mp911de/airgrep/README.md

# airgrep

A portable ADS-B / FLARM receiver. Started as carrier board for a removable ESP32-S3 touch display and ADSBee 1090U receiver, with a soldered MAX-M10S GNSS receiver. It adds a single-cell Li-ion charger, a 5 V boost rail, a fuel gauge, a barometer and a buzzer.

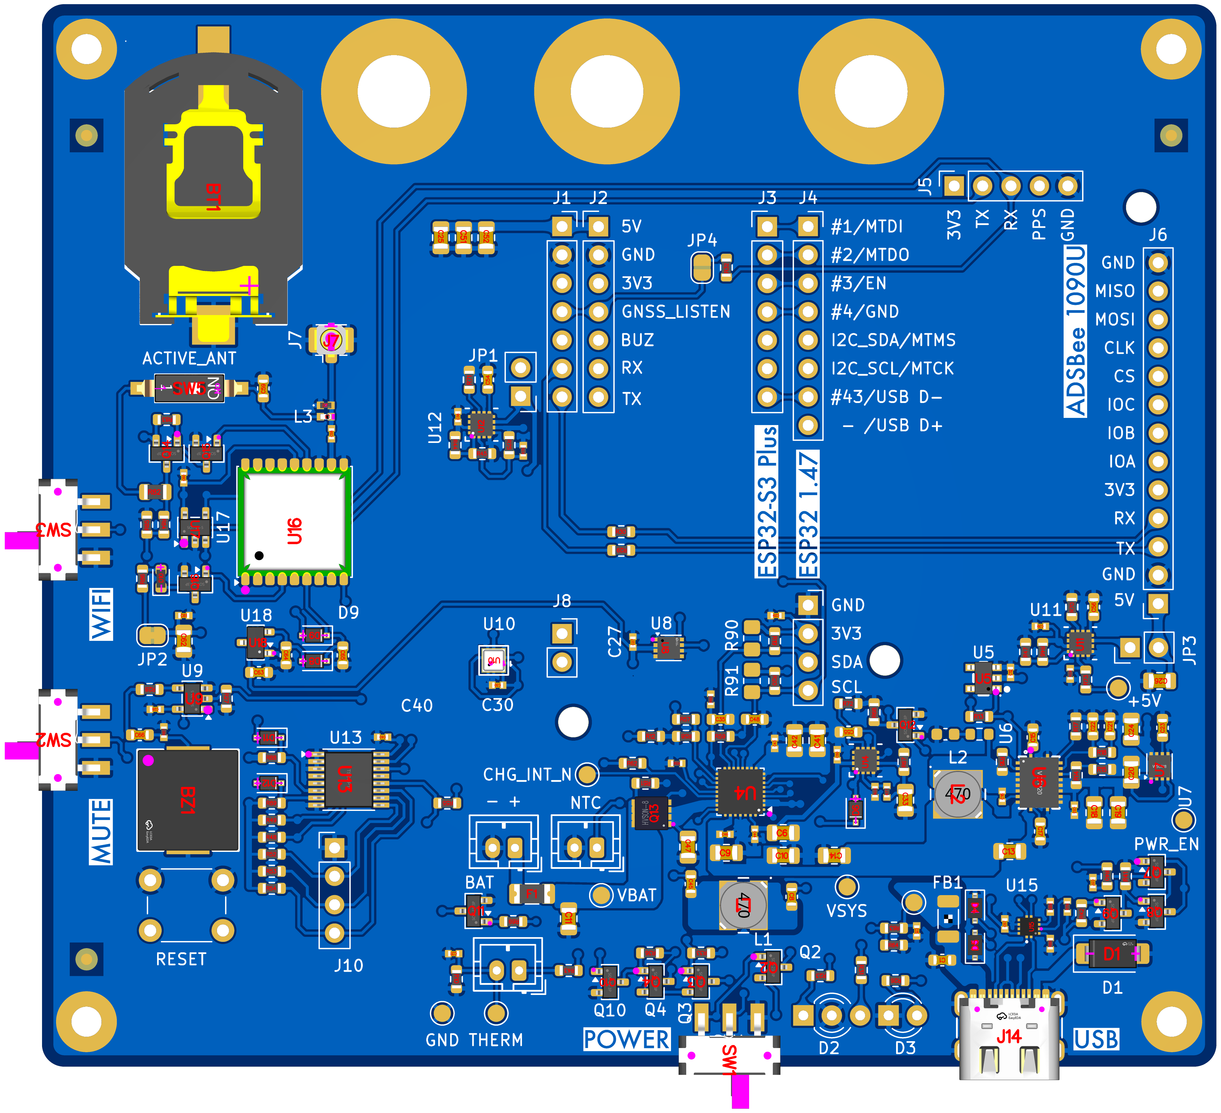
[picture p1: hardware/carrier-ti-charger/render/PCBA Render F.png]
PCBA Render


## Current state

- Schematic (7 sheets) and board (105 x 95 mm, 4 layers, all SMD parts on top) are implemented. The active TI PCB and schematics define the hardware; `tools/check.sh` reports the ERC, DRC and parity state.
- Order status and open work are in [docs/open-issues.md](docs/open-issues.md).

## Where things are

| Path | Content |
|---|---|
| [docs/requirements.md](docs/requirements.md) | What the device must do. Read first. |
| [docs/checklist-draft.md](docs/checklist-draft.md) | Draft hardware review checks, investigation guidance and trial evaluation |
| [docs/specs.md](docs/specs.md) | Technical data: radio, charging, battery, power budget, runtimes and validation limits |
| [docs/decisions.md](docs/decisions.md) | Reasons behind the design decisions |
| [docs/mechanical.md](docs/mechanical.md) | Board outline, mounting holes, module placement, battery, antennas, enclosure |
| [docs/interfaces.md](docs/interfaces.md) | Pin maps of the modules and the carrier connectors |
| [docs/i2c-bus-requirements.md](docs/i2c-bus-requirements.md) | I2C speed, bandwidth, capacitance and pull-up limits |
| [docs/firmware.md](docs/firmware.md) | What the display firmware must do: operating modes, charger host control, charger-mode display, sleep |
| [docs/bom-hand-sourced.md](docs/bom-hand-sourced.md) | Parts to buy and fit by hand, with order links and order status |
| [docs/open-issues.md](docs/open-issues.md) | Open work only |
| [issues/](issues/) | Local issue tracker, one markdown file per issue |
| `specs/power_params.json`, `tools/power_budget.py` | Power model inputs and the script that generates the power, runtime and charging tables in `docs/specs.md` |
| `hardware/carrier-ti-charger/` | Active KiCad 10 project `carrier.kicad_pro`, BQ25798 charger. `lib/` holds symbols, footprints and 3D models, `carrier-schematic.pdf` is the schematic print, `jlcpcb/` holds the production exports. |
| `hardware/carrier-max-charger/` | Frozen MAX77757 reference, no further development. Legacy tools and results remain available with `--project NAME`. |
| `hardware/insulator/` | KiCad project of the insulator board between carrier and battery, generated by `tools/make_insulator.py` |
| `hardware/sim/` | Verification by simulation, see [hardware/sim/README.md](hardware/sim/README.md): charge cut-off (`run_thermal.py`), converters and undervoltage latch (`run_power.py`), board heat (`run_heat.py`), emissions and receiver desense (`run_emi.py`), enclosure vents (`vent_model.py`). Active results use the `ti` suffix or `heat/ti/`; MAX results are historical. |
| `mechanical/` | Placement drawing (`placement.png`, `placement.svg`, generator `draw_placement.py`) and extracted module geometry (JSON) |
| `datasheets/` | Data sheets of the parts in use, see [datasheets/README.md](datasheets/README.md) |
| `sources/` | Manufacturer CAD: display KiCad project (`display.zip`), GNSS and gauge Eagle files, ADSBee reference image and schematic text |
| `tools/` | Scripts: design check (`check.sh`), board queries (`board.py`), net-coloured copper maps (`netmap.py`), power budget, CPL correction for JLCPCB (`fix_cpl.py`), insulator generator |

## Tools

- KiCad 10.0.6, including `kicad-cli` and its bundled Python for the scripts that use `pcbnew`. `tools/kpy` runs that Python.
- Python 3.14; the simulation packages are listed in `hardware/sim/requirements.txt`
- ngspice 47 (Homebrew) for `hardware/sim/`
- `python3 tools/report-holes-vias.py path/to/board.kicad_pcb` reports via copper/drill sizes, minimum nominal annular rings, plated and non-plated footprint drills, slots, counts and nets in mil. Edge.Cuts cutouts are excluded.
- `python3 tools/report-traces.py path/to/board.kicad_pcb` reports straight and arc track widths by layer, with counts and nets in mil. Both reports are read-only, sorted by size, and automatically use `tools/kpy` when needed.
