mp911de/airgrep/datasheets/README.md

# Data sheets

Data sheets for the parts on the carrier and the parts fitted to it by hand. Coverage is not complete; the gaps are listed below. [manifest.json](manifest.json) records source URLs and, where taken, page counts and SHA-256 hashes. Every PDF has a searchable text extraction in [pdf2text/](pdf2text/) under the PDF's name.

| PDF | Part | Source | Host |
|---|---|---|---|
| [max77757.pdf](max77757.pdf) | U4 charger of carrier-max-charger, Rev 2 | [Original](https://www.analog.com/media/en/technical-documentation/data-sheets/MAX77757.pdf) | Manufacturer, browser download |
| [bq25798.pdf](bq25798.pdf) | U4 charger of carrier-ti-charger, SLUSDV2C | [Original](https://www.ti.com/lit/ds/symlink/bq25798.pdf) | Manufacturer |
| [fusb303b.pdf](fusb303b.pdf) | U15 USB Type-C CC controller of carrier-ti-charger, Rev 2 | [Original](https://www.onsemi.com/download/data-sheet/pdf/fusb303b-d.pdf) | Manufacturer |
| [tps61088.pdf](tps61088.pdf) | U6 boost | [Original](https://www.ti.com/lit/ds/symlink/tps61088.pdf) | Manufacturer |
| [tps61023.pdf](tps61023.pdf) | Integrated-disconnect boost candidate, SLVSF14B | [Original](https://www.ti.com/lit/ds/symlink/tps61023.pdf) | Manufacturer |
| [tps61033.pdf](tps61033.pdf) | Rejected integrated-disconnect boost candidate, SLVSGY4B | [Original](https://www.ti.com/lit/ds/symlink/tps61033.pdf) | Manufacturer |
| [tps61033-q1.pdf](tps61033-q1.pdf) | Rejected forced-PWM boost candidate, SLVSH17A | [Original](https://www.ti.com/lit/ds/symlink/tps61033-q1.pdf) | Manufacturer |
| [tps61378-q1.pdf](tps61378-q1.pdf) | Integrated-disconnect boost candidate, SLVSET0E | [Original](https://www.ti.com/lit/ds/symlink/tps61378-q1.pdf) | Manufacturer |
| [tps25947.pdf](tps25947.pdf) | U11/U12/U14 on active TI carrier, TPS259474L | [Original](https://www.ti.com/lit/ds/symlink/tps25947.pdf) | Manufacturer |
| [yageo-rt.pdf](yageo-rt.pdf) | R73 to R78 OVLO dividers, RT0805BRD / RT0402BRD, V.16 | Yageo | LCSC mirror |
| [tps22975.pdf](tps22975.pdf) | U7 load switch | [Original](https://www.ti.com/lit/ds/symlink/tps22975.pdf) | Manufacturer |
| [tlv840.pdf](tlv840.pdf) | U5 supervisor | [Original](https://www.ti.com/lit/ds/symlink/tlv840.pdf) | Manufacturer |
| [max17048.pdf](max17048.pdf) | U8 fuel gauge | [Original](https://www.analog.com/media/en/technical-documentation/data-sheets/MAX17048-MAX17049.pdf) | Adafruit mirror |
| [sn74lvc1g17.pdf](sn74lvc1g17.pdf) | U9 buffer | [Original](https://www.ti.com/lit/ds/symlink/sn74lvc1g17.pdf) | Manufacturer |
| [bst-bmp580-ds004.pdf](bst-bmp580-ds004.pdf) | U10 on active TI carrier, BMP580 C22391138 | Bosch BST-BMP580-DS004-02 | LCSC mirror |
| [bst-bmp581-ds004.pdf](bst-bmp581-ds004.pdf) | U10 on frozen MAX carrier, previous TI part | [Original](https://www.bosch-sensortec.com/media/boschsensortec/downloads/datasheets/bst-bmp581-ds004.pdf) | Manufacturer |
| [ao3401a.pdf](ao3401a.pdf) | Q2, Q3, Q4, Q7 | [Original](https://www.aosmd.com/pdfs/datasheet/AO3401A.pdf) | Manufacturer |
| [2n7002-nexperia.pdf](2n7002-nexperia.pdf) | Q6, Q8, Q9, reference for the JSCJ part | [Original](https://assets.nexperia.com/documents/data-sheet/2N7002.pdf) | Manufacturer |
| [cenker-ckst-series.pdf](cenker-ckst-series.pdf) | L2 | [Manufacturer source](https://www.cenkersz.com/file/upload/products/CKSTPDF.pdf) | LCSC mirror |
| [murata-grm21bz71a226.pdf](murata-grm21bz71a226.pdf) | 22 µF X7R 0805 capacitors | [Product page](https://www.murata.com/en-us/products/productdetail?partno=GRM21BZ71A226ME15%23) | LCSC mirror |
| [cjiang-fxl.pdf](cjiang-fxl.pdf) | L1, FXL0630-1R0-M (page 14) | [LCSC C167216](https://www.lcsc.com/datasheet/C167216.pdf) | LCSC mirror |
| [hongjiacheng-smaj12a.pdf](hongjiacheng-smaj12a.pdf) | D3 TVS, SMAJ12A | [LCSC C19077531](https://www.lcsc.com/datasheet/C19077531.pdf) | LCSC mirror |
| [kingbright-l-115wegw.pdf](kingbright-l-115wegw.pdf) | D4 LED, DSAB9091 V.15A | Kingbright | chipdip.ru mirror |
| [kingbright-l-7104gd.pdf](kingbright-l-7104gd.pdf) | D5 LED, DSAA7649 V.29B | [LCSC C598443](https://www.lcsc.com/datasheet/C598443.pdf) | LCSC mirror |
| [murata-pkmcs0909e4000.pdf](murata-pkmcs0909e4000.pdf) | BZ1 buzzer | [LCSC C910763](https://www.lcsc.com/datasheet/C910763.pdf) | LCSC mirror |
| [jscj-2n7002.pdf](jscj-2n7002.pdf) | Q6, Q8, Q9, JSCJ 2N7002 | [LCSC C8545](https://www.lcsc.com/datasheet/C8545.pdf) | LCSC mirror |
| [murata-blm31kn.pdf](murata-blm31kn.pdf) | FB1, BLM31KN471SZ1L | [LCSC C710518](https://www.lcsc.com/datasheet/C710518.pdf) | LCSC mirror |
| [murata-grm21bz71h475.pdf](murata-grm21bz71h475.pdf) | C1, GRM21BZ71H475KE15L | [Product page](https://www.murata.com/en-us/products/productdetail?partno=GRM21BZ71H475KE15%23) | Manufacturer |
| [taiyo-yuden-emk316bb7226.pdf](taiyo-yuden-emk316bb7226.pdf) | C33, EMK316BB7226ML-T | [LCSC C385906](https://www.lcsc.com/datasheet/C385906.pdf) | LCSC mirror |
| [hanbo-mc107dms.pdf](hanbo-mc107dms.pdf) | J14 USB-C | | |
| [hongjiacheng-h5vld3b.pdf](hongjiacheng-h5vld3b.pdf) | D6 to D9 ESD (CC, D+, D-) | [LCSC C20615805](https://www.lcsc.com/datasheet/C20615805.pdf) | LCSC mirror |
| [littelfuse-466.pdf](littelfuse-466.pdf) | F1 fuse | [Series page](https://www.littelfuse.com/products/fuses-overcurrent-protection/fuses/surface-mount-fuses/thin-film-fuses/466) | Distributor mirror |
| [hro-k3-1280s.pdf](hro-k3-1280s.pdf) | SW1 to SW3, K3-1280S-F1 | HRO drawing, 2013-09-26 | LCSC mirror |
| [tca9534.pdf](tca9534.pdf) | U13, TCA9534PWR | [TI](https://www.ti.com/lit/ds/symlink/tca9534.pdf) | Manufacturer |
| [ck-js-switches.pdf](ck-js-switches.pdf) | superseded switch | C&K JS102011SAQN, retained as historical reference | Distributor mirror |
| [jst-ph-series.pdf](jst-ph-series.pdf) | J11, J12, J13 | [Original](https://www.jst-mfg.com/product/pdf/eng/ePH.pdf) | Manufacturer |
| [samtec-ssq-drawing.pdf](samtec-ssq-drawing.pdf), [footprint](samtec-ssq-footprint.pdf), [catalog](samtec-ssq-catalog.pdf) | Module sockets, alternative part | Samtec SSQ | Manufacturer |
| [samtec-snt-drawing.pdf](samtec-snt-drawing.pdf) | JP1, JP3 shunts, alternative part | Samtec SNT-100 | Manufacturer |
| [variohm-entc-eb.pdf](variohm-entc-eb.pdf) | Pack thermistor | [Series page](https://www.variohm.com/products/temperature-sensors/ntc-thermistor-temperature-sensors/entc-eb-series-) | Distributor mirror |
| [AKKU_SOLD333290_DB-EN.pdf](AKKU_SOLD333290_DB-EN.pdf), [MSDS](AKKU_SOLD333290_SDB-EN.pdf), [UN38.3](AKKU_SOLD_UN38.3-EN.pdf) | Battery 10 Ah | Fullest Energy FE1160100 | reichelt |
| [AKKU_SOLD333288_DB-EN.pdf](AKKU_SOLD333288_DB-EN.pdf) | Battery 5 Ah option | | reichelt |
| [limitor-p8.pdf](limitor-p8.pdf) | Pack thermostat LIM-P-82-60, German | Limitor P series | reichelt |
| [datasheet_adsbee_1090.pdf](datasheet_adsbee_1090.pdf) | ADSBee 1090U module | | |
| [max-m10s.pdf](max-m10s.pdf) | GNSS module, data sheet UBX-20035208 R08 | u-blox | User-supplied |
| [max-m10s-integration.pdf](max-m10s-integration.pdf) | GNSS module, integration manual UBX-20053088 R05 | u-blox | User-supplied |
| [u-blox-m10-interface-spg7.pdf](u-blox-m10-interface-spg7.pdf) | GNSS firmware SPG 7.0x interface description | u-blox | User-supplied |
| [abracon-aane-ap-0164.pdf](abracon-aane-ap-0164.pdf) | GNSS active antenna | [Digi-Key](https://www.digikey.de/de/products/detail/abracon-llc/AANE-AP-0164-1/26813090) | Supplied by Mark |
| [100069905.pdf](100069905.pdf) | Display module | Seeed XIAO 1.47" ESP32-S3 | |
| [FTD-116-FLARM-FAMP-Public-Protocol-v1.02.pdf](FTD-116-FLARM-FAMP-Public-Protocol-v1.02.pdf) | FLARM protocol | Firmware reference | |

## I2C reference additions

| PDF | Role | Source |
|---|---|---|
| [um10204.pdf](um10204.pdf) | Governing I2C standard, Rev 7.0 | User-supplied NXP document |
| [esp32-s3.pdf](esp32-s3.pdf) | Display host, v2.2 | [Espressif](https://www.espressif.com/sites/default/files/documentation/esp32-s3_datasheet_en.pdf) |
| [lsm6ds3.pdf](lsm6ds3.pdf) | Display IMU, DocID026899 Rev 10 | [ST document, Arduino mirror](https://content.arduino.cc/assets/st_imu_lsm6ds3_datasheet.pdf) |

[AXS5106L](axs5106l.pdf), V1.0 dated 2023-03-22, and [CST5106L](cst5106l.pdf), V1.0 dated 2022-11-02, were supplied by Mark. AXS5106L is the controller identified by Seeed; CST5106L is a comparison source, not an established substitute. Sink-current limits and remaining gaps are recorded in [I2C requirements](../docs/i2c-bus-requirements.md#bench-acceptance).

## Notes

- The Variohm series sheet has no R/T table and its ordering list stops at 50 kΩ. The 100K4262 part shares the 4262 K curve.
- The Murata sheet's DC-bias curve is the source of the output-capacitance derating in `hardware/sim/run_power.py`.
- The Hanbo, battery, ADSBee, u-blox, Seeed and FLARM documents have no source URL in the manifest.

## Parts without a data sheet

| Part | Ref |
|---|---|
| Reichelt BL 1X20G8 sockets, SL 1X40G headers and jumpers ([BOM](../docs/bom-hand-sourced.md)); the Samtec SSQ and SNT sheets describe the alternative parts with the same pitch and height | J1, J4-J6, J8-J10, JP1, JP3 |

New data sheets go into this directory, with an entry in the manifest and a text extraction in `pdf2text/`.

## System reset additions

| File | Use | Source |
|---|---|---|
| [csd17575q3.pdf](csd17575q3.pdf) | Q13 ship FET, pinout and recommended land pattern | Texas Instruments |
| [bq2579x-evm.pdf](bq2579x-evm.pdf) | Figure 4-5, Q5 ship-FET reference circuit | Texas Instruments |
| [1n4148ws-jscj.pdf](1n4148ws-jscj.pdf) | D10, D12, D13 1N4148WS, forward drop and reverse leakage | JSCJ, LCSC mirror |
