mp911de/airgrep/sources/pdf2text/adsbee-revd-schematic.txt

PAGE 1
1
2 3 4 5 6 7 8 9 10 11 1
2 3 4 5 6 7 8 9 10 11 A
B
C
D
E
F
G
H
A
B
C
D
E
F
G
H
Date:
2025-06-02 KiCad
E.D.A. 9.0.4 Rev:
010250002 Size:C Id:
1/1 Title:
ADSBee 1090U File:
adsbee_1090u.kicad_sch Sheet:
/ Pants
for Birds John
McNelly - john@pantsforbirds.com PCB:
010250001-D PCBA:
010250002-D 
1
TJ2
Keystone
Pad R2
10R
C35
0.1uF
INHI
2INLO
3PWDN
5VPOS
1 COMM
6VPOS
4 VOUT
8 VSET
7 U4
AD8313xRM
C6
0.1uF PWR_FLAG
PWR_FLAG
+3V3
GND
R12 1k
TP2
TestPoint
C22
0.1uF
L9
7.5nH
C4
0.1uF
L12
6.8nH
C36
1uF
GND
C21
0.1uF
C3
0.1uF
GND
+3V3
GND
R9 100k
V+
5 V-2+
3-
41
U1
MCP6566
R10
1k
+3V3
TP3
TestPoint
R11
1k
R17
10k
C40
3.6pF
L13
7.5nH
GND
D6
ORANGE
R29
750R
D5
GREEN
R28
115R
TP1
TestPoint
C44
3.6pF
GND
D4
RED
GND
R27
287R
L10
27nH
R14
10k
GND
C19
1nF
C11
3pF
GND
C5
0.1uFPWR_FLAG
R13
10k
C16
200pF
GND
2
1
5
X2
TFS1090F
GND
C42
6.2pF
C43
3pF
GND
R3
10k
TP4
TestPoint
+3V3
C41
2.7pF
C39
100pF
GND
D1
3.3VWM
0.6pF +3V3
GND
C17
3pF
R25
10k
R1
10R
R26
10k
1
3
2Q3
20V
700mA GND
1
2
3
4
5
J4
1x5
2.54mm Pin Header F3
6V
200mA R8
10k
1
2
3
4
5
6
7
8
9
10
11
12
13
J5
1x13
2.54mm Pin Header GND
1
3
2Q1
20V
700mA GND
+3V3
+3V3
F4 6V
200mA +5V
JP1
SolderJumper_Open
D3
40V
1A GND
F1
6V
200mA GND
GND
GND
C12
100pF
L1
100nH
1
2
J1
U.FL
6GHz 50R GND
TP5
TestPoint
SHIELD
S1GND
A1VBUS
A4 CC1
A5 CC2
B5 D-
A7 D-
B7 D+
A6 D+
B6 SBU1
A8 SBU2
B8 J2
USB_C_Receptacle_USB2.0_16P
2
Vcc
1 G97
U3
BLB01
GND
GND
C52
0.1uF PWR_FLAG C14
100pF
Shield
1S1
RF
Shield Two Piece 16.5x16.5mm GND
R30
10k GNDPWR
TP6
TestPoint
L4
27nH
GND
GND
2
Vcc
1 G97
U2
BLB01
1
3
2Q2
20V
700mA TP10
TestPoint
GND
GND
R5
0R
C8
100pF
GND
GND
+3V3
L3
82nH
C13
12pF
SW2
SW_Push
GND
C51
0.1uF
R24
10k
PWR_FLAG
+3V3
KITTED
PART PART1
GND
T3
Tab
T2
Tab
T4
Tab
T1
Tab
T5
Tab
T6
Tab
C2
0.1uF R6
6.8k
+3V3
H3
MountingHole
H4
MountingHole
H2
MountingHole
H1
MountingHole
GRAPHIC
GRAPHIC1
PCB1
010250001-D
GND
C9
12pF
PWR_FLAG
C54
10uF
GND
C1
0.1uF +3V3
VI
3GND
1VO
2 U9
AZ1117IH-3.3
GND
+3V3
PWR_FLAG
C53
10uF
+5V
GND
C7
12pF
L2
27nH
R4
6.8k
GND
R7
0R
C15
12pF
C10
100pF
GND
L582nH
RUN
26USB_DP
47USB_DM
46QSPI_SS
56QSPI_SD0
53QSPI_SD1
55QSPI_SD2
54QSPI_SD3
51QSPI_SCLK
52XIN
20XOUT
21SWCLK
24SWD
25TESTEN
19VREG_VOUT
45 DVDD
23 GND
57IOVDD
1 USB_VDD
48 ADC_AVDD
43 VREG_IN
44 GPIO0
2 GPIO1
3 GPIO2
4 GPIO3
5 GPIO4
6 GPIO5
7 GPIO6
8 GPIO7
9 GPIO8
11 GPIO9
12 GPIO10
13 GPIO11
14 GPIO12
15 GPIO13
16 GPIO14
17 GPIO15
18 GPIO16
27 GPIO17
28 GPIO18
29 GPIO19
30 GPIO20
31 GPIO21
32 GPIO22
34 GPIO23
35 GPIO24
36 GPIO25
37 GPIO26_ADC0
38 GPIO27_ADC1
39 GPIO28_ADC2
40 GPIO29_ADC3
41 U6
RP2040
+3V3
+1V1F2 6V
200mA L8
100nH
C30
0.1uF
C38
1uF
C29
0.1uF
C37
1uF
GND
C31
0.1uF
C33
0.1uF
C34
0.1uF
GND
2
1
5
X1
TFS1090F
C32
0.1uF
2
13
TJ1
MM8930-2620
TP9
TestPoint TP8
TestPoint 1
2
4 3
Y1 12.000MHz
C23
0.1uF
C25
0.1uF
C47
15pF
C26
22uF
C24
0.1uF
R19
27.4R +3V3
R18
27.4R +5V
C28
0.1uF
GND
GND
GND
+3V3
+3V3
Mounting
1
2
3
4
5
6
7
8
9
10
11
12
13
14
15
MP
30
29
28
27
26
25
24
23
22
21
20
19
18
17
16
J6
DF40
Header 2x15 P0.4mm C18
3pF
L6
10nH
GND
+3V3
GND
L11
6.8nH
GND
1
2
J3
U.FL
6GHz 50R GNDC20
22uF
DIO_16/JTAG_TDO
26DIO_17/JTAG_TDI
27JTAG_TMSC
24JTAG_TCKC
25~{RESET}
35DIO_1
6DIO_2
7DIO_3
8DIO_4
9DIO_5
10DIO_6
11DIO_7
12DIO_8
14DIO_9
15DIO_10
16DIO_11
17DIO_12
18DIO_13
19X48M_N
46X48M_P
47VDDS
44 VDDS2
13 VDDS3
22 VDDS_DCDC
34 VDDR
45 GND49VDDR_RF
48 DCDC_SW
33 DCOUPL
23 RF_P
1 RF_N
2 RX_TX
3 DIO_14
20 DIO_15
21 DIO_18
28 DIO_19
29 DIO_20
30 DIO_21
31 DIO_22
32 DIO_23
36 DIO_24
37 DIO_25
38 DIO_26
39 DIO_27
40 DIO_28
41 DIO_29
42 DIO_30
43 X32K_Q1
4 X32K_Q2
5 U5
CC1312R1F3RGZ
GND
GND
R23
1k R20
100k
GND
1
2
4 3
Y2 48.000MHz
20ppm GND
GND
Y3
32.768kHz
GND
C49
15pF
C50
15pF
GND
C48
12pF C45
100pF
ESP32-S3-MINI-1
EN
45GPIO15/U0RTS/ADC2_CH4/XTAL_32K_P
19GPIO16/U0CTS/ADC2_CH5/XTAL_32K_N
20MTCK/GPIO39/CLK_OUT3/SUBSPICS1
35MTDO/GPIO40/CLK_OUT2
36MTDI/GPIO41/CLK_OUT1
37MTMS/GPIO42
38GPIO26
26SPIIO4/GPIO33/FSPIHD/SUBSPIHD
28SPIIO5/GPIO34/FSPICS0/SUBSPICS0
29SPIIO6/GPIO35/FSPID/SUBSPID
31SPIIO7/GPIO36/FSPICLK/SUBSPICLK
32SPIDQS/GPIO37/FSPIQ/SUBSPIQ
333V3
3 GND1U0TXD/GPIO43/CLK_OUT1
39 U0RXD/GPIO44/CLK_OUT2
40 GPIO20/U1CTS/ADC2_CH9/CLK_OUT1/USB_D+
24 GPIO19/U1RTS/ADC2_CH8/CLK_OUT2/USB_D-
23 GPIO0/BOOT
4 GPIO1/TOUCH1/ADC1_CH0
5 GPIO2/TOUCH2/ADC1_CH1
6 GPIO3/TOUCH3/ADC1_CH2
7 GPIO4/TOUCH4/ADC1_CH3
8 GPIO5/TOUCH5/ADC1_CH4
9 GPIO6/TOUCH6/ADC1_CH5
10 GPIO7/TOUCH7/ADC1_CH6
11 GPIO8/TOUCH8/ADC1_CH7/SUBSPICS1
12 GPIO9/TOUCH9/ADC1_CH8/FSPIHD/SUBSPIHD
13 GPIO10/TOUCH10/ADC1_CH9/FSPICS0/FSPIIO4/SUBSPICS0
14 GPIO11/TOUCH11/ADC2_CH0/FSPID/FSPIIO5/SUBSPID
15 GPIO12/TOUCH12/ADC2_CH1/FSPICLK/FSPIIO6/SUBSPICLK
16 GPIO13/TOUCH13/ADC2_CH2/FSPIQ/FSPIIO7/SUBSPIQ
17 GPIO14/TOUCH14/ADC2_CH3/FSPIWP/FSPIDQS/SUBSPIWP
18 GPIO17/U1TXD/ADC2_CH6
21 GPIO18/U1RXD/ADC2_CH7/CLK_OUT3
22 GPIO21
25 GPIO38/FSPIWP/SUBSPIWP
34 GPIO45
41 GPIO46
44 GPIO47/SPICLK_P/SUBSPICLK_P_DIFF
27 GPIO48/SPICLK_N/SUBSPICLK_N_DIFF
30 U8
ESP32-S3-MINI-1
GND
+3V3
PWR_FLAG
GND
D2
40V
1A C27
0.1uF
VBUS
GND
GND
R16
5.1k R15
5.1k GND
GND
1
Vcc
4
IO2
3
IO1
2
CR1
DRTR5V0U2SR-7
C46
0.1uF ~{CS}
1CLK
6DI/IO_{0}
5DO/IO_{1}
2~{WP}/IO_{2}
3~{HOLD}/~{RESET}/IO_{3}
7VCC
8 GND4EP
9U7
W25Q128JVPIQ
GND
L7
6.8uH
GNDPWR
GND R22
1k GND
TP7
TestPoint
SW1
SW_Push
PWR_FLAG
R21
10k
SE_50_CP
BAL_D90_C30_CPWG
SE_50_CP
SE_50_CP
SE_50_CP SE_50_CP
SE_50_CPSE_50_CP
SE_50_CPSE_50_CP SE_50_CP
SE_50_CP
SE_50_CP SE_50_CP
BAL_D90_C30_MS
BAL_D90_C30_MS
SE_50_CP
SE_50_CP
BAL_D90_C30_MS
BAL_D90_C30_MS
BAL_D90_C30_CPWG
QSPI_SS
ESP32_USB_D+
SWD
SWCLK
RECOVERED_CLK
AUX_GPIOA
COPRO_SPI_CLK
~{ESP32_CS}
ESP32_ENABLE
COPRO_SPI_MOSI
ESP32_UART0_RX
DEMOD3
DEMOD2
DEMOD0
COPRO_SPI_MOSI
~{SUBG_CS}
COPRO_SPI_CLK
AUX_GPIOC
AUX_GPIOB
~{SUBG_BIAS_TEE_ENABLE}
COPRO_SPI_MISO
JTAG_TMSC
SUBG_LED
JTAG_TCKC
SYNC
SUBG_ENABLE
DEMOD1
PULSES
COPRO_SPI_MOSI
RSSI
~{SUBG_IRQ}
LEVEL_PWM
LEVEL_BIAS
ESP32_USB_D-
ESP32_GPIO0_BOOT
AUX_SPI_CLK
~{SUBG_IRQ}
~{ESP32_CS}
ESP32_UART0_RX
~{1090_BIAS_TEE_ENABLE}
ESP32_GPIO0_BOOT
GNSS_UART_RX
~{AUX_SPI_CS}
COMMS_UART_RX
AUX_SPI_MOSI
COPRO_SPI_MISO
~{SUBG_IRQ}
COPRO_SPI_CLK
QSPI_SD0
JTAG_TMSC
QSPI_SD1
~{ESP32_CS}
AUX_SPI_MISO
SYNC
NETWORK_LED
RF_DET_IN+
JTAG_TCKC
RF_DET_IN-
QSPI_SS
ESP32_USB_D-
ESP32_UART0_TX
GNSS_PPS
ESP32_USB_D+
~{USB_BOOT}
COPRO_SPI_CLK
ESP32_UART0_TX
ESP32_ENABLE
1090_LED
COPRO_SPI_MISO
~{GNSS_ENABLE}
COMMS_UART_TX
SYNC
SWCLK
SWD
~{SUBG_CS}
GNSS_UART_TX
1090_RF_SAW1
RF_DET_IN
USB_D-
USB_D+
1090_RF_LNA2'
DEMOD3
DEMOD1
QSPI_SD0
DEMOD2
RECOVERED_CLK
SUBG_ENABLE
PULSES
DEMOD0
ESP32_ENABLE
ESP32_GPIO0_BOOT
~{USB_BOOT}
1090_RF_SAW2
QSPI_SD1
1090_RF_LNA1
1090_RF_LNA1' ~{RESET}
SUBG_ENABLE
1090_RF_SAW1'
1090_RF_LNA2 ~{1090_BIAS_TEE_ENABLE}
1090_RF_IN
VDD_RF
AUX_GPIOB
AUX_GPIOC
COPRO_SPI_MISO
~{AUX_SPI_CS}
AUX_GPIOA
RSSI
COMMS_UART_TX
COMMS_UART_RX
QSPI_SCLK
1090_RF_SAW2'
QSPI_SD2
AUX_SPI_MOSI
AUX_SPI_CLK
AUX_SPI_MISO
QSPI_SD3
GNSS_UART_RX
GNSS_UART_TX
~{SUBG_BIAS_TEE_ENABLE}
~{GNSS_ENABLE}
SUBG_RF_IN
GNSS_PPS
LEVEL_BIAS
~{SUBG_CS}
SYNC
PULSES
QSPI_SCLK
FAST
QSPI_SD2
QSPI_SD3
1090_LED
SUBG_LED VDD_RF
LEVEL
RF_DET_OUT
LEVEL_PWM
NETWORK_LED
~{RESET}
COPRO_SPI_MOSI
~{RESET}
Startup:
Pull
GPIO0 DOWN to enable download boot
mode for firmware update. GPIO0
Pulled UP by default. Run:
GPIO0
used for SPI handshake connection.
Careful
while using GPIO45-46! GPIO45
used for VDD_SPI voltage control, internally
pulled down to select 3.3V. GPIO46
used for chip boot mode, internally pulled
down to select Joint Download Boot. Use
100k pulldown to allow 50-80k pullup from
RP2040 to just barely exceed CC1312R power-on-reset
voltage of 1.1-1.55V. This allows
use of an external debugger with an open
collector output for ~{RESET}. TL_BIAS
used to pull
LEVEL above noise
floor to assert
LO on PULSES
when no data
is received. TL_BIAS
is adjustable
match the
noise floor. RP2040
UART0 can
be commandeered
to
update ESP32
firmware.
DIO
0-7 can be configured
to trigger
bootloader backdoor.
SYNC
line reused as
bootloader trigger.
5V
IN reverse polarity protection
bypass allows
use of 5V rail for
battery charging. PULSES:
1090MHz power level thresholded
into HI/LO digital waveform.
DEMOD:
Goes HI when preamble detector
finds a packet preamble, LO at
end of packet. RECOVERED_CLK:
Recovered clock waveform
from packet manchester encoding.
Should be a nice even 1MHz
square wave that starts after the
preamble. C_sw
L_sw
Reserved
Pins Strapping:
GPIO0, 3, 45, 46 SPI
Flash: GPIO33-37 USB/JTAG:
19, 20 Iout,max
= 600mA Vin,min
= 3.7V (max dropout voltage) Vin,max
= 6.5V (max input voltage) RF
Signal Comparator (Data Slicer) ESP32-S3
Hardware Design Guidelines https://docs.espressif.com/projects/esp-hardware-design-guidelines/en/latest/esp32s3/schematic-checklist.html
ESP32-S3
Technical Reference Manual https://www.espressif.com/sites/default/files/documentation/esp32-s3_technical_reference_manual_en.pdf
ESP32-S3-MINI
Devkit Schematic https://dl.espressif.com/dl/schematics/SCH_ESP32-S3-DEVKITM-1_V1_20210310A.pdf
GPIO3
sets JTAG signal source, ignore
it for now. ESP32-S3-Mini-1/1U
802.11 and Bluetooth Module 1090MHz
RF Input Signal Chain I_in_max
= 355mA 802.11b,
1 Mbps, @20.5dBm ESP32
USB connection for accessing
internal JTAG controller.
USB
C Connector Note:
1k series resistor is calculated for crystal
ESR = 50Ohms, Crystal is 180Ohms. Bias
Tee: 3.3V 200mA Out BOOT
BUTTON
SAW
1 SAW 2 Pullup
resistor to
increase AD8313
drive strength.
Keep
capacitance on VOUT
low! I_out,max
= 400uA. Pin
34 Pin13 ID
Pins: Pull
down since device is an "Upstream
Facing Port" (UFP). LNA
2 Flash
Memory Bias
Tee: 3.3V 200mA Out Differential
Front-End Configuration
RP2040
Hardware Design Guide: https://datasheets.raspberrypi.com/rp2040/hardware-design-with-rp2040.pdf
RP2040
Datasheet: https://datasheets.raspberrypi.com/rp2040/rp2040-datasheet.pdf
PCB
and Panelization LNA
1 EMI
Shield Cover C_stray=4.5pF
1090MHz
BPF 6MHz
BW -55dB
Attenuation OOB Debug
Connector NOTE:
TX/RX nets refer to pins
on host, not ESP32! TX/RX
swap happens here. SAW
Filter 3.3V
Regulator Ground
Testpoint EMI
Shield Frame Log
Power Detector USB
tracks require Zdiff
= 90R. GNSS_UART:
RP2040
UART0 I_in,max
= 200mA (conservative
guess, heavily dependent on GPIO) RP2040
Microcontroller EMI
and Grounding COMMS_UART:
RP2040
UART1 1uF
near pin 45. RESET
BUTTON
Indicator
LEDs Coprocessor
Debug Connector
Coprocessor
SPI Bus RP2040
SPI1 is Master ESP32
SPI2 is Slave ESP32_GPIO0_BOOT
functions
as handshake
line Pin
44 Pin22 Sub-GHz
Radio 1uF
near pin 44. GNSS
Header GPIOHeader Power
Switch 3.3V
200mA Out Pin
45 L_sw
and C_sw close
to pin 33. Low
inductance ground
for C_sw. Pin
48 GPIO33-37
reserved for SPI
flash, do not use! ESP32
SPI2 in Slave Mode ESP32_GPIO0_BOOT
used as handshake. UART
used for firmware update and logging only. R26
10k
Q3
20V
700mA 13
2F3
6V
200mA R30
10k GNDPWR
GNDU9
AZ1117IH-3.3
VI
3GND
1VO
2 PWR_FLAGC53
10uF
GND
R23
1k GND
C49
15pF
GND
GND
GND
GND
C27
0.1uF
C45
100pF
C48
12pF C50
15pF
Y3
32.768kHz
GND
GND
R20
100k
U5
CC1312R1F3RGZ
DIO_16/JTAG_TDO
26DIO_17/JTAG_TDI
27JTAG_TMSC
24JTAG_TCKC
25~{RESET}
35DIO_1
6DIO_2
7DIO_3
8DIO_4
9DIO_5
10DIO_6
11DIO_7
12DIO_8
14DIO_9
15DIO_10
16DIO_11
17DIO_12
18DIO_13
19X48M_N
46X48M_P
47VDDS
44 VDDS2
13 VDDS3
22 VDDS_DCDC
34 VDDR
45 GND49VDDR_RF
48 DCDC_SW
33 DCOUPL
23 RF_P
1 RF_N
2 RX_TX
3 DIO_14
20 DIO_15
21 DIO_18
28 DIO_19
29 DIO_20
30 DIO_21
31 DIO_22
32 DIO_23
36 DIO_24
37 DIO_25
38 DIO_26
39 DIO_27
40 DIO_28
41 DIO_29
42 DIO_30
43 X32K_Q1
4 X32K_Q2
5 C24
0.1uF
C26
22uF
C25
0.1uF
C23
0.1uF
TJ1
MM8930-2620
2
13
GND
Q2
20V
700mA 13
2GND
C17
3pF
GND
C16
200pF
R13
10k
C19
1nF
GND
R14
10k
R17
10k
PWR_FLAG
C22
0.1uF
C36
1uF
GND
C21
0.1uF
C40
3.6pF
L13
7.5nH
C44 3.6pF
GND
R25
10k
GND
GNDU6
RP2040
RUN
26USB_DP
47USB_DM
46QSPI_SS
56QSPI_SD0
53QSPI_SD1
55QSPI_SD2
54QSPI_SD3
51QSPI_SCLK
52XIN
20XOUT
21SWCLK
24SWD
25TESTEN
19VREG_VOUT
45 DVDD
23 GND
57IOVDD
1 USB_VDD
48 ADC_AVDD
43 VREG_IN
44 GPIO0
2 GPIO1
3 GPIO2
4 GPIO3
5 GPIO4
6 GPIO5
7 GPIO6
8 GPIO7
9 GPIO8
11 GPIO9
12 GPIO10
13 GPIO11
14 GPIO12
15 GPIO13
16 GPIO14
17 GPIO15
18 GPIO16
27 GPIO17
28 GPIO18
29 GPIO19
30 GPIO20
31 GPIO21
32 GPIO22
34 GPIO23
35 GPIO24
36 GPIO25
37 GPIO26_ADC0
38 GPIO27_ADC1
39 GPIO28_ADC2
40 GPIO29_ADC3
41 C38
1uF
C37
1uF
Y1
12.000MHz
1
2
4 3
R19
27.4R R18
27.4R U8
ESP32-S3-MINI-1
EN
45GPIO15/U0RTS/ADC2_CH4/XTAL_32K_P
19GPIO16/U0CTS/ADC2_CH5/XTAL_32K_N
20MTCK/GPIO39/CLK_OUT3/SUBSPICS1
35MTDO/GPIO40/CLK_OUT2
36MTDI/GPIO41/CLK_OUT1
37MTMS/GPIO42
38GPIO26
26SPIIO4/GPIO33/FSPIHD/SUBSPIHD
28SPIIO5/GPIO34/FSPICS0/SUBSPICS0
29SPIIO6/GPIO35/FSPID/SUBSPID
31SPIIO7/GPIO36/FSPICLK/SUBSPICLK
32SPIDQS/GPIO37/FSPIQ/SUBSPIQ
333V3
3 GND1U0TXD/GPIO43/CLK_OUT1
39 U0RXD/GPIO44/CLK_OUT2
40 GPIO20/U1CTS/ADC2_CH9/CLK_OUT1/USB_D+
24 GPIO19/U1RTS/ADC2_CH8/CLK_OUT2/USB_D-
23 GPIO0/BOOT
4 GPIO1/TOUCH1/ADC1_CH0
5 GPIO2/TOUCH2/ADC1_CH1
6 GPIO3/TOUCH3/ADC1_CH2
7 GPIO4/TOUCH4/ADC1_CH3
8 GPIO5/TOUCH5/ADC1_CH4
9 GPIO6/TOUCH6/ADC1_CH5
10 GPIO7/TOUCH7/ADC1_CH6
11 GPIO8/TOUCH8/ADC1_CH7/SUBSPICS1
12 GPIO9/TOUCH9/ADC1_CH8/FSPIHD/SUBSPIHD
13 GPIO10/TOUCH10/ADC1_CH9/FSPICS0/FSPIIO4/SUBSPICS0
14 GPIO11/TOUCH11/ADC2_CH0/FSPID/FSPIIO5/SUBSPID
15 GPIO12/TOUCH12/ADC2_CH1/FSPICLK/FSPIIO6/SUBSPICLK
16 GPIO13/TOUCH13/ADC2_CH2/FSPIQ/FSPIIO7/SUBSPIQ
17 GPIO14/TOUCH14/ADC2_CH3/FSPIWP/FSPIDQS/SUBSPIWP
18 GPIO17/U1TXD/ADC2_CH6
21 GPIO18/U1RXD/ADC2_CH7/CLK_OUT3
22 GPIO21
25 GPIO38/FSPIWP/SUBSPIWP
34 GPIO45
41 GPIO46
44 GPIO47/SPICLK_P/SUBSPICLK_P_DIFF
27 GPIO48/SPICLK_N/SUBSPICLK_N_DIFF
30 +3V3
R16
5.1k R15
5.1k C46
0.1uF GND
TP7
TestPoint
SW1
SW_Push
PWR_FLAG
GND
U7
W25Q128JVPIQ
~{CS}
1CLK
6DI/IO_{0}
5DO/IO_{1}
2~{WP}/IO_{2}
3~{HOLD}/~{RESET}/IO_{3}
7VCC
8 GND4EP
9GND
C10
100pF
C9
12pF
GND
C8
100pF
GND
J2
USB_C_Receptacle_USB2.0_16P
SHIELD
S1GND
A1VBUS
A4 CC1
A5 CC2
B5 D-
A7 D-
B7 D+
A6 D+
B6 SBU1
A8 SBU2
B8 J1
U.FL
6GHz 50R 1
2
L1
100nH
C12
100pF
GND
F1
6V
200mA Q1
20V
700mA 13
2R8
10k
D1
3.3VWM
0.6pF R3
10k
GND
PWR_FLAG
C5
0.1uFGND
R11 1k
R10
1k
U1
MCP6566
V+
5 V-2+
3-
41
R9
100k
GNDGND
C3
0.1uF
C4
0.1uF
GND
PWR_FLAG
C6
0.1uF U4
AD8313xRM
INHI
2INLO
3PWDN
5VPOS
1 COMM
6VPOS
4 VOUT
8 VSET
7 R2
10R
R1
10R
