mp911de/airgrep/hardware/sim/heat/ti/charging_limits.md

# Fast charging against the BQ25798 regulation set point

Generated by `hardware/sim/run_charge_limits.py --write`. [Combined PDF](charging_limits.pdf).

SVGs: [charging_limits_5000](charging_limits_5000.svg), [charging_limits_5000_warm](charging_limits_5000_warm.svg), [charging_limits_10000](charging_limits_10000.svg), [charging_limits_10000_warm](charging_limits_10000_warm.svg), [charging_limits_delay](charging_limits_delay.svg).

## Control and assumptions

Host mode: the ESP32-S3 writes ICHG 1.8 A and the TREG register (60/80/100/120 °C) and pets the watchdog. Default mode: 1 A and TREG 120 °C, what the chip does after power-on or when the watchdog expires. The charger holds the junction at TREG with its analog loop (zero current 2 K above TREG in this model). The nominal pack JEITA stop/restart at 42.6/41.2 °C takes priority. USB keeps supplying the system when charging is reduced.

Other assumptions as in [charging.md](charging.md): fixed 3.7 V cell, USB 5 V / 3 A, 0.8 A system load, selected heatsink, 16 cm² per inlet/outlet group before grille blockage, estimated thermal masses, unrouted copper paths assumed where the board has none yet. No SOC evolution, CV taper, charger timer or battery ageing.

## Nominal 25 °C ambient results

| Pack | Mode | TREG | Peak U4 | Pack stop | Charge added |
|---|---|---|---|---|---|
| 5000 mAh | host | 80 °C | 80.0 °C | 27.5 min | 0.82 Ah |
| 5000 mAh | host | 100 °C | 80.3 °C | 27.5 min | 0.82 Ah |
| 5000 mAh | host | 120 °C | 80.3 °C | 27.5 min | 0.82 Ah |
| 5000 mAh | default | 80 °C | 65.2 °C | 41.4 min | 0.69 Ah |
| 5000 mAh | default | 100 °C | 65.2 °C | 41.4 min | 0.69 Ah |
| 5000 mAh | default | 120 °C | 65.2 °C | 41.4 min | 0.69 Ah |
| 10000 mAh | host | 80 °C | 80.0 °C | 40.8 min | 1.22 Ah |
| 10000 mAh | host | 100 °C | 80.1 °C | 40.8 min | 1.22 Ah |
| 10000 mAh | host | 120 °C | 80.1 °C | 40.8 min | 1.22 Ah |
| 10000 mAh | default | 80 °C | 65.1 °C | 60.4 min | 1.01 Ah |
| 10000 mAh | default | 100 °C | 65.1 °C | 60.4 min | 1.01 Ah |
| 10000 mAh | default | 120 °C | 65.1 °C | 60.4 min | 1.01 Ah |

## Validation

Reduced steady model agrees with its board calibration within 7.82e-14 K. Maximum energy residual 5.49e-12 J per step.

Board SHA256: `db4e8259081b72ccb8899da8cebd6d08041f13eb7b5dc17ae44e5a43e4429bae`. Full inputs, 35 °C results and sensitivity results: [charging_limits.json](charging_limits.json).
