mp911de/airgrep/hardware/sim/heat/max/charging.md

# Charging with battery thermal inertia

Generated by `hardware/sim/run_charge_heat.py --write`. [Four-page PDF](charging.pdf). SVGs: [5 Ah](charging_5000.svg), [10 Ah](charging_10000.svg), [delay sensitivity](charging_delay.svg), [external spreader](charging_spreader.svg).

## Model

Five energy-conserving nodes: U4 junction, local PCB, top heatsink (unused with a bottom plate, which the local PCB node then includes), enclosure surroundings, pack. Thermal resistances and interpolated losses come from seven current points on the current board's high-corner steady-state model. The enclosure node includes air and the thermally participating case, main board and modules; it is not air alone. The pack has its own heat capacity and I²R heating. It heats through finite thermal resistance to the enclosure surroundings.

| Input | Value | Basis |
|---|---|---|
| USB / cell / system load | 5 V, 3 A / fixed 3.7 V / 0.8 A on 5 V rail | Charging while running |
| Ambient / duration | 25 and 35 °C / up to 90 min from uniform ambient | No preheated start |
| Pack dimensions | 73 x 55 x 10.1 mm / 100 x 60 x 11.1 mm | FE105573 / FE1160100 datasheets |
| Pack heat capacity | 80 / 160 J/K | Assumed, no reliable pack mass or specific heat |
| U4 / local PCB / sink / surroundings heat capacity | 0.02 / 3 / 1.5 / 100 J/K | Assumed |
| Pack DC resistance | 90 mΩ for both | Existing high-corner estimate; both specify <=50 mΩ AC |
| Pack surface heat transfer | 7 W/m²K times all six faces | Existing estimate; mounting can obstruct it |
| U4 to local PCB | 7.5 K/W | θJC 7.5 K/W applied from junction to pins (surface not stated for the FC2QFN) |
| Local PCB to surroundings | 36.77 K/W | Reduced from live board thermal network |
| U4 to top sink / sink to surroundings | 55.0 / 58.3 K/W | Existing top/spacer/epoxy estimates |
| Vents | 5 cm² each, 50% free area, 35 mm height | Existing enclosure model |
| JEITA hot / restart | 42.1 / 40.8 °C | Nominal pack NTC thresholds |
| Charger regulation | zero current 20 K above TREG; policies 1.8 A + pack JEITA: 1.8 A, TREG 130 °C; 1.2 A + pack JEITA: 1.2 A, TREG 130 °C; 90-100 °C target + JEITA: 1.8 A, TREG 130 °C, host ramp 90 to 100 °C | MAX77757 data sheet |
| Current response / thermal timestep | Assumed 5 s / 1 s implicit Euler | Numerical estimate, not vendor timing |
| Earliest pack thermostat trip | 55 °C | Curves stop here; reset behaviour not modelled |

The 31.4 °C JEITA warm state lowers termination to 4.05 V, not charge current. At this fixed 3.7 V cell operating point the model remains below that voltage. No state-of-charge curve, constant-voltage taper, ageing or charge-completion prediction. The pack NTC is assumed to track pack temperature exactly; real attachment adds delay. The pack is one average temperature, not a core/surface model. Losses are frozen at the steady calibration points, so cold-start losses can be overestimated. The 35 °C runs use the same loss table. These are scenarios, not guaranteed bounds.

The delay page halves/doubles all heat capacities, and separately adds a 100 K/W PCB-to-pack path for gap/radiation/insulator coupling. These are sensitivity assumptions, not confidence intervals. The spreader page adds a 20 or 10 K/W local PCB-to-outside path. This includes interface, lateral spreading and external heat rejection. No selected product is claimed to achieve either value.

## Results

| Pack | Ambient | Policy | Peak U4 | Peak pack | First charge stop | Charge added | End |
|---|---|---|---|---|---|---|---|
| 5000 mAh | 25 °C | 1.8 A + pack JEITA | 121.9 °C | 50.1 °C | 20.5 min | 0.61 Ah | 90.0 min |
| 5000 mAh | 25 °C | 1.2 A + pack JEITA | 94.8 °C | 49.9 °C | 26.1 min | 0.52 Ah | 90.0 min |
| 5000 mAh | 25 °C | 90-100 °C target + JEITA | 93.6 °C | 49.9 °C | 24.5 min | 0.55 Ah | 90.0 min |
| 5000 mAh | 35 °C | 1.8 A + pack JEITA | 122.6 °C | 55.0 °C | 9.8 min | 0.29 Ah | 40.8 min |
| 5000 mAh | 35 °C | 1.2 A + pack JEITA | 97.5 °C | 55.0 °C | 11.9 min | 0.24 Ah | 44.0 min |
| 5000 mAh | 35 °C | 90-100 °C target + JEITA | 94.2 °C | 55.0 °C | 11.2 min | 0.25 Ah | 43.5 min |
| 10000 mAh | 25 °C | 1.8 A + pack JEITA | 122.1 °C | 49.0 °C | 28.4 min | 0.85 Ah | 90.0 min |
| 10000 mAh | 25 °C | 1.2 A + pack JEITA | 94.5 °C | 48.5 °C | 36.1 min | 0.72 Ah | 90.0 min |
| 10000 mAh | 25 °C | 90-100 °C target + JEITA | 93.5 °C | 48.6 °C | 34.4 min | 0.76 Ah | 90.0 min |
| 10000 mAh | 35 °C | 1.8 A + pack JEITA | 125.0 °C | 55.0 °C | 13.0 min | 0.39 Ah | 59.2 min |
| 10000 mAh | 35 °C | 1.2 A + pack JEITA | 98.7 °C | 55.0 °C | 15.4 min | 0.31 Ah | 63.2 min |
| 10000 mAh | 35 °C | 90-100 °C target + JEITA | 94.2 °C | 55.0 °C | 14.8 min | 0.31 Ah | 62.8 min |

Charging stops before the old sustained-charge steady temperatures occur. At this load, module heat keeps warming the pack after JEITA suspends charging. The larger pack delays this; it does not remove the steady enclosure heat.

## Verification

Reduced steady U4/enclosure temperatures match the seven board-model calibration points within 5.68e-14 K. Maximum per-step energy residual across the main scenarios: 3.66e-12 J. Analytic exponential, energy conservation, JEITA hysteresis and timestep tests are in `test_charge_heat.py`. These establish numerical consistency, not physical accuracy.

Board SHA256: `0680137302e10a352f89cd9ed49d9b0e862f8e9835a293ec1be8e2a76e6120b1`. Input hashes and calibration points are in [charging.json](charging.json).
