mp911de/airgrep/hardware/sim/heat/max/charging_limits.md

# Fast charging with a TMP300 temperature switch

Generated by `hardware/sim/run_charge_limits.py --write`. [Combined PDF](charging_limits.pdf). The original charging graphs are preserved.

SVGs: [charging_limits_5000](charging_limits_5000.svg), [charging_limits_5000_warm](charging_limits_5000_warm.svg), [charging_limits_10000](charging_limits_10000.svg), [charging_limits_10000_warm](charging_limits_10000_warm.svg), [charging_limits_delay](charging_limits_delay.svg), [charging_limits_sensor](charging_limits_sensor.svg), [charging_limits_cycles](charging_limits_cycles.svg).

## Control and assumptions

Full 1.8 A is permitted while cool. A TMP300-like switch disables charging through THM at its trip point, then permits it again at trip minus 5 or 10 °C. The existing nominal pack JEITA stop/restart at 42.1/40.8 °C takes priority. Native U4 foldback at 130 °C remains active. USB keeps supplying the system when charging is disabled. This is a proposed control model, not a circuit or PCB change. Stop/resume operation of MAX77757 through THM still needs a bench check.

The local PCB node is used as the TMP300 sensor location with an assumed 2 s first-order lag. It is not the U4 junction. Exact placement, thermal coupling and sensor delay are unmeasured. The sensor has negligible added heating/capacity in this reduced network. Trip and hysteresis comparisons are evaluated every 0.25 s; turn-off is immediate and current rises with the existing assumed 5 s response when enabled. No separate minimum on/off time is imposed.

Other assumptions are unchanged from [charging.md](charging.md): fixed 3.7 V cell, USB 5 V / 3 A, 0.8 A system load, existing front sink and 5 cm² inlet/outlet, estimated thermal masses. No SOC evolution, CV taper, charger timer, NTC attachment lag, or battery ageing model. Curves end at 55 °C pack, the earliest thermostat trip. All current averaging is for display only; losses and I²R use instantaneous current. A fresh baseline is calibrated from the current board, so old artifacts may reflect a different board revision.

## TMP300B details

[TI datasheet, Rev F](https://www.ti.com/lit/ds/symlink/tmp300.pdf): resistor-programmable trip, 5/10 °C hysteresis, open-drain output. B-grade total trip accuracy is ±6 °C maximum, ±2 °C typical; RSET tolerance adds to this. For all four thresholds, assume a 3.3 V sensor supply. Below 2.35 V the upper measurement limit is 100 × (VS - 0.95) °C, only 85 °C at 1.8 V. VTEMP is high impedance (210 kΩ); reading it requires care not to shift the comparator threshold. JLCPCB stock was not verified.

| Sensor trip | Ideal RSET | 0.1% resistor contribution |
|---|---|---|
| 80 °C | 433.33 kΩ | ±0.13 °C |
| 90 °C | 466.67 kΩ | ±0.14 °C |
| 100 °C | 500.00 kΩ | ±0.15 °C |
| 110 °C | 533.33 kΩ | ±0.16 °C |

## Nominal 25 °C ambient results

Trip values below refer to the sensor, not the charger junction. Cycle periods are between successive charger-temperature interruptions before the battery stops charging. Their median varies with heating, mass and sensor placement. Battery interruptions are not a battery wear metric.

| Pack | Sensor trip | Hysteresis | Peak U4 | Pack stop | Charge added | Charger stops | Median cycle |
|---|---|---|---|---|---|---|---|
| 5000 mAh | no extra cutoff | - | 121.9 °C | 20.5 min | 0.61 Ah | 0 | - |
| 5000 mAh | 80 °C | 5 °C | 91.1 °C | 27.0 min | 0.38 Ah | 24 | 60 s |
| 5000 mAh | 90 °C | 5 °C | 100.6 °C | 24.1 min | 0.48 Ah | 19 | 59 s |
| 5000 mAh | 100 °C | 5 °C | 110.0 °C | 22.1 min | 0.55 Ah | 11 | 78 s |
| 5000 mAh | 110 °C | 5 °C | 119.5 °C | 20.7 min | 0.60 Ah | 2 | 174 s |
| 5000 mAh | 80 °C | 10 °C | 91.1 °C | 27.9 min | 0.34 Ah | 14 | 108 s |
| 5000 mAh | 90 °C | 10 °C | 100.5 °C | 24.6 min | 0.46 Ah | 12 | 98 s |
| 5000 mAh | 100 °C | 10 °C | 110.0 °C | 22.4 min | 0.54 Ah | 8 | 116 s |
| 5000 mAh | 110 °C | 10 °C | 119.5 °C | 20.9 min | 0.59 Ah | 2 | 217 s |
| 10000 mAh | no extra cutoff | - | 122.1 °C | 28.4 min | 0.85 Ah | 0 | - |
| 10000 mAh | 80 °C | 5 °C | 91.1 °C | 37.9 min | 0.52 Ah | 35 | 60 s |
| 10000 mAh | 90 °C | 5 °C | 100.6 °C | 34.0 min | 0.65 Ah | 29 | 60 s |
| 10000 mAh | 100 °C | 5 °C | 110.0 °C | 30.9 min | 0.76 Ah | 17 | 79 s |
| 10000 mAh | 110 °C | 5 °C | 119.5 °C | 28.8 min | 0.83 Ah | 3 | 193 s |
| 10000 mAh | 80 °C | 10 °C | 91.0 °C | 39.2 min | 0.46 Ah | 20 | 109 s |
| 10000 mAh | 90 °C | 10 °C | 100.5 °C | 34.7 min | 0.62 Ah | 18 | 98 s |
| 10000 mAh | 100 °C | 10 °C | 109.9 °C | 31.4 min | 0.73 Ah | 12 | 118 s |
| 10000 mAh | 110 °C | 10 °C | 119.5 °C | 29.0 min | 0.82 Ah | 3 | 239 s |

## Validation

Reduced steady model agrees with its board calibration within 5.68e-14 K. Maximum main-run energy residual is 4.93e-12 J per step. Unit tests cover hysteresis memory, immediate stop, restart, pack precedence, thermal lag, energy conservation and timestep convergence. These are numerical checks, not physical validation.

Board SHA256: `0680137302e10a352f89cd9ed49d9b0e862f8e9835a293ec1be8e2a76e6120b1`. Full inputs, 35 °C results and sensitivity results: [charging_limits.json](charging_limits.json).
