mp911de/airgrep/docs/ic-review/tps259474l.md

# TPS259474LRPWR, U11 / U12 / U14

Connector references below predate the TI board renumbering on 2026-10-18. Use the [reference map](../interfaces.md#connector-reference-history) for the current designators; the frozen MAX board is unchanged.

**WARN. Pin mapping is correct; overvoltage margin, startup/fault transients and local power layout need qualification. No demonstrated pin-assignment error or normal-operation absolute-maximum violation.**

## Evidence and scope

Author: `/root/tps259474l_author`, 2026-10-17. Active TI carrier, working tree at `5d9658f5c3d7ceddcf0f09e5571fe8ef6e53c150`. Read-only schematic/PCB review, native netlist cross-check, pcbnew coordinate/copper queries and independent calculations. These are not prototype measurements.

Primary source [TI SLVSFC9C, May 2026](../../datasheets/tps25947.pdf), also checked against the [current TI PDF](https://www.ti.com/lit/ds/symlink/tps25947.pdf). Printed pages equal PDF pages 1 through 67; mechanical drawings follow the addendum. Sources below use printed pages unless explicitly stated. Reviewed variant selection, pinout, limits, electrical and timing characteristics, fault/ORing behavior, application design and layout recommendations. Unused variants' OVC/AUXOFF behavior is not attributed to this part.

| Input | SHA-256 |
|---|---|
| [PCB](../../hardware/carrier-ti-charger/carrier.kicad_pcb) | `c96b0efee57677eb200708df06589450e7c36d9ce5b5dd90b120ac04c783d326` |
| [Modules schematic](../../hardware/carrier-ti-charger/modules.kicad_sch) | `19196dabd63dd2b4f3fbd2d50d4c287d5050e5ba5aa5b7ced51e2211d63a67c5` |
| [Charger schematic](../../hardware/carrier-ti-charger/charger.kicad_sch) | `9e669150e6cfb9c6ff2340389185cde2838cf55003efe20811e7122b6fb1a0ac` |
| TI PDF | `8f96de389903091650d4f462dcfad3210071c3ae7093623a7978f34baf8a65b4` |

Post-crash refresh by `/root/tps259474l_refresh` reread the live schematic properties and all 30 PCB pin nets after the R77 footprint/MPN and R73-R76 description changes. Hashes above identify that refresh, superseding the prior third-stage baseline. Shared current extraction supplies unchanged connectivity; live source properties take precedence where metadata changed again. [Requirements](../requirements.md), [power description](../power.md), [interfaces](../interfaces.md) and [model inputs](../../specs/power_params.json) establish 5 V USB only, 5.06 V boost, no nuisance OVLO through 5.25 V, 1 A expected total peak and 1.5 A short-term headroom. Input cycling after OVLO is explicitly allowed.

## Ranked findings

| ID | Status | Check and board evidence | Specification, consequence and action |
|---|---|---|---|
| TPS259474L-01 | WARN | U12 allows approximately 5.976 V before static OVLO (nominal 5.680 V); changed U14 allows 5.969 V (nominal 5.748 V). Both feed +ESP_5V_D; these bounds include initial tolerance and TCR, not soldering or endurance drift. | [TI §6.5 p9, §7.3.3 pp26-28](../../datasheets/tps25947.pdf#page=9). The display uses a XIAO ESP32-S3 Plus, whose [manufacturer schematic v1.1, 2026-01-15, p4](https://files.seeedstudio.com/wiki/SeeedStudio-XIAO-ESP32S3/res/XIAO_ESP32S3_Plus_V1.1_SCH_260115.pdf#page=4) places D2 LMBR4010BST5G between VBUS and U3 SGM6029CYG/TR VIN. [SGM6029 Rev.A.1, p3 Recommended Operating Conditions and Absolute Maximum Ratings](https://www.sg-micro.com/rect/assets/3323f5dc-718f-4b81-b820-398ddb702989/SGM6029.pdf#page=3) specify 5.5 V operation and 6 V survival. D2 reduces VIN under load, but its guaranteed minimum forward drop has not been established; it is not a qualified clamp. Thus the protection does not establish a 5.5 V regulator ceiling during a sustained rail fault. The 24 mV difference between 5.976 V and 6 V is a conservative zero-drop comparison, not the actual U3 margin or proof of damage. Reconcile an acceptable display fault-voltage envelope with no-trip through 5.25 V; select tighter threshold protection if a guaranteed ceiling is needed. Merely buying precision resistors does not remove IC threshold tolerance. Measure fault overshoot before claiming downstream protection. The initial/TCR-only 24/31 mV survival comparison also omits permitted resistor soldering/endurance shifts, so it is not a lifetime <6 V guarantee. |
| TPS259474L-02 | WARN | U11/U12 bypass C39/C38 is nominal 100 nF, 4.05/4.58 mm from IC centers. U14 C50 is 2.29 mm away. Output bulk is beyond service shunts; U12 C51/C52 is 21.25/22.57 mm away, U14 much farther. | [TI §8.3.1 pp60-61, §8.4.1 pp62-63](../../datasheets/tps25947.pdf#page=60) recommends close input bypass, close ≥1 µF output bypass and control of interruption-induced spikes. Nominal input value meets 0.1 µF guidance, but effective value and loop inductance are unproven. Provide close ≥1 µF effective OUT-to-GND ceramic bypass in the next layout pass to meet TI guidance; verify its startup impact and measure IN/OUT at the IC during shorts and feed handover, with realistic harnesses. No automatic claim that TVS or Schottky is mandatory. |
| TPS259474L-03 | WARN | All three have zero vias within the 2 × 2 mm body; thin F.Cu necks include 0.305 mm at U11/U12 power pads and 0.203 mm near U14 OUT. R72 is 5.30 mm from U14 and its ILM net uses a via/B.Cu segment. | [TI §6.4 p8, §8.4.1 pp62-63](../../datasheets/tps25947.pdf#page=63). Power pads dissipate heat; TI recommends copper on multiple layers, nearby quiet analog parts and capacity for twice full-load current. No demonstrated overheating at intended loads, but the 41.7 °C/W metric assumes eight under-device vias and cannot be assigned here. Check neck lengths/current density and hot-board temperature at actual branch loads; consider wider/shorter power paths and shorter ILM return if measurements or copper analysis show inadequate margin. Do not add a fictitious ground EP. |
| TPS259474L-04 | WARN | R70/R71/R72 = 1.65 kΩ; C56/C54/C55 = 2.2 nF; ITIMER open on all three. Module input capacitance and powered-load startup are not completely qualified. | [TI §7.3.5 pp29-34, §8.2.2.3 pp44-45](../../datasheets/tps25947.pdf#page=29). Shortest blanking is valid, but minimum threshold is approximately 1.78 A and L faults latch. During startup even this circuit-breaker suffix actively limits current without waiting for ITIMER; sustained current limiting can cause thermal latch-off. Measure startup, Wi-Fi/backlight peaks, both feed handovers, empty/missing battery and hot/cold operation. ITIMER can address identified steady-state transient trips, not bypass the startup current limit. Alter slew only after checking source droop and fault energy. These are qualification gaps, not demonstrated nuisance trips. Typical 2 µs circuit-breaker response is not a guaranteed maximum. |
| TPS259474L-05 | WARN | R73-R76 descriptions now agree with ±1%, ±100 ppm/°C. R77 is now 0402WGF4701TCE / C25900 with matching 0402 footprint. Remaining manufacturer fields are wrong: R73/R75/R77 say Viking Tech; R74/R76 say YAGEO, but their MPNs are UNI-ROYAL. R78 ARG02BTC1241 / C2984409 says YAGEO but is Viking. All six still link datasheets carrying unrelated productCode C2924137 or C281775. | Ratio sensitivity follows [TI §7.3.3 Eq2](../../datasheets/tps25947.pdf#page=27). [UNI-ROYAL SMD-SP-001 V10, 2025-07-28, §§2,6-10 PDF pp2,4-6](https://www.uni-royal.cn/en/images/userfile/file/1753752986c56505e6d9ab55c7.pdf#page=2) verifies the standard MPN family, ±1% and ±100 ppm/°C; [Viking ARG REV.A6, 2022-01-22, printed pp1-3, PDF pp2-4](https://www.viking.com.tw/Templates/att/ARG_Series.pdf?lng=de#page=2) verifies R78 0402, ±0.1%, ±25 ppm/°C. Correct manufacturer and datasheet fields in schematic and PCB without changing values. Preserve distinct R78 precision/TCR and exact LCSC/MPN identity through BOM export. This is metadata inconsistency, not a demonstrated electrical defect. |
| TPS259474L-06 | OK | Previous failing cross-population hysteresis assertion was changed concurrently. Current four `OvervoltageTests` pass; U14 full-drift trip/release bands do not overlap. | [TI §6.5 p9 and §7.3.3](../../datasheets/tps25947.pdf#page=9). U14 highest release 5.447 V is below lowest trip 5.562 V; U11/U12 still have overlapping population bands, which is not negative hysteresis on one part. Preserve no-trip checks and conditional recovery behavior. Add a same-unit check only if changing threshold modeling; no gate needs weakening. This verifies static arithmetic, not overshoot or physical recovery. |

## All pins, actual implementation

Net names below are native board nets. `+5V` is the switched boost rail called RAIL_5V in prose. The reused footprint's LM73100 name is not evidence of incompatibility: pad numbers and geometry were compared with TI Figure 5-1 and package RPW0010A. There are ten pins and no separate exposed ground pad.

| Pin | Function | U11 | U12 | U14 | Status / source |
|---|---|---|---|---|---|
| 1 | EN/UVLO | ADS_ID_EN, R46 1 MΩ to +5V, R47 1 MΩ to GND | ESP_ID_EN, R44/R45 same | ESP_PMID_EN, R67 1 MΩ to CHG_PMID, R68 1 MΩ to GND; Q12 pulls low, D10 clamps during QON reset | OK connection; WARN external leakage/reset low qualification below. [§5 pp5-6, §7.3.2 p26, §7.3.9 p38](../../datasheets/tps25947.pdf#page=5) |
| 2 | OVLO | U11_OVLO, R73 5.6 kΩ / R74 1.5 kΩ divider | U12_OVLO, R75/R76 same | U14_OVLO, R77 4.7 kΩ 1% / R78 1.24 kΩ 0.1% from CHG_PMID | OK normal input no-trip; WARN downstream margin TPS259474L-01. [§6.5 p9, §7.3.3](../../datasheets/tps25947.pdf#page=9) |
| 3 | PG | NC | NC | NC | OK. Unused open-drain output, not AUXOFF on this suffix. [§5, §7.3.11 pp39-40](../../datasheets/tps25947.pdf#page=39) |
| 4 | PGTH | GND | GND | GND | OK. Keeps unused PG deasserted, does not gate OUT. [§7.3.11](../../datasheets/tps25947.pdf#page=39) |
| 5 | IN | +5V, local C39 | +5V, local C38 | CHG_PMID, local C50 and charger bypass C44/C6/C33 | OK normal 5 V range; WARN transient/layout qualification. [§6.1 p7, §6.3 p8, §8.4](../../datasheets/tps25947.pdf#page=8) |
| 6 | OUT | +ADS_5V_D, JP2 then +ADS_5V and J10.1 | +ESP_5V_D, JP1 then +ESP_5V and J7.1 | +ESP_5V_D, common with U12 OUT | OK ORing orientation, WARN local bypass. [§7.3.7 pp35-37, §8.2.4 pp46-48](../../datasheets/tps25947.pdf#page=35) |
| 7 | DVDT | C56 2.2 nF / 50 V to GND | C54 same | C55 same | OK value/rating, WARN measured slew/inrush outstanding. [§6.3 p8, §7.3.5.1 pp29-30](../../datasheets/tps25947.pdf#page=29) |
| 8 | GND | GND | GND | GND | OK electrical mapping; WARN quiet-return/thermal detail. [§5, §8.4.1](../../datasheets/tps25947.pdf#page=63) |
| 9 | ILM | R70 1.65 kΩ to GND | R71 same | R72 same | OK permitted resistance and threshold; WARN layout/load verification. [§6.3, §6.5, §7.3.5.2](../../datasheets/tps25947.pdf#page=30) |
| 10 | ITIMER | NC | NC | NC | OK. Explicitly recommended for shortest circuit-breaker blanking; not mistaken for a forgotten capacitor. [§7.3.5.2 note p31](../../datasheets/tps25947.pdf#page=31) |

## Passives and voltage calculations

| Check | Actual result | Status / evidence |
|---|---|---|
| Current setting | `3334 / 1650 = 2.021 A`. Specified 1.800-2.200 A at nominal R, approximately `1.800/1.01 = 1.782 A` to `2.200/0.99 = 2.222 A` with resistor tolerance. | OK versus 1.5 A total short-term headroom, provided startup does not exceed it. R = 1.65 kΩ lies inside 549-6650 Ω operating range. If the ILM resistors also have ±100 ppm/°C TCR, the full -40 to +125 °C screening range becomes approximately 1.765-2.245 A; the UNI-ROYAL standard family specifies that TCR for the listed 0603WAF1651T5E; the range excludes soldering/endurance shifts. [§6.3/6.5, Eq5](../../datasheets/tps25947.pdf#page=30). See exact resistor ratings below; no precision current-monitor claim follows from this calculation. |
| ILM dissipation | At 2 A and maximum monitor gain 200 µA/A, `VILM ≈ 0.66 V`, `P ≈ 0.264 mW`; at 1.5 A, 0.149 mW. | OK small resistor dissipation. [§6.5 p10, §7.3.6](../../datasheets/tps25947.pdf#page=10). Not a precision current-meter claim. |
| Slew components | `SR ≈ 2000/2200 = 0.909 V/ms`; 5.06 V rise approximately 5.57 ms, excluding delay. 54 µF carrier display bulk gives about 49 mA nominal charging current; module caps/load add to this. | OK nominal design equation. 50 V DVDT capacitors exceed highest intended rail + 5 V. The 54 µF carrier bulk stores about 0.69 mJ at 5.06 V; ideal capacitor charging dissipates the same energy in the pass device, about 0.124 W averaged over the nominal 5.57 ms rise. Powered-module load adds dissipation and can engage current limiting. No series 100 Ω is needed for 2.2 nF; that recommendation starts above 10 nF. WARN exact effective capacitance/timing at temperature is unverified. [§6.3, §6.7, §7.3.5.1](../../datasheets/tps25947.pdf#page=29). |
| OVLO nominal | U11/U12: `1.20 × (1 + 5600/1500) = 5.680 V` trip; `1.09 × same = 5.159 V` release. U14: `1.20 × (1 + 4700/1240) = 5.748 V` trip; `1.09 × same = 5.221 V` release. | OK calculation. [§6.5, Eq2](../../datasheets/tps25947.pdf#page=26). |
| U11/U12 OVLO tolerance | For U11/U12 at 25 °C, ±1% R and ±0.1 µA leakage: trip about 5.512-5.882 V, release 5.013-5.367 V. With independent ±100 ppm/°C over -40 to +125 °C from 25 °C, multiplicative tolerance/drift factors 0.9801 and 1.0201: trip about 5.426-5.976 V, release 4.935-5.453 V. | OK >5.25 V minimum trip. WARN -01 protection margin; recovery by cycling input is allowed. Calculation includes `±Ileak × Rtop`. The population bands overlap; one unit still has at least approximately 0.306 V static hysteresis when using its common resistor ratio and opposing leakage corners. This does not guarantee automatic recovery at 5 V for U11/U12; U14 uses the separate bounds below. [§6.5 p9, requirements power item6](../requirements.md). |
| U14 OVLO tolerance | With R77 ±1% / R78 ±0.1% and ±0.1 µA leakage, 25 °C trip 5.617-5.910 V, release 5.109-5.393 V. Including independent ±100/25 ppm/°C drift over -40 to +125 °C from 25 °C: trip 5.562-5.969 V, release 5.059-5.447 V. Same-unit minimum static hysteresis ≈0.314 V. | OK declared static bounds exceed 5.5 V and remain below 6 V. WARN -01: 31 mV below downstream absolute maximum is not an operating ceiling or transient guarantee. U14 release lower bound exceeds 5 V, so static recovery at exactly 5 V is expected after the sensed rail actually reaches 5 V; input cycling remains valid. At 5.25 V, automatic recovery is not guaranteed. Exact MPN families now support those initial tolerance/TCR bounds; metadata reconciliation remains -05. Soldering and endurance drift are not included in this static range. [TI §6.5 p9, Eq2](../../datasheets/tps25947.pdf#page=9). |
| Divider loading | At 5.25 V, OVLO ≈1.109 V; total dissipation `5.25²/7100 = 3.88 mW`, upper/lower resistor ≈3.06/0.82 mW. Divider current 739 µA, vastly above 20 × 0.1 µA. U14 at 5.25 V: pin 1.096 V, current 884 µA, total 4.64 mW (R77 3.67 mW / R78 0.97 mW); at the model's 5.5 V USB acceptance level: pin 1.148 V and 5.09 mW total, still below declared resistor ratings. | OK intended-rail voltage/current; exact family ratings are checked below; fault/transient qualification remains separate. [§8.2.2.2 p44](../../datasheets/tps25947.pdf#page=44). |
| EN dividers | Nominal EN=VIN/2; at 5.25 V, 2.625 V. ±0.1 µA IC leakage shifts the 500 kΩ Thevenin source by ±50 mV. At 5 V, divider current 2.5 µA exceeds TI's 20× intrinsic-leakage recommendation. | OK intrinsic-IC margin; at nominal resistor values the EN rising input threshold is 2.366-2.446 V plus up to ±0.100 V leakage contribution; internal input UVP also requires 2.44-2.64 V rising. Therefore UVP commonly dominates, but that is not a guaranteed ordering across resistor tolerances. Q12/D10 leakage must also be included for U14. [§6.5 p9, §8.2.2.2](../../datasheets/tps25947.pdf#page=9). |
| Reverse isolation | U12/U14 share OUT, while their IN rails can be absent. At intended 5 V, including the model's 5.5 V USB ceiling, powered OUT with IN=0 remains within `min(23, VIN+20)` recommended OUT range. | OK topology and static voltage. Finite reverse leakage is not zero; dynamic handover is unmeasured. [§6.3, §7.3.7, §8.2.4](../../datasheets/tps25947.pdf#page=35). |
| Conduction heat | At 1.5 A through one branch, `I² × 45 mΩ = 101 mW`; at maximum estimated trip 2.222 A, 222 mW. IC maximum quiescent current adds about 3.2 mW at 5.25 V. | OK low nominal loss. Using no-via JEDEC 74.5 °C/W gives roughly 8 °C rise at 1.5 A as a screening estimate, not the actual PCB thermal resistance. [§6.4/6.5](../../datasheets/tps25947.pdf#page=8). |

Exact resistor family check: R73/R75 0603WAF5601T5E and R70-R72 0603WAF1651T5E are UNI-ROYAL 0603, ±1%, 100 mW at ≤70 °C, 75 V maximum; R74/R76 0402WGF1501TCE and R77 0402WGF4701TCE are 0402, ±1%, 62.5 mW, 50 V maximum. All these values are above 10 Ω, hence ±100 ppm/°C. R78 ARG02BTC1241 decodes as Viking 0402, ±0.1%, ±25 ppm/°C, 62.5 mW, 50 V maximum. The families operate -55 to +155 °C with power derating above 70 °C. At 125 °C, a 62.5 mW part retains approximately 22.1 mW, still above R77's 3.67 mW at 5.25 V or approximately 4.03 mW at 5.5 V. R78 dissipates only approximately 1.06 mW at 5.5 V. Applied voltage is below both family voltage ratings and `sqrt(Pderated × R)`. **OK for intended continuous 5 V operation.** [UNI-ROYAL §§2,6-10, PDF pp2,4-6](https://www.uni-royal.cn/en/images/userfile/file/1753752986c56505e6d9ab55c7.pdf#page=4), [Viking ARG printed pp1-3 / PDF pp2-4](https://www.viking.com.tw/Templates/att/ARG_Series.pdf?lng=de#page=2).

**WARN margin qualification:** these are initial tolerance plus TCR calculations. The UNI-ROYAL family permits additional solder-heat and endurance resistance changes; Viking ARG also specifies solder-heat/endurance shifts. Those qualification-test limits are not predictions of actual board drift, but they prevent calling the 31 mV U14 comparison a certified lifetime survival margin. Preserve the electrical values when correcting metadata; qualify actual post-assembly ratio and lifecycle/fault envelope if protection below 6 V is required. [UNI-ROYAL §10 PDF pp6-7](https://www.uni-royal.cn/en/images/userfile/file/1753752986c56505e6d9ab55c7.pdf#page=6), [Viking ARG Environmental Characteristics PDF p4](https://www.viking.com.tw/Templates/att/ARG_Series.pdf?lng=de#page=4).

C38/C39/C50 are 100 nF, 16 V, CL05B104KO5NNNC, 0402 in the live design, not the 0603 parts stated in one older paragraph of power.md. C24/C25/C26 are 10 µF, 25 V; C51/C52 are 22 µF, 10 V. Their marked voltage ratings suit the intended 5 V rails. Vendor bias curves and lot tolerances were not established, so effective bypass/bulk capacitance is WARN rather than fabricated OK. Fault inputs above their voltage ratings require separate qualification; charger high-voltage capability does not make the entire 5 V board a 24 V product.

## Startup, shutdown and layout qualifications

- **OK:** No MCU is required for normal enable, reverse blocking, OVLO or current protection. Q12 disables the PMID display feed when SW_EN is high. With USB absent its source vanishes; U12 can power the shared display output without intentionally back-powering PMID. U11 independently supplies ADSBee.
- **OK:** Overvoltage recovery is automatic only after OVLO falls below its falling threshold; the L suffix does not latch OVLO itself. Overcurrent/overtemperature reset requires VIN to reach 0 V or EN below VSD, not merely below the UVLO threshold. [TI §7.3.3, §7.3.8/9](../../datasheets/tps25947.pdf#page=38).
- **WARN:** D10's documented ≤0.715 V forward-drop reference is below the 1.076 V minimum falling UVLO threshold and can disable U14 during QON reset. It does not establish EN <0.45 V guaranteed shutdown/reset threshold. Treat QON reset and clearing a latched U14 fault as different operations; verify Q12-low and actual VIN discharge in recovery tests. [TI §6.5 p9, §7.3.9 p38](../../datasheets/tps25947.pdf#page=9).
- **WARN:** R72's longer multilayer ILM route and shared GND deserve quiet-node inspection. TI recommends ILM parasitic capacitance below 50 pF and separation from switching signals; extracted capacitance/coupling is unavailable. This is a verification gap, not a proven oscillation. [TI §8.4.1 p63](../../datasheets/tps25947.pdf#page=63).
- **WARN:** No local output Schottky was found in these feed networks. Its necessity depends on interruption current and loop inductance. OUT must remain above -0.3 V, except the stated <1 µs -0.8 V pulse allowance; measure rather than infer compliance from ERC/DRC. [TI §6.1, §8.3.1](../../datasheets/tps25947.pdf#page=7).

## Verification boundary

The coordinator ran shared schematic, full PCB, cross, EMC, thermal and SPICE analyzers. The successor independently checked `drc.json`: no reported violation names U11/U12/U14 or their listed local passives; unrelated board DRC errors remain and this is not a clean-board verdict. This report uses native files and direct calculations for its claims; heuristic results are not substitutes for datasheet pin mapping. No design change, new simulation, bench power-up, short test, thermography, component DC-bias characterization or complete downstream-module absolute-maximum inventory was performed by this author. Existing model forward-drop high corner is an assumption: TI specifies 16.9 mV typical and 4.7 mV minimum, with no maximum, so its successful transient runs cannot guarantee worst-case rail droop. The live static `ovlo_bounds()` includes resistor tolerance, multiplicative TCR and pin leakage; its four `OvervoltageTests` were rerun successfully by the refresh reviewer. They do not model dynamic OVLO switching or detailed startup/latch timing.

## Review chain

- Author: `/root/tps259474l_author`.
- Independent successor reviewer: `/root/tps259474l_reviewer`, completed 2026-10-17. Independently checked manufacturer pinout/variant/package, electrical limits, fault/startup/ORing behavior, application/layout guidance, native netlist, raw symbol properties, all 30 physical pin nets, pcbnew pad geometry/positions, local vias and DRC records. Recalculated OVLO/leakage/drift corners, same-unit hysteresis, current thresholds, capacitor charging and conduction loss.
- Accepted: all ten pin functions for each reference; no exposed ground pad; OVLO numerical bounds and permitted input cycling; missing close output bypass and thermal-layout recommendations as WARN; metadata mismatch and the then-unresolved population-band test failure, later resolved below.
- Corrected: exact downstream regulator is SGM6029CYG/TR behind XIAO D2, so removed the implication that eFuse output equals regulator VIN. Retained -01 as a fault-voltage margin WARN, not a present 5 V violation or proven damage hazard. Added the source power-path identity and distinguished a protection ceiling from absolute maximum survival.
- Corrected: startup is active current limiting even for TPS259474L; ITIMER only tolerates steady-state overcurrent pulses. Refined multiplicative resistor drift, conditional ILM TCR range and EN/UVP ordering. Confirmed original test failure was an unjustified cross-population expectation, not proof of negative hysteresis on one device; the later test change is reviewed below.
- Verdict: five remaining ranked WARN findings and one resolved OK finding, no substantiated eFuse electrical ERROR. Local transient/load/thermal measurements, exact passive vendor limits and downstream module inventory remain gaps. No design or simulation changes made. The original coordinator-baseline design hashes and TI PDF hash matched at successor completion; the later R77/R78 changes are covered by the subsequent electronics review and post-crash refresh.
- Third distinct electronics reviewer: `/root/tps259474l_engineering`, completed 2026-10-17. All three stages complete; dispositions and concurrent-change refresh below.

## Electronics peer review

Reviewer `/root/tps259474l_engineering` independently read the controlling TI limit, startup, circuit-breaker, OVLO, transient and layout sections; checked the current native divider properties, all three IC pin nets and interacting BQ25798 report; recalculated both divider families. That review's historical source baseline is superseded by the post-crash hashes above. No design edits.

| Suggestion | Disposition | Engineering rationale and practical acceptance |
|---|---|---|
| Tighten downstream fault ceiling (-01) | Conditional | Keep WARN: D2 forward drop depends on current/temperature and is not a guaranteed clamp. Do not blindly lower U14 threshold, since its updated minimum 5.562 V intentionally accepts 5.5 V USB. Define permissible SGM6029 VIN waveform and measure both eFuse OUT and actual regulator VIN at light/full load before selecting protection. Static <6 V is insufficient for a dynamic guarantee. U7 and upstream PMID capacitors need their own fault-envelope checks; U14 cannot protect them. |
| Add local output bypass/Schottky or input TVS (-02) | Corrected | A close ≥1 µF ceramic OUT-to-GND is TI's explicit layout recommendation; the current omission is an actual recommendation deviation, not just absent measurements. Address it in the next layout pass, validating effective capacitance and the extra startup load. Additional 1 µF adds only about 0.91 mA nominal inrush at the existing slew. Schottky/TVS remains conditional on measured interruption spikes, source inductance and energy ratings. Recheck both ORing feed loops and startup after any capacitor change. |
| Widen power paths, add vias, shorten ILM (-03) | Conditional | Preserve correct IN/OUT copper identity; the package has no ground EP. First check actual neck length/current and thermal rise at the branch load. Keep any new thermal vias on their correct power nets, with manufacturing solder-wicking review. Shorten/quiet R72 if rerouting, but do not infer instability from its length alone. Validate current-limit behavior near switching activity. |
| Increase ITIMER or slow DVDT (-04) | Corrected | No arbitrary value change. [TI §7.3.5.3, Figure 7-10 note 3 p33](../../datasheets/tps25947.pdf#page=33) explicitly applies active current limiting at startup to circuit-breaker variants too; ITIMER is bypassed then. Longer ITIMER helps only a demonstrated steady-state pulse and increases fault energy. Slower DVDT reduces capacitive inrush but can increase powered-load linear dissipation; verify full load ramp, source droop and latch behavior before changing either. Preserve short-circuit response. |
| Reconcile resistor sourcing metadata (-05) | Accepted, refreshed | R73-R76 descriptions were corrected concurrently; R77 is now the correct 0402 MPN/footprint. Correct the remaining wrong manufacturer fields and stale datasheet associations against the primary sources in -05; preserve R78 precision/TCR. Do not accidentally substitute a 1% 1.24 kΩ lower resistor: full drift can consume the intended USB threshold window. Vendor confirmation must include temperature range and TCR reference temperature, rather than treating fields as certified measurements. |
| Replace population hysteresis assertion (-06) | Corrected, resolved | Concurrent change already replaced the stale failing assertion. Independently ran `PYTHONDONTWRITEBYTECODE=1 python3 -m unittest test_power.OvervoltageTests` from `hardware/sim`: all four pass. Their U14 band-separation assertion is now numerically true; it is not a general datasheet requirement. Do not transfer that assertion to U11/U12. No simulation files changed by this reviewer. |
| EN/reset leakage and latch clearing | Accepted | Preserve D10's low-leakage purpose; a Schottky substitution may harm QON high margin. QON reset disable and eFuse fault-latch reset are separate. Verify actual EN below 0.45 V or VIN fully discharged when claiming latch clearing; characterize module rail reset separately. See BQ25798-04 for host configuration needed for ship-FET reset. |
| Treat capacitance/thermal estimates as acceptance | Rejected | Nominal 49 mA carrier-capacitor inrush and JEDEC temperature estimates are screening calculations only. Effective capacitance, module dynamic load, soldering/copper and fault dissipation remain unmeasured. Passing static threshold tests or DRC cannot establish these. |

Current `drc-current.json` was checked as the refreshed layout baseline; no violation entry names U11/U12/U14 or R70-R78. This does not establish a clean board. No electrical ERROR was substantiated for these three eFuses. Five ranked WARNs remain, concerning real recommendations, qualified margins and missing vendor/bench proof; one historical test finding is resolved. Physical thermal, fault-overshoot, reset and startup acceptance remain open.

## Post-crash current-source refresh

Additional distinct electronics reviewer: `/root/tps259474l_refresh`, 2026-10-17. The original author, successor and electronics peer review remain historical completed stages. This refresh independently checked all 30 live physical pin nets with `tools/board.py`, raw local resistor/capacitor properties, TI pin/limit/fault/layout sections, current divider-model code and the manufacturer resistor-family documents. No design, simulation or test edits.

| Earlier claim or suggestion | Refresh disposition |
|---|---|
| R77 obsolete MPN/package claim; R73-R76 description conflict | Corrected. R77 is 0402WGF4701TCE/C25900 in a matching 0402 footprint; R73-R76 descriptions now agree with tolerance/TCR fields. No electrical threshold change from the footprint correction. |
| Passive tolerance/TCR entirely unverified | Corrected. Exact UNI-ROYAL and Viking numbering/rating tables support the initial bounds. Wrong manufacturer fields and unrelated datasheet product associations remain -05 WARN. |
| Static OVLO bands protect below 6 V indefinitely | Rejected as a guarantee. Current arithmetic matches 5.426-5.976 V rail and 5.562-5.969 V USB trip bands, but those omit soldering/endurance drift and dynamic overshoot. Keep -01 WARN and qualify the downstream fault envelope. |
| Add local effective ≥1 µF OUT bypass | Accepted recommendation deviation, -02 WARN. Added capacitance is small versus present bulk but requires startup/handover recheck. Schottky/TVS remains measurement-dependent. |
| Change ILM, ITIMER, DVDT or add power-pad vias | Conditional, unchanged. No new evidence justifies arbitrary values or compulsory vias; preserve current-limit/fault response and verify actual loading, copper loss and thermals. |
| Existing static threshold tests | Four `OvervoltageTests` pass on live code. This is arithmetic regression proof only. Current DRC has six active / 57 excluded violations, zero unconnected items and zero parity entries; no listed violation names U11/U12/U14 or R70-R78. |

Final refresh result: **five ranked WARN, zero ERROR**. Local bypass/layout deviations, downstream fault margin, startup/transient behavior and source metadata remain open. Pin mapping and initial static divider arithmetic remain correct. No physical or lifetime acceptance is claimed.

## Independent peer review of late changes

Reviewer `/root/late_changes_peer_review`, 2026-10-17, independently checked TI electrical limits, the final native DRC, live divider properties and the revised BQ25798/FUSB303B actions. PCB, modules and charger hashes match the refreshed basis above. No design or simulation edits.

| Revised suggestion | Disposition and engineering basis |
|---|---|
| R77/R78 values and package metadata | Accepted. Recalculation from TI's 1.183-1.223 V trip and 1.076-1.116 V recovery thresholds, ±0.1 µA leakage, stated initial tolerance and multiplicative 100/25 ppm/°C drift gives U14 5.5619-5.9688 V trip and 5.0588-5.4466 V recovery. At 5.5 V, R77/R78 dissipate 4.03/1.06 mW. Preserve the precision lower resistor and correct metadata only. [TI §6.5 p9, Eq2 p27](../../datasheets/tps25947.pdf#page=9); manufacturer-family sources above. |
| -01 downstream protection | Conditional, WARN retained. Static thresholds do not establish a 5.5 V operating clamp or lifetime <6 V survival; resistor qualification shifts and dynamic overshoot remain. No arbitrary lower setpoint is justified while preserving the intentional 5.5 V acceptance requirement. Measure actual regulator VIN as well as eFuse OUT before redesign. |
| -02 through -04 layout/startup changes | Accepted as recommendations or measurement gates already stated. No new evidence warrants arbitrary ILM, ITIMER or DVDT values, compulsory power-pad vias, or a guessed TVS. Keep close effective ≥1 µF output bypass on the next layout pass and verify its added startup load. Ground and power copper remain distinct. [TI layout pp62-63](../../datasheets/tps25947.pdf#page=62). |
| BQ/FUSB current-policy interaction | Accepted. U14 controls the direct PMID display branch; it neither limits the entire USB connector current nor protects U15 VBUS_DET. Keep connector-total qualification and independently controllable startup loads in the BQ/FUSB actions. |

Current result remains **zero ERROR, five WARN**. The current gate contains six active board-wide errors, none naming these eFuses or their divider components; passing static arithmetic does not resolve the remaining transient, assembly or physical proof gaps.
