mp911de/airgrep/hardware/carrier-ti-charger/render/PCB Render F.png

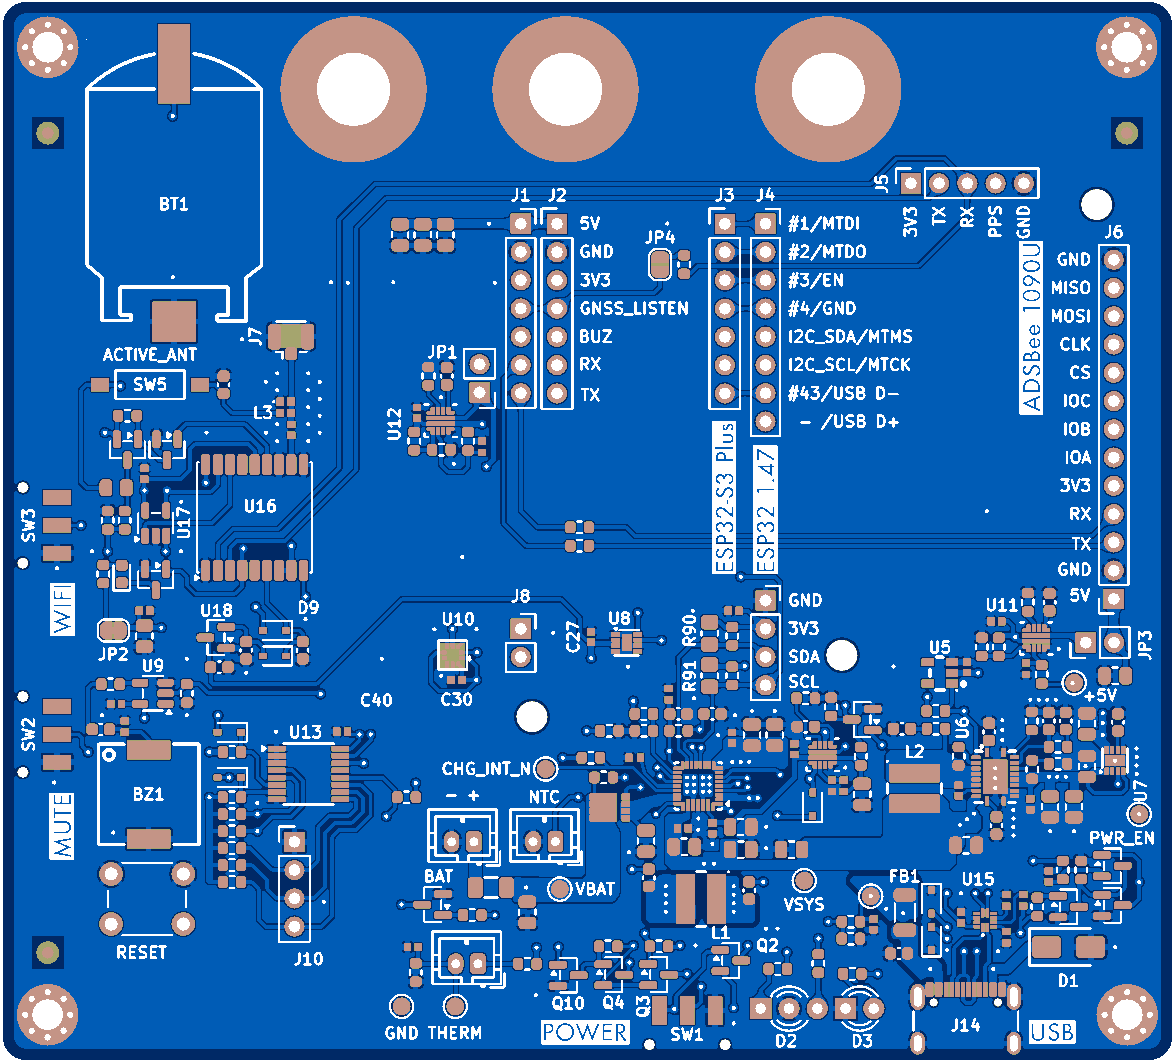
hardware/carrier-ti-charger/render/PCB Render F.png
