mp911de/airgrep/hardware/carrier-ti-charger/render/SMT placement.png

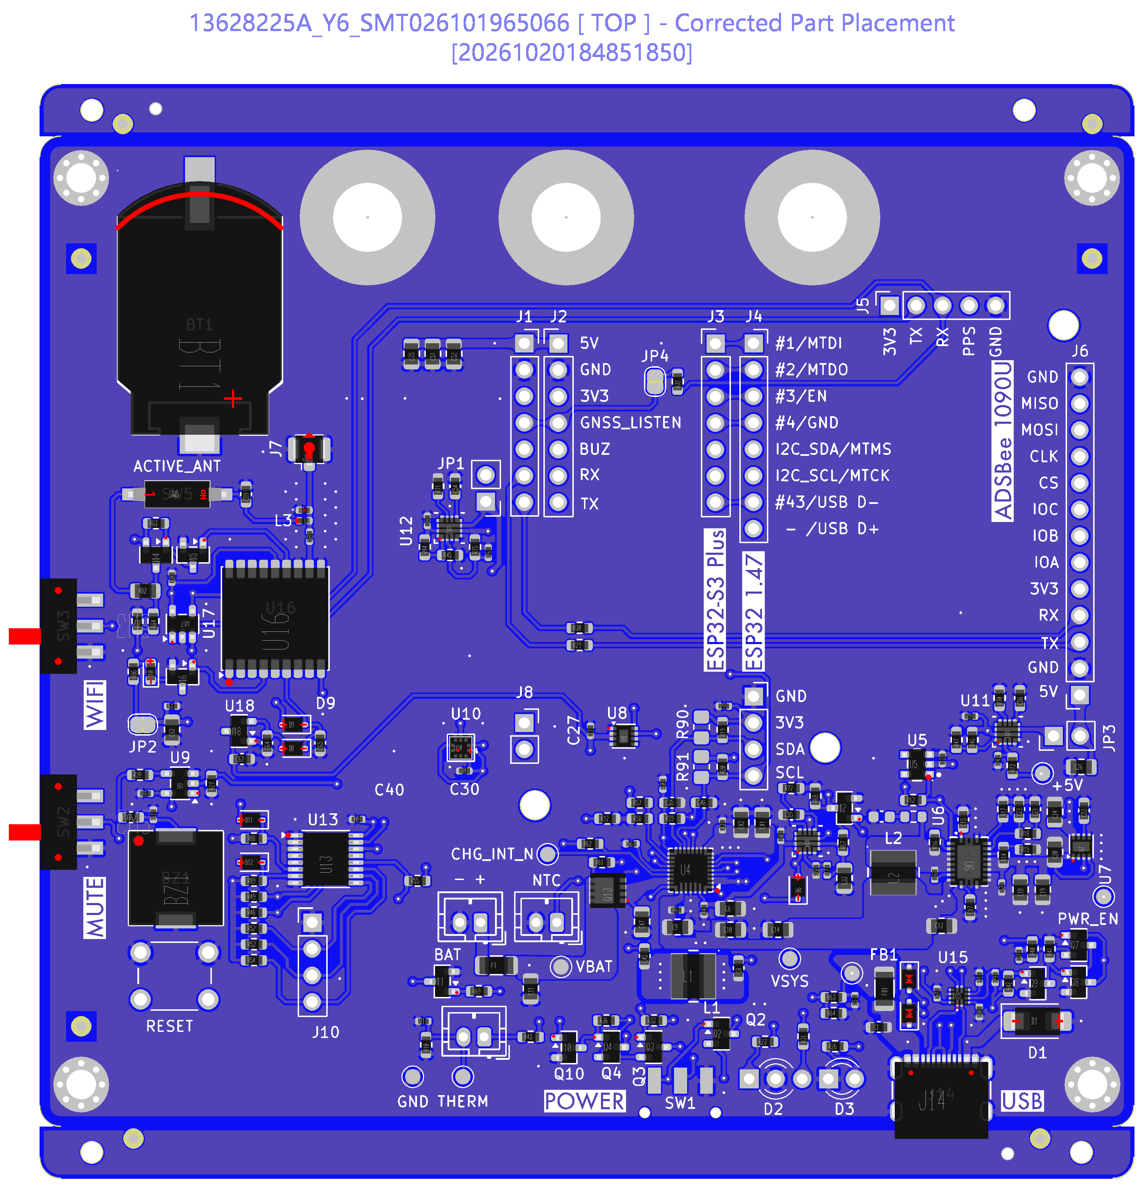
hardware/carrier-ti-charger/render/SMT placement.png
