mp911de/airgrep/hardware/kicad/carrier-bottom.png

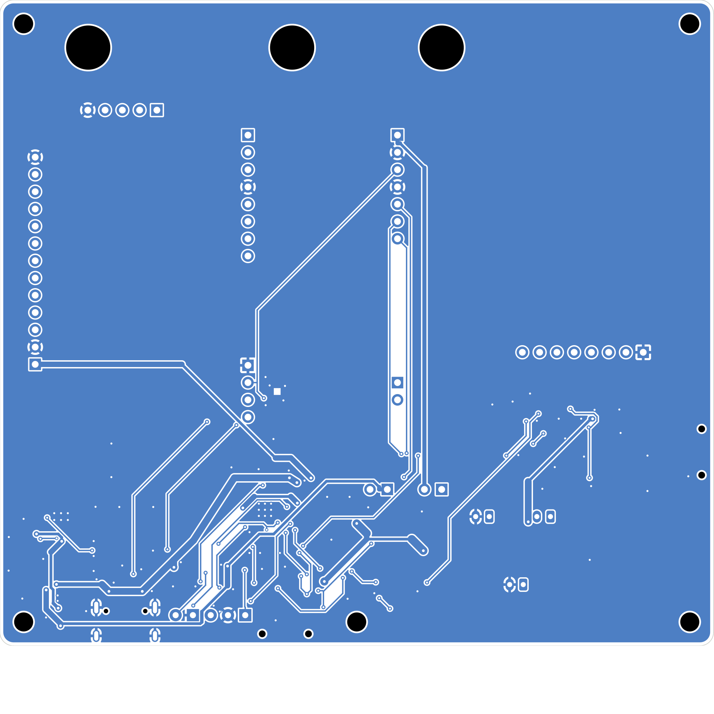
hardware/kicad/carrier-bottom.png
