mp911de/airgrep/hardware/kicad/carrier-silkscreen.png

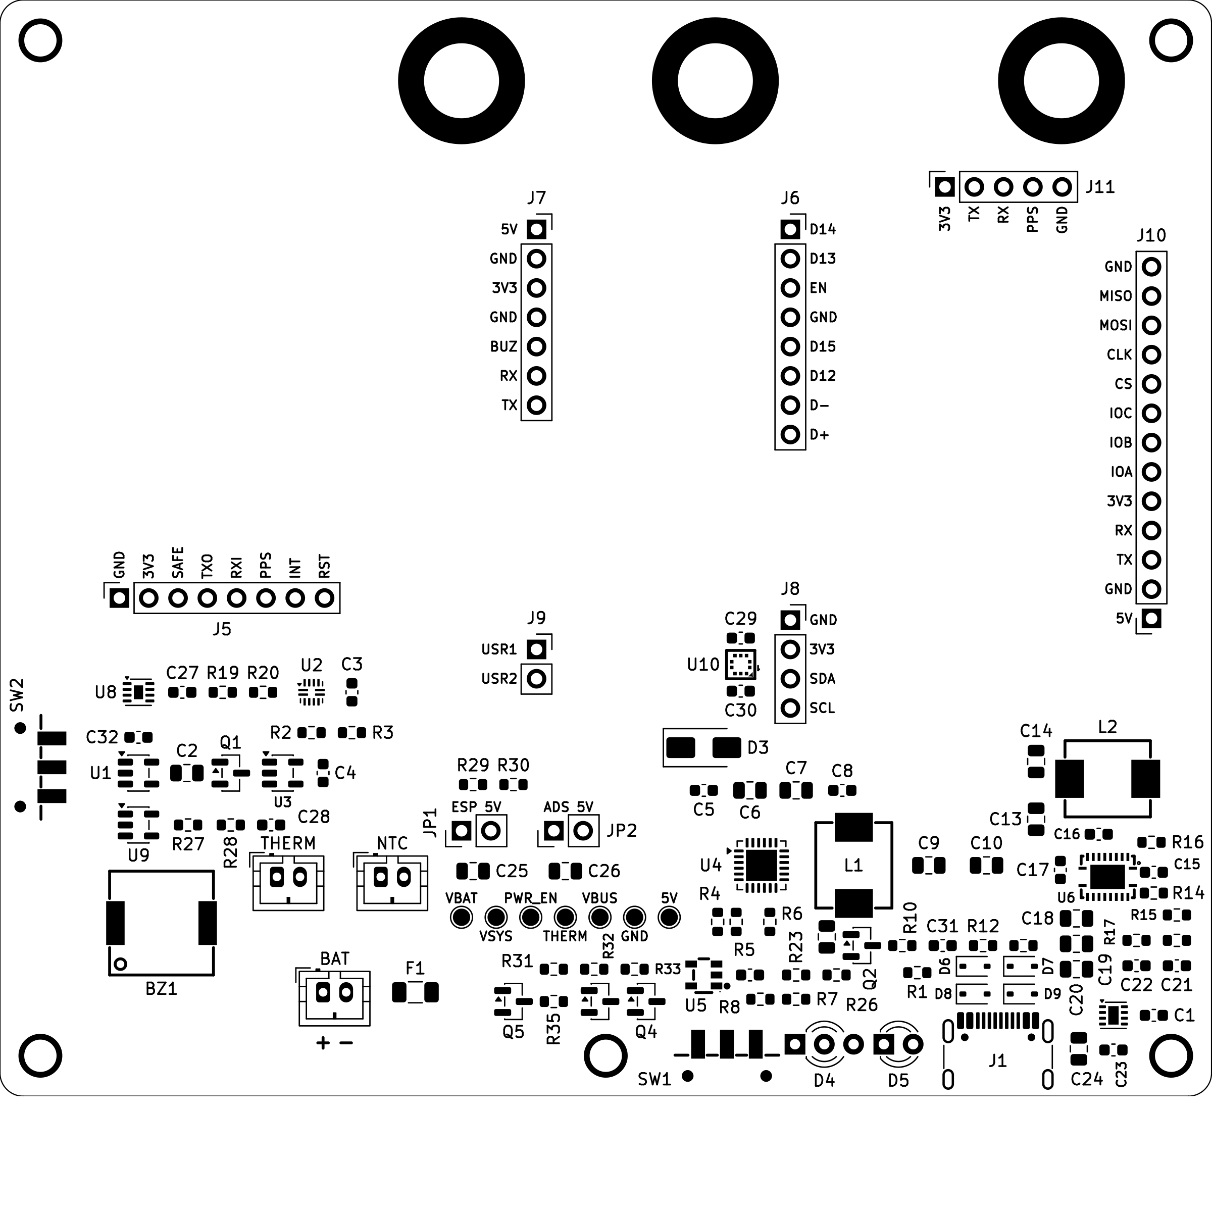
hardware/kicad/carrier-silkscreen.png
