mp911de/airgrep/hardware/kicad/carrier-top.png

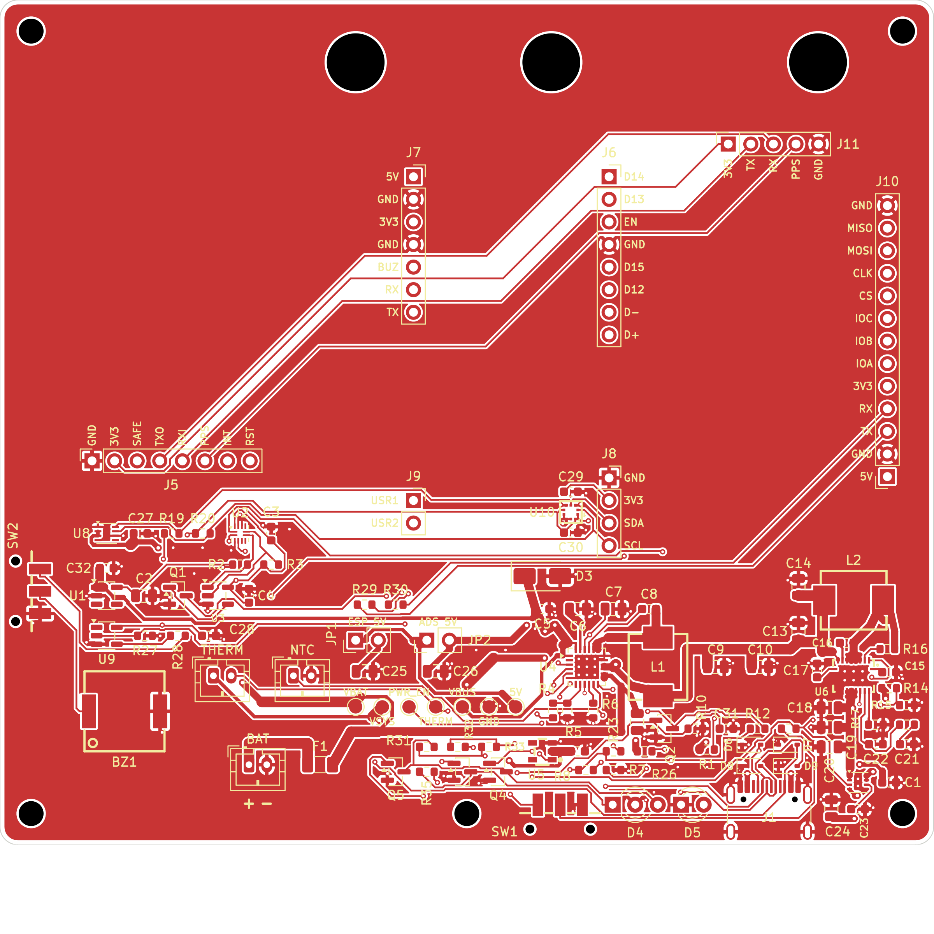
hardware/kicad/carrier-top.png
