mp911de/airgrep/hardware/kicad/carrier_2d_view.png

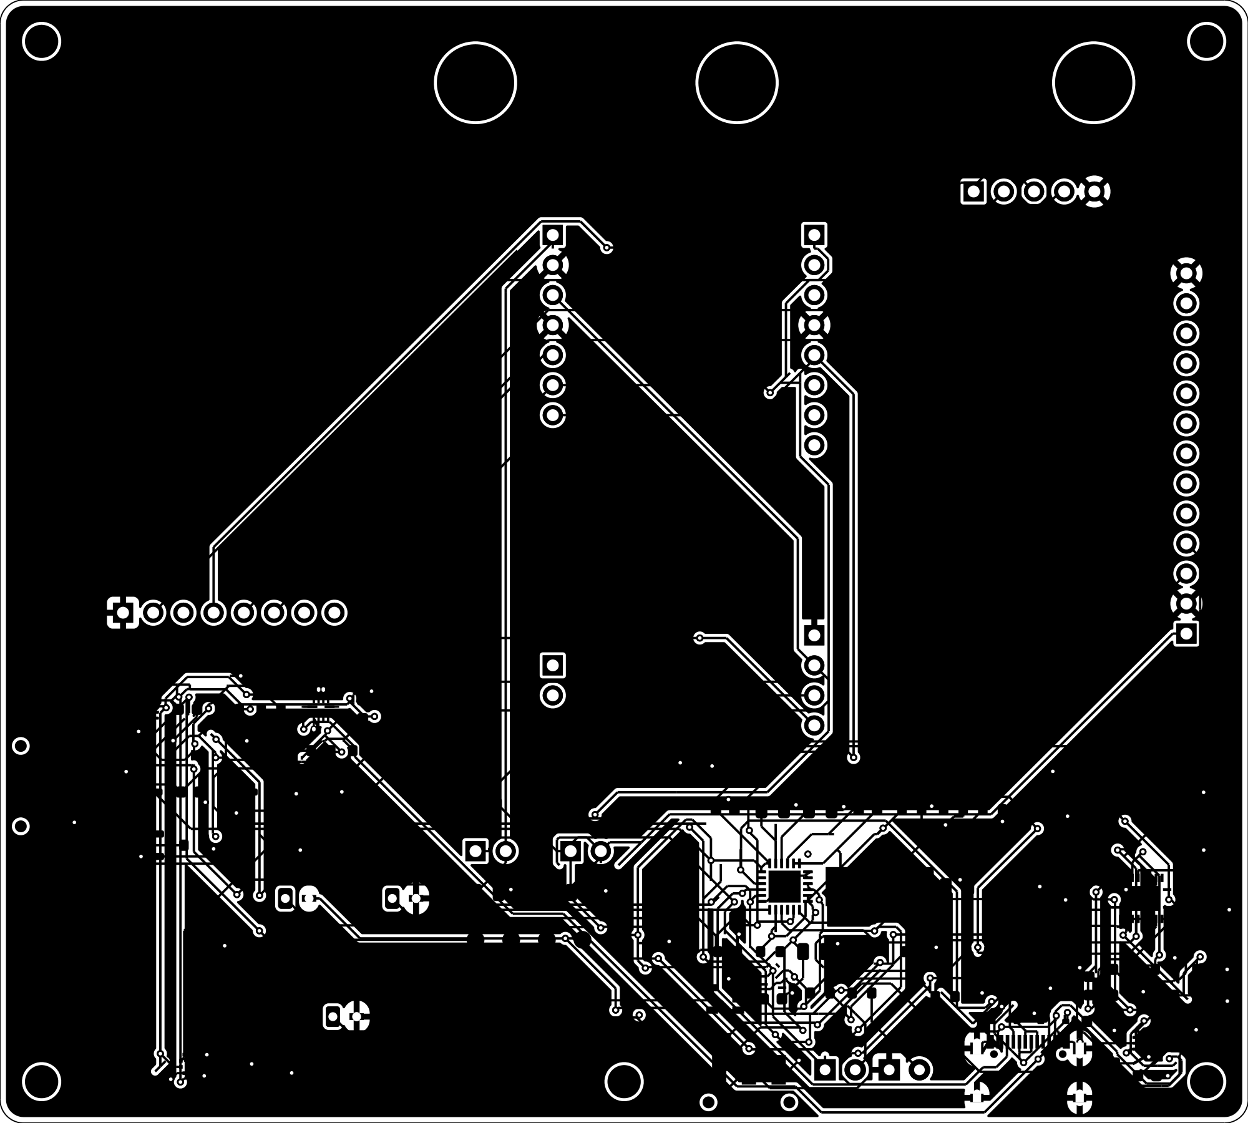
hardware/kicad/carrier_2d_view.png
