mp911de/airgrep/mechanical/placement-A.png

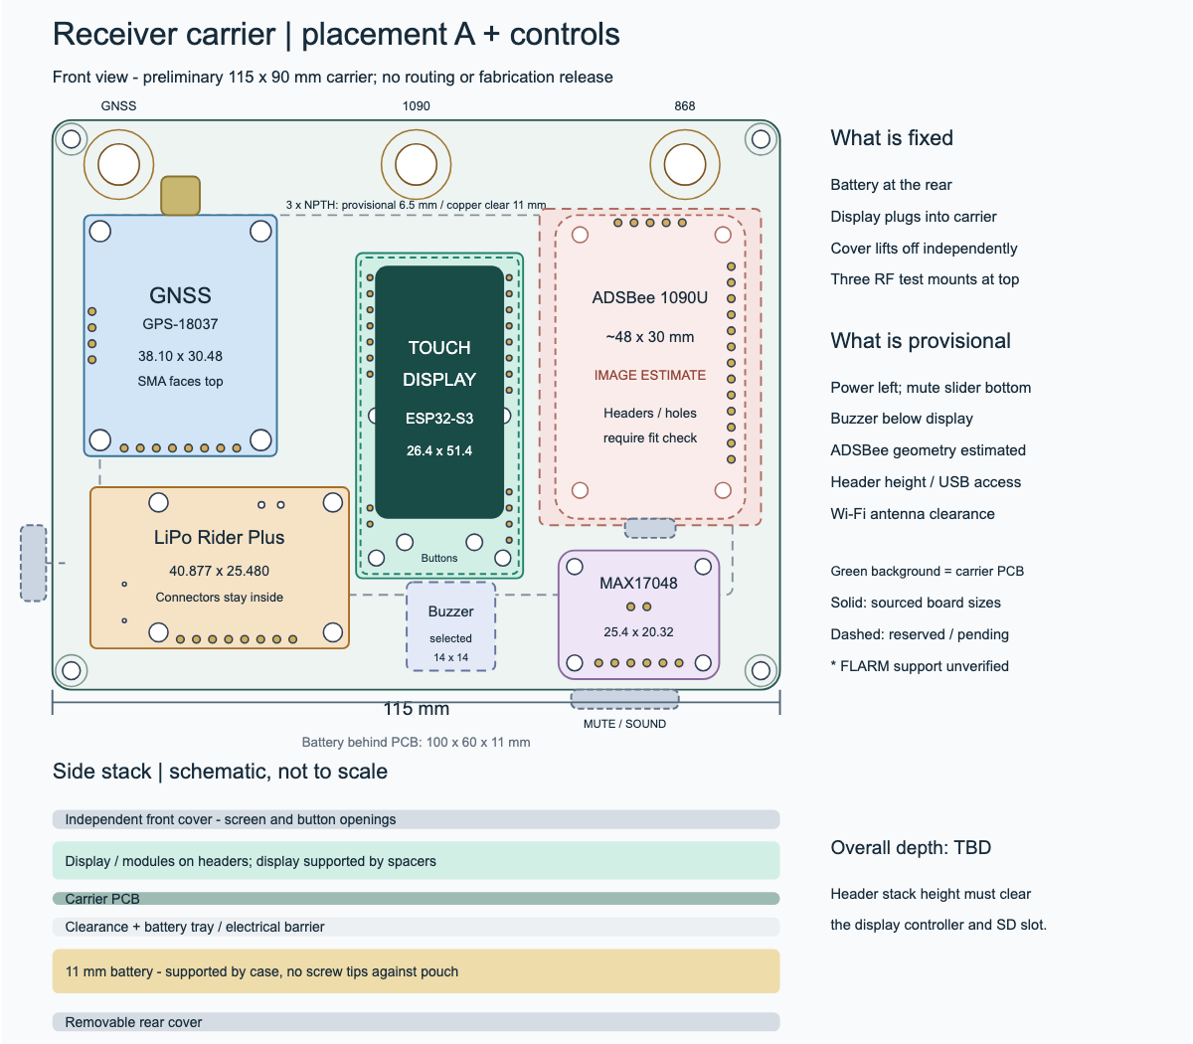
mechanical/placement-A.png
