mp911de/airgrep/mechanical/placement-B.png

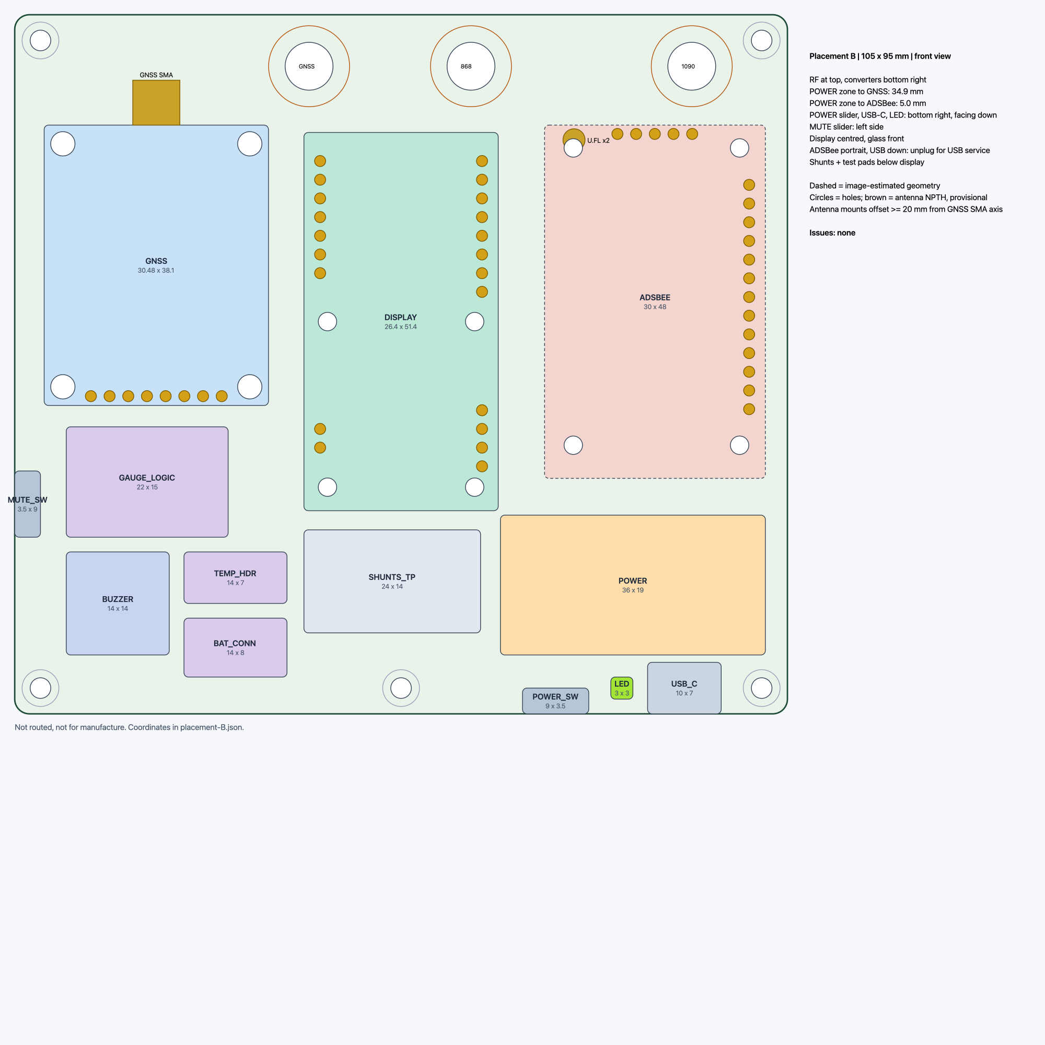
mechanical/placement-B.png
