mp911de/airgrep/sources/adsbee-two-sided-reference.png

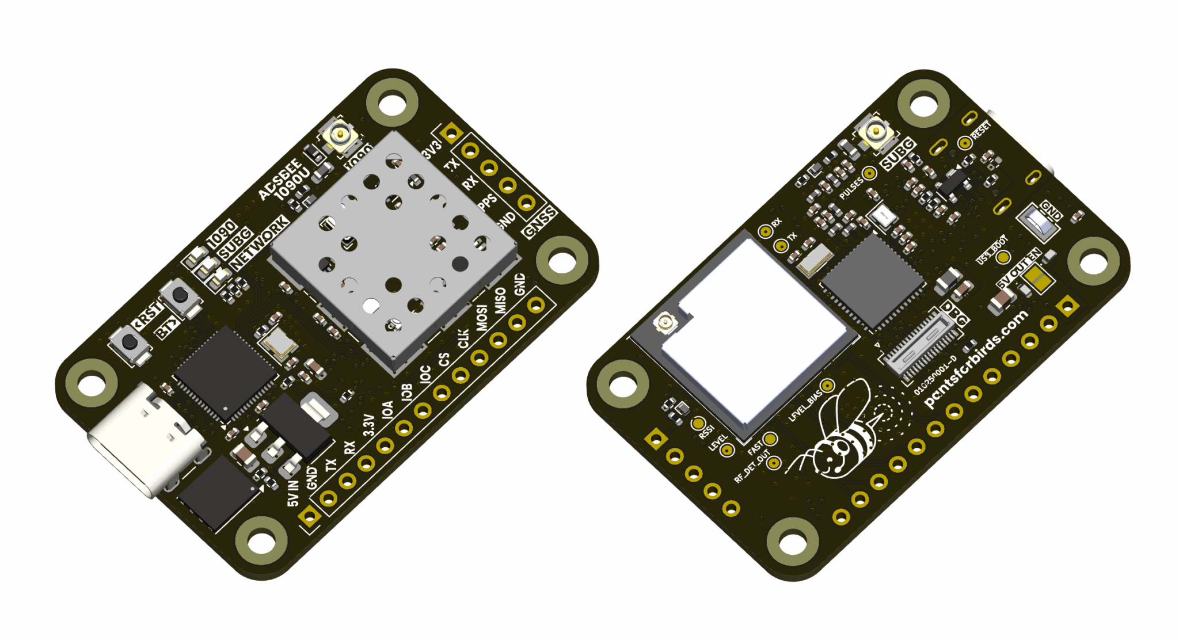
sources/adsbee-two-sided-reference.png
