mp911de/airgrep/hardware/carrier-ti-charger/jlcpcb/production_files/BOM-carrier.csv

Comment | Designator | Footprint | LCSC | Quantity
1.24k 0.1% | R78 | R_0402_1005Metric_NoSilk | C2984409 | 1
1.5k | R19,R20 | R_0603_1608Metric | C22843 | 2
1.5k 1% | R74,R76,R79 | R_0402_1005Metric_NoSilk | C25867 | 3
1.8k | R70,R71,R72 | R_0603_1608Metric | C4177 | 3
10 Ω 1% 0805 | R82 | R_0805_2012Metric_NoSilk | C17415 | 1
100k 1% | R12,R13,R27,R36,R41,R48,R49,R52,R53,R54,R55,R58,R62,R64,R69,R83,R85,R88,R89 | R_0603_1608Metric | C25803 | 19
100n 16V | C12,C16,C27,C28,C29,C30,C31,C37,C38,C39,C40,C43,C44,C46,C5,C50,C53,C57,C60,C61 | C_0402_1005Metric_NoSilk | C1525 | 20
100p | C22 | C_0603_1608Metric | C14858 | 1
10k | R87 | R_0402_1005Metric_NoSilk | C25744 | 1
10k | R40 | R_0603_1608Metric | C25804 | 1
10n | C21,C23,C35,C59 | C_0603_1608Metric | C57112 | 4
10u 25V X7R | C11,C24,C25,C26,C41,C42,C6,C62 | C_0805_2012Metric | C3039694 | 8
120k 1% | R57 | R_0603_1608Metric | C25808 | 1
150R | R61,R86 | R_0603_1608Metric | C22808 | 2
160k | R17 | R_0603_1608Metric | C22813 | 1
1M | R10,R42,R44,R45,R46,R47,R67,R68 | R_0603_1608Metric | C22935 | 8
1N4148WS | D11,D12,D6,D8,D9 | D_SOD-323 | C2128 | 5
1k | R28,R29,R30,R32,R43 | R_0603_1608Metric | C21190 | 5
1u | C63,C64,C65,C66 | C_0603_1608Metric | C15849 | 4
2.2n 50V | C54,C55,C56 | C_0603_1608Metric | C1604 | 3
2.2uH FC-ALX4030D-2R2MT | L1,L2 | IND-SMD_L4.2-W4.2_FC-ALX4030D | C5370906 | 2
220k | R16 | R_0603_1608Metric | C22961 | 1
22u 10V X7R | C10,C13,C14,C18,C19,C20,C33,C47,C51,C52,C9 | C_0805_2012Metric | C907991 | 11
240k 1% | R14 | R_0603_1608Metric | C4197 | 1
27nH | L3 | L_0402_1005Metric | C12669 | 1
2N7002 | Q10,Q11,Q12,Q15,Q16,Q8,Q9 | SOT-23 | C8545 | 7
4.7k 1% | R56,R77 | R_0402_1005Metric_NoSilk | C25900 | 2
4.7u 16V X5R | C1,C15,C48 | C_0603_1608Metric | C19666 | 3
470R | R23,R26,R31 | R_0603_1608Metric | C23179 | 3
47k 1% | R33,R63 | R_0603_1608Metric | C25819 | 2
47n 50V | C17,C45,C8 | C_0603_1608Metric | C1622 | 3
47p C0G | C58 | C_0402_1005Metric_NoSilk | C1567 | 1
5.6k 1% | R73,R75 | R_0603_1608Metric | C23189 | 2
560R | R84 | R_0603_1608Metric | C23204 | 1
5A 0466005.NRHF | F1 | Fuse_1206_3216Metric | C57525 | 1
6.8k | R18 | R_0603_1608Metric | C23212 | 1
75k 1% | R15 | R_0603_1608Metric | C23242 | 1
768k 1% | R60,R80,R81 | R_0402_1005Metric_NoSilk | C49196905 | 3
82k 1% | R59 | R_0603_1608Metric | C23254 | 1
ACTIVE_ANT | SW5 | SW-SMD_SHOUHAN_2.54-1P_TPGT | C7421519 | 1
AO3401A | Q14,Q2,Q3,Q4,Q7 | SOT-23 | C15127 | 5
BLM31KN471SZ1L | FB1 | L_1206_3216Metric | C710518 | 1
BMP580 | U10 | LGA-10_L2.0-W2.0-P0.50-TL_BMP581 | C22391138 | 1
BQ25798RQMR | U4 | Texas_RQM0029A_VQFN-29_4x4mm_P0.4mm | C2876593 | 1
CR2032 | BT1 | BAT-SMD_BS-CR2032-8 | C7498149 | 1
CSD17575Q3 | Q13 | VSON-8_3.3x3.3mm_CSD17575Q3 | C529277 | 1
FUSB303BTMX | U15 | X2QFN-12_L1.6-W1.6-P0.40-TL | C895444 | 1
GNSS_ANT | J7 | U.FL_Hirose_U.FL-R-SMT-1_Vertical | C88374 | 1
H5VLD3B ESD 5V | D4,D5 | D_SOD-323 | C20615805 | 2
K3-1280S-F1 | SW1,SW2,SW3 | SW-SMD_K3-1280S-F1 | C92658 | 3
KT-0603W white | D10 | LED_0603_1608Metric | C2290 | 1
MAX-M10S-00B | U16 | ublox_MAX-M10S | C4153167 | 1
MAX17048G+T10 | U8 | TDFN-8_L2.0-W2.0-P0.50-EP0.8x1.38_T822 | C2682616 | 1
MC-107DMS | J14 | USB_C_Receptacle_Hanbo_MC-107DMS | C3039295 | 1
PESD0402-140 | D7 | D_0402_1005Metric | C10662 | 1
PKMCS0909E4000-R1 | BZ1 | BUZ-SMD_L9.0-W9.0_PKMCS0909E4000-R1 | C910763 | 1
SMAJ12A | D1 | D_SMA | C19077531 | 1
SN74LVC1G17DBVR | U9 | SOT-23-5 | C7836 | 1
TCA9534PWR | U13 | TSSOP-16_4.4x5mm_P0.65mm | C783615 | 1
TLV840CADL29DBVR 2.9V | U5 | SOT-23-5_L2.9-W1.6-P0.95-LS2.8-BR | C3686404 | 1
TLV9001IDBVR | U17 | SOT-23-5 | C398363 | 1
TPS22975DSGR | U7 | Texas_DSG0008A_WSON-8-1EP_2x2mm_P0.5mm_EP0.9x1.6mm | C524777 | 1
TPS259474LRPWR | U11,U12,U14 | VQFN-10_L2.0-W2.0-P0.45-HR_LM73100 | C2864845 | 3
TPS61088RHLR | U6 | VQFN-20_L4.6-W3.6-P0.50-BL | C87357 | 1
XC6206P332MR | U18 | SOT-23 | C5446 | 1
