mp911de/airgrep/hardware/sim/thermal/results_ti.md

# Thermal charge cut-off, simulation results

Generated by `hardware/sim/run_thermal.py` with ngspice-47 for the carrier-ti-charger board (charger BQ25798). The charger is represented by its data sheet TS thresholds, see `hardware/sim/README.md`.

## FET models against their data sheet points

| FET | VGS(th) data sheet | Model gate voltage at 250 µA | Subthreshold swing |
|---|---|---|---|
| Q2 AO3401A | 0.50 V | 0.500 V | 90 mV/decade |
| Q2 AO3401A | 0.90 V | 0.900 V | 90 mV/decade |
| Q2 AO3401A | 1.30 V | 1.300 V | 90 mV/decade |
| Q6 2N7002 | 1.00 V | 1.000 V | 90 mV/decade |
| Q6 2N7002 | 2.00 V | 2.000 V | 90 mV/decade |
| Q6 2N7002 | 2.50 V | 2.500 V | 90 mV/decade |

- PASS: models carry 250 µA within 10 mV of the data sheet threshold, swing 90 mV/decade (assumed, not a data sheet value)

## JEITA window from the thermistor divider

Nominal parts, typical thresholds, no leakage:

| Transition | TS/REGN | Acts at | Releases at | docs/power.md |
|---|---|---|---|---|
| cold (charging stops below) | 73.3 % | 2.7 °C | 4.3 °C | 2.7 °C |
| cool (20 % current below (JEITA_ISETC default)) | 68.4 % | 8.5 °C | 10.0 °C | 8.5 °C |
| warm (VREG - 400 mV above (JEITA_VSET default)) | 44.8 % | 31.8 °C | 30.5 °C | 31.8 °C |
| hot (charging stops above) | 34.2 % | 42.6 °C | 41.2 °C | 42.6 °C |

- PASS: nominal transitions match docs/power.md within 0.1 °C

Worst case in °C. Parts and thresholds: thermistor ±0.2 K and B ±0.5 %, bias resistors ±1 %, charger thresholds at their data sheet minimum and maximum. Leakage: TS pin 0.1 µA typical and 1 µA maximum (assumed, not specified).

| Transition | Nominal | Parts and thresholds | plus typical leakage | plus maximum leakage |
|---|---|---|---|---|
| cold | 2.7 | 0.8 to 4.4 | 0.7 to 4.6 | −1.0 to 5.9 |
| cool | 8.5 | 7.4 to 9.6 | 7.2 to 9.8 | 6.0 to 10.9 |
| warm | 31.8 | 30.8 to 32.7 | 30.7 to 32.8 | 30.0 to 33.5 |
| hot | 42.6 | 41.5 to 43.7 | 41.4 to 43.8 | 40.8 to 44.3 |

- PASS: hot cut-off at most 43.8 °C with typical leakage, within the pack's 45.0 °C charge rating
- Cold cut-off: 0.7 to 4.6 °C with typical leakage against the pack's 0.0 °C rating. Accepted, the window width follows from the thermistor's B value (docs/power.md).
- With assumed ±1 µA TS leakage: charging up to 44.3 °C and down to −1.0 °C.

Temperature-drift screening: independent ±100 ppm/°C for R59 and R60 over −40 to +125 °C board temperature, referenced to 25 °C, plus part/threshold corners and assumed ±0.1 µA TS leakage. R59 specifies this TCR; R60's TCR is assumed pending manufacturer qualification. Board temperature is independent of pack temperature. These bounds are conditional, not guaranteed pack limits.

| Transition | Including resistor drift, °C |
|---|---|
| cold | 0.3 to 4.9 |
| cool | 6.9 to 10.1 |
| warm | 30.4 to 33.1 |
| hot | 41.2 to 44.0 |

Leakage alone, nominal parts and typical thresholds, °C. Positive current flows out of the TS node to ground (TS pin), negative current into it. The TS pin is assumed at 0.1 µA typical, 1 µA maximum:

| TS node leakage | cold | cool | warm | hot |
|---|---|---|---|---|
| −1.0 µA | 4.2 | 9.8 | 32.5 | 43.2 |
| −0.1 µA | 2.8 | 8.6 | 31.8 | 42.6 |
| +0.1 µA | 2.5 | 8.4 | 31.7 | 42.5 |
| +1.0 µA | 1.0 | 7.2 | 31.0 | 41.9 |
| +2.0 µA | −0.9 | 5.7 | 30.2 | 41.3 |

Monte Carlo, 400 units, seed 1, °C. Every tolerance is uniform over its full range: thermistor ±0.2 K and B ±0.5 %, bias ±1 %, thresholds between minimum and maximum. TS leakage is within the typical ±0.1 µA.

| Transition | Lowest | 1 % | Median | 99 % | Highest |
|---|---|---|---|---|---|
| cold | 1.2 | 1.3 | 2.7 | 4.0 | 4.1 |
| cool | 7.6 | 7.7 | 8.5 | 9.3 | 9.4 |
| warm | 30.9 | 31.0 | 31.7 | 32.5 | 32.5 |
| hot | 41.7 | 41.8 | 42.6 | 43.4 | 43.5 |

- Units that still charge above 45.0 °C: 0 %. Units that still charge below 0.0 °C: 0 %.

## Thermistor unplugged or shorted

- PASS: unplugged: TS/REGN = 88.8 % with 1 µA leakage pulling down, above the highest cold threshold (74.2 %), charging suspended
- PASS: shorted: TS/REGN = 0.03 %, below the lowest hot threshold (33.7 %), charging suspended

## Thermostat closed: Q2 leakage into R12 and the CE pin

With the thermostat closed Q2 is off and only R12 (100 kΩ) holds CE (CHG_DIS) low. The AO3401A data sheet allows 1 µA at 25 °C and 5 µA at 55 °C at VDS = −30 V; at the 3 to 4.4 V here it is normally far lower. CE must stay below VIL 0.4 V, charging is disabled above VIH 1.3 V.

| Q2 IDSS | CE (CHG_DIS) | State |
|---|---|---|
| 0.1 µA | 0.009 V | below VIL |
| 0.5 µA | 0.046 V | below VIL |
| 1.0 µA | 0.093 V | below VIL |
| 5.0 µA | 0.464 V | undefined |

- PASS: CE at most 0.093 V with Q2 leakage at the 25 °C data sheet maximum, below VIL 0.4 V; the 55 °C maximum (5 µA, 0.5 V) would disable charging

## Thermostat opens and closes

12 corners: VSYS 3.0 / 3.5 / 4.4 V, Q2 at minimum and maximum VGS(th), thermistor at 0 and 40 °C, slider on.

- PASS: open: CE at least 3.00 V, above VIH 1.3 V, charging disabled
- PASS: open: PWR_EN at most 0.002 V, below 0.4 V, boost and load switch off
- PASS: closed: PWR_EN at least 2.66 V (R43 and R13 against the 800 kΩ EN pull-down), above 1.2 V

| After the contact opens | Delay |
|---|---|
| CE above 1.3 V (charging disabled) | 4.3 to 23.9 ms |
| PWR_EN below 1.2 V (loads may switch off) | 38.0 to 56.3 ms |
| PWR_EN below 0.4 V (loads off) | 90.4 to 108.8 ms |
| PWR_EN between 1.2 and 0.4 V (either IC may be on or off) | 52.5 ms |

| After the contact closes | Delay |
|---|---|
| CE below 0.4 V (charging resumes) | 0.1 to 0.3 ms |
| PWR_EN above 1.2 V (loads on) | 0.0 to 0.1 ms |

Result: all checks pass.
