mp911de/airgrep/hardware/sim/emi/results_ti_tps61378q1.md

# EMI estimate, simulation results, TPS61378-Q1 candidate

Historical candidate study. Its XGL5050 assumption is superseded by the CKST0603 candidate in `boosts.py`. This report does not describe the fitted TPS61088 design. Regenerate before comparing candidates.

Generated by `hardware/sim/run_emi.py` with ngspice-47. Board geometry from `carrier.kicad_pcb`. See `hardware/sim/README.md` for what is and is not modelled. These are order-of-magnitude pre-compliance estimates, not measurements.

Candidate assumption: Candidate silicon at the present U6 thermal location. The internal 100 mOhm isolation FET replaces U7. The proposed 300 kHz setting uses a 3.3 uH XGL5050 inductor and requires a switch/output-capacitor loop no larger than 2.5 mm2. The real candidate layout does not exist. PFM timing is unpublished and is not represented by the fixed-frequency model.

## Converter hot loops and edges (ngspice, emi/switch_edge.cir)

Hot loop through the pad centres (boost U6 (TPS61378-Q1, L2): U6.15 C18.1 C18.2 U6.13, boost U6 270 kHz (TPS61378-Q1, L2): U6.15 C18.1 C18.2 U6.13, boost U6 345 kHz (TPS61378-Q1, L2): U6.15 C18.1 C18.2 U6.13, buck U4 (BQ25798, L1): C44.1 U4.29 U4.27 C44.2, buck U4 (BQ25798, L1) 1.5 MHz: C44.1 U4.29 U4.27 C44.2). The loop inductance is the copper runs as microstrip over the plane 0.20 mm below, plus 0.5 nH capacitor ESL per 0805, 1.0 nH for the package and 0.3 nH per via to the plane. Operating points are the highest loop current and duty of each converter:

| Converter | Point | fSW | Duty | Loop current | Loop area | Copper runs | Loop L | Switch-node copper |
|---|---|---|---|---|---|---|---|---|
| boost U6 (TPS61378-Q1, L2) | 3.1 V in, 1.5 A out | 300 kHz | 0.46 | 2.77 A | 2.5 mm² | +BOOST_5V 3.5 mm, GND 4.0 mm | 3.04 nH | 29 mm² |
| boost U6 270 kHz (TPS61378-Q1, L2) | 3.1 V in, 1.5 A out | 270 kHz | 0.46 | 2.77 A | 2.5 mm² | +BOOST_5V 3.5 mm, GND 4.0 mm | 3.04 nH | 29 mm² |
| boost U6 345 kHz (TPS61378-Q1, L2) | 3.1 V in, 1.5 A out | 345 kHz | 0.46 | 2.77 A | 2.5 mm² | +BOOST_5V 3.5 mm, GND 4.0 mm | 3.04 nH | 29 mm² |
| buck U4 (BQ25798, L1) | 5 V in, 4.2 V / 3.0 A out, 0.75 MHz | 750 kHz | 0.84 | 3.00 A | 1.7 mm² | CHG_PMID 1.6 mm, GND 3.4 mm | 3.01 nH | 20 mm² |
| buck U4 (BQ25798, L1) 1.5 MHz | 5 V in, 4.2 V / 3.0 A out, 1.5 MHz | 1500 kHz | 0.84 | 3.00 A | 1.7 mm² | CHG_PMID 1.6 mm, GND 3.4 mm | 3.01 nH | 20 mm² |

The boost uses the 1.5 A safety point to bound loop current. Sustained load is 0.8 A and expected peak is 1.0 A; edge resonance does not scale reliably with load current.

One period at 10 ps per case. Ring frequency from the zero crossings of the loop current after the main switch turns on, ring current its peak relative to the settled value. Edge is the gate ramp (10 A of current slew per ramp), Coss the output capacitance of each switch (boost 400 pF, buck 300 pF assumed); both are swept:

| Converter | Case | Ring | Ring current | Switch node max / min | Bank pin max / min |
|---|---|---|---|---|---|
| boost U6 | nominal | 139 MHz | 2.92 A | 8.76 V / 0.08 V | 9.88 V / -0.69 V |
| boost U6 | edge 2 ns | 139 MHz | 2.76 A | 8.75 V / 0.07 V | 9.92 V / -0.76 V |
| boost U6 | edge 10 ns | 139 MHz | 2.93 A | 8.78 V / 0.11 V | 9.76 V / 0.58 V |
| boost U6 | Coss 200 pF | 196 MHz | 2.89 A | 12.01 V / 0.08 V | 11.98 V / -0.79 V |
| boost U6 | Coss 800 pF | 98 MHz | 2.93 A | 7.00 V / 0.06 V | 8.99 V / -0.60 V |
| boost U6 270 kHz | nominal | 139 MHz | 2.92 A | 8.76 V / 0.08 V | 9.88 V / -0.69 V |
| boost U6 270 kHz | edge 2 ns | 139 MHz | 2.76 A | 8.75 V / 0.07 V | 9.92 V / -0.76 V |
| boost U6 270 kHz | edge 10 ns | 139 MHz | 2.93 A | 8.78 V / 0.11 V | 9.76 V / 0.58 V |
| boost U6 270 kHz | Coss 200 pF | 196 MHz | 2.89 A | 12.01 V / 0.08 V | 11.98 V / -0.79 V |
| boost U6 270 kHz | Coss 800 pF | 98 MHz | 2.93 A | 7.00 V / 0.06 V | 8.99 V / -0.60 V |
| boost U6 345 kHz | nominal | 139 MHz | 2.92 A | 8.76 V / 0.08 V | 9.88 V / -0.69 V |
| boost U6 345 kHz | edge 2 ns | 139 MHz | 2.76 A | 8.75 V / 0.07 V | 9.92 V / -0.76 V |
| boost U6 345 kHz | edge 10 ns | 139 MHz | 2.93 A | 8.78 V / 0.11 V | 9.76 V / 0.58 V |
| boost U6 345 kHz | Coss 200 pF | 196 MHz | 2.89 A | 12.01 V / 0.08 V | 11.98 V / -0.79 V |
| boost U6 345 kHz | Coss 800 pF | 98 MHz | 2.93 A | 7.00 V / 0.06 V | 8.99 V / -0.60 V |
| buck U4 | nominal | 159 MHz | 3.14 A | 9.36 V / -0.90 V | 10.86 V / -0.81 V |
| buck U4 | edge 2 ns | 159 MHz | 2.98 A | 9.40 V / -0.90 V | 10.92 V / -0.84 V |
| buck U4 | edge 10 ns | 152 MHz | 3.18 A | 6.20 V / -0.90 V | 10.65 V / -0.12 V |
| buck U4 | Coss 150 pF | 223 MHz | 3.14 A | 9.67 V / -0.91 V | 13.98 V / -1.74 V |
| buck U4 | Coss 600 pF | 112 MHz | 3.20 A | 8.96 V / -0.90 V | 9.05 V / -0.77 V |
| buck U4 | nominal | 159 MHz | 3.14 A | 9.36 V / -0.90 V | 10.95 V / -0.81 V |
| buck U4 | edge 2 ns | 159 MHz | 2.98 A | 9.40 V / -0.90 V | 11.01 V / -0.84 V |
| buck U4 | edge 10 ns | 152 MHz | 3.18 A | 6.20 V / -0.90 V | 10.74 V / -0.12 V |
| buck U4 | Coss 150 pF | 223 MHz | 3.14 A | 9.67 V / -0.91 V | 14.00 V / -1.74 V |
| buck U4 | Coss 600 pF | 112 MHz | 3.20 A | 8.96 V / -0.90 V | 9.06 V / -0.77 V |

Cross-check of the bench lines against the closed-form trapezoid at the low harmonics (the bench includes dead time and the diode drops, so a few percent differ):

| Converter | Harmonic | Loop current, closed form | bench | Switch node, closed form | bench |
|---|---|---|---|---|---|
| boost U6 | 1 (0.30 MHz) | 1.748 A | 1.743 A | 3.252 V | 3.262 V |
| boost U6 | 2 (0.60 MHz) | 0.228 A | 0.271 A | 0.423 V | 0.510 V |
| boost U6 | 5 (1.50 MHz) | 0.280 A | 0.266 A | 0.521 V | 0.492 V |
| boost U6 | 10 (3.00 MHz) | 0.170 A | 0.169 A | 0.316 V | 0.318 V |
| boost U6 270 kHz | 1 (0.27 MHz) | 1.748 A | 1.739 A | 3.252 V | 3.255 V |
| boost U6 270 kHz | 2 (0.54 MHz) | 0.228 A | 0.249 A | 0.423 V | 0.475 V |
| boost U6 270 kHz | 5 (1.35 MHz) | 0.280 A | 0.268 A | 0.521 V | 0.496 V |
| boost U6 270 kHz | 10 (2.70 MHz) | 0.170 A | 0.168 A | 0.316 V | 0.317 V |
| boost U6 345 kHz | 1 (0.34 MHz) | 1.748 A | 1.739 A | 3.252 V | 3.255 V |
| boost U6 345 kHz | 2 (0.69 MHz) | 0.227 A | 0.257 A | 0.423 V | 0.486 V |
| boost U6 345 kHz | 5 (1.73 MHz) | 0.280 A | 0.270 A | 0.521 V | 0.496 V |
| boost U6 345 kHz | 10 (3.45 MHz) | 0.170 A | 0.171 A | 0.316 V | 0.323 V |
| buck U4 | 1 (0.75 MHz) | 0.920 A | 0.953 A | 1.533 V | 1.593 V |
| buck U4 | 2 (1.50 MHz) | 0.806 A | 0.817 A | 1.344 V | 1.358 V |
| buck U4 | 5 (3.75 MHz) | 0.224 A | 0.193 A | 0.374 V | 0.293 V |
| buck U4 | 10 (7.50 MHz) | 0.181 A | 0.166 A | 0.302 V | 0.263 V |
| buck U4 | 1 (1.50 MHz) | 0.920 A | 0.982 A | 1.533 V | 1.681 V |
| buck U4 | 2 (3.00 MHz) | 0.806 A | 0.834 A | 1.343 V | 1.413 V |
| buck U4 | 5 (7.50 MHz) | 0.224 A | 0.163 A | 0.373 V | 0.222 V |
| buck U4 | 10 (15 MHz) | 0.180 A | 0.149 A | 0.300 V | 0.223 V |

- PASS: boost U6 loop-current harmonic 1: bench 1.743 A against closed form 1.748 A
- PASS: boost U6 loop-current harmonic 2: bench 0.271 A against closed form 0.228 A
- PASS: boost U6 270 kHz loop-current harmonic 1: bench 1.739 A against closed form 1.748 A
- PASS: boost U6 270 kHz loop-current harmonic 2: bench 0.249 A against closed form 0.228 A
- PASS: boost U6 345 kHz loop-current harmonic 1: bench 1.739 A against closed form 1.748 A
- PASS: boost U6 345 kHz loop-current harmonic 2: bench 0.257 A against closed form 0.227 A
- PASS: buck U4 loop-current harmonic 1: bench 0.953 A against closed form 0.920 A
- PASS: buck U4 loop-current harmonic 2: bench 0.817 A against closed form 0.806 A
- PASS: buck U4 loop-current harmonic 1: bench 0.982 A against closed form 0.920 A
- PASS: buck U4 loop-current harmonic 2: bench 0.834 A against closed form 0.806 A

## Digital signals on the carrier

Edge time at the far end: driver edge (assumed: ESP32-S3 and RP2040 2 ns, MAX-M10S 3 ns, TCA9534 10 ns, 40 Ω output) combined with the RC of the series resistor and the track plus pin capacitance from the board. The knee 1/(π tr) is where the spectrum starts to fall at 40 dB per decade. USB_DP and USB_DN carry only the BC1.2 detection at plug-in, no traffic. PWR_EN, SW_EN, the LED and status nets are static.

| Net | Track | Load C | Edge | Knee | Edges | Note |
|---|---|---|---|---|---|---|
| I2C_SCL | 89 mm | 72.7 pF | 11.9 ns | 27 MHz | 100000 /s | 100 kHz clock; falling edge by the driver, rise 5.1 kΩ x bus |
| I2C_SDA | 99 mm | 73.6 pF | 11.9 ns | 27 MHz | 50000 /s | data, half the clock edges |
| ESP_UART_TX | 5 mm | 5.4 pF | 2.1 ns | 155 MHz | 57600 /s | display TX to R30, 115200 baud |
| ADS_COMMS_RX | 51 mm | 14.4 pF | 33.1 ns | 10 MHz | 57600 /s | behind R30 1 kΩ to the ADSBee |
| ADS_COMMS_TX | 51 mm | 9.5 pF | 2.2 ns | 147 MHz | 57600 /s | ADSBee TX to R29, 115200 baud |
| ESP_UART_RX | 11 mm | 11.0 pF | 25.2 ns | 13 MHz | 57600 /s | behind R29 1 kΩ to the display |
| GNSS_TXO | 91 mm | 18.9 pF | 3.4 ns | 93 MHz | 19200 /s | GNSS TX, 38400 baud |
| GNSS_RXI | 95 mm | 19.2 pF | 2.6 ns | 122 MHz | 19200 /s | ADSBee TX to the GNSS |
| GNSS_PPS | 88 mm | 18.6 pF | 3.4 ns | 93 MHz | 2 /s | 1 Hz pulse |
| BUZZ_PWM | 59 mm | 15.2 pF | 2.4 ns | 132 MHz | 8000 /s | 4 kHz buzzer PWM to U9 |
| BUZZ_DRV | 3 mm | 5.3 pF | 2.1 ns | 155 MHz | 8000 /s | U9 output to R28 |

## Radiated emission at 3 m against CISPR 32 class B

Each loop as a small magnetic dipole (Ott, E = 2.63e-14 f² A I / r including the ground-plane reflection of the test site). Converter loop currents are the bench lines at n·fSW; the inductor leakage field uses the triangle ripple current with 10 % leakage of 5 turns of 10 mm². Lines closer than the receiver bandwidth (120 kHz below 1 GHz, 1 MHz above) add as power. Limits: 40 dBµV/m to 230 MHz, 47 dBµV/m to 1 GHz, average 50 dBµV/m above. Margin is limit minus level, target 6 dB:

| Source | Case | 30 to 230 MHz | 230 MHz to 1 GHz | 1 to 3 GHz |
|---|---|---|---|---|
| boost U6 hot loop | nominal | 25 dB at 140 MHz | 46 dB at 235 MHz | 53 dB at 1042 MHz |
| boost U6 hot loop | edge 2 ns | 25 dB at 138 MHz | 45 dB at 235 MHz | 52 dB at 1056 MHz |
| boost U6 hot loop | edge 10 ns | 29 dB at 134 MHz | 47 dB at 236 MHz | 57 dB at 1031 MHz |
| boost U6 hot loop | Coss 200 pF | 20 dB at 195 MHz | 37 dB at 232 MHz | 53 dB at 1001 MHz |
| boost U6 hot loop | Coss 800 pF | 31 dB at 99 MHz | 46 dB at 231 MHz | 57 dB at 1192 MHz |
| L2 leakage | 1.44 A ripple | 86 dB at 32 MHz | 94 dB at 282 MHz | 91 dB at 1062 MHz |
| boost U6 270 kHz hot loop | nominal | 26 dB at 139 MHz | 47 dB at 231 MHz | 54 dB at 1044 MHz |
| boost U6 270 kHz hot loop | edge 2 ns | 26 dB at 141 MHz | 46 dB at 235 MHz | 53 dB at 1054 MHz |
| boost U6 270 kHz hot loop | edge 10 ns | 30 dB at 133 MHz | 48 dB at 238 MHz | 57 dB at 1030 MHz |
| boost U6 270 kHz hot loop | Coss 200 pF | 21 dB at 195 MHz | 38 dB at 232 MHz | 53 dB at 1002 MHz |
| boost U6 270 kHz hot loop | Coss 800 pF | 32 dB at 99 MHz | 47 dB at 231 MHz | 58 dB at 1193 MHz |
| L2 leakage | 1.60 A ripple | 87 dB at 33 MHz | 95 dB at 254 MHz | 92 dB at 1043 MHz |
| boost U6 345 kHz hot loop | nominal | 24 dB at 137 MHz | 44 dB at 233 MHz | 53 dB at 1040 MHz |
| boost U6 345 kHz hot loop | edge 2 ns | 24 dB at 138 MHz | 44 dB at 237 MHz | 52 dB at 1048 MHz |
| boost U6 345 kHz hot loop | edge 10 ns | 27 dB at 133 MHz | 46 dB at 242 MHz | 56 dB at 1033 MHz |
| boost U6 345 kHz hot loop | Coss 200 pF | 19 dB at 195 MHz | 35 dB at 230 MHz | 52 dB at 1002 MHz |
| boost U6 345 kHz hot loop | Coss 800 pF | 29 dB at 101 MHz | 45 dB at 233 MHz | 57 dB at 1193 MHz |
| L2 leakage | 1.25 A ripple | 85 dB at 33 MHz | 92 dB at 237 MHz | 91 dB at 1005 MHz |
| buck U4 hot loop | nominal | 18 dB at 156 MHz | 41 dB at 232 MHz | 54 dB at 1161 MHz |
| buck U4 hot loop | edge 2 ns | 18 dB at 160 MHz | 41 dB at 548 MHz | 51 dB at 1184 MHz |
| buck U4 hot loop | edge 10 ns | 22 dB at 159 MHz | 40 dB at 234 MHz | 57 dB at 1090 MHz |
| buck U4 hot loop | Coss 150 pF | 13 dB at 224 MHz | 22 dB at 232 MHz | 47 dB at 1012 MHz |
| buck U4 hot loop | Coss 600 pF | 23 dB at 111 MHz | 42 dB at 232 MHz | 55 dB at 1222 MHz |
| L1 leakage | 0.41 A ripple | 76 dB at 31 MHz | 83 dB at 242 MHz | 85 dB at 1010 MHz |
| buck U4 hot loop | nominal | 12 dB at 162 MHz | 35 dB at 231 MHz | 49 dB at 1150 MHz |
| buck U4 hot loop | edge 2 ns | 12 dB at 159 MHz | 35 dB at 542 MHz | 47 dB at 1204 MHz |
| buck U4 hot loop | edge 10 ns | 16 dB at 159 MHz | 34 dB at 234 MHz | 52 dB at 1092 MHz |
| buck U4 hot loop | Coss 150 pF | 7 dB at 222 MHz | 15 dB at 231 MHz | 42 dB at 1002 MHz |
| buck U4 hot loop | Coss 600 pF | 17 dB at 110 MHz | 36 dB at 238 MHz | 50 dB at 1215 MHz |
| L1 leakage | 0.20 A ripple | 69 dB at 33 MHz | 77 dB at 258 MHz | 80 dB at 1008 MHz |
| I2C_SCL | 11.9 ns edge | 71 dB at 215 MHz | 75 dB at 297 MHz | 81 dB at 1000 MHz |
| I2C_SDA | 11.9 ns edge | 70 dB at 213 MHz | 75 dB at 297 MHz | 84 dB at 1000 MHz |
| ESP_UART_TX | 2.1 ns edge | 103 dB at 228 MHz | 100 dB at 762 MHz | 97 dB at 1000 MHz |
| ADS_COMMS_RX | 33.1 ns edge | 99 dB at 226 MHz | 98 dB at 560 MHz | 96 dB at 1000 MHz |
| ADS_COMMS_TX | 2.2 ns edge | 78 dB at 228 MHz | 79 dB at 691 MHz | 69 dB at 1000 MHz |
| ESP_UART_RX | 25.2 ns edge | 112 dB at 219 MHz | 106 dB at 974 MHz | 96 dB at 1000 MHz |
| GNSS_TXO | 3.4 ns edge | 74 dB at 188 MHz | 78 dB at 438 MHz | 62 dB at 1000 MHz |
| GNSS_RXI | 2.6 ns edge | 69 dB at 228 MHz | 75 dB at 575 MHz | 60 dB at 1000 MHz |
| GNSS_PPS | 3.4 ns edge | 74 dB at 188 MHz | 78 dB at 438 MHz | 63 dB at 1000 MHz |
| BUZZ_PWM | 2.4 ns edge | 74 dB at 228 MHz | 78 dB at 622 MHz | 63 dB at 1000 MHz |
| BUZZ_DRV | 2.1 ns edge | 108 dB at 228 MHz | 105 dB at 762 MHz | 103 dB at 1000 MHz |

- PASS: smallest radiated margin as modelled 12 dB: buck U4 (BQ25798, L1) 1.5 MHz, 28 dBµV/m at 162 MHz against 40 dBµV/m
- Sensitivity: 7 dB margin for buck U4 (BQ25798, L1) 1.5 MHz with Coss 150 pF (33 dBµV/m at 222 MHz).
- Digital tracks run over the solid In1 ground; their loop is track length times the 0.20 mm dielectric, with the displacement current of the track capacitance below λ/10 and V/Z0 above. Impulsive sources (PPS, UART) are read with the peak detector, which overstates the quasi-peak by 20 to 40 dB.
- Not in this estimate: common-mode currents on the antenna coax and the USB cable, the modules' own emissions (ESP32-S3 clocks and Wi-Fi, RP2040, CC1312) and the enclosure.

## Converter and digital lines in the receiver bands

Field of each hot loop at the antenna (free space with the near-field term; distance from the inductor centre to the mount plus 30 mm to the antenna on the enclosure wall), received by a dipole of gain 1.64 with its far-field aperture. Lines within the receiver bandwidth add as power; where the line spacing exceeds the bandwidth the nearest line counts. Triangle frequency dithering is integrated as uniform dwell across each harmonic's specified spread. Threshold: thermal noise floor kTB plus the noise figure, less 6 dB (ADS-B 4 MHz, NF 5 dB; FLARM 250 kHz, NF 5 dB; GNSS 2 MHz, NF 2 dB):

| Receiver | Source | Distance | Lines | In-band power | Threshold | Margin |
|---|---|---|---|---|---|---|
| ADS-B 1090 MHz | boost U6, nominal | 94 mm | 748 | -116 dBm | -109 dBm | 7 dB |
| ADS-B 1090 MHz | boost U6, edge 2 ns | 94 mm | 748 | -114 dBm | -109 dBm | 5 dB |
| ADS-B 1090 MHz | boost U6 270 kHz, nominal | 94 mm | 830 | -116 dBm | -109 dBm | 7 dB |
| ADS-B 1090 MHz | boost U6 270 kHz, edge 2 ns | 94 mm | 830 | -115 dBm | -109 dBm | 6 dB |
| ADS-B 1090 MHz | boost U6 345 kHz, nominal | 94 mm | 650 | -115 dBm | -109 dBm | 6 dB |
| ADS-B 1090 MHz | boost U6 345 kHz, edge 2 ns | 94 mm | 650 | -113 dBm | -109 dBm | 4 dB |
| ADS-B 1090 MHz | buck U4, nominal | 103 mm | 6 | -118 dBm | -109 dBm | 9 dB |
| ADS-B 1090 MHz | buck U4, edge 2 ns | 103 mm | 6 | -115 dBm | -109 dBm | 6 dB |
| ADS-B 1090 MHz | buck U4, nominal | 103 mm | 3 | -113 dBm | -109 dBm | 4 dB |
| ADS-B 1090 MHz | buck U4, edge 2 ns | 103 mm | 3 | -116 dBm | -109 dBm | 7 dB |
| ADS-B 1090 MHz | worst digital net: ADS_COMMS_TX | 65 mm | - | -131 dBm | -109 dBm | 22 dB |
| FLARM 868 MHz | boost U6, nominal | 98 mm | 586 | -126 dBm | -121 dBm | 5 dB |
| FLARM 868 MHz | boost U6, edge 2 ns | 98 mm | 586 | -123 dBm | -121 dBm | 2 dB |
| FLARM 868 MHz | boost U6 270 kHz, nominal | 98 mm | 651 | -126 dBm | -121 dBm | 5 dB |
| FLARM 868 MHz | boost U6 270 kHz, edge 2 ns | 98 mm | 651 | -124 dBm | -121 dBm | 3 dB |
| FLARM 868 MHz | boost U6 345 kHz, nominal | 98 mm | 509 | -125 dBm | -121 dBm | 4 dB |
| FLARM 868 MHz | boost U6 345 kHz, edge 2 ns | 98 mm | 509 | -122 dBm | -121 dBm | 1 dB |
| FLARM 868 MHz | buck U4, nominal | 102 mm | 1 | -124 dBm | -121 dBm | 3 dB |
| FLARM 868 MHz | buck U4, edge 2 ns | 102 mm | 1 | -123 dBm | -121 dBm | 2 dB |
| FLARM 868 MHz | buck U4, nominal | 102 mm | 1 | -116 dBm | -121 dBm | -5 dB |
| FLARM 868 MHz | buck U4, edge 2 ns | 102 mm | 1 | -110 dBm | -121 dBm | -11 dB |
| FLARM 868 MHz | worst digital net: GNSS_RXI | 48 mm | - | -139 dBm | -121 dBm | 18 dB |
| GNSS L1 1575 MHz | boost U6, nominal | 107 mm | 1068 | -127 dBm | -115 dBm | 12 dB |
| GNSS L1 1575 MHz | boost U6, edge 2 ns | 107 mm | 1068 | -124 dBm | -115 dBm | 9 dB |
| GNSS L1 1575 MHz | boost U6 270 kHz, nominal | 107 mm | 1186 | -127 dBm | -115 dBm | 12 dB |
| GNSS L1 1575 MHz | boost U6 270 kHz, edge 2 ns | 107 mm | 1186 | -124 dBm | -115 dBm | 9 dB |
| GNSS L1 1575 MHz | boost U6 345 kHz, nominal | 107 mm | 929 | -126 dBm | -115 dBm | 11 dB |
| GNSS L1 1575 MHz | boost U6 345 kHz, edge 2 ns | 107 mm | 929 | -123 dBm | -115 dBm | 8 dB |
| GNSS L1 1575 MHz | buck U4, nominal | 106 mm | 2 | -132 dBm | -115 dBm | 17 dB |
| GNSS L1 1575 MHz | buck U4, edge 2 ns | 106 mm | 2 | -125 dBm | -115 dBm | 10 dB |
| GNSS L1 1575 MHz | buck U4, nominal | 106 mm | 1 | -130 dBm | -115 dBm | 15 dB |
| GNSS L1 1575 MHz | buck U4, edge 2 ns | 106 mm | 1 | -121 dBm | -115 dBm | 6 dB |
| GNSS L1 1575 MHz | worst digital net: ADS_COMMS_TX | 82 mm | - | -139 dBm | -115 dBm | 25 dB |

- **FAIL**: FLARM 868 MHz: buck U4 -116 dBm above -121 dBm
- PASS: selected boost nominal and 2 ns edge cases below every receiver threshold
- The ADS-B receiver's data sheet sensitivity is −85 dBm; the threshold here protects the noise floor, which is stricter. GNSS tolerates narrowband interference better than this threshold suggests, because despreading averages it. Digital nets use the mean power of a random edge train in the bandwidth.
- Bench item: the ADSBee reports its noise floor (trigger level); compare it with the boost and the charger running against both off, and with the snubber fitted.

## Conducted emission on the USB input (ngspice, emi/usb_lisn.cir)

Buck input current 3.0 A at duty 0.84 and 750 kHz from BYP; USB_VBUS copper 30 mm, 84.1 mΩ, 12 nH with 9 vias from the board; USB cable 0.3 Ω, 1.0 µH; LISN 50 µH / 50 Ω. Steady state, last 100 µs, Hann window, lines at the harmonics. The quasi-peak limit applies to the mains port; an adapter's own filter is not in the model, so this is the worst case:

| Case | BYP ripple (fSW) | LISN at fSW | Worst line | Limit (QP) | Margin |
|---|---|---|---|---|---|
| FB1 1.0 µH, 5 ns edges | 8.7 mV | 40.9 dBµV at 0.75 MHz | 40.9 dBµV at 0.75 MHz | 56 dBµV | 15 dB |
| FB1 1.0 µH, 2 ns edges | 8.7 mV | 40.9 dBµV at 0.75 MHz | 40.9 dBµV at 0.75 MHz | 56 dBµV | 15 dB |
| FB1 0.3 µH (DC bias) | 8.8 mV | 51.3 dBµV at 0.75 MHz | 51.3 dBµV at 0.75 MHz | 56 dBµV | 5 dB |
| FB1 0.1 µH (DC bias) | 8.9 mV | 60.6 dBµV at 0.75 MHz | 60.6 dBµV at 0.75 MHz | 56 dBµV | -5 dB |
| FB1 fitted as 0 Ω | 8.8 mV | 70.8 dBµV at 0.75 MHz | 70.8 dBµV at 0.75 MHz | 56 dBµV | -15 dB |
| before FB1: 0 Ω, C1 1 µF | 8.6 mV | 78.6 dBµV at 0.75 MHz | 78.6 dBµV at 0.75 MHz | 56 dBµV | -23 dB |
| C33 missing (BYP 6 µF) | 25.3 mV | 50.1 dBµV at 0.75 MHz | 50.1 dBµV at 0.75 MHz | 56 dBµV | 6 dB |
| 0 Ω, adapter 470 µF / 30 mΩ across the LISN | 8.8 mV | 27.2 dBµV at 0.75 MHz | 27.2 dBµV at 0.75 MHz | 56 dBµV | 29 dB |

- **FAIL**: conducted margin with FB1, worst inductance -5 dB (FB1 0.1 µH (DC bias), 61 dBµV at 0.75 MHz against the LISN)
- FB1's inductance at 0.75 MHz and up to 3 A is an estimate; the rows with 0.3 µH and 0.1 µH show how the margin follows it. Murata's DC-bias curve for BLM31KN471SZ1L decides; it is not on file.
- The LISN is the CISPR 32 method for a DC power port and the worst case for the mains port. A real adapter's output capacitor absorbs most of the cable current (last row); its mains-side filter is designed for its own switching frequency, not for 0.75 MHz. Average limits are 10 dB lower; steady lines read the same on both detectors. Common-mode current through the adapter's parasitic capacitance is not modelled.

## Return paths under signal tracks

Top tracks reference In1, bottom tracks In2, both 0.20 mm away. Listed: track length over non-GND zone copper of the reference layer and crossings of its power tracks (the gap is the power track width). In1 carries only GND.

| Layer | Net | Over power copper | Track crossings | Gap |
|---|---|---|---|---|
| B.Cu | USB_D- | 16.7 mm | 1 | 0.3 mm |
| B.Cu | USB_D+ | 14.5 mm | 1 | 0.3 mm |
| B.Cu | CHG_DIS | 7.5 mm | 0 | 0.0 mm |
| B.Cu | CHG_STAT_N | 4.0 mm | 2 | 0.8 mm |
| B.Cu | CHG_BTST2 | 4.3 mm | 0 | 0.0 mm |
| B.Cu | CHG_BTST1 | 4.2 mm | 0 | 0.0 mm |
| B.Cu | CHG_QON_N | 0.9 mm | 3 | 2.0 mm |
| B.Cu | I2C_SDA | 0.0 mm | 4 | 2.3 mm |
| B.Cu | I2C_SCL | 0.0 mm | 4 | 2.3 mm |
| B.Cu | SW_EN | 0.0 mm | 3 | 1.3 mm |
| B.Cu | PWR_EN | 0.0 mm | 1 | 1.3 mm |
| B.Cu | +ESP_5V | 0.0 mm | 1 | 0.8 mm |
| B.Cu | +VBAT | 0.0 mm | 1 | 0.8 mm |
| B.Cu | USB_G2 | 0.0 mm | 2 | 0.7 mm |
| B.Cu | WIFI_ENABLE | 0.0 mm | 1 | 0.5 mm |
| B.Cu | BUZZ_ENABLE | 0.0 mm | 1 | 0.5 mm |
| B.Cu | LED_G_SW | 0.0 mm | 1 | 0.4 mm |
| B.Cu | LED_R_SW | 0.0 mm | 1 | 0.4 mm |
| B.Cu | USB_CC2 | 0.0 mm | 1 | 0.3 mm |
| B.Cu | USB_CC1 | 0.0 mm | 1 | 0.3 mm |

- PASS: digital tracks over return-path gaps: 4.7 mm in total, below 5 mm

## Rail ripple at the module sockets and the battery harness loop

Track parasitics from the board (all segments of the net, a bound for branching nets; 0.3 nH and 0.5 mΩ per via):

| Net | To | Length | R | L | C | Vias |
|---|---|---|---|---|---|---|
| RAIL_5V | U11/U12 inputs | 152 mm | 191.7 mΩ | 32 nH | 34 pF | 8 |
| ESP_5V | J7.1 | 22 mm | 18.5 mΩ | 5 nH | 3 pF | 0 |
| ADS_5V | J10.1 | 7 mm | 8.1 mΩ | 2 nH | 1 pF | 0 |
| VSYS | L2, J3 | 93 mm | 198.5 mΩ | 29 nH | 14 pF | 11 |
| VBAT | J3 | 39 mm | 50.9 mΩ | 12 nH | 5 pF | 2 |

Boost at 3.1 V in, 1.5 A out: RAIL_5V lines from power/boost_ripple.cir, driven through the LM73100 (28 mΩ) and the RAIL_5V and ESP_5V copper into 20 µF module input capacitance:

| Harmonic | RAIL_5V | Current into the module | At the socket |
|---|---|---|---|
| 1 (0.30 MHz) | 24.2 mV | 100 mA | 2.6 mV |
| 2 (0.60 MHz) | 2.5 mV | 9 mA | 0.1 mV |
| 3 (0.90 MHz) | 2.0 mV | 6 mA | 0.1 mV |

VSYS ripple lines (benches, raw node, valid to about 100 MHz at their time step) drive the pack leads: 100 mm untwisted pair 5 mm apart (500 mm² loop), 150 mΩ and 200 nH in the path. Worst line between 30 and 100 MHz against the radiated limit:

| Source | VSYS ripple (fSW) | Worst line | VSYS line | Lead current | Field at 3 m | Margin |
|---|---|---|---|---|---|---|
| boost, battery | 7.5 mV | 30 MHz | 0.1 µV | 0.0 µA | -99 dBµV/m | 139 dB |
| buck, charging | 0.5 mV | 56 MHz | 4.5 µV | 0.1 µA | -61 dBµV/m | 101 dB |

- PASS: battery harness loop margin 101 dB at 56 MHz
- The carrier's own VSYS copper adds 93 mm over the plane, a far smaller loop. Twisting the pack leads removes most of the harness area.

Result: 2 check(s) failed.
