mp911de/airgrep/hardware/sim/power/results_ti.md

# Power converters, simulation results

Generated by `hardware/sim/run_power.py` with ngspice-47. See `hardware/sim/README.md` for what is and is not modelled.

## Module-feed overvoltage lockout

U11/U12 sense RAIL_5V through R73/R74 and R75/R76: 5.6 kΩ / 1.5 kΩ, both 1 %, ±100 ppm/°C (0603WAF5601T5E, 0402WGF1501TCE). U14 senses CHG_PMID through R77/R78: 4.7 kΩ 1 %, ±100 ppm/°C (0603WAF4701T5E) over 1.24 kΩ 0.1 %, ±25 ppm/°C (ARG02BTC1241). Static corners include independent resistor drift over −40 to +125 °C from 25 °C, IC threshold limits and ±0.1 µA OVLO leakage. Source: TPS25947 SLVSFC9C section 6.5.
| Feed | Threshold | Nominal | Full-temperature corners |
|---|---|---|---|
| U11/U12, RAIL_5V | Trip | 5.680 V | 5.426–5.976 V |
| U11/U12, RAIL_5V | Release | 5.159 V | 4.935–5.453 V |
| U14, USB side | Trip | 5.748 V | 5.562–5.969 V |
| U14, USB side | Release | 5.221 V | 5.059–5.447 V |

- PASS: RAIL_5V minimum trip exceeds the boost's 5.25 V load-step maximum
- PASS: USB-side minimum trip exceeds the 5.5 V normal USB input maximum
- PASS: static maximum trip is below the display SGM6029's 6 V absolute maximum
USB PD load transients reach 6.0 V for up to 5 ms; U14 trips on them by design, since 6 V is the display's absolute maximum. The RAIL_5V release and trip bands overlap with 1 % dividers.
Returning to 5 V does not guarantee recovery. Cycle the affected input after an overvoltage fault: POWER off/on for U11/U12, USB disconnect/reconnect for U14. The display SGM6029 operating maximum is 5.5 V. Static trip below 6 V does not establish a safe fault waveform: OVLO response is 1.2 µs typical, with no guaranteed maximum here. Fault overshoot, U7 survival and recovery require bench verification. The transient benches do not simulate OVLO switching.

## TPS61088 boost loop

Small-signal model from the data sheet: constant off-time, peak current control, Rsense 0.08 Ω, GEA 190 µA/V. Fitted compensation R18 6.8 kΩ, C21 10 nF, C22 100 pF, with L2 2.2 µH. VOUT 5.06 V, switching frequency 0.71 to 0.73 MHz over 3.1 to 4.4 V (R16 220 kΩ). The error amplifier output resistance is not specified. 10 MΩ is assumed; it sets only the DC gain.

MODE is tied to GND (forced PWM), so the converter stays in continuous conduction at every load. The CCM model therefore applies down to the 0.05 A light-load case. Not in the model: the current-loop sampling poles at fSW/2 (a few degrees at these crossovers), slope compensation and the error amplifier bandwidth.

Nominal parts (L2 2.2 µH, C21 10 nF, output capacitance 38 µF):

| VIN | IOUT | Crossover | Limit (fSW/10, RHPZ/5) | RHP zero | Phase margin | Gain margin |
|---|---|---|---|---|---|---|
| 3.1 V | 0.05 A | 9.2 kHz | 70.9 kHz | 2227.2 kHz | 74° | 54 dB |
| 3.1 V | 0.20 A | 9.2 kHz | 70.9 kHz | 556.8 kHz | 75° | 37 dB |
| 3.1 V | 0.80 A | 9.2 kHz | 27.8 kHz | 139.2 kHz | 78° | 24 dB |
| 3.1 V | 1.00 A | 9.1 kHz | 22.3 kHz | 111.4 kHz | 79° | 22 dB |
| 3.1 V | 1.50 A | 9.0 kHz | 14.8 kHz | 74.2 kHz | 82° | 19 dB |
| 3.7 V | 0.05 A | 10.9 kHz | 72.1 kHz | 3172.8 kHz | 76° | 61 dB |
| 3.7 V | 0.20 A | 10.9 kHz | 72.1 kHz | 793.2 kHz | 76° | 39 dB |
| 3.7 V | 0.80 A | 10.9 kHz | 39.7 kHz | 198.3 kHz | 79° | 26 dB |
| 3.7 V | 1.00 A | 10.8 kHz | 31.7 kHz | 158.6 kHz | 80° | 24 dB |
| 3.7 V | 1.50 A | 10.7 kHz | 21.2 kHz | 105.8 kHz | 83° | 20 dB |
| 4.4 V | 0.05 A | 12.9 kHz | 73.1 kHz | 4486.9 kHz | 77° | > 40 dB |
| 4.4 V | 0.20 A | 12.9 kHz | 73.1 kHz | 1121.7 kHz | 78° | 42 dB |
| 4.4 V | 0.80 A | 12.9 kHz | 56.1 kHz | 280.4 kHz | 80° | 27 dB |
| 4.4 V | 1.00 A | 12.8 kHz | 44.9 kHz | 224.3 kHz | 81° | 25 dB |
| 4.4 V | 1.50 A | 12.7 kHz | 29.9 kHz | 149.6 kHz | 83° | 22 dB |

Worst case over 36 part corners per operating point: output capacitance minimum (25 µF), nominal (38 µF), maximum (45 µF), maximum plus modules (85 µF); L −20 %, L nominal, L +20 %; C21 −10 %, C21 nominal, C21 +10 %. The corner in brackets is where the worst value occurs:

| VIN | IOUT | Crossover | Lowest phase margin | Lowest gain margin | Highest crossover / limit |
|---|---|---|---|---|---|
| 3.1 V | 0.05 A | 4.4 kHz to 13.5 kHz | 60° (maximum plus modules (85 µF), L +20 %, C21 −10 %) | 46 dB (minimum (25 µF), L +20 %, C21 −10 %) | 0.19 (minimum (25 µF), L +20 %, C21 −10 %) |
| 3.1 V | 0.20 A | 4.4 kHz to 13.5 kHz | 61° (maximum plus modules (85 µF), L +20 %, C21 −10 %) | 31 dB (minimum (25 µF), L +20 %, C21 −10 %) | 0.19 (minimum (25 µF), L +20 %, C21 −10 %) |
| 3.1 V | 0.80 A | 4.4 kHz to 13.4 kHz | 65° (maximum plus modules (85 µF), L +20 %, C21 −10 %) | 19 dB (minimum (25 µF), L +20 %, C21 −10 %) | 0.58 (minimum (25 µF), L +20 %, C21 −10 %) |
| 3.1 V | 1.00 A | 4.4 kHz to 13.4 kHz | 66° (maximum plus modules (85 µF), L +20 %, C21 −10 %) | 17 dB (minimum (25 µF), L +20 %, C21 −10 %) | 0.72 (minimum (25 µF), L +20 %, C21 −10 %) |
| 3.1 V | 1.50 A | 4.3 kHz to 13.3 kHz | 69° (maximum plus modules (85 µF), L +20 %, C21 −10 %) | 14 dB (minimum (25 µF), L +20 %, C21 −10 %) | 1.07 (minimum (25 µF), L +20 %, C21 −10 %) |
| 3.7 V | 0.05 A | 5.2 kHz to 16.0 kHz | 63° (maximum plus modules (85 µF), L +20 %, C21 −10 %) | 49 dB (minimum (25 µF), L +20 %, C21 −10 %) | 0.22 (minimum (25 µF), L +20 %, C21 −10 %) |
| 3.7 V | 0.20 A | 5.1 kHz to 16.0 kHz | 64° (maximum plus modules (85 µF), L +20 %, C21 −10 %) | 33 dB (minimum (25 µF), L +20 %, C21 −10 %) | 0.22 (minimum (25 µF), L +20 %, C21 −10 %) |
| 3.7 V | 0.80 A | 5.1 kHz to 16.0 kHz | 67° (maximum plus modules (85 µF), L +20 %, C21 −10 %) | 21 dB (minimum (25 µF), L +20 %, C21 −10 %) | 0.48 (minimum (25 µF), L +20 %, C21 −10 %) |
| 3.7 V | 1.00 A | 5.1 kHz to 15.9 kHz | 68° (maximum plus modules (85 µF), L +20 %, C21 −10 %) | 19 dB (minimum (25 µF), L +20 %, C21 −10 %) | 0.60 (minimum (25 µF), L +20 %, C21 −10 %) |
| 3.7 V | 1.50 A | 5.0 kHz to 15.8 kHz | 71° (maximum plus modules (85 µF), L +20 %, C21 −10 %) | 15 dB (minimum (25 µF), L +20 %, C21 −10 %) | 0.90 (minimum (25 µF), L +20 %, C21 −10 %) |
| 4.4 V | 0.05 A | 6.0 kHz to 18.9 kHz | 66° (maximum plus modules (85 µF), L +20 %, C21 −10 %) | 54 dB (minimum (25 µF), L +20 %, C21 −10 %) | 0.26 (minimum (25 µF), L +20 %, C21 −10 %) |
| 4.4 V | 0.20 A | 6.0 kHz to 18.9 kHz | 67° (maximum plus modules (85 µF), L +20 %, C21 −10 %) | 35 dB (minimum (25 µF), L +20 %, C21 −10 %) | 0.26 (minimum (25 µF), L +20 %, C21 −10 %) |
| 4.4 V | 0.80 A | 6.0 kHz to 18.9 kHz | 70° (maximum plus modules (85 µF), L +20 %, C21 −10 %) | 22 dB (minimum (25 µF), L +20 %, C21 −10 %) | 0.40 (minimum (25 µF), L +20 %, C21 −10 %) |
| 4.4 V | 1.00 A | 6.0 kHz to 18.9 kHz | 71° (maximum plus modules (85 µF), L +20 %, C21 −10 %) | 20 dB (minimum (25 µF), L +20 %, C21 −10 %) | 0.50 (minimum (25 µF), L +20 %, C21 −10 %) |
| 4.4 V | 1.50 A | 5.9 kHz to 18.8 kHz | 73° (maximum plus modules (85 µF), L +20 %, C21 −10 %) | 17 dB (minimum (25 µF), L +20 %, C21 −10 %) | 0.75 (minimum (25 µF), L +20 %, C21 −10 %) |

- PASS: phase margin at least 45° in every corner (lowest 60° at 3.1 V, 0.05 A, maximum plus modules (85 µF), L +20 %, C21 −10 %)
- PASS: gain margin at least 10 dB in every corner (lowest 14 dB at 3.1 V, 1.50 A, minimum (25 µF), L +20 %, C21 −10 %)
- PASS: crossover below fSW/10 and RHPZ/5 in every corner up to 1.0 A (highest 0.72 of the limit at 3.1 V, 1.00 A, minimum (25 µF), L +20 %, C21 −10 %)
- Above 1.0 A (short-term headroom, not a design point): crossover up to 1.07 of the RHPZ/5 guideline at 3.1 V, 1.50 A, minimum (25 µF), L +20 %, C21 −10 %. The margins above already include these corners.

Values the data sheet procedure (Equations 18 to 20) would give for the highest allowed crossover, against the fitted 6.8 kΩ / 10 nF / 100 pF:

| Output capacitance | Operating point | Target crossover | R5 (R18) | C5 (C21) | C8 (C22) |
|---|---|---|---|---|---|
| minimum (25 µF) | 3.1 V / 1.5 A | 14.8 kHz | 7.6 kΩ | 5.6 nF | 3 pF |
| minimum (25 µF) | 3.1 V / 1.0 A | 22.3 kHz | 11.4 kΩ | 5.6 nF | 2 pF |
| minimum (25 µF) | 3.7 V / 0.8 A | 39.7 kHz | 17.0 kΩ | 4.7 nF | 1 pF |
| nominal (38 µF) | 3.1 V / 1.5 A | 14.8 kHz | 11.3 kΩ | 5.6 nF | 3 pF |
| nominal (38 µF) | 3.1 V / 1.0 A | 22.3 kHz | 16.9 kΩ | 5.6 nF | 2 pF |
| nominal (38 µF) | 3.7 V / 0.8 A | 39.7 kHz | 25.2 kΩ | 4.7 nF | 1 pF |

- Load step estimate at 3.7 V, nominal capacitance: a 0.8 A step moves the output by about ΔI / (2π · fc · COUT) = 311 mV (6.2 %) before the loop recovers. This is an estimate; the transient bench below simulates the steps.
- PASS: peak inductor current 3.20 A at 3.1 V / 1.5 A (L −20 %) stays below the worst-case current limit 4.54 A (R17 160 kΩ, typical 5.84 A) and the 7 A saturation current

## Boost switching ripple (ngspice, power/boost_ripple.cir)

Steady state, last 10 µs of each run. Ripple is read through a 20 MHz bandwidth limit as on an oscilloscope. The last column is the unfiltered swing at the capacitor node in the model. It is ringing near 1 GHz of the assumed 0.3 nH copper loop with the switch capacitance, damped only by the assumed 0.5 Ω. Its real amplitude depends on the layout and the IC, so it is a bench measurement, not a design value. It falls into the 1090 MHz band of the ADS-B receiver:

| VIN | IOUT | VOUT mean | BOOST_5V ripple | RAIL_5V ripple | VSYS ripple | L2 ripple / peak | Model edge ringing |
|---|---|---|---|---|---|---|---|
| 3.1 V | 0.2 A | 5.15 V | 7 mV | 6 mV | 2.9 mV | 0.80 A / 0.72 A | 1.3 V |
| 3.1 V | 0.8 A | 5.08 V | 14 mV | 12 mV | 2.4 mV | 0.79 A / 1.74 A | 2.1 V |
| 3.1 V | 1.5 A | 5.00 V | 28 mV | 23 mV | 2.8 mV | 0.79 A / 2.93 A | 2.6 V |
| 3.7 V | 0.2 A | 5.17 V | 5 mV | 4 mV | 2.2 mV | 0.67 A / 0.61 A | 1.3 V |
| 3.7 V | 0.8 A | 5.11 V | 13 mV | 11 mV | 2.7 mV | 0.69 A / 1.49 A | 3.4 V |
| 3.7 V | 1.5 A | 5.05 V | 20 mV | 16 mV | 2.3 mV | 0.67 A / 2.48 A | 2.4 V |
| 4.4 V | 0.2 A | 5.19 V | 4 mV | 4 mV | 1.5 mV | 0.43 A / 0.44 A | 1.7 V |
| 4.4 V | 0.8 A | 5.13 V | 7 mV | 7 mV | 1.7 mV | 0.44 A / 1.17 A | 2.8 V |
| 4.4 V | 1.5 A | 5.08 V | 11 mV | 10 mV | 1.7 mV | 0.44 A / 2.01 A | 2.8 V |

- PASS: output ripple at most 28 mV peak to peak (20 MHz), below 100 mV
- PASS: highest simulated inductor peak 2.93 A below the worst-case current limit 4.54 A

## Charger buck switching ripple on VSYS (ngspice, power/buck_ripple.cir)

5 V input, 0.75 MHz, L1 2.2 µH (FC-ALX4030D-2R2MT), VSYS capacitors 4 x 22 µF derated to 49 µF. The BQ25798 loop is internal and not modelled, so only the ripple is meaningful:

| VSYS | Load | VSYS ripple (20 MHz) | L1 ripple / peak |
|---|---|---|---|
| 3.5 V | 1.5 A | 2.5 mV | 0.65 A / 1.83 A |
| 3.5 V | 3.0 A | 3.7 mV | 0.64 A / 3.33 A |
| 4.2 V | 1.5 A | 4.3 mV | 0.41 A / 1.72 A |
| 4.2 V | 3.0 A | 2.2 mV | 0.40 A / 3.21 A |

- PASS: VSYS ripple at most 4.3 mV peak to peak, below 20 mV

## Start-up, load steps and shutdown (typical diode corner)

Averaged closed-loop model of the TPS61088: peak current command from COMP with the data sheet clamps, error amplifier 190 µA/V against the soft-start ramp, and the fitted R18 6.8 kΩ / C21 10 nF / C22 100 pF. The TPS22975 is a slew-controlled switch (C23 10 nF on CT: 17 ms rise per data sheet Table 1, 16 mΩ, 230 Ω discharge when off). U11/U12 feed separate ADSBee and display branches. The modules are a programmed current above 3 V behind 40 µF of total input capacitance and 20 mΩ of connector per branch. Output capacitance is 32 µF (C18 to C20 derated) plus 6 µF (C24), or 21 + 4 µF in the minimum corner. PWR_EN enables U6 and U7 together. Soft start: C17 47 nF at 5 µA, 11.3 ms to the 1.204 V reference. Switching ripple, the sampling poles and the inductor energy at shutdown are not in this model.

TPS259474L: the maximum corner uses an assumed 28.4 mV forward drop, not a guaranteed datasheet maximum.
TPS259474L typical corner: regulated forward drop 16.9 mV, on-resistance 28.20 mΩ; quasistatic reverse blocking with less than 0.6 mV of numerical diode drop. ADSBee (including GNSS) takes 84.0 % of the load and input capacitance, the display the rest, using the heat model's Wi-Fi-on split. C39/C38 add 100 nF each at the diode inputs. Minimum and maximum terminal figures are envelopes across both branches. The module capacitances and load split remain assumptions; diode switching delays, UVLO, startup slew, circuit-breaker operation and parasitics are not modelled.

Start-up from PWR_EN, the modules drawing their load as soon as the terminal passes 3 V:

| VIN | Load | BOOST_5V in regulation | Module terminal at 4.75 V | BOOST_5V overshoot | Terminal dip afterwards | Peak inductor current | VSYS minimum |
|---|---|---|---|---|---|---|---|
| 3.1 V | 0.1 A | 11.3 ms | 20.4 ms | +1 mV | 3 mV | 0.59 A | 3.09 V |
| 3.1 V | 0.8 A | 11.3 ms | 20.6 ms | -0 mV | 3 mV | 1.88 A | 3.06 V |
| 3.7 V | 0.1 A | 11.3 ms | 20.4 ms | -0 mV | 3 mV | 0.48 A | 3.69 V |
| 3.7 V | 0.8 A | 11.3 ms | 20.6 ms | -1 mV | 3 mV | 1.56 A | 3.66 V |
| 4.4 V | 0.1 A | 11.3 ms | 20.4 ms | -1 mV | 2 mV | 0.32 A | 4.40 V |
| 4.4 V | 0.8 A | 11.3 ms | 20.6 ms | -1 mV | 2 mV | 1.22 A | 4.37 V |

- PASS: start-up overshoot at most 1 mV, terminal below 5.25 V
- PASS: start-up peak inductor current 1.88 A below the worst-case current limit 4.54 A
- PASS: module terminal rises without a dip larger than 50 mV once above 4.75 V (largest 3 mV)
- The module terminal follows the TPS22975 slew (about 17 ms), not the 11.3 ms boost soft start. The terminal is ready 20.6 ms after PWR_EN at the latest.

Load steps at the module terminal (10 µs edges), from steady state, 10 ms apart:

| VIN | Capacitance | Step | Terminal minimum | Margin to 4.75 V | Settled (±1 %) | Terminal maximum | Settled (±1 %) | Peak inductor current |
|---|---|---|---|---|---|---|---|---|
| 3.1 V | nominal | 0.1 to 0.8 to 0.1 A | 4.809 V | 59 mV | 0.2 ms | 5.239 V | 0.2 ms | 2.07 A |
| 3.1 V | minimum | 0.1 to 0.8 to 0.1 A | 4.803 V | 53 mV | 0.2 ms | 5.246 V | 0.2 ms | 2.04 A |
| 3.7 V | nominal | 0.1 to 0.8 to 0.1 A | 4.836 V | 86 mV | 0.2 ms | 5.210 V | 0.2 ms | 1.70 A |
| 4.4 V | nominal | 0.1 to 0.8 to 0.1 A | 4.861 V | 111 mV | 0.2 ms | 5.186 V | 0.1 ms | 1.32 A |
| 3.1 V | nominal | 0.8 to 1.0 to 0.8 A | 4.940 V | 190 mV | 0.1 ms | 5.078 V | 0.1 ms | 2.29 A |
| 3.1 V | minimum | 0.8 to 1.0 to 0.8 A | 4.938 V | 188 mV | 0.1 ms | 5.079 V | 0.1 ms | 2.28 A |
| 3.7 V | nominal | 0.8 to 1.0 to 0.8 A | 4.948 V | 198 mV | 0.1 ms | 5.070 V | 0.0 ms | 1.89 A |

- PASS: terminal stays above 4.75 V through the steps between 0.1 and 0.8 A and between 0.8 and 1 A (lowest 4.803 V, margin 53 mV)
- PASS: terminal stays below 5.5 V on load release (highest 5.25 V; inside the 5.25 V USB window by 4 mV)
- PASS: peak inductor current 2.29 A during the steps below the worst-case current limit 4.54 A
- PASS: settled within ±1 % in at most 0.2 ms

1.5 A pulses from 0.8 A (short-term headroom), with the typical and the worst-case current limit:

| VIN | Capacitance | Pulse | Current limit | Terminal minimum | Terminal at pulse end | Peak inductor current | VSYS minimum | Maximum after release | Settled (±1 %) |
|---|---|---|---|---|---|---|---|---|---|
| 3.1 V | nominal | 1 ms | 5.84 A | 4.774 V | 4.98 V | 3.35 A | 3.01 V | 5.22 V | 0.2 ms |
| 3.1 V | nominal | 10 ms | 5.84 A | 4.774 V | 4.98 V | 3.35 A | 3.01 V | 5.22 V | 0.2 ms |
| 3.1 V | minimum | 10 ms | 5.84 A | 4.768 V | 4.98 V | 3.32 A | 3.01 V | 5.23 V | 0.2 ms |
| 3.1 V | minimum | 10 ms | 4.54 A | 4.768 V | 4.98 V | 3.32 A | 3.01 V | 5.23 V | 0.2 ms |
| 3.7 V | nominal | 10 ms | 5.84 A | 4.800 V | 4.98 V | 2.76 A | 3.63 V | 5.19 V | 0.2 ms |
| 4.4 V | nominal | 10 ms | 5.84 A | 4.824 V | 4.98 V | 2.21 A | 4.34 V | 5.17 V | 0.1 ms |

- PASS: terminal stays above 4.50 V during the 1.5 A pulses (lowest 4.768 V)
- PASS: terminal stays below 5.5 V after the pulses (highest 5.23 V)
- PASS: the current limit does not engage during the pulses

Shutdown: PWR_EN low at 30 ms, U7 opens and discharges the rail through 230 Ω, U6 stops:

| VIN | Load before | Terminal below 2.53 V | Terminal below 0.5 V | Terminal minimum | BOOST_5V 15 ms later |
|---|---|---|---|---|---|
| 3.7 V | 0.8 A | 0.1 ms | 0.4 ms | -0.00 V | 5.04 V |
| 3.7 V | 0.1 A | 1.0 ms | 3.0 ms | 0.00 V | 5.05 V |

- PASS: module terminal below 0.5 V within 3.0 ms of PWR_EN falling
- PASS: no negative excursion at the module terminal
- BOOST_5V stays charged behind the open switch; only the 315 kΩ divider discharges it, over seconds. U11/U12 block the module capacitors from U7 discharge; the programmed module loads discharge them. Not modelled: the inductor energy dumped into COUT when switching stops. It is about L I² / 2 = 2.5 µJ at 0.8 A load (1.5 A in the inductor), which raises 32 µF by under 15 mV.

## Start-up, load steps and shutdown (maximum diode corner)

Averaged closed-loop model of the TPS61088: peak current command from COMP with the data sheet clamps, error amplifier 190 µA/V against the soft-start ramp, and the fitted R18 6.8 kΩ / C21 10 nF / C22 100 pF. The TPS22975 is a slew-controlled switch (C23 10 nF on CT: 17 ms rise per data sheet Table 1, 16 mΩ, 230 Ω discharge when off). U11/U12 feed separate ADSBee and display branches. The modules are a programmed current above 3 V behind 40 µF of total input capacitance and 20 mΩ of connector per branch. Output capacitance is 32 µF (C18 to C20 derated) plus 6 µF (C24), or 21 + 4 µF in the minimum corner. PWR_EN enables U6 and U7 together. Soft start: C17 47 nF at 5 µA, 11.3 ms to the 1.204 V reference. Switching ripple, the sampling poles and the inductor energy at shutdown are not in this model.

TPS259474L: the maximum corner uses an assumed 28.4 mV forward drop, not a guaranteed datasheet maximum.
TPS259474L maximum corner: regulated forward drop 28.4 mV, on-resistance 45.00 mΩ; quasistatic reverse blocking with less than 0.6 mV of numerical diode drop. ADSBee (including GNSS) takes 84.0 % of the load and input capacitance, the display the rest, using the heat model's Wi-Fi-on split. C39/C38 add 100 nF each at the diode inputs. Minimum and maximum terminal figures are envelopes across both branches. The module capacitances and load split remain assumptions; diode switching delays, UVLO, startup slew, circuit-breaker operation and parasitics are not modelled.

Start-up from PWR_EN, the modules drawing their load as soon as the terminal passes 3 V:

| VIN | Load | BOOST_5V in regulation | Module terminal at 4.75 V | BOOST_5V overshoot | Terminal dip afterwards | Peak inductor current | VSYS minimum |
|---|---|---|---|---|---|---|---|
| 3.1 V | 0.1 A | 11.3 ms | 20.4 ms | +1 mV | 3 mV | 0.59 A | 3.09 V |
| 3.1 V | 0.8 A | 11.3 ms | 20.6 ms | -0 mV | 3 mV | 1.88 A | 3.06 V |
| 3.7 V | 0.1 A | 11.3 ms | 20.4 ms | -0 mV | 3 mV | 0.48 A | 3.69 V |
| 3.7 V | 0.8 A | 11.3 ms | 20.6 ms | -1 mV | 3 mV | 1.56 A | 3.66 V |
| 4.4 V | 0.1 A | 11.3 ms | 20.4 ms | -1 mV | 2 mV | 0.32 A | 4.40 V |
| 4.4 V | 0.8 A | 11.3 ms | 20.6 ms | -1 mV | 2 mV | 1.22 A | 4.37 V |

- PASS: start-up overshoot at most 1 mV, terminal below 5.25 V
- PASS: start-up peak inductor current 1.88 A below the worst-case current limit 4.54 A
- PASS: module terminal rises without a dip larger than 50 mV once above 4.75 V (largest 3 mV)
- The module terminal follows the TPS22975 slew (about 17 ms), not the 11.3 ms boost soft start. The terminal is ready 20.6 ms after PWR_EN at the latest.

Load steps at the module terminal (10 µs edges), from steady state, 10 ms apart:

| VIN | Capacitance | Step | Terminal minimum | Margin to 4.75 V | Settled (±1 %) | Terminal maximum | Settled (±1 %) | Peak inductor current |
|---|---|---|---|---|---|---|---|---|
| 3.1 V | nominal | 0.1 to 0.8 to 0.1 A | 4.798 V | 48 mV | 0.2 ms | 5.228 V | 0.2 ms | 2.06 A |
| 3.1 V | minimum | 0.1 to 0.8 to 0.1 A | 4.792 V | 42 mV | 0.2 ms | 5.234 V | 0.2 ms | 2.04 A |
| 3.7 V | nominal | 0.1 to 0.8 to 0.1 A | 4.825 V | 75 mV | 0.2 ms | 5.199 V | 0.2 ms | 1.70 A |
| 4.4 V | nominal | 0.1 to 0.8 to 0.1 A | 4.850 V | 100 mV | 0.2 ms | 5.174 V | 0.1 ms | 1.32 A |
| 3.1 V | nominal | 0.8 to 1.0 to 0.8 A | 4.926 V | 176 mV | 0.1 ms | 5.066 V | 0.1 ms | 2.29 A |
| 3.1 V | minimum | 0.8 to 1.0 to 0.8 A | 4.924 V | 174 mV | 0.1 ms | 5.068 V | 0.1 ms | 2.28 A |
| 3.7 V | nominal | 0.8 to 1.0 to 0.8 A | 4.934 V | 184 mV | 0.1 ms | 5.058 V | 0.0 ms | 1.89 A |

- PASS: terminal stays above 4.75 V through the steps between 0.1 and 0.8 A and between 0.8 and 1 A (lowest 4.792 V, margin 42 mV)
- PASS: terminal stays below 5.5 V on load release (highest 5.23 V; inside the 5.25 V USB window by 16 mV)
- PASS: peak inductor current 2.29 A during the steps below the worst-case current limit 4.54 A
- PASS: settled within ±1 % in at most 0.2 ms

1.5 A pulses from 0.8 A (short-term headroom), with the typical and the worst-case current limit:

| VIN | Capacitance | Pulse | Current limit | Terminal minimum | Terminal at pulse end | Peak inductor current | VSYS minimum | Maximum after release | Settled (±1 %) |
|---|---|---|---|---|---|---|---|---|---|
| 3.1 V | nominal | 1 ms | 5.84 A | 4.753 V | 4.96 V | 3.35 A | 3.01 V | 5.21 V | 0.2 ms |
| 3.1 V | nominal | 10 ms | 5.84 A | 4.753 V | 4.96 V | 3.35 A | 3.01 V | 5.21 V | 0.2 ms |
| 3.1 V | minimum | 10 ms | 5.84 A | 4.747 V | 4.96 V | 3.32 A | 3.01 V | 5.21 V | 0.2 ms |
| 3.1 V | minimum | 10 ms | 4.54 A | 4.747 V | 4.96 V | 3.32 A | 3.01 V | 5.21 V | 0.2 ms |
| 3.7 V | nominal | 10 ms | 5.84 A | 4.780 V | 4.96 V | 2.76 A | 3.63 V | 5.18 V | 0.2 ms |
| 4.4 V | nominal | 10 ms | 5.84 A | 4.804 V | 4.96 V | 2.21 A | 4.34 V | 5.16 V | 0.1 ms |

- PASS: terminal stays above 4.50 V during the 1.5 A pulses (lowest 4.747 V)
- PASS: terminal stays below 5.5 V after the pulses (highest 5.21 V)
- PASS: the current limit does not engage during the pulses

Shutdown: PWR_EN low at 30 ms, U7 opens and discharges the rail through 230 Ω, U6 stops:

| VIN | Load before | Terminal below 2.53 V | Terminal below 0.5 V | Terminal minimum | BOOST_5V 15 ms later |
|---|---|---|---|---|---|
| 3.7 V | 0.8 A | 0.1 ms | 0.4 ms | -0.00 V | 5.05 V |
| 3.7 V | 0.1 A | 1.0 ms | 3.0 ms | 0.00 V | 5.05 V |

- PASS: module terminal below 0.5 V within 3.0 ms of PWR_EN falling
- PASS: no negative excursion at the module terminal
- BOOST_5V stays charged behind the open switch; only the 315 kΩ divider discharges it, over seconds. U11/U12 block the module capacitors from U7 discharge; the programmed module loads discharge them. Not modelled: the inductor energy dumped into COUT when switching stops. It is about L I² / 2 = 2.5 µJ at 0.8 A load (1.5 A in the inductor), which raises 32 µF by under 15 mV.

## Undervoltage cut-off, rebound and restart (ngspice, power/undervoltage.cir)
U11/U12 use the maximum diode-drop corner and the same separate module branches as the transient bench. Module readiness requires both terminals above 4.75 V.

The battery is an open-circuit voltage behind the pack resistance and the harness. Then follow the BQ25798 BATT-to-SYS switch (11 mΩ) and the board copper (18 mΩ from the routed tracks, J3 to L2). The TLV840 on VSYS (VIT− 2.9 V, hysteresis 72 mV, 145 mV, 203 mV, 30 µs propagation, 40 µs reset delay with CT open) pulls PWR_EN low against R13 100 kΩ. R13 is fed from VSYS through R43 1 kΩ, the closed thermostat and the closed slider. The boost, load switch and modules are those of the transient bench. The open-circuit voltage ramps from 3.30 to 2.95 V in 400 ms, holds, then ramps back to 3.30 V (restore). The ramp stands for a discharge; it is fast only against the electrical time constants. The thermal bench holds the supervisor released; this one does not.

Voltage the load drops across the path at the trip point against the hysteresis. When the drop exceeds the hysteresis, cutting the load lifts VSYS above the release threshold and the supervisor restarts the system:

| Load | Path resistance | Path current at 2.9 V | Drop I·R | Hysteresis 2.5 % (minimum) | Hysteresis 5 % (typical) | Hysteresis 7 % (maximum) |
|---|---|---|---|---|---|---|
| Wi-Fi off 0.23 A | pack 50 + harness 60 mΩ | 0.45 A | 63 mV | clean | clean | clean |
| Wi-Fi off 0.23 A | pack 100 + harness 60 mΩ | 0.45 A | 85 mV | chatter | clean | clean |
| Wi-Fi off 0.23 A | pack 150 + harness 100 mΩ | 0.45 A | 125 mV | chatter | clean | clean |
| nominal 0.80 A | pack 50 + harness 60 mΩ | 1.55 A | 219 mV | chatter | chatter | chatter |
| nominal 0.80 A | pack 100 + harness 60 mΩ | 1.55 A | 296 mV | chatter | chatter | chatter |
| nominal 0.80 A | pack 150 + harness 100 mΩ | 1.55 A | 436 mV | chatter | chatter | chatter |
| peak 1.00 A | pack 50 + harness 60 mΩ | 1.94 A | 274 mV | chatter | chatter | chatter |
| peak 1.00 A | pack 100 + harness 60 mΩ | 1.94 A | 371 mV | chatter | chatter | chatter |
| peak 1.00 A | pack 150 + harness 100 mΩ | 1.94 A | 545 mV | chatter | chatter | chatter |

Simulated discharge and restore ramps, PWR_EN counted through 1.2 V:

| Load | Path resistance | Hysteresis | Trips while discharging | Open-circuit voltage band of the trips | Cycle | On-time in the band | Trips while restoring | VSYS minimum |
|---|---|---|---|---|---|---|---|---|
| nominal | pack 100 + harness 60 mΩ | 5 % (typical) | 17 | 3.196 to 3.043 V | 10.9 ms | 99 % | 15 | 2.87 V |
| nominal | pack 150 + harness 100 mΩ | 2.5 % (minimum) | 44 | 3.300 to 2.971 V | 8.9 ms | 99 % | 48 | 2.86 V |
| nominal | pack 50 + harness 60 mΩ | 7 % (maximum) | 3 | 3.118 to 3.095 V | 13.2 ms | 99 % | 1 | 2.89 V |
| Wi-Fi off | pack 100 + harness 60 mΩ | 5 % (typical) | 1 | 2.985 to 2.985 V | none | none | 0 | 2.90 V |
| Wi-Fi off | pack 150 + harness 100 mΩ | 2.5 % (minimum) | 7 | 3.025 to 2.969 V | 10.6 ms | 99 % | 5 | 2.89 V |
| peak | pack 100 + harness 60 mΩ | 5 % (typical) | 26 | 3.270 to 3.041 V | 10.5 ms | 99 % | 24 | 2.87 V |

- Without the latch: cycling at nominal load, pack 100 + harness 60 mΩ, hysteresis 5 % (typical): 16 restarts; nominal load, pack 150 + harness 100 mΩ, hysteresis 2.5 % (minimum): 43 restarts; nominal load, pack 50 + harness 60 mΩ, hysteresis 7 % (maximum): 2 restarts; Wi-Fi off load, pack 150 + harness 100 mΩ, hysteresis 2.5 % (minimum): 6 restarts; peak load, pack 100 + harness 60 mΩ, hysteresis 5 % (typical): 25 restarts.
- PASS: the supervisor cuts the load before VSYS reaches the boost UVLO (2.4 V)
- Duration estimate for the nominal case: the trips span 152 mV of open-circuit voltage. The pack is assumed to lose about 1.0 V per Ah near 3 V, and the average path current while cycling is roughly 0.77 A. That gives about 12 minutes of restarts every 10.9 ms at the end of every discharge.

1.5 A burst from the nominal load with the open-circuit voltage held just above the band (band top 3.20 V for the typical path), typical hysteresis:

| Open-circuit voltage | Burst | VSYS minimum | Trips | PWR_EN low for | Module terminal back at 4.75 V after burst start |
|---|---|---|---|---|---|
| 3.23 V | 10 ms | 2.56 V | 1 | 0.1 ms | 22.3 ms |
| 3.30 V | 10 ms | 2.66 V | 1 | 0.1 ms | 22.3 ms |
| 3.23 V | 1 ms | 2.56 V | 1 | 0.1 ms | 22.3 ms |

- PASS: a load burst near cut-off causes at most one shutdown and restart (most: 1)

The same discharge and restore with a larger hysteresis (a comparator with external hysteresis, or a latch, in place of the fixed 5 %), nominal load, worst-case path:

| Hysteresis | Trips while discharging | Trips while restoring |
|---|---|---|
| 300 mV | 8 | 7 |
| 400 mV | 3 | 1 |
| 500 mV | 1 | 0 |

With the latch fitted (Q7 AO3401A from the R40/C37 delayed hold supply, Q8 2N7002 on PWR_EN, R41 100 kΩ bleed), same discharge and restore, then the burst case and Q8 at its maximum threshold:

| Load | Path resistance | Hysteresis | Trips | Restarts | Open-circuit voltage at the trip | PWR_EN at the end (voltage restored) |
|---|---|---|---|---|---|---|
| nominal | pack 100 + harness 60 mΩ | 5 % (typical) | 1 | 0 | 3.196 V | 0.00 V |
| nominal | pack 150 + harness 100 mΩ | 2.5 % (minimum) | 1 | 0 | 3.300 V | 0.00 V |
| peak | pack 100 + harness 60 mΩ | 5 % (typical) | 1 | 0 | 3.270 V | 0.00 V |
| nominal, 1.5 A burst at 3.23 V | pack 100 + harness 60 mΩ | 5 % (typical) | 1 | 0 | 3.226 V | 0.00 V |
| nominal, Q8 VGS(th) 2.5 V (max) | pack 150 + harness 100 mΩ | 2.5 % (minimum) | 1 | 0 | 3.300 V | 0.00 V |

- PASS: with the latch: at most one shutdown per discharge and no restart until the slider is cycled (trips 1, restarts 0)
- The cycling is set by the drop I·R across pack, harness and switch against the fixed 5 % hysteresis. The reset delay (CT, 6.2 ms per 10 nF) only stretches the off time of each cycle. Every trip drops the rail through the 230 Ω discharge, so each cycle is a module reboot. The pack's own protection cuts at 2.5 V ± 0.1 V, below all of this.

## Switch-node coupling on the board

For each sensitive net: the edge-to-edge distance from the switch-node copper (pads and tracks) and the length of victim track within 0.6 mm. Then the coplanar coupling capacitance for that length (0.2 mm minimum) and the spike it injects into a 5 pF node at a full switch-node edge:

| Aggressor | Victim | Gap | Parallel run | Coupling | Injected spike |
|---|---|---|---|---|---|
| BOOST_SW | BOOST_FB | 2.76 mm | 0.0 mm | 0.004 pF | 4 mV |
| BOOST_SW | BOOST_COMP | 2.80 mm | 0.0 mm | 0.004 pF | 4 mV |
| BOOST_SW | BOOST_SS | 1.03 mm | 0.0 mm | 0.005 pF | 5 mV |
| BOOST_SW | BOOST_ILIM | 2.90 mm | 0.0 mm | 0.004 pF | 4 mV |
| BOOST_SW | I2C_SDA | 3.15 mm | 0.0 mm | 0.004 pF | 4 mV |
| BOOST_SW | I2C_SCL | 3.78 mm | 0.0 mm | 0.003 pF | 4 mV |
| CHG_SW1 | BAT_TS | 1.96 mm | 0.0 mm | 0.004 pF | 4 mV |
| CHG_SW1 | CHG_PROG | 1.72 mm | 0.0 mm | 0.004 pF | 4 mV |
| CHG_SW1 | CHG_ILIM | 1.63 mm | 0.0 mm | 0.004 pF | 4 mV |
| CHG_SW1 | CHG_REGN | 0.28 mm | 0.1 mm | 0.007 pF | 7 mV |
| CHG_SW1 | THERM_OK | 1.66 mm | 0.0 mm | 0.004 pF | 4 mV |
| CHG_SW1 | CHG_DIS | -0.47 mm | 6.9 mm | 0.318 pF | 299 mV |
| CHG_SW1 | I2C_SDA | 1.14 mm | 0.0 mm | 0.005 pF | 5 mV |
| CHG_SW1 | I2C_SCL | 0.84 mm | 0.0 mm | 0.005 pF | 5 mV |
| CHG_SW2 | BAT_TS | 0.71 mm | 0.0 mm | 0.005 pF | 5 mV |
| CHG_SW2 | CHG_PROG | 0.29 mm | 0.1 mm | 0.007 pF | 7 mV |
| CHG_SW2 | CHG_ILIM | 0.24 mm | 0.1 mm | 0.007 pF | 7 mV |
| CHG_SW2 | CHG_REGN | 1.69 mm | 0.0 mm | 0.004 pF | 4 mV |
| CHG_SW2 | THERM_OK | 2.60 mm | 0.0 mm | 0.004 pF | 4 mV |
| CHG_SW2 | CHG_DIS | 0.53 mm | 0.0 mm | 0.006 pF | 6 mV |
| CHG_SW2 | I2C_SDA | 0.53 mm | 0.0 mm | 0.006 pF | 6 mV |
| CHG_SW2 | I2C_SCL | 0.53 mm | 0.0 mm | 0.006 pF | 6 mV |

- PASS: spike into BOOST_FB at most 3.8 mV, below 1 % of the 1.204 V reference

Centre distances from the two switching inductors (both magnetically shielded, molded):

| Part | from L1 (charger, 2.2 µH) | from L2 (boost, 2.2 µH) |
|---|---|---|
| J2 thermistor connector | 14 mm | 33 mm |
| J4 thermostat connector | 21 mm | 42 mm |
| U4 charger | 10 mm | 19 mm |
| R14 boost feedback divider | 32 mm | 11 mm |
| U6 boost | 29 mm | 7 mm |
| U8 gauge | 24 mm | 29 mm |
| J10 ADSBee socket | 46 mm | 25 mm |
| J9 display socket | 29 mm | 38 mm |
| J1 USB-C | 27 mm | 22 mm |

Magnetic pickup bound at the real centre distances (dipole field of the ripple current, 5 turns of 10 mm², 10 % leakage of the shielded core; L1 0.5 A at 0.8 MHz, L2 0.77 A at 709 kHz and 3.1 V in):

| Victim | Source | Distance | EMF peak |
|---|---|---|---|
| thermistor lead pair at J2, untwisted, 500 mm² loop | L1 | 14 mm | 0.134 mV |
| thermistor lead pair at J2, untwisted, 500 mm² loop | L2 | 33 mm | 0.016 mV |
| boost feedback divider, 10 mm² loop | L1 | 32 mm | 0.000 mV |
| boost feedback divider, 10 mm² loop | L2 | 11 mm | 0.009 mV |
| L2 winding (from L1) | L1 | 22 mm | 0.004 mV |
| L1 winding (from L2) | L2 | 22 mm | 0.005 mV |

- PASS: magnetic pickup into the THM network at most 0.13 mV, below 10 % of the 27 mV threshold spacing
- PASS: magnetic pickup into the boost feedback divider at most 0.01 mV, below 1 % of the 1.204 V reference
- L1 and L2: each winding picks up an EMF from the other, which adds to its own ripple. The two switching frequencies differ, so it shows as a beat on VSYS. The bound is for the axial direction, the worst case.

Result: all checks pass.
