mp911de/airgrep/hardware/sim/thermal/results_max.md

# Thermal charge cut-off, simulation results

Generated by `hardware/sim/run_thermal.py` with ngspice-47 for the carrier-max-charger board (charger MAX77757). The charger is represented by its data sheet THM thresholds, see `hardware/sim/README.md`.

## FET models against their data sheet points

| FET | VGS(th) data sheet | Model gate voltage at 250 µA | Subthreshold swing |
|---|---|---|---|
| Q2 AO3401A | 0.50 V | 0.500 V | 90 mV/decade |
| Q2 AO3401A | 0.90 V | 0.900 V | 90 mV/decade |
| Q2 AO3401A | 1.30 V | 1.300 V | 90 mV/decade |
| Q6 2N7002 | 1.00 V | 1.000 V | 90 mV/decade |
| Q6 2N7002 | 2.00 V | 2.000 V | 90 mV/decade |
| Q6 2N7002 | 2.50 V | 2.500 V | 90 mV/decade |

- PASS: models carry 250 µA within 10 mV of the data sheet threshold, swing 90 mV/decade (assumed, not a data sheet value)

## JEITA window from the thermistor divider

Nominal parts, typical thresholds, no leakage:

| Transition | THM/PVL | Acts at | Releases at | docs/power.md |
|---|---|---|---|---|
| cold (charging stops below) | 74.0 % | −2.9 °C | −2.1 °C | −2.9 °C |
| cool (half current below) | 65.0 % | 4.6 °C | 5.4 °C | 4.6 °C |
| warm (4.05 V termination above) | 32.5 % | 31.4 °C | 30.4 °C | 31.4 °C |
| hot (charging stops above) | 23.0 % | 42.1 °C | 40.8 °C | 42.1 °C |

- PASS: nominal transitions match docs/power.md within 0.1 °C

Worst case in °C. Parts and thresholds: thermistor ±0.2 K and B ±0.5 %, bias resistor ±1 %, charger thresholds at their data sheet minimum and maximum. Leakage: THM pin 0.1 µA typical and 1 µA maximum, Q6 off-state 10 nA typical and 1 µA maximum.

| Transition | Nominal | Parts and thresholds | plus typical leakage | plus maximum leakage |
|---|---|---|---|---|
| cold | −2.9 | −4.8 to −1.1 | −5.5 to −0.6 | −24.1 to 3.6 |
| cool | 4.6 | 2.9 to 6.2 | 2.4 to 6.7 | −9.6 to 10.1 |
| warm | 31.4 | 29.5 to 33.3 | 29.2 to 33.6 | 23.1 to 35.9 |
| hot | 42.1 | 39.7 to 44.7 | 39.4 to 45.0 | 33.9 to 47.2 |

- PASS: hot cut-off at most 45.0 °C with typical leakage, within the pack's 45.0 °C charge rating
- Cold cut-off: −5.5 to −0.6 °C with typical leakage against the pack's 0.0 °C rating. Accepted, the window width follows from the thermistor's B value (docs/power.md).
- With leakage at the data sheet maximum: charging up to 47.2 °C and down to −24.1 °C.

Leakage alone, nominal parts and typical thresholds, °C. Positive current flows out of the THM node to ground (THM pin or Q6 drain), negative current into it. The THM pin is specified at 0.1 µA typical, 1 µA maximum:

| THM node leakage | cold | cool | warm | hot |
|---|---|---|---|---|
| −1.0 µA | 2.0 | 8.6 | 34.0 | 44.6 |
| −0.1 µA | −2.4 | 5.0 | 31.6 | 42.4 |
| +0.1 µA | −3.5 | 4.1 | 31.1 | 41.9 |
| +1.0 µA | −9.6 | −0.4 | 28.5 | 39.4 |
| +2.0 µA | −20.2 | −7.1 | 25.1 | 36.4 |

Monte Carlo, 400 units, seed 1, °C. Every tolerance is uniform over its full range: thermistor ±0.2 K and B ±0.5 %, bias ±1 %, thresholds between minimum and maximum. THM leakage is within the typical ±0.1 µA, Q6 leakage is the typical 10 nA.

| Transition | Lowest | 1 % | Median | 99 % | Highest |
|---|---|---|---|---|---|
| cold | −5.1 | −4.8 | −3.0 | −1.4 | −1.0 |
| cool | 2.9 | 3.1 | 4.5 | 6.0 | 6.2 |
| warm | 29.5 | 29.7 | 31.4 | 33.0 | 33.3 |
| hot | 40.0 | 40.0 | 42.2 | 44.3 | 44.4 |

- Units that still charge above 45.0 °C: 0 %. Units that still charge below 0.0 °C: 100 %.

## Thermistor unplugged or shorted

- PASS: unplugged: THM/PVL = 82.9 % with 2 µA leakage pulling down, above the highest cold threshold (75.5 %), charging suspended
- PASS: shorted: THM/PVL = 0.02 %, below the lowest disable threshold (4.5 %), charger disabled

## Thermostat closed: Q2 leakage into R12

With the thermostat closed Q2 is off and only R12 holds the Q6 gate (CHG_DIS) low. Q2 off-state leakage raises that gate. The AO3401A data sheet allows 1 µA at 25 °C and 5 µA at 55 °C at VDS = −30 V. At the 3 to 4.4 V present here it is normally far lower. The 1000 kΩ rows show why R12 is not larger. Typical charger thresholds, nominal thermistor:

| Q2 IDSS | R12 | Q6 VGS(th) | CHG_DIS | THM/PVL shift at 25 °C | Charging window |
|---|---|---|---|---|---|
| 0.1 µA | 100 kΩ | 1.0 V | 0.01 V | 0.00 % | −2.9 to 42.1 °C |
| 0.5 µA | 100 kΩ | 1.0 V | 0.05 V | 0.00 % | −2.9 to 42.1 °C |
| 1.0 µA | 100 kΩ | 1.0 V | 0.10 V | 0.00 % | −2.9 to 42.1 °C |
| 5.0 µA | 100 kΩ | 1.0 V | 0.50 V | 0.00 % | −2.9 to 42.1 °C |
| 0.1 µA | 100 kΩ | 2.0 V | 0.01 V | 0.00 % | −2.9 to 42.1 °C |
| 0.5 µA | 100 kΩ | 2.0 V | 0.05 V | 0.00 % | −2.9 to 42.1 °C |
| 1.0 µA | 100 kΩ | 2.0 V | 0.10 V | 0.00 % | −2.9 to 42.1 °C |
| 5.0 µA | 100 kΩ | 2.0 V | 0.50 V | 0.00 % | −2.9 to 42.1 °C |
| 0.5 µA | 1000 kΩ | 1.0 V | 0.50 V | 0.00 % | −2.9 to 42.1 °C |
| 1.0 µA | 1000 kΩ | 1.0 V | 1.00 V | −39.30 % | blocked at every temperature |
| 5.0 µA | 1000 kΩ | 1.0 V | 4.09 V | −39.37 % | blocked at every temperature |

- PASS: Q2 leakage at the data sheet maximum (1 µA, 25 °C) with Q6 at minimum VGS(th) moves THM/PVL by 0.00 % (limit 0.5 % of PVL, about 0.5 °C)
- PASS: Q2 leakage at the data sheet maximum (5 µA, 55 °C) with Q6 at minimum VGS(th) moves THM/PVL by 0.00 % (limit 0.5 % of PVL, about 0.5 °C)

## Thermostat opens and closes

24 corners: VSYS 3.0 / 3.5 / 4.4 V, Q2 and Q6 at minimum and maximum VGS(th), thermistor at 0 and 40 °C, slider on.

- PASS: open: THM/PVL at most 0.008 %, below the lowest disable threshold (4.5 %), charger disabled
- PASS: open: PWR_EN at most 0.002 V, below 0.4 V, boost and load switch off
- PASS: closed: PWR_EN at least 2.66 V (R43 and R13 against the 800 kΩ EN pull-down), above 1.2 V

| After the contact opens | Delay |
|---|---|
| THM below 4.5 % (charger disabled) | 4.0 to 24.5 ms |
| PWR_EN below 1.2 V (loads may switch off) | 38.0 to 56.3 ms |
| PWR_EN below 0.4 V (loads off) | 90.5 to 108.8 ms |
| PWR_EN between 1.2 and 0.4 V (either IC may be on or off) | 52.5 ms |

| After the contact closes | Delay |
|---|---|
| THM back within 0.5 % of PVL (charging resumes) | 0.1 to 0.3 ms |
| PWR_EN above 1.2 V (loads on) | 0.0 to 0.1 ms |

Result: all checks pass.
