mp911de/airgrep/hardware/sim/power/results.md

# Power converters, simulation results

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

## TPS61088 boost loop

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

Nominal parts (L2 2.2 µH, C21 10 nF, output capacitance 38 µF):

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

## Boost switching ripple (ngspice, power/boost_ripple.cir)

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

## Charger buck switching ripple on VSYS (ngspice, power/buck_ripple.cir)

5 V input, 1.3 MHz, L1 1 µH, VSYS capacitors 4 x 22 µF derated to 49 µF. The MAX77757 loop is internal and not modelled, so only the ripple is meaningful:

| VSYS | Load | VSYS ripple (20 MHz) | L1 ripple / peak |
|---|---|---|---|
| 3.5 V | 1.5 A | 3.2 mV | 0.82 A / 1.92 A |
| 3.5 V | 3.0 A | 3.4 mV | 0.83 A / 3.42 A |
| 4.2 V | 1.5 A | 1.3 mV | 0.53 A / 1.76 A |
| 4.2 V | 3.0 A | 8.4 mV | 0.56 A / 3.30 A |

- PASS: VSYS ripple at most 8.4 mV peak to peak, below 20 mV

## Start-up, load steps and shutdown (typical diode corner)

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

Load steps at the module terminal (10 µs edges), from steady state, 10 ms apart:

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

## Start-up, load steps and shutdown (maximum diode corner)

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

Load steps at the module terminal (10 µs edges), from steady state, 10 ms apart:

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

| Load | Path resistance | Path current at 2.9 V | Drop I·R | Hysteresis 2.5 % (minimum) | Hysteresis 5 % (typical) | Hysteresis 7 % (maximum) |
|---|---|---|---|---|---|---|
| Wi-Fi off 0.23 A | pack 50 + harness 60 mΩ | 0.45 A | 63 mV | clean | clean | clean |
| Wi-Fi off 0.23 A | pack 100 + harness 60 mΩ | 0.45 A | 86 mV | chatter | clean | clean |
| Wi-Fi off 0.23 A | pack 150 + harness 100 mΩ | 0.45 A | 126 mV | chatter | clean | clean |
| nominal 0.80 A | pack 50 + harness 60 mΩ | 1.55 A | 220 mV | chatter | chatter | chatter |
| nominal 0.80 A | pack 100 + harness 60 mΩ | 1.55 A | 298 mV | chatter | chatter | chatter |
| nominal 0.80 A | pack 150 + harness 100 mΩ | 1.55 A | 437 mV | chatter | chatter | chatter |
| peak 1.00 A | pack 50 + harness 60 mΩ | 1.94 A | 275 mV | chatter | chatter | chatter |
| peak 1.00 A | pack 100 + harness 60 mΩ | 1.94 A | 372 mV | chatter | chatter | chatter |
| peak 1.00 A | pack 150 + harness 100 mΩ | 1.94 A | 547 mV | chatter | chatter | chatter |

Simulated discharge and restore ramps, PWR_EN counted through 1.2 V:

| Load | Path resistance | Hysteresis | Trips while discharging | Open-circuit voltage band of the trips | Cycle | On-time in the band | Trips while restoring | VSYS minimum |
|---|---|---|---|---|---|---|---|---|
| nominal | pack 100 + harness 60 mΩ | 5 % (typical) | 17 | 3.197 to 3.045 V | 10.9 ms | 99 % | 15 | 2.87 V |
| nominal | pack 150 + harness 100 mΩ | 2.5 % (minimum) | 44 | 3.300 to 2.972 V | 8.8 ms | 99 % | 48 | 2.86 V |
| nominal | pack 50 + harness 60 mΩ | 7 % (maximum) | 3 | 3.120 to 3.096 V | 13.3 ms | 99 % | 1 | 2.89 V |
| Wi-Fi off | pack 100 + harness 60 mΩ | 5 % (typical) | 1 | 2.985 to 2.985 V | none | none | 0 | 2.90 V |
| Wi-Fi off | pack 150 + harness 100 mΩ | 2.5 % (minimum) | 7 | 3.025 to 2.969 V | 10.6 ms | 99 % | 5 | 2.89 V |
| peak | pack 100 + harness 60 mΩ | 5 % (typical) | 26 | 3.271 to 3.042 V | 10.5 ms | 99 % | 24 | 2.87 V |

- Without the latch: cycling at nominal load, pack 100 + harness 60 mΩ, hysteresis 5 % (typical): 16 restarts; nominal load, pack 150 + harness 100 mΩ, hysteresis 2.5 % (minimum): 43 restarts; nominal load, pack 50 + harness 60 mΩ, hysteresis 7 % (maximum): 2 restarts; Wi-Fi off load, pack 150 + harness 100 mΩ, hysteresis 2.5 % (minimum): 6 restarts; peak load, pack 100 + harness 60 mΩ, hysteresis 5 % (typical): 25 restarts.
- PASS: the supervisor cuts the load before VSYS reaches the boost UVLO (2.4 V)
- Duration estimate for the nominal case: the trips span 153 mV of open-circuit voltage. The pack is assumed to lose about 1.0 V per Ah near 3 V, and the average path current while cycling is roughly 0.77 A. That gives about 12 minutes of restarts every 10.9 ms at the end of every discharge.

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

- PASS: a load burst near cut-off causes at most one shutdown and restart (most: 1)

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

| Load | Path resistance | Hysteresis | Trips | Restarts | Open-circuit voltage at the trip | PWR_EN at the end (voltage restored) |
|---|---|---|---|---|---|---|
| nominal | pack 100 + harness 60 mΩ | 5 % (typical) | 1 | 0 | 3.197 V | 0.00 V |
| nominal | pack 150 + harness 100 mΩ | 2.5 % (minimum) | 1 | 0 | 3.300 V | 0.00 V |
| peak | pack 100 + harness 60 mΩ | 5 % (typical) | 1 | 0 | 3.271 V | 0.00 V |
| nominal, 1.5 A burst at 3.23 V | pack 100 + harness 60 mΩ | 5 % (typical) | 1 | 0 | 3.228 V | 0.00 V |
| nominal, Q8 VGS(th) 2.5 V (max) | pack 150 + harness 100 mΩ | 2.5 % (minimum) | 1 | 0 | 3.300 V | 0.00 V |

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

## Switch-node coupling on the board

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

Centre distances from the two switching inductors (both magnetically shielded, molded):

| Part | from L1 (charger, 1 µH) | from L2 (boost, 2.2 µH) |
|---|---|---|
| J2 thermistor connector | 19 mm | 32 mm |
| J4 thermostat connector | 26 mm | 42 mm |
| R8 THM bias | 5 mm | 21 mm |
| U4 charger | 10 mm | 21 mm |
| R14 boost feedback divider | 27 mm | 12 mm |
| U6 boost | 24 mm | 8 mm |
| U8 gauge | 25 mm | 28 mm |
| J10 ADSBee socket | 41 mm | 25 mm |
| J9 display socket | 31 mm | 37 mm |
| J1 USB-C | 23 mm | 23 mm |

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

| Victim | Source | Distance | EMF peak |
|---|---|---|---|
| THM bias network, 25 mm² loop | L1 | 5 mm | 0.214 mV |
| THM bias network, 25 mm² loop | L2 | 21 mm | 0.003 mV |
| thermistor lead pair at J2, untwisted, 500 mm² loop | L1 | 19 mm | 0.099 mV |
| thermistor lead pair at J2, untwisted, 500 mm² loop | L2 | 32 mm | 0.016 mV |
| boost feedback divider, 10 mm² loop | L1 | 27 mm | 0.001 mV |
| boost feedback divider, 10 mm² loop | L2 | 12 mm | 0.007 mV |
| L2 winding (from L1) | L1 | 16 mm | 0.015 mV |
| L1 winding (from L2) | L2 | 16 mm | 0.013 mV |

- PASS: magnetic pickup into the THM network at most 0.21 mV, below 10 % of the 27 mV threshold spacing
- PASS: magnetic pickup into the boost feedback divider at most 0.01 mV, below 1 % of the 1.204 V reference
- L1 and L2: each winding picks up an EMF from the other, which adds to its own ripple. The two switching frequencies differ, so it shows as a beat on VSYS. The bound is for the axial direction, the worst case.

Result: all checks pass.
