mp911de/airgrep/hardware/sim/heat/ti/results.md

# Power loss and temperature estimate

Generated by `hardware/sim/run_heat.py` from `hardware/carrier-ti-charger/carrier.kicad_pcb` (charger BQ25798). See `hardware/sim/README.md` for what is and is not modelled.

## Board as read

105 x 95 mm, four layers (JLC04161H-2116C): 35 µm outer and 15.2 µm inner copper, 0.20 / 1.065 / 0.20 mm dielectric. Copper share from the zone fills, tracks, pads and vias on a 1.0 mm grid: F 86 %, In1 94 %, In2 92 %, B 90 %. 240 vias, 94 of them GND. Zone fills are taken as stored in the file. Refill them before running after a layout change.

## Solver check

One copper layer with FR4, 10 W/m²K on each face, 1 W point source, against the infinite-plate solution P·K0(m·r) / (2π·k·t):

| Distance | Grid | Analytic | Error |
|---|---|---|---|
| 3 mm | 25.12 K | 24.99 K | +0.6 % |
| 5 mm | 19.71 K | 19.66 K | +0.3 % |
| 10 mm | 12.77 K | 12.75 K | +0.2 % |
| 20 mm | 6.72 K | 6.71 K | +0.2 % |

- PASS: grid solution within 5 % of the analytic plate from 5 mm on (worst 0.3 %)

## Loss model inputs

| Element | Value | Source |
|---|---|---|
| BQ25798 input / high side / low side / series switch / BATFET | 8 / 24 / 35 / 28 / 11 mΩ typ | SLUSDV2C, Electrical Characteristics and section 6.7 |
| BQ25798 switching | 0.75 MHz; K 0.00 ns and P0 139 mW fitted to the data sheet efficiency curve | data sheet section 6.7, VBUS 5 V, VBAT 4 V |
| BQ25798 input supply current | 3.0 mA | data sheet, typ |
| BQ25798 VSYSMIN | 3.5 V; below it the BATFET regulates linearly | data sheet |
| TPS61088 high side / low side | 13 / 11 mΩ typ | SLVSCM8D |
| L1 FC-ALX4030D-2R2MT / L2 FC-ALX4030D-2R2MT (C5370906) | 10.7 / 10.7 mΩ DCR, core loss 20 mW each | docs/power.md, vendor tables; core loss estimate |
| TPS22975 | 16 mΩ typ | SLVSCI1 |
| TPS259474L ideal diodes U11, U12 | drop regulated to 16.9 / 28.4 mV, 28.2 / 45.0 mΩ above that | SLVSFC9C, high forward drop assumed, no specified maximum |
| On-resistance temperature coefficient | +0.4 %/K | estimate |
| USB-C contacts (4 VBUS, 4 GND) | 20 / 40 mΩ each | Hanbo MC-107DMS: 40 mΩ max |
| JST-PH battery contacts | 5 / 10 mΩ each | JST PH: 10 mΩ max initial |
| Shunts and module sockets | 10 / 20 mΩ per contact | estimate |
| F1 Littelfuse 0466005.NRHF 5 A (C57525) | 11 / 15 mΩ | nominal cold resistance, datasheets/littelfuse-466.pdf; high corner estimate |
| Battery pack, DC | 60 / 90 mΩ | at most 50 mΩ AC 1 kHz in the pack data sheet; DC estimate |
| Copper | 1.72 µΩ·cm at 20 °C, +0.393 %/K, tracks and pour at their local temperature |  |

Where two values are given, the first is the nominal corner and the second the high corner.

TPS61088 switching term: P = K · VOUT · IIN · fSW + P0 with K = 28.55 ns and P0 = 40 mW. It is fitted to what TI TPS61088 Figure 6-2 curve from specs/power_params.json at 3.6 V leaves after switch conduction, L2 DCR and core loss.

| IOUT | Curve η | Model η |
|---|---|---|
| 0.2 A | 90.0 % | 91.4 % |
| 0.5 A | 93.0 % | 94.3 % |
| 1.0 A | 94.0 % | 94.9 % |
| 2.0 A | 93.0 % | 94.2 % |

## Copper path resistances at 20 °C

Each power net is solved as a resistor network of its tracks and vias. Pads are nodes, and the pins of a group share the current equally. GND is a four-layer sheet on the grid.

| Path | Resistance |
|---|---|
| USB_VBUS_J1: J14 VBUS pins to FB1 | 3.0 mΩ |
| USB_VBUS: FB1 to U4 VBUS | 13.3 mΩ |
| CHG_SW1: U4 SW1 to L1 | 8.9 mΩ |
| CHG_SW2: L1 to U4 SW2 | 8.7 mΩ |
| VSYS: U4 SYS to L2 | 10.8 mΩ |
| VBAT + CHG_BAT: F1 through Q13 to U4 BAT (copper only) | 4.9 mΩ |
| BAT_IN: J11 to F1 | 1.3 mΩ |
| BOOST_SW: L2 to U6 SW | 0.5 mΩ |
| BOOST_5V: U6 VOUT to U7 VIN | 3.7 mΩ |
| RAIL_5V: U7 VOUT to U11 IN | 13.3 mΩ |
| U12 OUT to JP1 | 6.3 mΩ |
| U11 OUT to JP3 | 4.6 mΩ |
| ADS_5V: JP3 to J6 | 2.4 mΩ |
| ESP_5V: JP1 to J1 | 9.3 mΩ |
| GND: J11 pin 2 to U6 ground pads | 0.7 mΩ |
| GND: J14 GND pins to U4 GND | 2.6 mΩ |

## Thermal environment

- Open bench: board in still air, 10 W/m²K on both faces (convection plus radiation), no enclosure.
- Closed case (not yet designed; assumed): 115 x 105 x 40 mm outside, 2 mm printed wall (k 0.2 W/m·K), 7 W/m²K inside and 9 W/m²K outside. Wall path to ambient 6.3 K/W over 418 cm². Inside it the board loses 6 W/m²K per face to the case air (modules above, battery below). The air carries everything dissipated in the case: board losses, the modules' 5 V power and the pack's own I²R. The pack: 9.2 K/W to the case air.
- Vents: 2 lower inlets and 2 upper outlets, 8.0 cm² each (16.0 cm² per group), 50 % open grille, 35 mm vertical separation, discharge coefficient 0.6. Natural draft acts in parallel with the wall path; no fan.
- Junction to board: BQ25798 RθJB 9.7 K/W from junction to pins (RθJC(top) 20.9, ψJT 0.5 K/W), TPS61088 4.1 K/W, TPS22975 RθJC(bot) 16.4 K/W; inductor winding to terminals 12 K/W.
- U4 heatsink: 10 x 10 mm aluminium sink (Fischer ICK S 10 x 10 x 6.5) on a 1.5 mm copper spacer, thermal epoxy. Junction to package top 21 K/W, epoxy and spacer 20 K/W, sink to air 35 K/W on the bench and 58 K/W in the case air. That gives 76 and 99 K/W from the junction, in parallel with the pins. Parts with pads inside the 10 x 10 mm footprint of the sink: C42, C43, C44, C46, C47, C6, R58, R59. The spacer must lift the sink base above the tallest of them.

## Operating points and losses

Board losses for the closed case at 25 °C ambient, with copper and on-resistance at their computed temperatures. Battery cases: the boost input is held at 3.1 V, the low-battery design point of docs/power.md. The cell open-circuit voltage that gives it follows from the path. USB cases: 5.0 V at the connector (cable drop not included), charge current as labelled unless the 3 A input limit reduces it.

### Battery 3.1 V, typical 1.22 W load

Nominal corner: VSYS at L2 3.10 V, cell open-circuit voltage 3.15 V, battery current 0.43 A, boost input current 0.43 A, boost duty 38.9 %, boost efficiency 91.8 %.

| Element | Nominal | High |
|---|---|---|
| TPS61088 | 87 mW | 87 mW |
| LEDs and series resistors | 32 mW | 32 mW |
| L2 | 23 mW | 23 mW |
| OVLO dividers | 7 mW | 7 mW |
| Module feed ideal diodes | 4 mW | 7 mW |
| copper VSYS | 2 mW | 2 mW |
| BQ25798 BATFET | 2 mW | 2 mW |
| F1 fuse | 2 mW | 3 mW |
| JST-PH battery contacts | 2 mW | 4 mW |
| shunts and module sockets | 1 mW | 3 mW |
| TPS22975 | 1 mW | 1 mW |
| copper RAIL_5V | 1 mW | 1 mW |
| copper CHG_BAT | 1 mW | 1 mW |
| ship FET | 0 mW | 1 mW |
| copper VBAT | 0 mW | 0 mW |
| copper BAT_IN | 0 mW | 0 mW |
| copper BOOST_5V | 0 mW | 0 mW |
| copper ADS_5V_D | 0 mW | 0 mW |
| copper BOOST_SW | 0 mW | 0 mW |
| copper ADS_5V | 0 mW | 0 mW |
| copper GND pour | 0 mW | 0 mW |
| copper ESP_5V | 0 mW | 0 mW |
| copper ESP_5V_D | 0 mW | 0 mW |
| **Board total** | **167 mW** | **175 mW** |
| Modules (5 V power, heat inside the case) | 1.21 W | 1.21 W |
| Battery pack I²R | 11 mW | 17 mW |
| Inside the case | 1.39 W | 1.40 W |

Cell to 5 V output: 90.3 % nominal, 89.8 % high corner.

### Battery 3.1 V, 0.8 A load

Nominal corner: VSYS at L2 3.10 V, cell open-circuit voltage 3.26 V, battery current 1.39 A, boost input current 1.39 A, boost duty 39.4 %, boost efficiency 94.1 %.

| Element | Nominal | High |
|---|---|---|
| TPS61088 | 209 mW | 209 mW |
| L2 | 43 mW | 43 mW |
| LEDs and series resistors | 32 mW | 32 mW |
| copper VSYS | 23 mW | 23 mW |
| BQ25798 BATFET | 23 mW | 23 mW |
| F1 fuse | 21 mW | 29 mW |
| JST-PH battery contacts | 19 mW | 38 mW |
| shunts and module sockets | 16 mW | 33 mW |
| Module feed ideal diodes | 15 mW | 24 mW |
| TPS22975 | 11 mW | 11 mW |
| copper RAIL_5V | 10 mW | 10 mW |
| OVLO dividers | 7 mW | 7 mW |
| copper CHG_BAT | 6 mW | 6 mW |
| ship FET | 5 mW | 12 mW |
| copper VBAT | 5 mW | 5 mW |
| copper BAT_IN | 3 mW | 3 mW |
| copper BOOST_5V | 3 mW | 3 mW |
| copper ADS_5V_D | 2 mW | 2 mW |
| copper ADS_5V | 1 mW | 1 mW |
| copper BOOST_SW | 1 mW | 1 mW |
| copper GND pour | 1 mW | 1 mW |
| copper ESP_5V | 0 mW | 0 mW |
| copper ESP_5V_D | 0 mW | 0 mW |
| **Board total** | **457 mW** | **518 mW** |
| Modules (5 V power, heat inside the case) | 3.99 W | 3.96 W |
| Battery pack I²R | 115 mW | 173 mW |
| Inside the case | 4.56 W | 4.65 W |

Cell to 5 V output: 89.6 % nominal, 87.8 % high corner.

### Battery 3.1 V, 1.0 A load

Nominal corner: VSYS at L2 3.10 V, cell open-circuit voltage 3.30 V, battery current 1.73 A, boost input current 1.73 A, boost duty 39.5 %, boost efficiency 94.1 %.

| Element | Nominal | High |
|---|---|---|
| TPS61088 | 260 mW | 261 mW |
| L2 | 57 mW | 57 mW |
| copper VSYS | 37 mW | 37 mW |
| BQ25798 BATFET | 37 mW | 37 mW |
| F1 fuse | 33 mW | 45 mW |
| LEDs and series resistors | 32 mW | 32 mW |
| JST-PH battery contacts | 30 mW | 60 mW |
| shunts and module sockets | 26 mW | 51 mW |
| Module feed ideal diodes | 23 mW | 36 mW |
| TPS22975 | 18 mW | 18 mW |
| copper RAIL_5V | 15 mW | 16 mW |
| copper CHG_BAT | 9 mW | 9 mW |
| ship FET | 8 mW | 19 mW |
| copper VBAT | 8 mW | 8 mW |
| OVLO dividers | 7 mW | 7 mW |
| copper BAT_IN | 4 mW | 4 mW |
| copper BOOST_5V | 4 mW | 4 mW |
| copper ADS_5V_D | 4 mW | 4 mW |
| copper ADS_5V | 2 mW | 2 mW |
| copper BOOST_SW | 2 mW | 2 mW |
| copper GND pour | 1 mW | 1 mW |
| copper ESP_5V | 0 mW | 0 mW |
| copper ESP_5V_D | 0 mW | 0 mW |
| **Board total** | **618 mW** | **712 mW** |
| Modules (5 V power, heat inside the case) | 4.96 W | 4.93 W |
| Battery pack I²R | 180 mW | 271 mW |
| Inside the case | 5.76 W | 5.91 W |

Cell to 5 V output: 88.5 % nominal, 86.3 % high corner.

### USB 3 A source, cell 3.7 V, 1.8 A host mode, TREG 100 °C, 0.8 A load

Nominal corner: charge current allowed by thermal regulation 1.80 A, VBUS at the connector 5.00 V, CHGIN at U4 4.89 V, VSYS 3.89 V, BATT at U4 3.86 V, input current 2.49 A, charge current 1.80 A, buck output current 2.90 A, buck duty 82.5 %, boost input current 1.10 A, BATFET mode: closed, charger efficiency 92.6 %, boost efficiency 95.1 %.

| Element | Nominal | High |
|---|---|---|
| BQ25798 buck | 772 mW | 767 mW |
| TPS61088 | 173 mW | 170 mW |
| L1 | 128 mW | 127 mW |
| copper USB_VBUS | 100 mW | 105 mW |
| FB1 ferrite bead | 93 mW | 129 mW |
| copper CHG_SW1 | 91 mW | 90 mW |
| copper CHG_SW2 | 89 mW | 88 mW |
| USB-C contacts | 62 mW | 129 mW |
| LEDs and series resistors | 60 mW | 60 mW |
| BQ25798 BATFET | 44 mW | 44 mW |
| F1 fuse | 36 mW | 49 mW |
| L2 | 36 mW | 35 mW |
| JST-PH battery contacts | 32 mW | 65 mW |
| copper USB_VBUS_J1 | 23 mW | 24 mW |
| shunts and module sockets | 16 mW | 33 mW |
| copper VSYS | 16 mW | 15 mW |
| Module feed ideal diodes | 15 mW | 24 mW |
| TPS22975 | 12 mW | 12 mW |
| OVLO dividers | 11 mW | 11 mW |
| copper CHG_BAT | 11 mW | 11 mW |
| copper RAIL_5V | 10 mW | 10 mW |
| copper VBAT | 9 mW | 9 mW |
| ship FET | 8 mW | 21 mW |
| copper BAT_IN | 5 mW | 5 mW |
| copper GND pour | 5 mW | 5 mW |
| copper BOOST_5V | 3 mW | 3 mW |
| copper ADS_5V_D | 2 mW | 2 mW |
| copper ADS_5V | 1 mW | 1 mW |
| copper BOOST_SW | 1 mW | 1 mW |
| copper ESP_5V | 0 mW | 0 mW |
| copper ESP_5V_D | 0 mW | 0 mW |
| **Board total** | **1.86 W** | **2.05 W** |
| Modules (5 V power, heat inside the case) | 3.99 W | 3.96 W |
| Battery pack I²R | 194 mW | 292 mW |
| Inside the case | 6.04 W | 6.30 W |

### USB 3 A source, cell 3.2 V, 1.8 A host mode, TREG 100 °C, 0.8 A load

Nominal corner: charge current allowed by thermal regulation 1.80 A, VBUS at the connector 5.00 V, CHGIN at U4 4.90 V, VSYS 3.50 V, BATT at U4 3.36 V, input current 2.37 A, charge current 1.80 A, buck output current 3.03 A, buck duty 74.7 %, boost input current 1.23 A, BATFET mode: linear (VSYS held at VSYSMIN), charger efficiency 91.5 %, boost efficiency 94.6 %.

| Element | Nominal | High |
|---|---|---|
| BQ25798 buck | 847 mW | 841 mW |
| BQ25798 BATFET | 247 mW | 92 mW |
| TPS61088 | 190 mW | 190 mW |
| L1 | 140 mW | 140 mW |
| copper CHG_SW1 | 101 mW | 101 mW |
| copper CHG_SW2 | 98 mW | 98 mW |
| copper USB_VBUS | 92 mW | 93 mW |
| FB1 ferrite bead | 84 mW | 114 mW |
| LEDs and series resistors | 57 mW | 57 mW |
| USB-C contacts | 56 mW | 114 mW |
| L2 | 40 mW | 40 mW |
| F1 fuse | 36 mW | 49 mW |
| JST-PH battery contacts | 32 mW | 65 mW |
| copper USB_VBUS_J1 | 21 mW | 21 mW |
| copper VSYS | 20 mW | 20 mW |
| shunts and module sockets | 16 mW | 33 mW |
| Module feed ideal diodes | 15 mW | 24 mW |
| TPS22975 | 12 mW | 12 mW |
| OVLO dividers | 11 mW | 11 mW |
| copper CHG_BAT | 11 mW | 11 mW |
| copper RAIL_5V | 10 mW | 10 mW |
| copper VBAT | 9 mW | 9 mW |
| ship FET | 8 mW | 21 mW |
| copper GND pour | 5 mW | 5 mW |
| copper BAT_IN | 5 mW | 5 mW |
| copper BOOST_5V | 3 mW | 3 mW |
| copper ADS_5V_D | 2 mW | 3 mW |
| copper ADS_5V | 1 mW | 1 mW |
| copper BOOST_SW | 1 mW | 1 mW |
| copper ESP_5V | 0 mW | 0 mW |
| copper ESP_5V_D | 0 mW | 0 mW |
| **Board total** | **2.17 W** | **2.18 W** |
| Modules (5 V power, heat inside the case) | 3.98 W | 3.96 W |
| Battery pack I²R | 194 mW | 292 mW |
| Inside the case | 6.35 W | 6.43 W |

### USB 3 A source, cell 3.2 V, 1.8 A host mode, TREG 100 °C, device off

Nominal corner: charge current allowed by thermal regulation 1.80 A, VBUS at the connector 5.00 V, CHGIN at U4 4.94 V, VSYS 3.50 V, BATT at U4 3.36 V, input current 1.37 A, charge current 1.80 A, buck output current 1.81 A, buck duty 72.5 %, boost input current 0.00 A, BATFET mode: linear (VSYS held at VSYSMIN), charger efficiency 93.7 %.

| Element | Nominal | High |
|---|---|---|
| BQ25798 buck | 370 mW | 367 mW |
| BQ25798 BATFET | 247 mW | 92 mW |
| L1 | 58 mW | 58 mW |
| F1 fuse | 36 mW | 49 mW |
| JST-PH battery contacts | 32 mW | 65 mW |
| copper CHG_SW1 | 32 mW | 32 mW |
| copper CHG_SW2 | 31 mW | 31 mW |
| FB1 ferrite bead | 28 mW | 38 mW |
| copper USB_VBUS | 27 mW | 27 mW |
| LEDs and series resistors | 24 mW | 24 mW |
| USB-C contacts | 19 mW | 38 mW |
| copper CHG_BAT | 10 mW | 10 mW |
| ship FET | 8 mW | 21 mW |
| copper VBAT | 8 mW | 8 mW |
| copper USB_VBUS_J1 | 6 mW | 6 mW |
| copper BAT_IN | 5 mW | 5 mW |
| OVLO dividers | 4 mW | 4 mW |
| copper GND pour | 2 mW | 2 mW |
| copper VSYS | 0 mW | 0 mW |
| **Board total** | **947 mW** | **875 mW** |
| Modules (5 V power, heat inside the case) | 0 mW | 0 mW |
| Battery pack I²R | 194 mW | 292 mW |
| Inside the case | 1.14 W | 1.17 W |

### USB 3 A source, cell 3.7 V, 1 A default mode, TREG 120 °C, 0.8 A load

Nominal corner: charge current allowed by thermal regulation 1.00 A, VBUS at the connector 5.00 V, CHGIN at U4 4.92 V, VSYS 3.80 V, BATT at U4 3.79 V, input current 1.76 A, charge current 1.00 A, buck output current 2.13 A, buck duty 79.4 %, boost input current 1.12 A, BATFET mode: closed, charger efficiency 93.7 %, boost efficiency 95.0 %.

| Element | Nominal | High |
|---|---|---|
| BQ25798 buck | 470 mW | 466 mW |
| TPS61088 | 176 mW | 174 mW |
| L1 | 76 mW | 75 mW |
| LEDs and series resistors | 59 mW | 59 mW |
| copper USB_VBUS | 48 mW | 49 mW |
| copper CHG_SW1 | 47 mW | 46 mW |
| FB1 ferrite bead | 46 mW | 63 mW |
| copper CHG_SW2 | 46 mW | 45 mW |
| L2 | 36 mW | 35 mW |
| USB-C contacts | 31 mW | 63 mW |
| shunts and module sockets | 16 mW | 33 mW |
| copper VSYS | 16 mW | 16 mW |
| Module feed ideal diodes | 15 mW | 24 mW |
| BQ25798 BATFET | 13 mW | 13 mW |
| TPS22975 | 12 mW | 12 mW |
| OVLO dividers | 11 mW | 11 mW |
| F1 fuse | 11 mW | 15 mW |
| copper USB_VBUS_J1 | 11 mW | 11 mW |
| JST-PH battery contacts | 10 mW | 20 mW |
| copper RAIL_5V | 10 mW | 10 mW |
| copper CHG_BAT | 3 mW | 3 mW |
| copper BOOST_5V | 3 mW | 3 mW |
| ship FET | 3 mW | 6 mW |
| copper VBAT | 3 mW | 3 mW |
| copper ADS_5V_D | 2 mW | 2 mW |
| copper GND pour | 2 mW | 2 mW |
| copper BAT_IN | 1 mW | 1 mW |
| copper ADS_5V | 1 mW | 1 mW |
| copper BOOST_SW | 1 mW | 1 mW |
| copper ESP_5V | 0 mW | 0 mW |
| copper ESP_5V_D | 0 mW | 0 mW |
| **Board total** | **1.18 W** | **1.26 W** |
| Modules (5 V power, heat inside the case) | 3.99 W | 3.96 W |
| Battery pack I²R | 60 mW | 90 mW |
| Inside the case | 5.22 W | 5.32 W |

### USB 3 A source, cell 3.2 V, 1 A default mode, TREG 120 °C, 0.8 A load

Nominal corner: charge current allowed by thermal regulation 1.00 A, VBUS at the connector 5.00 V, CHGIN at U4 4.92 V, VSYS 3.50 V, BATT at U4 3.29 V, input current 1.71 A, charge current 1.00 A, buck output current 2.23 A, buck duty 73.3 %, boost input current 1.23 A, BATFET mode: linear (VSYS held at VSYSMIN), charger efficiency 93.0 %, boost efficiency 94.7 %.

| Element | Nominal | High |
|---|---|---|
| BQ25798 buck | 510 mW | 509 mW |
| BQ25798 BATFET | 210 mW | 162 mW |
| TPS61088 | 189 mW | 189 mW |
| L1 | 82 mW | 82 mW |
| LEDs and series resistors | 57 mW | 57 mW |
| copper CHG_SW1 | 52 mW | 52 mW |
| copper CHG_SW2 | 51 mW | 51 mW |
| copper USB_VBUS | 46 mW | 46 mW |
| FB1 ferrite bead | 44 mW | 59 mW |
| L2 | 39 mW | 39 mW |
| USB-C contacts | 29 mW | 59 mW |
| copper VSYS | 19 mW | 19 mW |
| shunts and module sockets | 16 mW | 33 mW |
| Module feed ideal diodes | 15 mW | 24 mW |
| TPS22975 | 12 mW | 12 mW |
| OVLO dividers | 11 mW | 11 mW |
| F1 fuse | 11 mW | 15 mW |
| copper USB_VBUS_J1 | 10 mW | 10 mW |
| copper RAIL_5V | 10 mW | 10 mW |
| JST-PH battery contacts | 10 mW | 20 mW |
| copper CHG_BAT | 3 mW | 3 mW |
| copper BOOST_5V | 3 mW | 3 mW |
| copper GND pour | 3 mW | 3 mW |
| ship FET | 3 mW | 6 mW |
| copper VBAT | 3 mW | 3 mW |
| copper ADS_5V_D | 2 mW | 2 mW |
| copper BAT_IN | 2 mW | 2 mW |
| copper ADS_5V | 1 mW | 1 mW |
| copper BOOST_SW | 1 mW | 1 mW |
| copper ESP_5V | 0 mW | 0 mW |
| copper ESP_5V_D | 0 mW | 0 mW |
| **Board total** | **1.44 W** | **1.49 W** |
| Modules (5 V power, heat inside the case) | 3.99 W | 3.96 W |
| Battery pack I²R | 60 mW | 90 mW |
| Inside the case | 5.49 W | 5.54 W |

## Temperatures

Hot spots from the grid solution. "θJA" is the naive figure from the data sheet's JEDEC θJA with the same loss at the same ambient, for comparison only.

| Case | Environment | Ambient | Corner | Case air | U4 Tj | U6 Tj | U7 Tj | L1 | L2 | Board max | Hottest X7R | Pack |
|---|---|---|---|---|---|---|---|---|---|---|---|---|
| Battery 3.1 V, typical 1.22 W load | open | 25 °C | nominal | 25.0 | 26 (θJA 25) | 28 (θJA 28) | 27 | - | 28 | 28 | 27 (C18) | 25.1 |
| Battery 3.1 V, typical 1.22 W load | closed | 25 °C | nominal | 31.7 | 33 (θJA 25) | 36 (θJA 28) | 34 | - | 35 | 36 | 35 (C18) | 31.8 |
|  |  |  | high | 31.7 | 33 (θJA 25) | 36 (θJA 28) | 34 | - | 35 | 36 | 35 (C18) | 31.9 |
| Battery 3.1 V, typical 1.22 W load | closed | 50 °C | nominal | 56.7 | 58 (θJA 50) | 61 (θJA 53) | 59 | - | 60 | 61 | 60 (C18) | 56.8 |
|  |  |  | high | 56.8 | 58 (θJA 50) | 61 (θJA 53) | 59 | - | 60 | 61 | 60 (C18) | 56.9 |
| Battery 3.1 V, 0.8 A load | open | 25 °C | nominal | 25.0 | 28 (θJA 26) | 33 (θJA 33) | 30 | - | 31 | 33 | 31 (C18) | 26.1 |
| Battery 3.1 V, 0.8 A load | closed | 25 °C | nominal | 43.8 | 48 (θJA 26) | 54 (θJA 33) | 51 | - | 52 | 54 | 51 (C18) | 44.9 |
|  |  |  | high | 44.2 | 49 (θJA 26) | 55 (θJA 33) | 52 | - | 52 | 55 | 52 (C18) | 45.8 |
| Battery 3.1 V, 0.8 A load | closed | 50 °C | nominal | 69.1 | 73 (θJA 51) | 80 (θJA 58) | 76 | - | 77 | 79 | 77 (C18) | 70.2 |
|  |  |  | high | 69.4 | 74 (θJA 51) | 81 (θJA 58) | 77 | - | 78 | 80 | 78 (C18) | 71.0 |
| Battery 3.1 V, 1.0 A load | open | 25 °C | nominal | 25.0 | 29 (θJA 26) | 36 (θJA 35) | 32 | - | 33 | 35 | 32 (C18) | 26.7 |
| Battery 3.1 V, 1.0 A load | closed | 25 °C | nominal | 48.0 | 54 (θJA 27) | 61 (θJA 35) | 58 | - | 58 | 61 | 58 (C18) | 49.6 |
|  |  |  | high | 48.5 | 55 (θJA 27) | 63 (θJA 35) | 59 | - | 59 | 62 | 59 (C18) | 51.0 |
| Battery 3.1 V, 1.0 A load | closed | 50 °C | nominal | 73.3 | 79 (θJA 52) | 87 (θJA 60) | 83 | - | 84 | 86 | 83 (C18) | 75.0 |
|  |  |  | high | 73.8 | 81 (θJA 52) | 88 (θJA 60) | 85 | - | 85 | 88 | 85 (C18) | 76.3 |
| USB 3 A source, cell 3.7 V, 1.8 A host mode, TREG 100 °C, 0.8 A load | open | 25 °C | nominal | 25.0 | 49 (θJA 58) | 40 (θJA 32) | 37 | 43 | 39 | 45 | 42 (C6) | 26.8 |
| USB 3 A source, cell 3.7 V, 1.8 A host mode, TREG 100 °C, 0.8 A load | closed | 25 °C | nominal | 48.9 | 81 (θJA 61) | 71 (θJA 32) | 68 | 74 | 70 | 77 | 73 (C6) | 50.7 |
|  |  |  | high | 49.8 | 83 (θJA 61) | 74 (θJA 32) | 71 | 77 | 73 | 80 | 76 (C6) | 52.4 |
| USB 3 A source, cell 3.2 V, 1.8 A host mode, TREG 100 °C, 0.8 A load | open | 25 °C | nominal | 25.0 | 55 (θJA 70) | 42 (θJA 32) | 38 | 45 | 41 | 50 | 45 (C9) | 26.8 |
| USB 3 A source, cell 3.2 V, 1.8 A host mode, TREG 100 °C, 0.8 A load | closed | 25 °C | nominal | 49.9 | 90 (θJA 73) | 75 (θJA 32) | 71 | 79 | 74 | 84 | 79 (C9) | 51.7 |
|  |  |  | high | 50.2 | 87 (θJA 66) | 76 (θJA 32) | 72 | 79 | 75 | 83 | 79 (C6) | 52.9 |
| USB 3 A source, cell 3.2 V, 1.8 A host mode, TREG 100 °C, device off | open | 25 °C | nominal | 25.0 | 41 (θJA 52) | - | - | 34 | - | 38 | 35 (C9) | 26.8 |
| USB 3 A source, cell 3.2 V, 1.8 A host mode, TREG 100 °C, device off | closed | 25 °C | nominal | 30.6 | 50 (θJA 52) | - | - | 43 | - | 47 | 44 (C9) | 32.4 |
|  |  |  | high | 30.7 | 47 (θJA 45) | - | - | 43 | - | 45 | 42 (C9) | 33.4 |
| USB 3 A source, cell 3.7 V, 1 A default mode, TREG 120 °C, 0.8 A load | open | 25 °C | nominal | 25.0 | 40 (θJA 45) | 37 (θJA 32) | 34 | 36 | 35 | 37 | 36 (C6) | 25.6 |
| USB 3 A source, cell 3.7 V, 1 A default mode, TREG 120 °C, 0.8 A load | closed | 25 °C | nominal | 46.1 | 66 (θJA 46) | 62 (θJA 32) | 59 | 62 | 61 | 63 | 61 (C6) | 46.7 |
|  |  |  | high | 46.5 | 67 (θJA 46) | 64 (θJA 32) | 61 | 63 | 62 | 64 | 63 (C1) | 47.3 |
| USB 3 A source, cell 3.2 V, 1 A default mode, TREG 120 °C, 0.8 A load | open | 25 °C | nominal | 25.0 | 45 (θJA 55) | 38 (θJA 32) | 35 | 38 | 37 | 42 | 38 (C6) | 25.6 |
| USB 3 A source, cell 3.2 V, 1 A default mode, TREG 120 °C, 0.8 A load | closed | 25 °C | nominal | 47.1 | 73 (θJA 57) | 66 (θJA 32) | 62 | 66 | 64 | 69 | 66 (C6) | 47.6 |
|  |  |  | high | 47.2 | 73 (θJA 55) | 67 (θJA 32) | 63 | 66 | 65 | 69 | 66 (C6) | 48.0 |

All temperatures in °C. Board max is the hottest grid cell (1 mm), not a pad.

## Checks

- PASS: USB 3 A source, cell 3.7 V, 1.8 A host mode, TREG 100 °C, 0.8 A load, open bench, 25 °C: full 1.8 A charge current (U4 junction 49 °C, regulation at 100 °C)
- PASS: USB 3 A source, cell 3.2 V, 1.8 A host mode, TREG 100 °C, 0.8 A load, open bench, 25 °C: full 1.8 A charge current (U4 junction 55 °C, regulation at 100 °C)
- PASS: USB 3 A source, cell 3.2 V, 1.8 A host mode, TREG 100 °C, device off, open bench, 25 °C: full 1.8 A charge current (U4 junction 41 °C, regulation at 100 °C)
- PASS: USB 3 A source, cell 3.7 V, 1 A default mode, TREG 120 °C, 0.8 A load, open bench, 25 °C: full 1.0 A charge current (U4 junction 40 °C, regulation at 120 °C)
- PASS: USB 3 A source, cell 3.2 V, 1 A default mode, TREG 120 °C, 0.8 A load, open bench, 25 °C: full 1.0 A charge current (U4 junction 45 °C, regulation at 120 °C)
- PASS: TPS61088 junction at most 88 °C (Battery 3.1 V, 1.0 A load, 50 °C ambient, high corner, closed case), limit 125 °C
- PASS: TPS22975 junction at most 85 °C (Battery 3.1 V, 1.0 A load, 50 °C ambient, high corner, closed case), limit 125 °C
- PASS: L1 winding at most 81 °C (Battery 3.1 V, 1.0 A load, 50 °C ambient, high corner, closed case), limit 125 °C
- PASS: L2 winding at most 85 °C (Battery 3.1 V, 1.0 A load, 50 °C ambient, high corner, closed case), limit 125 °C
- PASS: hottest board cell 87.8 °C (Battery 3.1 V, 1.0 A load, 50 °C ambient, high corner, closed case); limit 125 °C (FR4 Tg 130 °C and up)
- PASS: X7R bulk capacitors at 25 °C ambient, closed case: hottest C9 at 79 °C (USB 3 A source, cell 3.2 V, 1.8 A host mode, TREG 100 °C, 0.8 A load, nominal corner), rating 125 °C
- PASS: X7R bulk capacitors at 50 °C ambient, closed case: hottest C18 at 85 °C (Battery 3.1 V, 1.0 A load, high corner), rating 125 °C
- PASS: Battery 3.1 V, typical 1.22 W load, closed case, 25 °C ambient, high corner: pack at 31.9 °C; it must stay below the thermostat's lowest opening point 55 °C (60 °C ± 5 K)
- PASS: Battery 3.1 V, 0.8 A load, closed case, 25 °C ambient, high corner: pack at 45.8 °C; it must stay below the thermostat's lowest opening point 55 °C (60 °C ± 5 K)
- PASS: Battery 3.1 V, 1.0 A load, closed case, 25 °C ambient, high corner: pack at 51.0 °C; it must stay below the thermostat's lowest opening point 55 °C (60 °C ± 5 K)
- PASS: battery current at most 1.80 A through J11, JST PH rating 2 A (AWG 24)
- PASS: USB input current at most 2.54 A, MC-107DMS rating 5 A

## Charger thermal regulation

The BQ25798 holds its junction at TREG by reducing the charge current (register setting, default 120 °C, options 60 / 80 / 100 / 120 °C). Below zero charge current the model lets the input current fall so that the battery supplements the system. The table gives the charge current the board sustains in steady state at the TREG of each case. Negative: the battery discharges into the load although USB is present.

| Case | Environment | Corner | TREG | Charge current | Input current | U4 Tj | U4 loss |
|---|---|---|---|---|---|---|---|
| USB 3 A source, cell 3.7 V, 1.8 A host mode, TREG 100 °C, 0.8 A load | open bench, no enclosure | nominal | 100 °C | 1.80 A | 2.48 A | 49 °C | 0.75 W |
| USB 3 A source, cell 3.7 V, 1.8 A host mode, TREG 100 °C, 0.8 A load | closed 3D-printed case | nominal | 100 °C | 1.80 A | 2.49 A | 81 °C | 0.82 W |
| USB 3 A source, cell 3.7 V, 1.8 A host mode, TREG 100 °C, 0.8 A load | closed 3D-printed case | high | 100 °C | 1.80 A | 2.54 A | 83 °C | 0.81 W |
| USB 3 A source, cell 3.2 V, 1.8 A host mode, TREG 100 °C, 0.8 A load | open bench, no enclosure | nominal | 100 °C | 1.80 A | 2.35 A | 55 °C | 1.02 W |
| USB 3 A source, cell 3.2 V, 1.8 A host mode, TREG 100 °C, 0.8 A load | closed 3D-printed case | nominal | 100 °C | 1.80 A | 2.37 A | 90 °C | 1.09 W |
| USB 3 A source, cell 3.2 V, 1.8 A host mode, TREG 100 °C, 0.8 A load | closed 3D-printed case | high | 100 °C | 1.80 A | 2.39 A | 87 °C | 0.93 W |
| USB 3 A source, cell 3.2 V, 1.8 A host mode, TREG 100 °C, device off | open bench, no enclosure | nominal | 100 °C | 1.80 A | 1.37 A | 41 °C | 0.61 W |
| USB 3 A source, cell 3.2 V, 1.8 A host mode, TREG 100 °C, device off | closed 3D-printed case | nominal | 100 °C | 1.80 A | 1.37 A | 50 °C | 0.62 W |
| USB 3 A source, cell 3.2 V, 1.8 A host mode, TREG 100 °C, device off | closed 3D-printed case | high | 100 °C | 1.80 A | 1.37 A | 47 °C | 0.46 W |
| USB 3 A source, cell 3.7 V, 1 A default mode, TREG 120 °C, 0.8 A load | open bench, no enclosure | nominal | 120 °C | 1.00 A | 1.75 A | 40 °C | 0.45 W |
| USB 3 A source, cell 3.7 V, 1 A default mode, TREG 120 °C, 0.8 A load | closed 3D-printed case | nominal | 120 °C | 1.00 A | 1.76 A | 66 °C | 0.48 W |
| USB 3 A source, cell 3.7 V, 1 A default mode, TREG 120 °C, 0.8 A load | closed 3D-printed case | high | 120 °C | 1.00 A | 1.77 A | 67 °C | 0.48 W |
| USB 3 A source, cell 3.2 V, 1 A default mode, TREG 120 °C, 0.8 A load | open bench, no enclosure | nominal | 120 °C | 1.00 A | 1.70 A | 45 °C | 0.69 W |
| USB 3 A source, cell 3.2 V, 1 A default mode, TREG 120 °C, 0.8 A load | closed 3D-printed case | nominal | 120 °C | 1.00 A | 1.71 A | 73 °C | 0.72 W |
| USB 3 A source, cell 3.2 V, 1 A default mode, TREG 120 °C, 0.8 A load | closed 3D-printed case | high | 120 °C | 1.00 A | 1.72 A | 73 °C | 0.67 W |

## U4 heatsink against the bare board

The same operating points solved without the heatsink. It moves heat from the die into the surrounding air. In the closed case that air is the case air, whose temperature it does not change.

| Case | Environment | Corner | U4 junction, bare to heatsink | Charge current, bare to heatsink | Heat through the heatsink | U4 junction to air, bare to heatsink |
|---|---|---|---|---|---|---|
| USB 3 A source, cell 3.7 V, 1.8 A host mode, TREG 100 °C, 0.8 A load | open bench, no enclosure | nominal | 60 to 49 °C | 1.80 to 1.80 A | 0.31 W of 0.75 W | 47 to 32 K/W |
| USB 3 A source, cell 3.7 V, 1.8 A host mode, TREG 100 °C, 0.8 A load | closed 3D-printed case | nominal | 94 to 81 °C | 1.80 to 1.80 A | 0.32 W of 0.82 W | 55 to 39 K/W |
| USB 3 A source, cell 3.7 V, 1.8 A host mode, TREG 100 °C, 0.8 A load | closed 3D-printed case | high | 97 to 83 °C | 1.80 to 1.80 A | 0.34 W of 0.81 W | 58 to 41 K/W |
| USB 3 A source, cell 3.2 V, 1.8 A host mode, TREG 100 °C, 0.8 A load | open bench, no enclosure | nominal | 69 to 55 °C | 1.80 to 1.80 A | 0.40 W of 1.02 W | 43 to 30 K/W |
| USB 3 A source, cell 3.2 V, 1.8 A host mode, TREG 100 °C, 0.8 A load | closed 3D-printed case | nominal | 100 to 90 °C | 1.61 to 1.80 A | 0.40 W of 1.09 W | 47 to 36 K/W |
| USB 3 A source, cell 3.2 V, 1.8 A host mode, TREG 100 °C, 0.8 A load | closed 3D-printed case | high | 100 to 87 °C | 1.72 to 1.80 A | 0.37 W of 0.93 W | 54 to 40 K/W |
| USB 3 A source, cell 3.2 V, 1.8 A host mode, TREG 100 °C, device off | open bench, no enclosure | nominal | 48 to 41 °C | 1.80 to 1.80 A | 0.21 W of 0.61 W | 38 to 27 K/W |
| USB 3 A source, cell 3.2 V, 1.8 A host mode, TREG 100 °C, device off | closed 3D-printed case | nominal | 58 to 50 °C | 1.80 to 1.80 A | 0.20 W of 0.62 W | 45 to 32 K/W |
| USB 3 A source, cell 3.2 V, 1.8 A host mode, TREG 100 °C, device off | closed 3D-printed case | high | 53 to 47 °C | 1.80 to 1.80 A | 0.17 W of 0.46 W | 49 to 36 K/W |
| USB 3 A source, cell 3.7 V, 1 A default mode, TREG 120 °C, 0.8 A load | open bench, no enclosure | nominal | 46 to 40 °C | 1.00 to 1.00 A | 0.19 W of 0.45 W | 47 to 32 K/W |
| USB 3 A source, cell 3.7 V, 1 A default mode, TREG 120 °C, 0.8 A load | closed 3D-printed case | nominal | 73 to 66 °C | 1.00 to 1.00 A | 0.20 W of 0.48 W | 56 to 40 K/W |
| USB 3 A source, cell 3.7 V, 1 A default mode, TREG 120 °C, 0.8 A load | closed 3D-printed case | high | 74 to 67 °C | 1.00 to 1.00 A | 0.20 W of 0.48 W | 58 to 42 K/W |
| USB 3 A source, cell 3.2 V, 1 A default mode, TREG 120 °C, 0.8 A load | open bench, no enclosure | nominal | 54 to 45 °C | 1.00 to 1.00 A | 0.26 W of 0.69 W | 42 to 29 K/W |
| USB 3 A source, cell 3.2 V, 1 A default mode, TREG 120 °C, 0.8 A load | closed 3D-printed case | nominal | 83 to 73 °C | 1.00 to 1.00 A | 0.26 W of 0.72 W | 50 to 36 K/W |
| USB 3 A source, cell 3.2 V, 1 A default mode, TREG 120 °C, 0.8 A load | closed 3D-printed case | high | 83 to 73 °C | 1.00 to 1.00 A | 0.26 W of 0.67 W | 53 to 38 K/W |
| Battery 3.1 V, 0.8 A load | open bench, no enclosure | nominal | 29 to 28 °C | - | 0.04 W of 0.02 W | 179 to 125 K/W |
| Battery 3.1 V, 0.8 A load | closed 3D-printed case | nominal | 50 to 48 °C | - | 0.04 W of 0.02 W | 246 to 179 K/W |
| Battery 3.1 V, 1.0 A load | open bench, no enclosure | nominal | 30 to 29 °C | - | 0.05 W of 0.03 W | 157 to 110 K/W |
| Battery 3.1 V, 1.0 A load | closed 3D-printed case | nominal | 56 to 54 °C | - | 0.06 W of 0.04 W | 213 to 155 K/W |

Junction to air is the junction rise over the surrounding air divided by the U4 loss at the operating point with the heatsink. In regulation the loss differs between the two solutions.

## Charging and the pack temperature window

The charger reads the pack NTC. Above 31.4 °C it lowers the termination voltage to 4.05 V, above 42.1 °C it stops (nominal thresholds, docs/power.md). In the closed case the pack sits in the case air, so the ambient at which these are reached is:

| Case | Corner | Pack above ambient | Ambient for 4.05 V limit | Ambient for charge stop |
|---|---|---|---|---|
| USB 3 A source, cell 3.7 V, 1.8 A host mode, TREG 100 °C, 0.8 A load | nominal | 25.7 K | 5.7 °C | 16.4 °C |
|  | high | 27.4 K | 4.0 °C | 14.7 °C |
| USB 3 A source, cell 3.2 V, 1.8 A host mode, TREG 100 °C, 0.8 A load | nominal | 26.7 K | 4.7 °C | 15.4 °C |
|  | high | 27.9 K | 3.5 °C | 14.2 °C |
| USB 3 A source, cell 3.2 V, 1.8 A host mode, TREG 100 °C, device off | nominal | 7.4 K | 24.0 °C | 34.7 °C |
|  | high | 8.4 K | 23.0 °C | 33.7 °C |
| USB 3 A source, cell 3.7 V, 1 A default mode, TREG 120 °C, 0.8 A load | nominal | 21.7 K | 9.7 °C | 20.4 °C |
|  | high | 22.3 K | 9.1 °C | 19.8 °C |
| USB 3 A source, cell 3.2 V, 1 A default mode, TREG 120 °C, 0.8 A load | nominal | 22.6 K | 8.8 °C | 19.5 °C |
|  | high | 23.0 K | 8.4 °C | 19.1 °C |

On the open bench the pack rises only by its own I²R loss (a few tenths of a kelvin at 1.8 A).

## Limits of the model

- Steady state only. The 1.5 A output margin is short-term headroom and not a thermal case.
- The enclosure is not designed. Its size, material, vents and the battery position decide the case-air rise, which dominates the absolute temperatures in the closed case. The modules' 5 V power is most of the heat in it.
- Board-to-air coefficients are lumped (one value per face). Modules on the top side shade the board; their own heat reaches the board only through the case air, not through the header pins.
- The BQ25798 switching loss is fitted to the data sheet efficiency curve at 5 V in and 4 V out (read off the figure, about half a point of accuracy), so it carries the data sheet's test board and inductor.
- BQ25798: RθJB 9.7 K/W from junction to pins (RθJC(top) 20.9, ψJT 0.5 K/W).
- The U4 heatsink path is an estimate on top of that: junction to package top is not published for the FC2QFN (25 to 45 K/W assumed), the epoxy layers depend on the assembly, and the sink rating is a free-air figure derated for the lower temperature rise and the case air. Bench item: thermocouple on the sink base.
- Contact, fuse and pack resistances are data sheet maxima or estimates (see the input table). The USB cable is not included; its drop lowers CHGIN towards the 4.5 V input regulation threshold.
- Only DC currents are solved in the copper. Ripple currents in the capacitor loops and their ESR losses are small and stay inside the converter footprints.
- Bench verification: thermocouple or IR camera on U4, U6, L1, L2 and the pack at the charging case with the real enclosure, and at the 3.1 V / 0.8 A battery case.

Run time 7 s, grid 105 x 95 x 4 nodes.

Result: all checks pass.
