mp911de/airgrep/hardware/sim/heat/ti/results_tps61023.md

# Power loss and temperature estimate, TPS61023 candidate

Candidate assumption: Candidate silicon at the present U6 thermal location and on its hot-loop geometry. U7 silicon loss is removed, but the present U6-to-U7 copper route remains. The real TPS61023 layout does not exist; this isolates silicon effects from layout area.

Generated by `hardware/sim/run_heat.py` from `hardware/carrier-ti-charger/carrier.kicad_pcb` (charger BQ25798). See `hardware/sim/README.md` for what is and is not modelled.

## Board as read

105 x 95 mm, four layers (JLC04161H-2116C): 35 µm outer and 15.2 µm inner copper, 0.20 / 1.065 / 0.20 mm dielectric. Copper share from the zone fills, tracks, pads and vias on a 1.0 mm grid: F 79 %, In1 91 %, In2 86 %, B 91 %. 206 vias, 71 of them GND. Zone fills are taken as stored in the file. Refill them before running after a layout change.

## Solver check

One copper layer with FR4, 10 W/m²K on each face, 1 W point source, against the infinite-plate solution P·K0(m·r) / (2π·k·t):

| Distance | Grid | Analytic | Error |
|---|---|---|---|
| 3 mm | 25.12 K | 24.99 K | +0.6 % |
| 5 mm | 19.71 K | 19.66 K | +0.3 % |
| 10 mm | 12.77 K | 12.75 K | +0.2 % |
| 20 mm | 6.72 K | 6.71 K | +0.2 % |

- PASS: grid solution within 5 % of the analytic plate from 5 mm on (worst 0.3 %)

## Loss model inputs

| Element | Value | Source |
|---|---|---|
| BQ25798 input / high side / low side / series switch / BATFET | 8 / 24 / 35 / 28 / 11 mΩ typ | SLUSDV2C, Electrical Characteristics and section 6.7 |
| BQ25798 switching | 0.75 MHz; K 0.00 ns and P0 151 mW fitted to the data sheet efficiency curve | data sheet section 6.7, VBUS 5 V, VBAT 4 V |
| BQ25798 input supply current | 3.0 mA | data sheet, typ |
| BQ25798 VSYSMIN | 3.5 V; below it the BATFET regulates linearly | data sheet |
| TPS61023 high side / low side | 68 / 47 mΩ typ | SLVSF14B |
| L1 FXL0630-2R2-M / L2 CKST0603-2.2uH | 15.0 / 15.5 mΩ DCR, core loss 20 mW each | docs/power.md, vendor tables; core loss estimate |
| TPS22975 | removed by integrated disconnect | SLVSCI1 |
| TPS259474L ideal diodes U11, U12 | drop regulated to 16.9 / 28.4 mV, 28.2 / 45.0 mΩ above that | SLVSFC9C, high forward drop assumed, no specified maximum |
| On-resistance temperature coefficient | +0.4 %/K | estimate |
| USB-C contacts (4 VBUS, 4 GND) | 20 / 40 mΩ each | Hanbo MC-107DMS: 40 mΩ max |
| JST-PH battery contacts | 5 / 10 mΩ each | JST PH: 10 mΩ max initial |
| Shunts and module sockets | 10 / 20 mΩ per contact | estimate |
| F1 Littelfuse 0466005.NRHF 5 A (C57525) | 11 / 15 mΩ | nominal cold resistance, datasheets/littelfuse-466.pdf; high corner estimate |
| Battery pack, DC | 60 / 90 mΩ | at most 50 mΩ AC 1 kHz in the pack data sheet; DC estimate |
| Copper | 1.72 µΩ·cm at 20 °C, +0.393 %/K, tracks and pour at their local temperature |  |

Where two values are given, the first is the nominal corner and the second the high corner.

TPS61023 switching term: P = K · VOUT · IIN · fSW + P0 with K = 0.00 ns and P0 = 65 mW. It is fitted to what TI TPS61023 Figure 6-1, 3.0 V curve read to about 0.5 percentage point at 3.0 V leaves after switch conduction, L2 DCR and core loss.

| IOUT | Curve η | Model η |
|---|---|---|
| 0.2 A | 93.8 % | 91.2 % |
| 0.5 A | 94.5 % | 94.4 % |
| 0.8 A | 94.0 % | 94.1 % |
| 1.0 A | 93.3 % | 93.4 % |
| 1.5 A | 90.9 % | 90.9 % |
| 2.0 A | 88.2 % | 87.7 % |

- PASS: minimum calculated output before valley current limit 1.63 A at 3.1 V, L2 +20 % and 90 % efficiency; 1.5 A is safety margin, not sustained load

## Copper path resistances at 20 °C

Each power net is solved as a resistor network of its tracks and vias. Pads are nodes, and the pins of a group share the current equally. GND is a four-layer sheet on the grid.

| Path | Resistance |
|---|---|
| USB_VBUS_J1: J1 VBUS pins to FB1 | 2.9 mΩ |
| USB_VBUS: FB1 to U4 VBUS | 12.1 mΩ |
| CHG_SW1: U4 SW1 to L1 | 9.6 mΩ |
| CHG_SW2: L1 to U4 SW2 | 8.8 mΩ |
| VSYS: U4 SYS to L2 | 11.0 mΩ |
| VBAT + CHG_BAT: F1 through Q13 to U4 BAT (copper only) | 4.6 mΩ |
| BAT_IN: J3 to F1 | 1.3 mΩ |
| BOOST_SW: L2 to U6 SW | 0.7 mΩ |
| BOOST_5V: U6 VOUT to U7 VIN | 3.7 mΩ |
| RAIL_5V: U7 VOUT to U11 IN | 13.3 mΩ |
| U12 OUT to JP1 | 6.2 mΩ |
| U11 OUT to JP2 | 4.6 mΩ |
| ADS_5V: JP2 to J10 | 2.4 mΩ |
| ESP_5V: JP1 to J7 | 9.2 mΩ |
| GND: J3 pin 2 to U6 ground pads | 0.8 mΩ |
| GND: J1 GND pins to U4 GND | 3.3 mΩ |

## Thermal environment

- Open bench: board in still air, 10 W/m²K on both faces (convection plus radiation), no enclosure.
- Closed case (not yet designed; assumed): 115 x 105 x 40 mm outside, 2 mm printed wall (k 0.2 W/m·K), 7 W/m²K inside and 9 W/m²K outside. Wall path to ambient 6.3 K/W over 418 cm². Inside it the board loses 6 W/m²K per face to the case air (modules above, battery below). The air carries everything dissipated in the case: board losses, the modules' 5 V power and the pack's own I²R. The pack: 9.2 K/W to the case air.
- Vents: 2 lower inlets and 2 upper outlets, 8.0 cm² each (16.0 cm² per group), 50 % open grille, 35 mm vertical separation, discharge coefficient 0.6. Natural draft acts in parallel with the wall path; no fan.
- Junction to board: BQ25798 RθJB 9.7 K/W from junction to pins (RθJC(top) 20.9, ψJT 0.5 K/W), TPS61023 31.0 K/W, TPS22975 RθJC(bot) 16.4 K/W; inductor winding to terminals 12 K/W.
- U4 heatsink: 10 x 10 mm aluminium sink (Fischer ICK S 10 x 10 x 6.5) on a 1.5 mm copper spacer, thermal epoxy. Junction to package top 21 K/W, epoxy and spacer 20 K/W, sink to air 35 K/W on the bench and 58 K/W in the case air. That gives 76 and 99 K/W from the junction, in parallel with the pins. Parts with pads inside the 10 x 10 mm footprint of the sink: C42, C43, C44, C46, C47, C6, R56, R58, R59. The spacer must lift the sink base above the tallest of them.

## Operating points and losses

Board losses for the closed case at 25 °C ambient, with copper and on-resistance at their computed temperatures. Battery cases: the boost input is held at 3.1 V, the low-battery design point of docs/power.md. The cell open-circuit voltage that gives it follows from the path. USB cases: 5.0 V at the connector (cable drop not included), charge current as labelled unless the 3 A input limit reduces it.

### Battery 3.1 V, typical 1.22 W load

Nominal corner: VSYS at L2 3.10 V, cell open-circuit voltage 3.15 V, battery current 0.43 A, boost input current 0.43 A, boost duty 39.2 %, boost efficiency 92.3 %.

| Element | Nominal | High |
|---|---|---|
| TPS61023 | 78 mW | 79 mW |
| LEDs and series resistors | 32 mW | 32 mW |
| L2 | 23 mW | 23 mW |
| OVLO dividers | 7 mW | 7 mW |
| Module feed ideal diodes | 4 mW | 7 mW |
| copper VSYS | 2 mW | 2 mW |
| BQ25798 BATFET | 2 mW | 2 mW |
| F1 fuse | 2 mW | 3 mW |
| JST-PH battery contacts | 2 mW | 4 mW |
| shunts and module sockets | 1 mW | 3 mW |
| copper RAIL_5V | 1 mW | 1 mW |
| ship FET | 0 mW | 1 mW |
| copper CHG_BAT | 0 mW | 0 mW |
| copper VBAT | 0 mW | 0 mW |
| copper BAT_IN | 0 mW | 0 mW |
| copper BOOST_5V | 0 mW | 0 mW |
| copper ADS_5V_D | 0 mW | 0 mW |
| copper BOOST_SW | 0 mW | 0 mW |
| copper ADS_5V | 0 mW | 0 mW |
| copper GND pour | 0 mW | 0 mW |
| copper ESP_5V | 0 mW | 0 mW |
| copper ESP_5V_D | 0 mW | 0 mW |
| **Board total** | **158 mW** | **166 mW** |
| Modules (5 V power, heat inside the case) | 1.21 W | 1.21 W |
| Battery pack I²R | 11 mW | 16 mW |
| Inside the case | 1.38 W | 1.39 W |

Cell to 5 V output: 90.9 % nominal, 90.3 % high corner.

### Battery 3.1 V, 0.8 A load

Nominal corner: VSYS at L2 3.10 V, cell open-circuit voltage 3.26 V, battery current 1.39 A, boost input current 1.39 A, boost duty 40.6 %, boost efficiency 94.2 %.

| Element | Nominal | High |
|---|---|---|
| TPS61023 | 197 mW | 198 mW |
| L2 | 53 mW | 53 mW |
| LEDs and series resistors | 32 mW | 32 mW |
| copper VSYS | 23 mW | 24 mW |
| BQ25798 BATFET | 23 mW | 23 mW |
| F1 fuse | 21 mW | 29 mW |
| JST-PH battery contacts | 19 mW | 38 mW |
| shunts and module sockets | 16 mW | 33 mW |
| Module feed ideal diodes | 15 mW | 24 mW |
| copper RAIL_5V | 10 mW | 10 mW |
| OVLO dividers | 7 mW | 7 mW |
| copper CHG_BAT | 5 mW | 5 mW |
| ship FET | 5 mW | 12 mW |
| copper VBAT | 5 mW | 5 mW |
| copper BAT_IN | 3 mW | 3 mW |
| copper BOOST_5V | 3 mW | 3 mW |
| copper ADS_5V_D | 2 mW | 2 mW |
| copper BOOST_SW | 2 mW | 2 mW |
| copper ADS_5V | 1 mW | 1 mW |
| copper GND pour | 1 mW | 1 mW |
| copper ESP_5V | 0 mW | 0 mW |
| copper ESP_5V_D | 0 mW | 0 mW |
| **Board total** | **445 mW** | **505 mW** |
| Modules (5 V power, heat inside the case) | 4.00 W | 3.97 W |
| Battery pack I²R | 115 mW | 173 mW |
| Inside the case | 4.56 W | 4.65 W |

Cell to 5 V output: 89.6 % nominal, 87.8 % high corner.

### Battery 3.1 V, 1.0 A load

Nominal corner: VSYS at L2 3.10 V, cell open-circuit voltage 3.30 V, battery current 1.75 A, boost input current 1.75 A, boost duty 41.2 %, boost efficiency 93.4 %.

| Element | Nominal | High |
|---|---|---|
| TPS61023 | 281 mW | 283 mW |
| L2 | 74 mW | 74 mW |
| copper VSYS | 38 mW | 38 mW |
| BQ25798 BATFET | 37 mW | 38 mW |
| F1 fuse | 34 mW | 46 mW |
| LEDs and series resistors | 32 mW | 32 mW |
| JST-PH battery contacts | 30 mW | 61 mW |
| shunts and module sockets | 26 mW | 51 mW |
| Module feed ideal diodes | 23 mW | 36 mW |
| copper RAIL_5V | 15 mW | 15 mW |
| copper CHG_BAT | 8 mW | 8 mW |
| ship FET | 8 mW | 20 mW |
| copper VBAT | 8 mW | 8 mW |
| OVLO dividers | 7 mW | 7 mW |
| copper BAT_IN | 5 mW | 5 mW |
| copper BOOST_5V | 4 mW | 4 mW |
| copper ADS_5V_D | 4 mW | 4 mW |
| copper BOOST_SW | 2 mW | 3 mW |
| copper ADS_5V | 2 mW | 2 mW |
| copper GND pour | 2 mW | 2 mW |
| copper ESP_5V | 0 mW | 0 mW |
| copper ESP_5V_D | 0 mW | 0 mW |
| **Board total** | **641 mW** | **737 mW** |
| Modules (5 V power, heat inside the case) | 4.98 W | 4.94 W |
| Battery pack I²R | 183 mW | 274 mW |
| Inside the case | 5.81 W | 5.95 W |

Cell to 5 V output: 87.8 % nominal, 85.6 % high corner.

### USB 3 A source, cell 3.7 V, 1.8 A host mode, TREG 100 °C, 0.8 A load

Nominal corner: charge current allowed by thermal regulation 1.80 A, VBUS at the connector 5.00 V, CHGIN at U4 4.89 V, VSYS 3.89 V, BATT at U4 3.86 V, input current 2.50 A, charge current 1.80 A, buck output current 2.90 A, buck duty 82.8 %, boost input current 1.10 A, BATFET mode: closed, charger efficiency 92.2 %, boost efficiency 95.3 %.

| Element | Nominal | High |
|---|---|---|
| BQ25798 buck | 788 mW | 782 mW |
| L1 | 172 mW | 171 mW |
| TPS61023 | 157 mW | 155 mW |
| copper CHG_SW1 | 99 mW | 98 mW |
| FB1 ferrite bead | 94 mW | 130 mW |
| copper USB_VBUS | 92 mW | 97 mW |
| copper CHG_SW2 | 90 mW | 90 mW |
| USB-C contacts | 63 mW | 130 mW |
| LEDs and series resistors | 60 mW | 60 mW |
| BQ25798 BATFET | 44 mW | 44 mW |
| L2 | 42 mW | 42 mW |
| F1 fuse | 36 mW | 49 mW |
| JST-PH battery contacts | 32 mW | 65 mW |
| copper USB_VBUS_J1 | 22 mW | 23 mW |
| shunts and module sockets | 16 mW | 33 mW |
| copper VSYS | 16 mW | 16 mW |
| Module feed ideal diodes | 15 mW | 24 mW |
| OVLO dividers | 11 mW | 11 mW |
| copper RAIL_5V | 10 mW | 10 mW |
| copper CHG_BAT | 9 mW | 9 mW |
| copper VBAT | 9 mW | 9 mW |
| ship FET | 8 mW | 21 mW |
| copper GND pour | 6 mW | 6 mW |
| copper BAT_IN | 5 mW | 5 mW |
| copper BOOST_5V | 3 mW | 3 mW |
| copper ADS_5V_D | 2 mW | 2 mW |
| copper ADS_5V | 1 mW | 1 mW |
| copper BOOST_SW | 1 mW | 1 mW |
| copper ESP_5V | 0 mW | 0 mW |
| copper ESP_5V_D | 0 mW | 0 mW |
| **Board total** | **1.91 W** | **2.09 W** |
| Modules (5 V power, heat inside the case) | 4.00 W | 3.97 W |
| Battery pack I²R | 194 mW | 292 mW |
| Inside the case | 6.10 W | 6.35 W |

### USB 3 A source, cell 3.2 V, 1.8 A host mode, TREG 100 °C, 0.8 A load

Nominal corner: charge current allowed by thermal regulation 1.80 A, VBUS at the connector 5.00 V, CHGIN at U4 4.90 V, VSYS 3.50 V, BATT at U4 3.36 V, input current 2.38 A, charge current 1.80 A, buck output current 3.03 A, buck duty 75.1 %, boost input current 1.23 A, BATFET mode: linear (VSYS held at VSYSMIN), charger efficiency 91.0 %, boost efficiency 94.7 %.

| Element | Nominal | High |
|---|---|---|
| BQ25798 buck | 865 mW | 859 mW |
| BQ25798 BATFET | 247 mW | 93 mW |
| L1 | 189 mW | 189 mW |
| TPS61023 | 179 mW | 180 mW |
| copper CHG_SW1 | 110 mW | 110 mW |
| copper CHG_SW2 | 101 mW | 100 mW |
| FB1 ferrite bead | 85 mW | 115 mW |
| copper USB_VBUS | 85 mW | 86 mW |
| LEDs and series resistors | 57 mW | 57 mW |
| USB-C contacts | 57 mW | 115 mW |
| L2 | 48 mW | 48 mW |
| F1 fuse | 36 mW | 49 mW |
| JST-PH battery contacts | 32 mW | 65 mW |
| copper VSYS | 21 mW | 21 mW |
| copper USB_VBUS_J1 | 20 mW | 21 mW |
| shunts and module sockets | 16 mW | 33 mW |
| Module feed ideal diodes | 15 mW | 24 mW |
| OVLO dividers | 11 mW | 11 mW |
| copper RAIL_5V | 10 mW | 10 mW |
| copper CHG_BAT | 9 mW | 9 mW |
| copper VBAT | 9 mW | 9 mW |
| ship FET | 8 mW | 21 mW |
| copper GND pour | 7 mW | 7 mW |
| copper BAT_IN | 5 mW | 5 mW |
| copper BOOST_5V | 3 mW | 3 mW |
| copper ADS_5V_D | 2 mW | 3 mW |
| copper ADS_5V | 1 mW | 1 mW |
| copper BOOST_SW | 1 mW | 1 mW |
| copper ESP_5V | 0 mW | 0 mW |
| copper ESP_5V_D | 0 mW | 0 mW |
| **Board total** | **2.23 W** | **2.24 W** |
| Modules (5 V power, heat inside the case) | 4.00 W | 3.97 W |
| Battery pack I²R | 194 mW | 292 mW |
| Inside the case | 6.42 W | 6.51 W |

### USB 3 A source, cell 3.2 V, 1.8 A host mode, TREG 100 °C, device off

Nominal corner: charge current allowed by thermal regulation 1.80 A, VBUS at the connector 5.00 V, CHGIN at U4 4.94 V, VSYS 3.50 V, BATT at U4 3.36 V, input current 1.37 A, charge current 1.80 A, buck output current 1.81 A, buck duty 72.7 %, boost input current 0.00 A, BATFET mode: linear (VSYS held at VSYSMIN), charger efficiency 93.3 %.

| Element | Nominal | High |
|---|---|---|
| BQ25798 buck | 383 mW | 381 mW |
| BQ25798 BATFET | 247 mW | 93 mW |
| L1 | 73 mW | 73 mW |
| F1 fuse | 36 mW | 49 mW |
| copper CHG_SW1 | 34 mW | 34 mW |
| JST-PH battery contacts | 32 mW | 65 mW |
| copper CHG_SW2 | 32 mW | 31 mW |
| FB1 ferrite bead | 28 mW | 38 mW |
| copper USB_VBUS | 25 mW | 25 mW |
| LEDs and series resistors | 24 mW | 24 mW |
| USB-C contacts | 19 mW | 38 mW |
| ship FET | 8 mW | 21 mW |
| copper CHG_BAT | 8 mW | 8 mW |
| copper VBAT | 8 mW | 8 mW |
| copper USB_VBUS_J1 | 6 mW | 6 mW |
| copper BAT_IN | 5 mW | 5 mW |
| OVLO dividers | 4 mW | 4 mW |
| copper GND pour | 3 mW | 3 mW |
| copper VSYS | 0 mW | 0 mW |
| **Board total** | **976 mW** | **905 mW** |
| Modules (5 V power, heat inside the case) | 0 mW | 0 mW |
| Battery pack I²R | 194 mW | 292 mW |
| Inside the case | 1.17 W | 1.20 W |

### USB 3 A source, cell 3.7 V, 1 A default mode, TREG 120 °C, 0.8 A load

Nominal corner: charge current allowed by thermal regulation 1.00 A, VBUS at the connector 5.00 V, CHGIN at U4 4.92 V, VSYS 3.80 V, BATT at U4 3.79 V, input current 1.76 A, charge current 1.00 A, buck output current 2.13 A, buck duty 79.6 %, boost input current 1.12 A, BATFET mode: closed, charger efficiency 93.3 %, boost efficiency 95.3 %.

| Element | Nominal | High |
|---|---|---|
| BQ25798 buck | 483 mW | 479 mW |
| TPS61023 | 158 mW | 156 mW |
| L1 | 98 mW | 98 mW |
| LEDs and series resistors | 59 mW | 59 mW |
| copper CHG_SW1 | 51 mW | 50 mW |
| copper CHG_SW2 | 47 mW | 46 mW |
| FB1 ferrite bead | 47 mW | 63 mW |
| copper USB_VBUS | 44 mW | 45 mW |
| L2 | 43 mW | 42 mW |
| USB-C contacts | 31 mW | 63 mW |
| shunts and module sockets | 16 mW | 33 mW |
| copper VSYS | 16 mW | 16 mW |
| Module feed ideal diodes | 15 mW | 24 mW |
| BQ25798 BATFET | 13 mW | 13 mW |
| OVLO dividers | 11 mW | 11 mW |
| F1 fuse | 11 mW | 15 mW |
| copper USB_VBUS_J1 | 10 mW | 11 mW |
| JST-PH battery contacts | 10 mW | 20 mW |
| copper RAIL_5V | 10 mW | 10 mW |
| copper GND pour | 3 mW | 3 mW |
| copper CHG_BAT | 3 mW | 3 mW |
| copper BOOST_5V | 3 mW | 3 mW |
| ship FET | 3 mW | 6 mW |
| copper VBAT | 3 mW | 3 mW |
| copper ADS_5V_D | 2 mW | 2 mW |
| copper BAT_IN | 1 mW | 2 mW |
| copper ADS_5V | 1 mW | 1 mW |
| copper BOOST_SW | 1 mW | 1 mW |
| copper ESP_5V | 0 mW | 0 mW |
| copper ESP_5V_D | 0 mW | 0 mW |
| **Board total** | **1.19 W** | **1.28 W** |
| Modules (5 V power, heat inside the case) | 4.00 W | 3.97 W |
| Battery pack I²R | 60 mW | 90 mW |
| Inside the case | 5.25 W | 5.34 W |

### USB 3 A source, cell 3.2 V, 1 A default mode, TREG 120 °C, 0.8 A load

Nominal corner: charge current allowed by thermal regulation 1.00 A, VBUS at the connector 5.00 V, CHGIN at U4 4.93 V, VSYS 3.50 V, BATT at U4 3.29 V, input current 1.71 A, charge current 1.00 A, buck output current 2.23 A, buck duty 73.6 %, boost input current 1.22 A, BATFET mode: linear (VSYS held at VSYSMIN), charger efficiency 92.5 %, boost efficiency 94.8 %.

| Element | Nominal | High |
|---|---|---|
| BQ25798 buck | 524 mW | 523 mW |
| BQ25798 BATFET | 210 mW | 162 mW |
| TPS61023 | 175 mW | 176 mW |
| L1 | 108 mW | 108 mW |
| LEDs and series resistors | 57 mW | 57 mW |
| copper CHG_SW1 | 57 mW | 57 mW |
| copper CHG_SW2 | 52 mW | 52 mW |
| L2 | 47 mW | 47 mW |
| FB1 ferrite bead | 44 mW | 59 mW |
| copper USB_VBUS | 42 mW | 42 mW |
| USB-C contacts | 29 mW | 59 mW |
| copper VSYS | 20 mW | 20 mW |
| shunts and module sockets | 16 mW | 33 mW |
| Module feed ideal diodes | 15 mW | 24 mW |
| OVLO dividers | 11 mW | 11 mW |
| F1 fuse | 11 mW | 15 mW |
| copper USB_VBUS_J1 | 10 mW | 10 mW |
| copper RAIL_5V | 10 mW | 10 mW |
| JST-PH battery contacts | 10 mW | 20 mW |
| copper GND pour | 3 mW | 3 mW |
| copper CHG_BAT | 3 mW | 3 mW |
| copper BOOST_5V | 3 mW | 3 mW |
| ship FET | 3 mW | 6 mW |
| copper VBAT | 3 mW | 3 mW |
| copper ADS_5V_D | 2 mW | 2 mW |
| copper BAT_IN | 2 mW | 2 mW |
| copper ADS_5V | 1 mW | 1 mW |
| copper BOOST_SW | 1 mW | 1 mW |
| copper ESP_5V | 0 mW | 0 mW |
| copper ESP_5V_D | 0 mW | 0 mW |
| **Board total** | **1.47 W** | **1.51 W** |
| Modules (5 V power, heat inside the case) | 4.00 W | 3.97 W |
| Battery pack I²R | 60 mW | 90 mW |
| Inside the case | 5.53 W | 5.57 W |

## Temperatures

Hot spots from the grid solution. "θJA" is the naive figure from the data sheet's JEDEC θJA with the same loss at the same ambient, for comparison only.

| Case | Environment | Ambient | Corner | Case air | U4 Tj | U6 Tj | U7 Tj | L1 | L2 | Board max | Hottest X7R | Pack |
|---|---|---|---|---|---|---|---|---|---|---|---|---|
| Battery 3.1 V, typical 1.22 W load | open | 25 °C | nominal | 25.0 | 26 (θJA 25) | 31 (θJA 32) | - | - | 27 | 28 | 27 (C18) | 25.1 |
| Battery 3.1 V, typical 1.22 W load | closed | 25 °C | nominal | 31.6 | 33 (θJA 25) | 38 (θJA 32) | - | - | 35 | 36 | 35 (C18) | 31.7 |
|  |  |  | high | 31.7 | 33 (θJA 25) | 38 (θJA 32) | - | - | 35 | 36 | 35 (C18) | 31.8 |
| Battery 3.1 V, typical 1.22 W load | closed | 50 °C | nominal | 56.7 | 58 (θJA 50) | 63 (θJA 57) | - | - | 60 | 61 | 60 (C18) | 56.8 |
|  |  |  | high | 56.7 | 58 (θJA 50) | 63 (θJA 57) | - | - | 60 | 61 | 60 (C18) | 56.9 |
| Battery 3.1 V, 0.8 A load | open | 25 °C | nominal | 25.0 | 28 (θJA 26) | 38 (θJA 42) | - | - | 31 | 33 | 30 (C18) | 26.1 |
| Battery 3.1 V, 0.8 A load | closed | 25 °C | nominal | 43.8 | 48 (θJA 26) | 60 (θJA 43) | - | - | 52 | 54 | 51 (C18) | 44.9 |
|  |  |  | high | 44.2 | 49 (θJA 26) | 61 (θJA 43) | - | - | 53 | 55 | 52 (C18) | 45.8 |
| Battery 3.1 V, 0.8 A load | closed | 50 °C | nominal | 69.1 | 73 (θJA 51) | 86 (θJA 69) | - | - | 77 | 80 | 77 (C18) | 70.2 |
|  |  |  | high | 69.5 | 74 (θJA 51) | 87 (θJA 69) | - | - | 78 | 81 | 78 (C18) | 71.1 |
| Battery 3.1 V, 1.0 A load | open | 25 °C | nominal | 25.0 | 29 (θJA 26) | 44 (θJA 49) | - | - | 33 | 36 | 33 (C18) | 26.7 |
| Battery 3.1 V, 1.0 A load | closed | 25 °C | nominal | 48.1 | 54 (θJA 27) | 71 (θJA 51) | - | - | 59 | 63 | 59 (C18) | 49.8 |
|  |  |  | high | 48.6 | 55 (θJA 27) | 72 (θJA 51) | - | - | 61 | 64 | 60 (C18) | 51.2 |
| Battery 3.1 V, 1.0 A load | closed | 50 °C | nominal | 73.6 | 80 (θJA 52) | 98 (θJA 78) | - | - | 85 | 89 | 85 (C18) | 75.3 |
|  |  |  | high | 74.1 | 81 (θJA 52) | 99 (θJA 78) | - | - | 87 | 91 | 86 (C18) | 76.6 |
| USB 3 A source, cell 3.7 V, 1.8 A host mode, TREG 100 °C, 0.8 A load | open | 25 °C | nominal | 25.0 | 50 (θJA 59) | 44 (θJA 38) | - | 44 | 40 | 47 | 44 (C6) | 26.8 |
| USB 3 A source, cell 3.7 V, 1.8 A host mode, TREG 100 °C, 0.8 A load | closed | 25 °C | nominal | 49.1 | 83 (θJA 62) | 76 (θJA 39) | - | 76 | 71 | 80 | 76 (C6) | 50.9 |
|  |  |  | high | 49.9 | 85 (θJA 62) | 79 (θJA 39) | - | 79 | 75 | 82 | 78 (C6) | 52.6 |
| USB 3 A source, cell 3.2 V, 1.8 A host mode, TREG 100 °C, 0.8 A load | open | 25 °C | nominal | 25.0 | 57 (θJA 71) | 47 (θJA 40) | - | 47 | 42 | 52 | 47 (C6) | 26.8 |
| USB 3 A source, cell 3.2 V, 1.8 A host mode, TREG 100 °C, 0.8 A load | closed | 25 °C | nominal | 50.2 | 92 (θJA 74) | 81 (θJA 41) | - | 81 | 76 | 87 | 82 (C6) | 52.0 |
|  |  |  | high | 50.5 | 90 (θJA 67) | 82 (θJA 41) | - | 82 | 77 | 86 | 81 (C6) | 53.1 |
| USB 3 A source, cell 3.2 V, 1.8 A host mode, TREG 100 °C, device off | open | 25 °C | nominal | 25.0 | 42 (θJA 53) | - | - | 35 | - | 39 | 36 (C6) | 26.8 |
| USB 3 A source, cell 3.2 V, 1.8 A host mode, TREG 100 °C, device off | closed | 25 °C | nominal | 30.7 | 52 (θJA 53) | - | - | 44 | - | 48 | 45 (C6) | 32.5 |
|  |  |  | high | 30.8 | 48 (θJA 46) | - | - | 43 | - | 46 | 44 (C6) | 33.5 |
| USB 3 A source, cell 3.7 V, 1 A default mode, TREG 120 °C, 0.8 A load | open | 25 °C | nominal | 25.0 | 40 (θJA 46) | 41 (θJA 39) | - | 37 | 35 | 38 | 37 (C6) | 25.6 |
| USB 3 A source, cell 3.7 V, 1 A default mode, TREG 120 °C, 0.8 A load | closed | 25 °C | nominal | 46.2 | 67 (θJA 47) | 67 (θJA 39) | - | 63 | 61 | 65 | 63 (C6) | 46.8 |
|  |  |  | high | 46.5 | 68 (θJA 47) | 68 (θJA 39) | - | 64 | 63 | 66 | 64 (C6) | 47.4 |
| USB 3 A source, cell 3.2 V, 1 A default mode, TREG 120 °C, 0.8 A load | open | 25 °C | nominal | 25.0 | 46 (θJA 56) | 43 (θJA 40) | - | 39 | 37 | 43 | 40 (C6) | 25.6 |
| USB 3 A source, cell 3.2 V, 1 A default mode, TREG 120 °C, 0.8 A load | closed | 25 °C | nominal | 47.2 | 75 (θJA 57) | 71 (θJA 41) | - | 67 | 65 | 71 | 68 (C6) | 47.7 |
|  |  |  | high | 47.3 | 74 (θJA 55) | 72 (θJA 41) | - | 68 | 66 | 71 | 68 (C6) | 48.2 |

All temperatures in °C. Board max is the hottest grid cell (1 mm), not a pad.

## Checks

- PASS: USB 3 A source, cell 3.7 V, 1.8 A host mode, TREG 100 °C, 0.8 A load, open bench, 25 °C: full 1.8 A charge current (U4 junction 50 °C, regulation at 100 °C)
- PASS: USB 3 A source, cell 3.2 V, 1.8 A host mode, TREG 100 °C, 0.8 A load, open bench, 25 °C: full 1.8 A charge current (U4 junction 57 °C, regulation at 100 °C)
- PASS: USB 3 A source, cell 3.2 V, 1.8 A host mode, TREG 100 °C, device off, open bench, 25 °C: full 1.8 A charge current (U4 junction 42 °C, regulation at 100 °C)
- PASS: USB 3 A source, cell 3.7 V, 1 A default mode, TREG 120 °C, 0.8 A load, open bench, 25 °C: full 1.0 A charge current (U4 junction 40 °C, regulation at 120 °C)
- PASS: USB 3 A source, cell 3.2 V, 1 A default mode, TREG 120 °C, 0.8 A load, open bench, 25 °C: full 1.0 A charge current (U4 junction 46 °C, regulation at 120 °C)
- PASS: TPS61023 junction at most 99 °C (Battery 3.1 V, 1.0 A load, 50 °C ambient, high corner, closed case), limit 125 °C
- PASS: L1 winding at most 82 °C (Battery 3.1 V, 1.0 A load, 50 °C ambient, high corner, closed case), limit 125 °C
- PASS: L2 winding at most 87 °C (Battery 3.1 V, 1.0 A load, 50 °C ambient, high corner, closed case), limit 125 °C
- PASS: hottest board cell 90.8 °C (Battery 3.1 V, 1.0 A load, 50 °C ambient, high corner, closed case); limit 125 °C (FR4 Tg 130 °C and up)
- PASS: X7R bulk capacitors at 25 °C ambient, closed case: hottest C6 at 82 °C (USB 3 A source, cell 3.2 V, 1.8 A host mode, TREG 100 °C, 0.8 A load, nominal corner), rating 125 °C
- PASS: X7R bulk capacitors at 50 °C ambient, closed case: hottest C18 at 86 °C (Battery 3.1 V, 1.0 A load, high corner), rating 125 °C
- PASS: Battery 3.1 V, typical 1.22 W load, closed case, 25 °C ambient, high corner: pack at 31.8 °C; it must stay below the thermostat's lowest opening point 55 °C (60 °C ± 5 K)
- PASS: Battery 3.1 V, 0.8 A load, closed case, 25 °C ambient, high corner: pack at 45.8 °C; it must stay below the thermostat's lowest opening point 55 °C (60 °C ± 5 K)
- PASS: Battery 3.1 V, 1.0 A load, closed case, 25 °C ambient, high corner: pack at 51.2 °C; it must stay below the thermostat's lowest opening point 55 °C (60 °C ± 5 K)
- PASS: battery current at most 1.80 A through J3, JST PH rating 2 A (AWG 24)
- PASS: USB input current at most 2.55 A, MC-107DMS rating 5 A

## Charger thermal regulation

The BQ25798 holds its junction at TREG by reducing the charge current (register setting, default 120 °C, options 60 / 80 / 100 / 120 °C). Below zero charge current the model lets the input current fall so that the battery supplements the system. The table gives the charge current the board sustains in steady state at the TREG of each case. Negative: the battery discharges into the load although USB is present.

| Case | Environment | Corner | TREG | Charge current | Input current | U4 Tj | U4 loss |
|---|---|---|---|---|---|---|---|
| USB 3 A source, cell 3.7 V, 1.8 A host mode, TREG 100 °C, 0.8 A load | open bench, no enclosure | nominal | 100 °C | 1.80 A | 2.48 A | 50 °C | 0.76 W |
| USB 3 A source, cell 3.7 V, 1.8 A host mode, TREG 100 °C, 0.8 A load | closed 3D-printed case | nominal | 100 °C | 1.80 A | 2.50 A | 83 °C | 0.83 W |
| USB 3 A source, cell 3.7 V, 1.8 A host mode, TREG 100 °C, 0.8 A load | closed 3D-printed case | high | 100 °C | 1.80 A | 2.55 A | 85 °C | 0.83 W |
| USB 3 A source, cell 3.2 V, 1.8 A host mode, TREG 100 °C, 0.8 A load | open bench, no enclosure | nominal | 100 °C | 1.80 A | 2.36 A | 57 °C | 1.03 W |
| USB 3 A source, cell 3.2 V, 1.8 A host mode, TREG 100 °C, 0.8 A load | closed 3D-printed case | nominal | 100 °C | 1.80 A | 2.38 A | 92 °C | 1.11 W |
| USB 3 A source, cell 3.2 V, 1.8 A host mode, TREG 100 °C, 0.8 A load | closed 3D-printed case | high | 100 °C | 1.80 A | 2.40 A | 90 °C | 0.95 W |
| USB 3 A source, cell 3.2 V, 1.8 A host mode, TREG 100 °C, device off | open bench, no enclosure | nominal | 100 °C | 1.80 A | 1.37 A | 42 °C | 0.62 W |
| USB 3 A source, cell 3.2 V, 1.8 A host mode, TREG 100 °C, device off | closed 3D-printed case | nominal | 100 °C | 1.80 A | 1.37 A | 52 °C | 0.63 W |
| USB 3 A source, cell 3.2 V, 1.8 A host mode, TREG 100 °C, device off | closed 3D-printed case | high | 100 °C | 1.80 A | 1.38 A | 48 °C | 0.47 W |
| USB 3 A source, cell 3.7 V, 1 A default mode, TREG 120 °C, 0.8 A load | open bench, no enclosure | nominal | 120 °C | 1.00 A | 1.75 A | 40 °C | 0.46 W |
| USB 3 A source, cell 3.7 V, 1 A default mode, TREG 120 °C, 0.8 A load | closed 3D-printed case | nominal | 120 °C | 1.00 A | 1.76 A | 67 °C | 0.50 W |
| USB 3 A source, cell 3.7 V, 1 A default mode, TREG 120 °C, 0.8 A load | closed 3D-printed case | high | 120 °C | 1.00 A | 1.78 A | 68 °C | 0.49 W |
| USB 3 A source, cell 3.2 V, 1 A default mode, TREG 120 °C, 0.8 A load | open bench, no enclosure | nominal | 120 °C | 1.00 A | 1.70 A | 46 °C | 0.70 W |
| USB 3 A source, cell 3.2 V, 1 A default mode, TREG 120 °C, 0.8 A load | closed 3D-printed case | nominal | 120 °C | 1.00 A | 1.71 A | 75 °C | 0.73 W |
| USB 3 A source, cell 3.2 V, 1 A default mode, TREG 120 °C, 0.8 A load | closed 3D-printed case | high | 120 °C | 1.00 A | 1.72 A | 74 °C | 0.68 W |

## U4 heatsink against the bare board

The same operating points solved without the heatsink. It moves heat from the die into the surrounding air. In the closed case that air is the case air, whose temperature it does not change.

| Case | Environment | Corner | U4 junction, bare to heatsink | Charge current, bare to heatsink | Heat through the heatsink | U4 junction to air, bare to heatsink |
|---|---|---|---|---|---|---|
| USB 3 A source, cell 3.7 V, 1.8 A host mode, TREG 100 °C, 0.8 A load | open bench, no enclosure | nominal | 62 to 50 °C | 1.80 to 1.80 A | 0.33 W of 0.76 W | 49 to 33 K/W |
| USB 3 A source, cell 3.7 V, 1.8 A host mode, TREG 100 °C, 0.8 A load | closed 3D-printed case | nominal | 98 to 83 °C | 1.80 to 1.80 A | 0.34 W of 0.83 W | 58 to 41 K/W |
| USB 3 A source, cell 3.7 V, 1.8 A host mode, TREG 100 °C, 0.8 A load | closed 3D-printed case | high | 100 to 85 °C | 1.79 to 1.80 A | 0.36 W of 0.83 W | 61 to 43 K/W |
| USB 3 A source, cell 3.2 V, 1.8 A host mode, TREG 100 °C, 0.8 A load | open bench, no enclosure | nominal | 72 to 57 °C | 1.80 to 1.80 A | 0.42 W of 1.03 W | 46 to 31 K/W |
| USB 3 A source, cell 3.2 V, 1.8 A host mode, TREG 100 °C, 0.8 A load | closed 3D-printed case | nominal | 100 to 92 °C | 1.48 to 1.80 A | 0.43 W of 1.11 W | 46 to 38 K/W |
| USB 3 A source, cell 3.2 V, 1.8 A host mode, TREG 100 °C, 0.8 A load | closed 3D-printed case | high | 100 to 90 °C | 1.57 to 1.80 A | 0.40 W of 0.95 W | 53 to 41 K/W |
| USB 3 A source, cell 3.2 V, 1.8 A host mode, TREG 100 °C, device off | open bench, no enclosure | nominal | 50 to 42 °C | 1.80 to 1.80 A | 0.23 W of 0.62 W | 41 to 28 K/W |
| USB 3 A source, cell 3.2 V, 1.8 A host mode, TREG 100 °C, device off | closed 3D-printed case | nominal | 60 to 52 °C | 1.80 to 1.80 A | 0.21 W of 0.63 W | 47 to 33 K/W |
| USB 3 A source, cell 3.2 V, 1.8 A host mode, TREG 100 °C, device off | closed 3D-printed case | high | 55 to 48 °C | 1.80 to 1.80 A | 0.18 W of 0.47 W | 52 to 37 K/W |
| USB 3 A source, cell 3.7 V, 1 A default mode, TREG 120 °C, 0.8 A load | open bench, no enclosure | nominal | 48 to 40 °C | 1.00 to 1.00 A | 0.20 W of 0.46 W | 49 to 33 K/W |
| USB 3 A source, cell 3.7 V, 1 A default mode, TREG 120 °C, 0.8 A load | closed 3D-printed case | nominal | 75 to 67 °C | 1.00 to 1.00 A | 0.21 W of 0.50 W | 58 to 41 K/W |
| USB 3 A source, cell 3.7 V, 1 A default mode, TREG 120 °C, 0.8 A load | closed 3D-printed case | high | 76 to 68 °C | 1.00 to 1.00 A | 0.21 W of 0.49 W | 60 to 43 K/W |
| USB 3 A source, cell 3.2 V, 1 A default mode, TREG 120 °C, 0.8 A load | open bench, no enclosure | nominal | 56 to 46 °C | 1.00 to 1.00 A | 0.28 W of 0.70 W | 45 to 30 K/W |
| USB 3 A source, cell 3.2 V, 1 A default mode, TREG 120 °C, 0.8 A load | closed 3D-printed case | nominal | 86 to 75 °C | 1.00 to 1.00 A | 0.28 W of 0.73 W | 53 to 37 K/W |
| USB 3 A source, cell 3.2 V, 1 A default mode, TREG 120 °C, 0.8 A load | closed 3D-printed case | high | 85 to 74 °C | 1.00 to 1.00 A | 0.27 W of 0.68 W | 55 to 39 K/W |
| Battery 3.1 V, 0.8 A load | open bench, no enclosure | nominal | 29 to 28 °C | - | 0.03 W of 0.02 W | 177 to 122 K/W |
| Battery 3.1 V, 0.8 A load | closed 3D-printed case | nominal | 49 to 48 °C | - | 0.04 W of 0.02 W | 245 to 177 K/W |
| Battery 3.1 V, 1.0 A load | open bench, no enclosure | nominal | 30 to 29 °C | - | 0.05 W of 0.03 W | 162 to 111 K/W |
| Battery 3.1 V, 1.0 A load | closed 3D-printed case | nominal | 56 to 54 °C | - | 0.06 W of 0.04 W | 222 to 160 K/W |

Junction to air is the junction rise over the surrounding air divided by the U4 loss at the operating point with the heatsink. In regulation the loss differs between the two solutions.

## Charging and the pack temperature window

The charger reads the pack NTC. Above 31.4 °C it lowers the termination voltage to 4.05 V, above 42.1 °C it stops (nominal thresholds, docs/power.md). In the closed case the pack sits in the case air, so the ambient at which these are reached is:

| Case | Corner | Pack above ambient | Ambient for 4.05 V limit | Ambient for charge stop |
|---|---|---|---|---|
| USB 3 A source, cell 3.7 V, 1.8 A host mode, TREG 100 °C, 0.8 A load | nominal | 25.9 K | 5.5 °C | 16.2 °C |
|  | high | 27.6 K | 3.8 °C | 14.5 °C |
| USB 3 A source, cell 3.2 V, 1.8 A host mode, TREG 100 °C, 0.8 A load | nominal | 27.0 K | 4.4 °C | 15.1 °C |
|  | high | 28.1 K | 3.3 °C | 14.0 °C |
| USB 3 A source, cell 3.2 V, 1.8 A host mode, TREG 100 °C, device off | nominal | 7.5 K | 23.9 °C | 34.6 °C |
|  | high | 8.5 K | 22.9 °C | 33.6 °C |
| USB 3 A source, cell 3.7 V, 1 A default mode, TREG 120 °C, 0.8 A load | nominal | 21.8 K | 9.6 °C | 20.3 °C |
|  | high | 22.4 K | 9.0 °C | 19.7 °C |
| USB 3 A source, cell 3.2 V, 1 A default mode, TREG 120 °C, 0.8 A load | nominal | 22.7 K | 8.7 °C | 19.4 °C |
|  | high | 23.2 K | 8.2 °C | 18.9 °C |

On the open bench the pack rises only by its own I²R loss (a few tenths of a kelvin at 1.8 A).

## Limits of the model

- Steady state only. The 1.5 A output margin is short-term headroom and not a thermal case.
- The enclosure is not designed. Its size, material, vents and the battery position decide the case-air rise, which dominates the absolute temperatures in the closed case. The modules' 5 V power is most of the heat in it.
- Board-to-air coefficients are lumped (one value per face). Modules on the top side shade the board; their own heat reaches the board only through the case air, not through the header pins.
- The BQ25798 switching loss is fitted to the data sheet efficiency curve at 5 V in and 4 V out (read off the figure, about half a point of accuracy), so it carries the data sheet's test board and inductor.
- BQ25798: RθJB 9.7 K/W from junction to pins (RθJC(top) 20.9, ψJT 0.5 K/W).
- The U4 heatsink path is an estimate on top of that: junction to package top is not published for the FC2QFN (25 to 45 K/W assumed), the epoxy layers depend on the assembly, and the sink rating is a free-air figure derated for the lower temperature rise and the case air. Bench item: thermocouple on the sink base.
- Contact, fuse and pack resistances are data sheet maxima or estimates (see the input table). The USB cable is not included; its drop lowers CHGIN towards the 4.5 V input regulation threshold.
- Only DC currents are solved in the copper. Ripple currents in the capacitor loops and their ESR losses are small and stay inside the converter footprints.
- Bench verification: thermocouple or IR camera on U4, U6, L1, L2 and the pack at the charging case with the real enclosure, and at the 3.1 V / 0.8 A battery case.

Run time 7 s, grid 105 x 95 x 4 nodes.

Result: all checks pass.
