mp911de/airgrep/hardware/sim/heat/ti/results_tps61378q1.md

# Power loss and temperature estimate, TPS61378-Q1 candidate

Candidate assumption: Candidate silicon at the present U6 thermal location. The internal 100 mOhm isolation FET replaces U7. The proposed 300 kHz setting uses the stocked 3.3 uH CKST0603 variant and requires a switch/output-capacitor loop no larger than 2.5 mm2. The real candidate layout does not exist.

Generated by `hardware/sim/run_heat.py` from `hardware/carrier-ti-charger/carrier.kicad_pcb` (charger BQ25798). See `hardware/sim/README.md` for what is and is not modelled.

## Board as read

105 x 95 mm, four layers (JLC04161H-2116C): 35 µm outer and 15.2 µm inner copper, 0.20 / 1.065 / 0.20 mm dielectric. Copper share from the zone fills, tracks, pads and vias on a 1.0 mm grid: F 79 %, In1 91 %, In2 86 %, B 91 %. 206 vias, 71 of them GND. Zone fills are taken as stored in the file. Refill them before running after a layout change.

## Solver check

One copper layer with FR4, 10 W/m²K on each face, 1 W point source, against the infinite-plate solution P·K0(m·r) / (2π·k·t):

| Distance | Grid | Analytic | Error |
|---|---|---|---|
| 3 mm | 25.12 K | 24.99 K | +0.6 % |
| 5 mm | 19.71 K | 19.66 K | +0.3 % |
| 10 mm | 12.77 K | 12.75 K | +0.2 % |
| 20 mm | 6.72 K | 6.71 K | +0.2 % |

- PASS: grid solution within 5 % of the analytic plate from 5 mm on (worst 0.3 %)

## Loss model inputs

| Element | Value | Source |
|---|---|---|
| BQ25798 input / high side / low side / series switch / BATFET | 8 / 24 / 35 / 28 / 11 mΩ typ | SLUSDV2C, Electrical Characteristics and section 6.7 |
| BQ25798 switching | 0.75 MHz; K 0.00 ns and P0 151 mW fitted to the data sheet efficiency curve | data sheet section 6.7, VBUS 5 V, VBAT 4 V |
| BQ25798 input supply current | 3.0 mA | data sheet, typ |
| BQ25798 VSYSMIN | 3.5 V; below it the BATFET regulates linearly | data sheet |
| TPS61378-Q1 high side / low side | 50 / 50 mΩ typ | SLVSET0E |
| L1 FXL0630-2R2-M / L2 CENKER CKST0603-3.3uH/M (C3002635) | 15.0 / 23.0 mΩ DCR, core loss 20 mW each | docs/power.md, vendor tables; core loss estimate |
| TPS22975 | removed by integrated disconnect | SLVSCI1 |
| TPS259474L ideal diodes U11, U12 | drop regulated to 16.9 / 28.4 mV, 28.2 / 45.0 mΩ above that | SLVSFC9C, high forward drop assumed, no specified maximum |
| On-resistance temperature coefficient | +0.4 %/K | estimate |
| USB-C contacts (4 VBUS, 4 GND) | 20 / 40 mΩ each | Hanbo MC-107DMS: 40 mΩ max |
| JST-PH battery contacts | 5 / 10 mΩ each | JST PH: 10 mΩ max initial |
| Shunts and module sockets | 10 / 20 mΩ per contact | estimate |
| F1 Littelfuse 0466005.NRHF 5 A (C57525) | 11 / 15 mΩ | nominal cold resistance, datasheets/littelfuse-466.pdf; high corner estimate |
| Battery pack, DC | 60 / 90 mΩ | at most 50 mΩ AC 1 kHz in the pack data sheet; DC estimate |
| Copper | 1.72 µΩ·cm at 20 °C, +0.393 %/K, tracks and pour at their local temperature |  |

Where two values are given, the first is the nominal corner and the second the high corner.

TPS61378-Q1 switching term: P = K · VOUT · IIN · fSW + P0 with K = 4.49 ns and P0 = 51 mW. It is fitted to what TI TPS61378-Q1 Figure 6-2, 3.3 V FPWM curve at 2.2 MHz read to about one percentage point at 3.3 V leaves after switch conduction, L2 DCR and core loss.

| IOUT | Curve η | Model η |
|---|---|---|
| 0.2 A | 91.0 % | 91.5 % |
| 0.5 A | 92.5 % | 93.9 % |
| 0.8 A | 92.0 % | 93.1 % |
| 1.0 A | 91.0 % | 92.2 % |
| 1.5 A | 87.0 % | 89.0 % |
| 2.0 A | 84.0 % | 85.1 % |

- PASS: minimum calculated output before peak current limit 1.63 A at 3.1 V, L2 −20 % and 90 % efficiency; 1.5 A is safety margin, not sustained load
- PASS: 1.5 A safety load gives 3.77 A peak in L2, below 9.5 A at 10 % inductance drop

## Copper path resistances at 20 °C

Each power net is solved as a resistor network of its tracks and vias. Pads are nodes, and the pins of a group share the current equally. GND is a four-layer sheet on the grid.

| Path | Resistance |
|---|---|
| USB_VBUS_J1: J1 VBUS pins to FB1 | 2.9 mΩ |
| USB_VBUS: FB1 to U4 VBUS | 12.1 mΩ |
| CHG_SW1: U4 SW1 to L1 | 9.6 mΩ |
| CHG_SW2: L1 to U4 SW2 | 8.8 mΩ |
| VSYS: U4 SYS to L2 | 11.0 mΩ |
| VBAT + CHG_BAT: F1 through Q13 to U4 BAT (copper only) | 4.6 mΩ |
| BAT_IN: J3 to F1 | 1.3 mΩ |
| BOOST_SW: L2 to U6 SW | 0.7 mΩ |
| BOOST_5V: U6 VOUT to U7 VIN | 3.7 mΩ |
| RAIL_5V: U7 VOUT to U11 IN | 13.3 mΩ |
| U12 OUT to JP1 | 6.2 mΩ |
| U11 OUT to JP2 | 4.6 mΩ |
| ADS_5V: JP2 to J10 | 2.4 mΩ |
| ESP_5V: JP1 to J7 | 9.2 mΩ |
| GND: J3 pin 2 to U6 ground pads | 0.8 mΩ |
| GND: J1 GND pins to U4 GND | 3.3 mΩ |

## Thermal environment

- Open bench: board in still air, 10 W/m²K on both faces (convection plus radiation), no enclosure.
- Closed case (not yet designed; assumed): 115 x 105 x 40 mm outside, 2 mm printed wall (k 0.2 W/m·K), 7 W/m²K inside and 9 W/m²K outside. Wall path to ambient 6.3 K/W over 418 cm². Inside it the board loses 6 W/m²K per face to the case air (modules above, battery below). The air carries everything dissipated in the case: board losses, the modules' 5 V power and the pack's own I²R. The pack: 9.2 K/W to the case air.
- Vents: 2 lower inlets and 2 upper outlets, 8.0 cm² each (16.0 cm² per group), 50 % open grille, 35 mm vertical separation, discharge coefficient 0.6. Natural draft acts in parallel with the wall path; no fan.
- Junction to board: BQ25798 RθJB 9.7 K/W from junction to pins (RθJC(top) 20.9, ψJT 0.5 K/W), TPS61378-Q1 18.5 K/W, TPS22975 RθJC(bot) 16.4 K/W; inductor winding to terminals 12 K/W.
- U4 heatsink: 10 x 10 mm aluminium sink (Fischer ICK S 10 x 10 x 6.5) on a 1.5 mm copper spacer, thermal epoxy. Junction to package top 21 K/W, epoxy and spacer 20 K/W, sink to air 35 K/W on the bench and 58 K/W in the case air. That gives 76 and 99 K/W from the junction, in parallel with the pins. Parts with pads inside the 10 x 10 mm footprint of the sink: C42, C43, C44, C46, C47, C6, R56, R58, R59. The spacer must lift the sink base above the tallest of them.

## Operating points and losses

Board losses for the closed case at 25 °C ambient, with copper and on-resistance at their computed temperatures. Battery cases: the boost input is held at 3.1 V, the low-battery design point of docs/power.md. The cell open-circuit voltage that gives it follows from the path. USB cases: 5.0 V at the connector (cable drop not included), charge current as labelled unless the 3 A input limit reduces it.

### Battery 3.1 V, typical 1.22 W load

Nominal corner: VSYS at L2 3.10 V, cell open-circuit voltage 3.15 V, battery current 0.43 A, boost input current 0.43 A, boost duty 40.5 %, boost efficiency 92.2 %.

| Element | Nominal | High |
|---|---|---|
| TPS61378-Q1 | 77 mW | 77 mW |
| LEDs and series resistors | 33 mW | 33 mW |
| L2 | 28 mW | 28 mW |
| OVLO dividers | 8 mW | 8 mW |
| Module feed ideal diodes | 4 mW | 7 mW |
| copper VSYS | 2 mW | 2 mW |
| BQ25798 BATFET | 2 mW | 2 mW |
| F1 fuse | 2 mW | 3 mW |
| JST-PH battery contacts | 2 mW | 4 mW |
| shunts and module sockets | 1 mW | 3 mW |
| copper RAIL_5V | 1 mW | 1 mW |
| ship FET | 0 mW | 1 mW |
| copper CHG_BAT | 0 mW | 0 mW |
| copper VBAT | 0 mW | 0 mW |
| copper BAT_IN | 0 mW | 0 mW |
| copper BOOST_5V | 0 mW | 0 mW |
| copper ADS_5V_D | 0 mW | 0 mW |
| copper BOOST_SW | 0 mW | 0 mW |
| copper ADS_5V | 0 mW | 0 mW |
| copper GND pour | 0 mW | 0 mW |
| copper ESP_5V | 0 mW | 0 mW |
| copper ESP_5V_D | 0 mW | 0 mW |
| **Board total** | **162 mW** | **170 mW** |
| Modules (5 V power, heat inside the case) | 1.24 W | 1.23 W |
| Battery pack I²R | 11 mW | 17 mW |
| Inside the case | 1.41 W | 1.42 W |

Cell to 5 V output: 90.8 % nominal, 90.2 % high corner.

### Battery 3.1 V, 0.8 A load

Nominal corner: VSYS at L2 3.10 V, cell open-circuit voltage 3.26 V, battery current 1.44 A, boost input current 1.44 A, boost duty 42.1 %, boost efficiency 92.4 %.

| Element | Nominal | High |
|---|---|---|
| TPS61378-Q1 | 261 mW | 262 mW |
| L2 | 77 mW | 77 mW |
| LEDs and series resistors | 33 mW | 33 mW |
| copper VSYS | 25 mW | 26 mW |
| BQ25798 BATFET | 25 mW | 25 mW |
| F1 fuse | 23 mW | 31 mW |
| JST-PH battery contacts | 21 mW | 41 mW |
| shunts and module sockets | 16 mW | 33 mW |
| Module feed ideal diodes | 15 mW | 24 mW |
| copper RAIL_5V | 10 mW | 10 mW |
| OVLO dividers | 8 mW | 8 mW |
| copper CHG_BAT | 5 mW | 5 mW |
| ship FET | 5 mW | 13 mW |
| copper VBAT | 5 mW | 5 mW |
| copper BAT_IN | 3 mW | 3 mW |
| copper BOOST_5V | 3 mW | 3 mW |
| copper ADS_5V_D | 2 mW | 2 mW |
| copper BOOST_SW | 2 mW | 2 mW |
| copper ADS_5V | 1 mW | 1 mW |
| copper GND pour | 1 mW | 1 mW |
| copper ESP_5V | 0 mW | 0 mW |
| copper ESP_5V_D | 0 mW | 0 mW |
| **Board total** | **542 mW** | **606 mW** |
| Modules (5 V power, heat inside the case) | 4.07 W | 4.05 W |
| Battery pack I²R | 124 mW | 186 mW |
| Inside the case | 4.74 W | 4.84 W |

Cell to 5 V output: 87.8 % nominal, 86.0 % high corner.

### Battery 3.1 V, 1.0 A load

Nominal corner: VSYS at L2 3.10 V, cell open-circuit voltage 3.31 V, battery current 1.82 A, boost input current 1.82 A, boost duty 42.9 %, boost efficiency 91.1 %.

| Element | Nominal | High |
|---|---|---|
| TPS61378-Q1 | 392 mW | 394 mW |
| L2 | 112 mW | 113 mW |
| copper VSYS | 42 mW | 42 mW |
| BQ25798 BATFET | 41 mW | 41 mW |
| F1 fuse | 37 mW | 50 mW |
| JST-PH battery contacts | 33 mW | 67 mW |
| LEDs and series resistors | 33 mW | 33 mW |
| shunts and module sockets | 26 mW | 51 mW |
| Module feed ideal diodes | 23 mW | 36 mW |
| copper RAIL_5V | 16 mW | 16 mW |
| copper CHG_BAT | 9 mW | 9 mW |
| ship FET | 9 mW | 21 mW |
| copper VBAT | 8 mW | 8 mW |
| OVLO dividers | 8 mW | 8 mW |
| copper BAT_IN | 5 mW | 5 mW |
| copper BOOST_5V | 4 mW | 4 mW |
| copper ADS_5V_D | 4 mW | 4 mW |
| copper BOOST_SW | 3 mW | 3 mW |
| copper ADS_5V | 2 mW | 2 mW |
| copper GND pour | 2 mW | 2 mW |
| copper ESP_5V | 0 mW | 0 mW |
| copper ESP_5V_D | 0 mW | 0 mW |
| **Board total** | **808 mW** | **910 mW** |
| Modules (5 V power, heat inside the case) | 5.08 W | 5.04 W |
| Battery pack I²R | 200 mW | 300 mW |
| Inside the case | 6.09 W | 6.25 W |

Cell to 5 V output: 85.4 % nominal, 83.1 % high corner.

### USB 3 A source, cell 3.7 V, 1.8 A host mode, TREG 100 °C, 0.8 A load

Nominal corner: charge current allowed by thermal regulation 1.80 A, VBUS at the connector 5.00 V, CHGIN at U4 4.89 V, VSYS 3.89 V, BATT at U4 3.86 V, input current 2.54 A, charge current 1.80 A, buck output current 2.94 A, buck duty 82.9 %, boost input current 1.14 A, BATFET mode: closed, charger efficiency 92.1 %, boost efficiency 93.7 %.

| Element | Nominal | High |
|---|---|---|
| BQ25798 buck | 810 mW | 804 mW |
| TPS61378-Q1 | 221 mW | 218 mW |
| L1 | 177 mW | 176 mW |
| copper CHG_SW1 | 102 mW | 101 mW |
| FB1 ferrite bead | 97 mW | 134 mW |
| copper USB_VBUS | 95 mW | 100 mW |
| copper CHG_SW2 | 94 mW | 93 mW |
| USB-C contacts | 65 mW | 134 mW |
| LEDs and series resistors | 60 mW | 61 mW |
| L2 | 58 mW | 57 mW |
| BQ25798 BATFET | 44 mW | 45 mW |
| F1 fuse | 36 mW | 49 mW |
| JST-PH battery contacts | 32 mW | 65 mW |
| copper USB_VBUS_J1 | 23 mW | 24 mW |
| copper VSYS | 18 mW | 17 mW |
| shunts and module sockets | 16 mW | 33 mW |
| Module feed ideal diodes | 15 mW | 24 mW |
| OVLO dividers | 11 mW | 11 mW |
| copper RAIL_5V | 10 mW | 10 mW |
| copper CHG_BAT | 9 mW | 9 mW |
| copper VBAT | 9 mW | 9 mW |
| ship FET | 8 mW | 21 mW |
| copper GND pour | 6 mW | 6 mW |
| copper BAT_IN | 5 mW | 5 mW |
| copper BOOST_5V | 3 mW | 3 mW |
| copper ADS_5V_D | 2 mW | 3 mW |
| copper ADS_5V | 1 mW | 1 mW |
| copper BOOST_SW | 1 mW | 1 mW |
| copper ESP_5V | 0 mW | 0 mW |
| copper ESP_5V_D | 0 mW | 0 mW |
| **Board total** | **2.03 W** | **2.21 W** |
| Modules (5 V power, heat inside the case) | 4.07 W | 4.05 W |
| Battery pack I²R | 194 mW | 292 mW |
| Inside the case | 6.30 W | 6.55 W |

### USB 3 A source, cell 3.2 V, 1.8 A host mode, TREG 100 °C, 0.8 A load

Nominal corner: charge current allowed by thermal regulation 1.80 A, VBUS at the connector 5.00 V, CHGIN at U4 4.89 V, VSYS 3.50 V, BATT at U4 3.36 V, input current 2.42 A, charge current 1.80 A, buck output current 3.08 A, buck duty 75.2 %, boost input current 1.27 A, BATFET mode: linear (VSYS held at VSYSMIN), charger efficiency 90.8 %, boost efficiency 92.9 %.

| Element | Nominal | High |
|---|---|---|
| BQ25798 buck | 892 mW | 886 mW |
| BQ25798 BATFET | 247 mW | 93 mW |
| TPS61378-Q1 | 246 mW | 247 mW |
| L1 | 196 mW | 196 mW |
| copper CHG_SW1 | 114 mW | 114 mW |
| copper CHG_SW2 | 104 mW | 104 mW |
| copper USB_VBUS | 88 mW | 90 mW |
| FB1 ferrite bead | 88 mW | 119 mW |
| L2 | 69 mW | 69 mW |
| USB-C contacts | 59 mW | 119 mW |
| LEDs and series resistors | 57 mW | 57 mW |
| F1 fuse | 36 mW | 49 mW |
| JST-PH battery contacts | 32 mW | 65 mW |
| copper VSYS | 22 mW | 22 mW |
| copper USB_VBUS_J1 | 21 mW | 22 mW |
| shunts and module sockets | 16 mW | 33 mW |
| Module feed ideal diodes | 15 mW | 24 mW |
| OVLO dividers | 11 mW | 11 mW |
| copper RAIL_5V | 10 mW | 10 mW |
| copper CHG_BAT | 9 mW | 9 mW |
| copper VBAT | 9 mW | 9 mW |
| ship FET | 8 mW | 21 mW |
| copper GND pour | 7 mW | 7 mW |
| copper BAT_IN | 5 mW | 5 mW |
| copper BOOST_5V | 3 mW | 3 mW |
| copper ADS_5V_D | 3 mW | 3 mW |
| copper BOOST_SW | 1 mW | 1 mW |
| copper ADS_5V | 1 mW | 1 mW |
| copper ESP_5V | 0 mW | 0 mW |
| copper ESP_5V_D | 0 mW | 0 mW |
| **Board total** | **2.37 W** | **2.39 W** |
| Modules (5 V power, heat inside the case) | 4.07 W | 4.05 W |
| Battery pack I²R | 194 mW | 292 mW |
| Inside the case | 6.64 W | 6.73 W |

### USB 3 A source, cell 3.2 V, 1.8 A host mode, TREG 100 °C, device off

Nominal corner: charge current allowed by thermal regulation 1.80 A, VBUS at the connector 5.00 V, CHGIN at U4 4.94 V, VSYS 3.50 V, BATT at U4 3.36 V, input current 1.37 A, charge current 1.80 A, buck output current 1.81 A, buck duty 72.7 %, boost input current 0.00 A, BATFET mode: linear (VSYS held at VSYSMIN), charger efficiency 93.3 %.

| Element | Nominal | High |
|---|---|---|
| BQ25798 buck | 383 mW | 381 mW |
| BQ25798 BATFET | 247 mW | 93 mW |
| L1 | 73 mW | 73 mW |
| F1 fuse | 36 mW | 49 mW |
| copper CHG_SW1 | 34 mW | 34 mW |
| JST-PH battery contacts | 32 mW | 65 mW |
| copper CHG_SW2 | 32 mW | 31 mW |
| FB1 ferrite bead | 28 mW | 38 mW |
| copper USB_VBUS | 25 mW | 25 mW |
| LEDs and series resistors | 24 mW | 24 mW |
| USB-C contacts | 19 mW | 38 mW |
| ship FET | 8 mW | 21 mW |
| copper CHG_BAT | 8 mW | 8 mW |
| copper VBAT | 8 mW | 8 mW |
| copper USB_VBUS_J1 | 6 mW | 6 mW |
| copper BAT_IN | 5 mW | 5 mW |
| OVLO dividers | 4 mW | 4 mW |
| copper GND pour | 3 mW | 3 mW |
| copper VSYS | 0 mW | 0 mW |
| **Board total** | **976 mW** | **905 mW** |
| Modules (5 V power, heat inside the case) | 0 mW | 0 mW |
| Battery pack I²R | 194 mW | 292 mW |
| Inside the case | 1.17 W | 1.20 W |

### USB 3 A source, cell 3.7 V, 1 A default mode, TREG 120 °C, 0.8 A load

Nominal corner: charge current allowed by thermal regulation 1.00 A, VBUS at the connector 5.00 V, CHGIN at U4 4.92 V, VSYS 3.80 V, BATT at U4 3.79 V, input current 1.80 A, charge current 1.00 A, buck output current 2.17 A, buck duty 79.7 %, boost input current 1.16 A, BATFET mode: closed, charger efficiency 93.2 %, boost efficiency 93.7 %.

| Element | Nominal | High |
|---|---|---|
| BQ25798 buck | 497 mW | 493 mW |
| TPS61378-Q1 | 219 mW | 218 mW |
| L1 | 102 mW | 101 mW |
| LEDs and series resistors | 60 mW | 60 mW |
| L2 | 58 mW | 57 mW |
| copper CHG_SW1 | 53 mW | 52 mW |
| copper CHG_SW2 | 49 mW | 48 mW |
| FB1 ferrite bead | 48 mW | 66 mW |
| copper USB_VBUS | 46 mW | 47 mW |
| USB-C contacts | 32 mW | 66 mW |
| copper VSYS | 18 mW | 17 mW |
| shunts and module sockets | 16 mW | 33 mW |
| Module feed ideal diodes | 15 mW | 24 mW |
| BQ25798 BATFET | 13 mW | 13 mW |
| OVLO dividers | 11 mW | 11 mW |
| copper USB_VBUS_J1 | 11 mW | 11 mW |
| F1 fuse | 11 mW | 15 mW |
| JST-PH battery contacts | 10 mW | 20 mW |
| copper RAIL_5V | 10 mW | 10 mW |
| copper GND pour | 3 mW | 3 mW |
| copper CHG_BAT | 3 mW | 3 mW |
| copper BOOST_5V | 3 mW | 3 mW |
| ship FET | 3 mW | 6 mW |
| copper VBAT | 3 mW | 3 mW |
| copper ADS_5V_D | 2 mW | 2 mW |
| copper BAT_IN | 2 mW | 2 mW |
| copper ADS_5V | 1 mW | 1 mW |
| copper BOOST_SW | 1 mW | 1 mW |
| copper ESP_5V | 0 mW | 0 mW |
| copper ESP_5V_D | 0 mW | 0 mW |
| **Board total** | **1.30 W** | **1.39 W** |
| Modules (5 V power, heat inside the case) | 4.07 W | 4.05 W |
| Battery pack I²R | 60 mW | 90 mW |
| Inside the case | 5.43 W | 5.53 W |

### USB 3 A source, cell 3.2 V, 1 A default mode, TREG 120 °C, 0.8 A load

Nominal corner: charge current allowed by thermal regulation 1.00 A, VBUS at the connector 5.00 V, CHGIN at U4 4.92 V, VSYS 3.50 V, BATT at U4 3.29 V, input current 1.75 A, charge current 1.00 A, buck output current 2.28 A, buck duty 73.6 %, boost input current 1.27 A, BATFET mode: linear (VSYS held at VSYSMIN), charger efficiency 92.4 %, boost efficiency 93.1 %.

| Element | Nominal | High |
|---|---|---|
| BQ25798 buck | 541 mW | 540 mW |
| TPS61378-Q1 | 240 mW | 240 mW |
| BQ25798 BATFET | 210 mW | 162 mW |
| L1 | 112 mW | 112 mW |
| L2 | 67 mW | 67 mW |
| copper CHG_SW1 | 59 mW | 60 mW |
| LEDs and series resistors | 57 mW | 57 mW |
| copper CHG_SW2 | 55 mW | 55 mW |
| FB1 ferrite bead | 46 mW | 62 mW |
| copper USB_VBUS | 44 mW | 45 mW |
| USB-C contacts | 31 mW | 62 mW |
| copper VSYS | 21 mW | 21 mW |
| shunts and module sockets | 16 mW | 33 mW |
| Module feed ideal diodes | 15 mW | 24 mW |
| OVLO dividers | 11 mW | 11 mW |
| F1 fuse | 11 mW | 15 mW |
| copper USB_VBUS_J1 | 11 mW | 11 mW |
| copper RAIL_5V | 10 mW | 10 mW |
| JST-PH battery contacts | 10 mW | 20 mW |
| copper GND pour | 4 mW | 4 mW |
| copper CHG_BAT | 3 mW | 3 mW |
| copper BOOST_5V | 3 mW | 3 mW |
| ship FET | 3 mW | 6 mW |
| copper VBAT | 3 mW | 3 mW |
| copper ADS_5V_D | 2 mW | 2 mW |
| copper BAT_IN | 2 mW | 2 mW |
| copper BOOST_SW | 1 mW | 1 mW |
| copper ADS_5V | 1 mW | 1 mW |
| copper ESP_5V | 0 mW | 0 mW |
| copper ESP_5V_D | 0 mW | 0 mW |
| **Board total** | **1.59 W** | **1.63 W** |
| Modules (5 V power, heat inside the case) | 4.07 W | 4.05 W |
| Battery pack I²R | 60 mW | 90 mW |
| Inside the case | 5.72 W | 5.77 W |

## Temperatures

Hot spots from the grid solution. "θJA" is the naive figure from the data sheet's JEDEC θJA with the same loss at the same ambient, for comparison only.

| Case | Environment | Ambient | Corner | Case air | U4 Tj | U6 Tj | U7 Tj | L1 | L2 | Board max | Hottest X7R | Pack |
|---|---|---|---|---|---|---|---|---|---|---|---|---|
| Battery 3.1 V, typical 1.22 W load | open | 25 °C | nominal | 25.0 | 26 (θJA 25) | 30 (θJA 29) | - | - | 28 | 28 | 27 (C18) | 25.1 |
| Battery 3.1 V, typical 1.22 W load | closed | 25 °C | nominal | 31.8 | 33 (θJA 25) | 37 (θJA 29) | - | - | 35 | 36 | 35 (C18) | 31.9 |
|  |  |  | high | 31.8 | 33 (θJA 25) | 37 (θJA 29) | - | - | 35 | 36 | 35 (C18) | 32.0 |
| Battery 3.1 V, typical 1.22 W load | closed | 50 °C | nominal | 56.8 | 58 (θJA 50) | 62 (θJA 54) | - | - | 60 | 61 | 60 (C18) | 56.9 |
|  |  |  | high | 56.9 | 58 (θJA 50) | 62 (θJA 54) | - | - | 60 | 61 | 60 (C18) | 57.0 |
| Battery 3.1 V, 0.8 A load | open | 25 °C | nominal | 25.0 | 28 (θJA 26) | 39 (θJA 36) | - | - | 32 | 35 | 32 (C18) | 26.1 |
| Battery 3.1 V, 0.8 A load | closed | 25 °C | nominal | 44.5 | 49 (θJA 26) | 62 (θJA 37) | - | - | 54 | 58 | 54 (C18) | 45.6 |
|  |  |  | high | 44.8 | 50 (θJA 26) | 63 (θJA 37) | - | - | 55 | 59 | 55 (C18) | 46.5 |
| Battery 3.1 V, 0.8 A load | closed | 50 °C | nominal | 69.8 | 75 (θJA 51) | 88 (θJA 63) | - | - | 81 | 84 | 80 (C18) | 71.0 |
|  |  |  | high | 70.2 | 76 (θJA 51) | 89 (θJA 63) | - | - | 81 | 85 | 81 (C18) | 71.9 |
| Battery 3.1 V, 1.0 A load | open | 25 °C | nominal | 25.0 | 30 (θJA 27) | 46 (θJA 42) | - | - | 36 | 40 | 35 (C18) | 26.8 |
| Battery 3.1 V, 1.0 A load | closed | 25 °C | nominal | 49.1 | 56 (θJA 27) | 75 (θJA 43) | - | - | 64 | 69 | 63 (C18) | 50.9 |
|  |  |  | high | 49.6 | 58 (θJA 27) | 76 (θJA 43) | - | - | 65 | 70 | 64 (C18) | 52.4 |
| Battery 3.1 V, 1.0 A load | closed | 50 °C | nominal | 74.6 | 83 (θJA 52) | 102 (θJA 70) | - | - | 91 | 96 | 90 (C18) | 76.4 |
|  |  |  | high | 75.1 | 84 (θJA 52) | 104 (θJA 70) | - | - | 92 | 97 | 91 (C18) | 77.9 |
| USB 3 A source, cell 3.7 V, 1.8 A host mode, TREG 100 °C, 0.8 A load | open | 25 °C | nominal | 25.0 | 51 (θJA 59) | 46 (θJA 34) | - | 45 | 41 | 48 | 44 (C6) | 26.8 |
| USB 3 A source, cell 3.7 V, 1.8 A host mode, TREG 100 °C, 0.8 A load | closed | 25 °C | nominal | 49.8 | 85 (θJA 63) | 79 (θJA 35) | - | 78 | 74 | 82 | 78 (C6) | 51.6 |
|  |  |  | high | 50.6 | 87 (θJA 62) | 82 (θJA 35) | - | 81 | 78 | 84 | 81 (C6) | 53.3 |
| USB 3 A source, cell 3.2 V, 1.8 A host mode, TREG 100 °C, 0.8 A load | open | 25 °C | nominal | 25.0 | 58 (θJA 71) | 48 (θJA 35) | - | 48 | 43 | 53 | 48 (C6) | 26.8 |
| USB 3 A source, cell 3.2 V, 1.8 A host mode, TREG 100 °C, 0.8 A load | closed | 25 °C | nominal | 50.9 | 95 (θJA 75) | 84 (θJA 36) | - | 84 | 79 | 90 | 84 (C6) | 52.7 |
|  |  |  | high | 51.2 | 92 (θJA 68) | 85 (θJA 36) | - | 84 | 80 | 88 | 84 (C6) | 53.9 |
| USB 3 A source, cell 3.2 V, 1.8 A host mode, TREG 100 °C, device off | open | 25 °C | nominal | 25.0 | 42 (θJA 53) | - | - | 35 | - | 39 | 36 (C6) | 26.8 |
| USB 3 A source, cell 3.2 V, 1.8 A host mode, TREG 100 °C, device off | closed | 25 °C | nominal | 30.7 | 52 (θJA 53) | - | - | 44 | - | 48 | 45 (C6) | 32.5 |
|  |  |  | high | 30.8 | 48 (θJA 46) | - | - | 43 | - | 46 | 44 (C6) | 33.5 |
| USB 3 A source, cell 3.7 V, 1 A default mode, TREG 120 °C, 0.8 A load | open | 25 °C | nominal | 25.0 | 41 (θJA 46) | 42 (θJA 34) | - | 37 | 37 | 39 | 37 (C6) | 25.6 |
| USB 3 A source, cell 3.7 V, 1 A default mode, TREG 120 °C, 0.8 A load | closed | 25 °C | nominal | 46.9 | 69 (θJA 48) | 69 (θJA 35) | - | 65 | 64 | 66 | 64 (C6) | 47.4 |
|  |  |  | high | 47.2 | 69 (θJA 47) | 71 (θJA 35) | - | 66 | 65 | 67 | 66 (C1) | 48.0 |
| USB 3 A source, cell 3.2 V, 1 A default mode, TREG 120 °C, 0.8 A load | open | 25 °C | nominal | 25.0 | 47 (θJA 56) | 44 (θJA 35) | - | 40 | 39 | 43 | 40 (C6) | 25.6 |
| USB 3 A source, cell 3.2 V, 1 A default mode, TREG 120 °C, 0.8 A load | closed | 25 °C | nominal | 47.8 | 77 (θJA 58) | 73 (θJA 36) | - | 69 | 68 | 73 | 70 (C6) | 48.4 |
|  |  |  | high | 48.0 | 76 (θJA 56) | 74 (θJA 36) | - | 70 | 69 | 73 | 70 (C6) | 48.8 |

All temperatures in °C. Board max is the hottest grid cell (1 mm), not a pad.

## Checks

- PASS: USB 3 A source, cell 3.7 V, 1.8 A host mode, TREG 100 °C, 0.8 A load, open bench, 25 °C: full 1.8 A charge current (U4 junction 51 °C, regulation at 100 °C)
- PASS: USB 3 A source, cell 3.2 V, 1.8 A host mode, TREG 100 °C, 0.8 A load, open bench, 25 °C: full 1.8 A charge current (U4 junction 58 °C, regulation at 100 °C)
- PASS: USB 3 A source, cell 3.2 V, 1.8 A host mode, TREG 100 °C, device off, open bench, 25 °C: full 1.8 A charge current (U4 junction 42 °C, regulation at 100 °C)
- PASS: USB 3 A source, cell 3.7 V, 1 A default mode, TREG 120 °C, 0.8 A load, open bench, 25 °C: full 1.0 A charge current (U4 junction 41 °C, regulation at 120 °C)
- PASS: USB 3 A source, cell 3.2 V, 1 A default mode, TREG 120 °C, 0.8 A load, open bench, 25 °C: full 1.0 A charge current (U4 junction 47 °C, regulation at 120 °C)
- PASS: TPS61378-Q1 junction at most 104 °C (Battery 3.1 V, 1.0 A load, 50 °C ambient, high corner, closed case), limit 125 °C
- PASS: L1 winding at most 85 °C (Battery 3.1 V, 1.0 A load, 50 °C ambient, high corner, closed case), limit 125 °C
- PASS: L2 winding at most 92 °C (Battery 3.1 V, 1.0 A load, 50 °C ambient, high corner, closed case), limit 125 °C
- PASS: hottest board cell 97.3 °C (Battery 3.1 V, 1.0 A load, 50 °C ambient, high corner, closed case); limit 125 °C (FR4 Tg 130 °C and up)
- PASS: X7R bulk capacitors at 25 °C ambient, closed case: hottest C6 at 84 °C (USB 3 A source, cell 3.2 V, 1.8 A host mode, TREG 100 °C, 0.8 A load, nominal corner), rating 125 °C
- PASS: X7R bulk capacitors at 50 °C ambient, closed case: hottest C18 at 91 °C (Battery 3.1 V, 1.0 A load, high corner), rating 125 °C
- PASS: Battery 3.1 V, typical 1.22 W load, closed case, 25 °C ambient, high corner: pack at 32.0 °C; it must stay below the thermostat's lowest opening point 55 °C (60 °C ± 5 K)
- PASS: Battery 3.1 V, 0.8 A load, closed case, 25 °C ambient, high corner: pack at 46.5 °C; it must stay below the thermostat's lowest opening point 55 °C (60 °C ± 5 K)
- PASS: Battery 3.1 V, 1.0 A load, closed case, 25 °C ambient, high corner: pack at 52.4 °C; it must stay below the thermostat's lowest opening point 55 °C (60 °C ± 5 K)
- PASS: battery current at most 1.84 A through J3, JST PH rating 2 A (AWG 24)
- PASS: USB input current at most 2.59 A, MC-107DMS rating 5 A

## Charger thermal regulation

The BQ25798 holds its junction at TREG by reducing the charge current (register setting, default 120 °C, options 60 / 80 / 100 / 120 °C). Below zero charge current the model lets the input current fall so that the battery supplements the system. The table gives the charge current the board sustains in steady state at the TREG of each case. Negative: the battery discharges into the load although USB is present.

| Case | Environment | Corner | TREG | Charge current | Input current | U4 Tj | U4 loss |
|---|---|---|---|---|---|---|---|
| USB 3 A source, cell 3.7 V, 1.8 A host mode, TREG 100 °C, 0.8 A load | open bench, no enclosure | nominal | 100 °C | 1.80 A | 2.52 A | 51 °C | 0.78 W |
| USB 3 A source, cell 3.7 V, 1.8 A host mode, TREG 100 °C, 0.8 A load | closed 3D-printed case | nominal | 100 °C | 1.80 A | 2.54 A | 85 °C | 0.85 W |
| USB 3 A source, cell 3.7 V, 1.8 A host mode, TREG 100 °C, 0.8 A load | closed 3D-printed case | high | 100 °C | 1.80 A | 2.59 A | 87 °C | 0.85 W |
| USB 3 A source, cell 3.2 V, 1.8 A host mode, TREG 100 °C, 0.8 A load | open bench, no enclosure | nominal | 100 °C | 1.80 A | 2.40 A | 58 °C | 1.05 W |
| USB 3 A source, cell 3.2 V, 1.8 A host mode, TREG 100 °C, 0.8 A load | closed 3D-printed case | nominal | 100 °C | 1.80 A | 2.42 A | 95 °C | 1.14 W |
| USB 3 A source, cell 3.2 V, 1.8 A host mode, TREG 100 °C, 0.8 A load | closed 3D-printed case | high | 100 °C | 1.80 A | 2.44 A | 92 °C | 0.98 W |
| USB 3 A source, cell 3.2 V, 1.8 A host mode, TREG 100 °C, device off | open bench, no enclosure | nominal | 100 °C | 1.80 A | 1.37 A | 42 °C | 0.62 W |
| USB 3 A source, cell 3.2 V, 1.8 A host mode, TREG 100 °C, device off | closed 3D-printed case | nominal | 100 °C | 1.80 A | 1.37 A | 52 °C | 0.63 W |
| USB 3 A source, cell 3.2 V, 1.8 A host mode, TREG 100 °C, device off | closed 3D-printed case | high | 100 °C | 1.80 A | 1.38 A | 48 °C | 0.47 W |
| USB 3 A source, cell 3.7 V, 1 A default mode, TREG 120 °C, 0.8 A load | open bench, no enclosure | nominal | 120 °C | 1.00 A | 1.78 A | 41 °C | 0.48 W |
| USB 3 A source, cell 3.7 V, 1 A default mode, TREG 120 °C, 0.8 A load | closed 3D-printed case | nominal | 120 °C | 1.00 A | 1.80 A | 69 °C | 0.51 W |
| USB 3 A source, cell 3.7 V, 1 A default mode, TREG 120 °C, 0.8 A load | closed 3D-printed case | high | 120 °C | 1.00 A | 1.82 A | 69 °C | 0.51 W |
| USB 3 A source, cell 3.2 V, 1 A default mode, TREG 120 °C, 0.8 A load | open bench, no enclosure | nominal | 120 °C | 1.00 A | 1.74 A | 47 °C | 0.71 W |
| USB 3 A source, cell 3.2 V, 1 A default mode, TREG 120 °C, 0.8 A load | closed 3D-printed case | nominal | 120 °C | 1.00 A | 1.75 A | 77 °C | 0.75 W |
| USB 3 A source, cell 3.2 V, 1 A default mode, TREG 120 °C, 0.8 A load | closed 3D-printed case | high | 120 °C | 1.00 A | 1.76 A | 76 °C | 0.70 W |

## U4 heatsink against the bare board

The same operating points solved without the heatsink. It moves heat from the die into the surrounding air. In the closed case that air is the case air, whose temperature it does not change.

| Case | Environment | Corner | U4 junction, bare to heatsink | Charge current, bare to heatsink | Heat through the heatsink | U4 junction to air, bare to heatsink |
|---|---|---|---|---|---|---|
| USB 3 A source, cell 3.7 V, 1.8 A host mode, TREG 100 °C, 0.8 A load | open bench, no enclosure | nominal | 64 to 51 °C | 1.80 to 1.80 A | 0.34 W of 0.78 W | 50 to 33 K/W |
| USB 3 A source, cell 3.7 V, 1.8 A host mode, TREG 100 °C, 0.8 A load | closed 3D-printed case | nominal | 100 to 85 °C | 1.79 to 1.80 A | 0.36 W of 0.85 W | 59 to 42 K/W |
| USB 3 A source, cell 3.7 V, 1.8 A host mode, TREG 100 °C, 0.8 A load | closed 3D-printed case | high | 100 to 87 °C | 1.71 to 1.80 A | 0.37 W of 0.85 W | 59 to 43 K/W |
| USB 3 A source, cell 3.2 V, 1.8 A host mode, TREG 100 °C, 0.8 A load | open bench, no enclosure | nominal | 74 to 58 °C | 1.80 to 1.80 A | 0.43 W of 1.05 W | 47 to 31 K/W |
| USB 3 A source, cell 3.2 V, 1.8 A host mode, TREG 100 °C, 0.8 A load | closed 3D-printed case | nominal | 100 to 95 °C | 1.39 to 1.80 A | 0.44 W of 1.14 W | 45 to 39 K/W |
| USB 3 A source, cell 3.2 V, 1.8 A host mode, TREG 100 °C, 0.8 A load | closed 3D-printed case | high | 100 to 92 °C | 1.46 to 1.80 A | 0.41 W of 0.98 W | 52 to 42 K/W |
| USB 3 A source, cell 3.2 V, 1.8 A host mode, TREG 100 °C, device off | open bench, no enclosure | nominal | 50 to 42 °C | 1.80 to 1.80 A | 0.23 W of 0.62 W | 41 to 28 K/W |
| USB 3 A source, cell 3.2 V, 1.8 A host mode, TREG 100 °C, device off | closed 3D-printed case | nominal | 60 to 52 °C | 1.80 to 1.80 A | 0.21 W of 0.63 W | 47 to 33 K/W |
| USB 3 A source, cell 3.2 V, 1.8 A host mode, TREG 100 °C, device off | closed 3D-printed case | high | 55 to 48 °C | 1.80 to 1.80 A | 0.18 W of 0.47 W | 52 to 37 K/W |
| USB 3 A source, cell 3.7 V, 1 A default mode, TREG 120 °C, 0.8 A load | open bench, no enclosure | nominal | 49 to 41 °C | 1.00 to 1.00 A | 0.21 W of 0.48 W | 50 to 34 K/W |
| USB 3 A source, cell 3.7 V, 1 A default mode, TREG 120 °C, 0.8 A load | closed 3D-printed case | nominal | 77 to 69 °C | 1.00 to 1.00 A | 0.22 W of 0.51 W | 60 to 42 K/W |
| USB 3 A source, cell 3.7 V, 1 A default mode, TREG 120 °C, 0.8 A load | closed 3D-printed case | high | 79 to 69 °C | 1.00 to 1.00 A | 0.22 W of 0.51 W | 62 to 44 K/W |
| USB 3 A source, cell 3.2 V, 1 A default mode, TREG 120 °C, 0.8 A load | open bench, no enclosure | nominal | 57 to 47 °C | 1.00 to 1.00 A | 0.29 W of 0.71 W | 45 to 31 K/W |
| USB 3 A source, cell 3.2 V, 1 A default mode, TREG 120 °C, 0.8 A load | closed 3D-printed case | nominal | 89 to 77 °C | 1.00 to 1.00 A | 0.29 W of 0.75 W | 54 to 38 K/W |
| USB 3 A source, cell 3.2 V, 1 A default mode, TREG 120 °C, 0.8 A load | closed 3D-printed case | high | 88 to 76 °C | 1.00 to 1.00 A | 0.28 W of 0.70 W | 57 to 40 K/W |
| Battery 3.1 V, 0.8 A load | open bench, no enclosure | nominal | 29 to 28 °C | - | 0.04 W of 0.02 W | 195 to 134 K/W |
| Battery 3.1 V, 0.8 A load | closed 3D-printed case | nominal | 51 to 49 °C | - | 0.05 W of 0.02 W | 271 to 196 K/W |
| Battery 3.1 V, 1.0 A load | open bench, no enclosure | nominal | 32 to 30 °C | - | 0.06 W of 0.04 W | 180 to 123 K/W |
| Battery 3.1 V, 1.0 A load | closed 3D-printed case | nominal | 59 to 56 °C | - | 0.07 W of 0.04 W | 249 to 179 K/W |

Junction to air is the junction rise over the surrounding air divided by the U4 loss at the operating point with the heatsink. In regulation the loss differs between the two solutions.

## Charging and the pack temperature window

The charger reads the pack NTC. Above 31.4 °C it lowers the termination voltage to 4.05 V, above 42.1 °C it stops (nominal thresholds, docs/power.md). In the closed case the pack sits in the case air, so the ambient at which these are reached is:

| Case | Corner | Pack above ambient | Ambient for 4.05 V limit | Ambient for charge stop |
|---|---|---|---|---|
| USB 3 A source, cell 3.7 V, 1.8 A host mode, TREG 100 °C, 0.8 A load | nominal | 26.6 K | 4.8 °C | 15.5 °C |
|  | high | 28.3 K | 3.1 °C | 13.8 °C |
| USB 3 A source, cell 3.2 V, 1.8 A host mode, TREG 100 °C, 0.8 A load | nominal | 27.7 K | 3.7 °C | 14.4 °C |
|  | high | 28.9 K | 2.5 °C | 13.2 °C |
| USB 3 A source, cell 3.2 V, 1.8 A host mode, TREG 100 °C, device off | nominal | 7.5 K | 23.9 °C | 34.6 °C |
|  | high | 8.5 K | 22.9 °C | 33.6 °C |
| USB 3 A source, cell 3.7 V, 1 A default mode, TREG 120 °C, 0.8 A load | nominal | 22.4 K | 9.0 °C | 19.7 °C |
|  | high | 23.0 K | 8.4 °C | 19.1 °C |
| USB 3 A source, cell 3.2 V, 1 A default mode, TREG 120 °C, 0.8 A load | nominal | 23.4 K | 8.0 °C | 18.7 °C |
|  | high | 23.8 K | 7.6 °C | 18.3 °C |

On the open bench the pack rises only by its own I²R loss (a few tenths of a kelvin at 1.8 A).

## Limits of the model

- Steady state only. The 1.5 A output margin is short-term headroom and not a thermal case.
- The enclosure is not designed. Its size, material, vents and the battery position decide the case-air rise, which dominates the absolute temperatures in the closed case. The modules' 5 V power is most of the heat in it.
- Board-to-air coefficients are lumped (one value per face). Modules on the top side shade the board; their own heat reaches the board only through the case air, not through the header pins.
- The BQ25798 switching loss is fitted to the data sheet efficiency curve at 5 V in and 4 V out (read off the figure, about half a point of accuracy), so it carries the data sheet's test board and inductor.
- BQ25798: RθJB 9.7 K/W from junction to pins (RθJC(top) 20.9, ψJT 0.5 K/W).
- The U4 heatsink path is an estimate on top of that: junction to package top is not published for the FC2QFN (25 to 45 K/W assumed), the epoxy layers depend on the assembly, and the sink rating is a free-air figure derated for the lower temperature rise and the case air. Bench item: thermocouple on the sink base.
- Contact, fuse and pack resistances are data sheet maxima or estimates (see the input table). The USB cable is not included; its drop lowers CHGIN towards the 4.5 V input regulation threshold.
- Only DC currents are solved in the copper. Ripple currents in the capacitor loops and their ESR losses are small and stay inside the converter footprints.
- Bench verification: thermocouple or IR camera on U4, U6, L1, L2 and the pack at the charging case with the real enclosure, and at the 3.1 V / 0.8 A battery case.

Run time 7 s, grid 105 x 95 x 4 nodes.

Result: all checks pass.
