mp911de/airgrep/hardware/sim/heat/max/results.md

# Power loss and temperature estimate

Generated by `hardware/sim/run_heat.py` from `hardware/carrier-max-charger/carrier.kicad_pcb` (charger MAX77757). See `hardware/sim/README.md` for what is and is not modelled.

## Board as read

105 x 95 mm, four layers (JLC04161H-2116C): 35 µm outer and 15.2 µm inner copper, 0.20 / 1.065 / 0.20 mm dielectric. Copper share from the zone fills, tracks, pads and vias on a 1.0 mm grid: F 79 %, In1 90 %, In2 86 %, B 90 %. 176 vias, 63 of them GND. Zone fills are taken as stored in the file. Refill them before running after a layout change.

## Solver check

One copper layer with FR4, 10 W/m²K on each face, 1 W point source, against the infinite-plate solution P·K0(m·r) / (2π·k·t):

| Distance | Grid | Analytic | Error |
|---|---|---|---|
| 3 mm | 25.12 K | 24.99 K | +0.6 % |
| 5 mm | 19.71 K | 19.66 K | +0.3 % |
| 10 mm | 12.77 K | 12.75 K | +0.2 % |
| 20 mm | 6.72 K | 6.71 K | +0.2 % |

- PASS: grid solution within 5 % of the analytic plate from 5 mm on (worst 0.3 %)

## Loss model inputs

| Element | Value | Source |
|---|---|---|
| MAX77757 input / high side / low side / BATFET | 45 / 60 / 60 / 20 mΩ typ | 19-100986 Rev 2, Electrical Characteristics |
| MAX77757 switching | 1.3 MHz; edge loss with the TPS61088 coefficient below | estimate, no efficiency curve published |
| MAX77757 input supply current | 2.7 mA | data sheet, typ |
| MAX77757 VSYSMIN | 3.5 V; below it the BATFET regulates linearly | data sheet |
| TPS61088 high side / low side | 13 / 11 mΩ typ | SLVSCM8D |
| L1 FXL0630-1R0-M / L2 CKST0603-2.2uH | 7.4 / 15.5 mΩ DCR, core loss 20 mW each | docs/power.md, vendor tables; core loss estimate |
| TPS22975 | 16 mΩ typ | SLVSCI1 |
| LM73100 ideal diodes U11, U12 | drop regulated to 16.4 / 28.4 mV, 28.4 / 44.9 mΩ above that | SNOSDC0A, typ / max over temperature |
| On-resistance temperature coefficient | +0.4 %/K | estimate |
| USB-C contacts (4 VBUS, 4 GND) | 20 / 40 mΩ each | Hanbo MC-107DMS: 40 mΩ max |
| JST-PH battery contacts | 5 / 10 mΩ each | JST PH: 10 mΩ max initial |
| Shunts and module sockets | 10 / 20 mΩ per contact | estimate |
| F1 Littelfuse 0466005.NRHF 5 A (C57525) | 11 / 15 mΩ | nominal cold resistance, datasheets/littelfuse-466.pdf; high corner estimate |
| Battery pack, DC | 60 / 90 mΩ | at most 50 mΩ AC 1 kHz in the pack data sheet; DC estimate |
| Copper | 1.72 µΩ·cm at 20 °C, +0.393 %/K, tracks and pour at their local temperature |  |

Where two values are given, the first is the nominal corner and the second the high corner.

TPS61088 switching term: P = K · VOUT · IIN · fSW + P0 with K = 24.81 ns and P0 = 50 mW. It is fitted to what the efficiency curve in `specs/power_params.json` at 3.6 V leaves after the conduction, DCR and core losses. The curve is TI Figure 6-2 less 2 points for 1 MHz and the CKST0603 DCR.

| IOUT | Curve η | Model η |
|---|---|---|
| 0.2 A | 90.0 % | 90.8 % |
| 0.5 A | 93.0 % | 94.2 % |
| 1.0 A | 94.0 % | 94.9 % |
| 2.0 A | 93.0 % | 94.1 % |

## Copper path resistances at 20 °C

Each power net is solved as a resistor network of its tracks and vias. Pads are nodes, and the pins of a group share the current equally. GND is a four-layer sheet on the grid.

| Path | Resistance |
|---|---|
| USB_VBUS_J1: J1 VBUS pins to FB1 | 5.1 mΩ |
| USB_VBUS: FB1 to U4 CHGIN | 6.5 mΩ |
| CHG_SW: U4 LX to L1 | 5.4 mΩ |
| VSYS: L1 to U4 SYS | 4.4 mΩ |
| VSYS: U4 SYS to L2 | 6.1 mΩ |
| VBAT: F1 to U4 BATT | 4.4 mΩ |
| BAT_IN: J3 to F1 | 1.3 mΩ |
| BOOST_SW: L2 to U6 SW | 0.7 mΩ |
| BOOST_5V: U6 VOUT to U7 VIN | 5.2 mΩ |
| RAIL_5V: U7 VOUT to U11 IN | 9.2 mΩ |
| U12 OUT to JP1 | 7.7 mΩ |
| U11 OUT to JP2 | 4.6 mΩ |
| ADS_5V: JP2 to J10 | 1.5 mΩ |
| ESP_5V: JP1 to J7 | 5.5 mΩ |
| GND: J3 pin 2 to U6 ground pads | 0.8 mΩ |
| GND: J1 GND pins to U4 PGND | 4.3 mΩ |

## Thermal environment

- Open bench: board in still air, 10 W/m²K on both faces (convection plus radiation), no enclosure.
- Closed case (not yet designed; assumed): 115 x 105 x 40 mm outside, 2 mm printed wall (k 0.2 W/m·K), 7 W/m²K inside and 9 W/m²K outside. Wall path to ambient 6.3 K/W over 418 cm². Inside it the board loses 6 W/m²K per face to the case air (modules above, battery below). The air carries everything dissipated in the case: board losses, the modules' 5 V power and the pack's own I²R. The pack: 9.2 K/W to the case air.
- Vents: 5.0 cm² each for the lower inlet and upper outlet, 50 % open grille, 35 mm vertical separation, discharge coefficient 0.6. Natural draft acts in parallel with the wall path; no fan.
- Junction to board: MAX77757 θJC 7.5 K/W applied from junction to pins (surface not stated for the FC2QFN), TPS61088 RθJC(bot) 3.1 K/W plus 1 K/W solder onto its pad, TPS22975 RθJC(bot) 16.4 K/W; inductor winding to terminals 12 K/W.
- U4 heatsink: 10 x 10 mm aluminium sink (Fischer ICK S 10 x 10 x 6.5) on a 1.5 mm copper spacer, thermal epoxy. Junction to package top 35 K/W, epoxy and spacer 20 K/W, sink to air 35 K/W on the bench and 58 K/W in the case air. That gives 90 and 113 K/W from the junction, in parallel with the pins. Parts with pads inside the 10 x 10 mm footprint of the sink: C10, C11, C12, C34, C5, C6, C7, R6. The spacer must lift the sink base above the tallest of them.

## Operating points and losses

Board losses for the closed case at 25 °C ambient, with copper and on-resistance at their computed temperatures. Battery cases: the boost input is held at 3.1 V, the low-battery design point of docs/power.md. The cell open-circuit voltage that gives it follows from the path. USB cases: 5.0 V at the connector (cable drop not included), charge current as labelled unless the 3 A input limit reduces it.

### Battery 3.1 V, typical 1.22 W load

Nominal corner: VSYS at L2 3.10 V, cell open-circuit voltage 3.15 V, battery current 0.43 A, boost input current 0.43 A, boost duty 38.9 %, boost efficiency 91.4 %.

| Element | Nominal | High |
|---|---|---|
| TPS61088 | 92 mW | 92 mW |
| LEDs and series resistors | 32 mW | 32 mW |
| L2 | 24 mW | 24 mW |
| LM73100 ideal diodes | 4 mW | 7 mW |
| MAX77757 BATT-SYS switch | 4 mW | 4 mW |
| F1 fuse | 2 mW | 3 mW |
| JST-PH battery contacts | 2 mW | 4 mW |
| shunts and module sockets | 1 mW | 3 mW |
| copper VSYS | 1 mW | 1 mW |
| TPS22975 | 1 mW | 1 mW |
| copper VBAT | 1 mW | 1 mW |
| copper RAIL_5V | 1 mW | 1 mW |
| copper BOOST_5V | 0 mW | 0 mW |
| copper BAT_IN | 0 mW | 0 mW |
| copper ADS_5V_D | 0 mW | 0 mW |
| copper BOOST_SW | 0 mW | 0 mW |
| copper GND pour | 0 mW | 0 mW |
| copper ADS_5V | 0 mW | 0 mW |
| copper ESP_5V_D | 0 mW | 0 mW |
| copper ESP_5V | 0 mW | 0 mW |
| **Board total** | **166 mW** | **173 mW** |
| Modules (5 V power, heat inside the case) | 1.21 W | 1.21 W |
| Battery pack I²R | 11 mW | 17 mW |
| Inside the case | 1.39 W | 1.40 W |

Cell to 5 V output: 89.9 % nominal, 89.4 % high corner.

### Battery 3.1 V, 0.8 A load

Nominal corner: VSYS at L2 3.10 V, cell open-circuit voltage 3.26 V, battery current 1.39 A, boost input current 1.39 A, boost duty 39.5 %, boost efficiency 94.1 %.

| Element | Nominal | High |
|---|---|---|
| TPS61088 | 201 mW | 201 mW |
| L2 | 54 mW | 55 mW |
| MAX77757 BATT-SYS switch | 43 mW | 43 mW |
| LEDs and series resistors | 32 mW | 32 mW |
| F1 fuse | 21 mW | 29 mW |
| JST-PH battery contacts | 19 mW | 39 mW |
| shunts and module sockets | 16 mW | 33 mW |
| LM73100 ideal diodes | 15 mW | 24 mW |
| copper VSYS | 13 mW | 13 mW |
| TPS22975 | 12 mW | 12 mW |
| copper VBAT | 10 mW | 10 mW |
| copper RAIL_5V | 6 mW | 6 mW |
| copper BOOST_5V | 4 mW | 4 mW |
| copper BAT_IN | 3 mW | 3 mW |
| copper ADS_5V_D | 2 mW | 2 mW |
| copper BOOST_SW | 1 mW | 1 mW |
| copper GND pour | 1 mW | 1 mW |
| copper ADS_5V | 1 mW | 1 mW |
| copper ESP_5V_D | 0 mW | 0 mW |
| copper ESP_5V | 0 mW | 0 mW |
| **Board total** | **456 mW** | **509 mW** |
| Modules (5 V power, heat inside the case) | 3.99 W | 3.96 W |
| Battery pack I²R | 116 mW | 173 mW |
| Inside the case | 4.56 W | 4.65 W |

Cell to 5 V output: 89.4 % nominal, 87.8 % high corner.

### Battery 3.1 V, 1.0 A load

Nominal corner: VSYS at L2 3.10 V, cell open-circuit voltage 3.30 V, battery current 1.74 A, boost input current 1.74 A, boost duty 39.8 %, boost efficiency 94.0 %.

| Element | Nominal | High |
|---|---|---|
| TPS61088 | 249 mW | 249 mW |
| L2 | 75 mW | 75 mW |
| MAX77757 BATT-SYS switch | 69 mW | 69 mW |
| F1 fuse | 33 mW | 45 mW |
| LEDs and series resistors | 32 mW | 32 mW |
| JST-PH battery contacts | 30 mW | 60 mW |
| shunts and module sockets | 26 mW | 51 mW |
| LM73100 ideal diodes | 23 mW | 36 mW |
| copper VSYS | 22 mW | 22 mW |
| TPS22975 | 19 mW | 19 mW |
| copper VBAT | 15 mW | 15 mW |
| copper RAIL_5V | 10 mW | 10 mW |
| copper BOOST_5V | 6 mW | 6 mW |
| copper BAT_IN | 5 mW | 5 mW |
| copper ADS_5V_D | 4 mW | 4 mW |
| copper BOOST_SW | 2 mW | 2 mW |
| copper GND pour | 2 mW | 2 mW |
| copper ADS_5V | 1 mW | 1 mW |
| copper ESP_5V_D | 0 mW | 0 mW |
| copper ESP_5V | 0 mW | 0 mW |
| **Board total** | **622 mW** | **705 mW** |
| Modules (5 V power, heat inside the case) | 4.97 W | 4.93 W |
| Battery pack I²R | 181 mW | 271 mW |
| Inside the case | 5.77 W | 5.91 W |

Cell to 5 V output: 88.2 % nominal, 86.2 % high corner.

### USB 3 A source, cell 3.7 V, charging, 0.8 A load

Nominal corner: charge current allowed by thermal regulation 1.80 A, VBUS at the connector 5.00 V, CHGIN at U4 4.89 V, VSYS 3.91 V, BATT at U4 3.86 V, input current 2.66 A, charge current 1.80 A, buck output current 2.90 A, buck duty 88.4 %, boost input current 1.09 A, BATFET mode: closed, charger efficiency 87.0 %, boost efficiency 95.0 %.

| Element | Nominal | High |
|---|---|---|
| MAX77757 buck | 1.60 W | 1.75 W |
| TPS61088 | 169 mW | 166 mW |
| FB1 ferrite bead | 106 mW | 149 mW |
| L1 | 99 mW | 98 mW |
| MAX77757 BATT-SYS switch | 90 mW | 90 mW |
| USB-C contacts | 71 mW | 149 mW |
| LEDs and series resistors | 60 mW | 60 mW |
| copper USB_VBUS | 60 mW | 64 mW |
| copper CHG_SW | 59 mW | 58 mW |
| copper USB_VBUS_J1 | 46 mW | 49 mW |
| L2 | 44 mW | 43 mW |
| F1 fuse | 36 mW | 47 mW |
| JST-PH battery contacts | 32 mW | 63 mW |
| copper VSYS | 22 mW | 22 mW |
| copper VBAT | 18 mW | 18 mW |
| shunts and module sockets | 16 mW | 33 mW |
| LM73100 ideal diodes | 15 mW | 24 mW |
| TPS22975 | 13 mW | 13 mW |
| copper RAIL_5V | 7 mW | 7 mW |
| copper GND pour | 7 mW | 7 mW |
| copper BAT_IN | 5 mW | 5 mW |
| copper BOOST_5V | 4 mW | 4 mW |
| copper ADS_5V_D | 3 mW | 3 mW |
| copper BOOST_SW | 1 mW | 1 mW |
| copper ADS_5V | 1 mW | 1 mW |
| copper ESP_5V_D | 0 mW | 0 mW |
| copper ESP_5V | 0 mW | 0 mW |
| **Board total** | **2.58 W** | **2.92 W** |
| Modules (5 V power, heat inside the case) | 3.99 W | 3.96 W |
| Battery pack I²R | 194 mW | 285 mW |
| Inside the case | 6.76 W | 7.17 W |

### USB 3 A source, cell 3.2 V, charging, 0.8 A load

Nominal corner: charge current allowed by thermal regulation 1.77 A, VBUS at the connector 5.00 V, CHGIN at U4 4.90 V, VSYS 3.50 V, BATT at U4 3.35 V, input current 2.51 A, charge current 1.77 A, buck output current 3.00 A, buck duty 79.9 %, boost input current 1.23 A, BATFET mode: linear (VSYS held at VSYSMIN), charger efficiency 85.7 %, boost efficiency 94.5 %.

| Element | Nominal | High |
|---|---|---|
| MAX77757 buck | 1.65 W | 1.72 W |
| MAX77757 BATT-SYS switch | 257 mW | 131 mW |
| TPS61088 | 185 mW | 185 mW |
| L1 | 106 mW | 102 mW |
| FB1 ferrite bead | 94 mW | 123 mW |
| copper CHG_SW | 64 mW | 61 mW |
| USB-C contacts | 63 mW | 123 mW |
| LEDs and series resistors | 57 mW | 57 mW |
| copper USB_VBUS | 53 mW | 53 mW |
| L2 | 50 mW | 50 mW |
| copper USB_VBUS_J1 | 41 mW | 40 mW |
| F1 fuse | 35 mW | 43 mW |
| JST-PH battery contacts | 31 mW | 58 mW |
| copper VSYS | 23 mW | 21 mW |
| copper VBAT | 18 mW | 16 mW |
| shunts and module sockets | 16 mW | 33 mW |
| LM73100 ideal diodes | 15 mW | 24 mW |
| TPS22975 | 13 mW | 13 mW |
| copper GND pour | 7 mW | 7 mW |
| copper RAIL_5V | 7 mW | 7 mW |
| copper BAT_IN | 5 mW | 5 mW |
| copper BOOST_5V | 4 mW | 4 mW |
| copper ADS_5V_D | 3 mW | 3 mW |
| copper BOOST_SW | 1 mW | 1 mW |
| copper ADS_5V | 1 mW | 1 mW |
| copper ESP_5V_D | 0 mW | 0 mW |
| copper ESP_5V | 0 mW | 0 mW |
| **Board total** | **2.80 W** | **2.88 W** |
| Modules (5 V power, heat inside the case) | 3.99 W | 3.96 W |
| Battery pack I²R | 188 mW | 259 mW |
| Inside the case | 6.97 W | 7.10 W |

### USB 3 A source, cell 3.2 V, charging, device off

Nominal corner: charge current allowed by thermal regulation 1.80 A, VBUS at the connector 5.00 V, CHGIN at U4 4.94 V, VSYS 3.50 V, BATT at U4 3.36 V, input current 1.42 A, charge current 1.80 A, buck output current 1.81 A, buck duty 74.8 %, boost input current 0.00 A, BATFET mode: linear (VSYS held at VSYSMIN), charger efficiency 90.3 %.

| Element | Nominal | High |
|---|---|---|
| MAX77757 buck | 631 mW | 718 mW |
| MAX77757 BATT-SYS switch | 257 mW | 114 mW |
| L1 | 47 mW | 47 mW |
| F1 fuse | 36 mW | 49 mW |
| JST-PH battery contacts | 32 mW | 65 mW |
| FB1 ferrite bead | 30 mW | 42 mW |
| LEDs and series resistors | 24 mW | 24 mW |
| USB-C contacts | 20 mW | 42 mW |
| copper CHG_SW | 20 mW | 20 mW |
| copper VSYS | 16 mW | 16 mW |
| copper VBAT | 16 mW | 16 mW |
| copper USB_VBUS | 15 mW | 15 mW |
| copper USB_VBUS_J1 | 11 mW | 12 mW |
| copper BAT_IN | 5 mW | 5 mW |
| copper GND pour | 3 mW | 3 mW |
| **Board total** | **1.16 W** | **1.19 W** |
| Modules (5 V power, heat inside the case) | 0 mW | 0 mW |
| Battery pack I²R | 194 mW | 292 mW |
| Inside the case | 1.36 W | 1.48 W |

## Temperatures

Hot spots from the grid solution. "θJA" is the naive figure from the data sheet's JEDEC θJA with the same loss at the same ambient, for comparison only.

| Case | Environment | Ambient | Corner | Case air | U4 Tj | U6 Tj | U7 Tj | L1 | L2 | Board max | Hottest X7R | Pack |
|---|---|---|---|---|---|---|---|---|---|---|---|---|
| Battery 3.1 V, typical 1.22 W load | open | 25 °C | nominal | 25.0 | 26 (θJA 25) | 29 (θJA 29) | 27 | - | 28 | 28 | 28 (C15) | 25.1 |
| Battery 3.1 V, typical 1.22 W load | closed | 25 °C | nominal | 32.9 | 34 (θJA 25) | 37 (θJA 29) | 36 | - | 36 | 37 | 36 (C15) | 33.0 |
|  |  |  | high | 33.0 | 34 (θJA 25) | 37 (θJA 29) | 36 | - | 36 | 37 | 36 (C15) | 33.1 |
| Battery 3.1 V, typical 1.22 W load | closed | 50 °C | nominal | 58.0 | 59 (θJA 50) | 62 (θJA 54) | 61 | - | 61 | 62 | 61 (C15) | 58.1 |
|  |  |  | high | 58.0 | 60 (θJA 50) | 62 (θJA 54) | 61 | - | 61 | 62 | 61 (C15) | 58.2 |
| Battery 3.1 V, 0.8 A load | open | 25 °C | nominal | 25.0 | 28 (θJA 26) | 33 (θJA 33) | 30 | - | 31 | 33 | 31 (C15) | 26.1 |
| Battery 3.1 V, 0.8 A load | closed | 25 °C | nominal | 49.3 | 54 (θJA 26) | 60 (θJA 33) | 57 | - | 57 | 59 | 57 (C15) | 50.3 |
|  |  |  | high | 49.7 | 55 (θJA 26) | 61 (θJA 33) | 58 | - | 58 | 60 | 58 (C15) | 51.3 |
| Battery 3.1 V, 0.8 A load | closed | 50 °C | nominal | 74.5 | 79 (θJA 51) | 85 (θJA 58) | 82 | - | 83 | 85 | 83 (C15) | 75.5 |
|  |  |  | high | 74.9 | 80 (θJA 51) | 86 (θJA 58) | 83 | - | 83 | 86 | 84 (C15) | 76.5 |
| Battery 3.1 V, 1.0 A load | open | 25 °C | nominal | 25.0 | 29 (θJA 27) | 36 (θJA 34) | 32 | - | 33 | 35 | 33 (C15) | 26.7 |
| Battery 3.1 V, 1.0 A load | closed | 25 °C | nominal | 55.2 | 62 (θJA 27) | 69 (θJA 35) | 65 | - | 66 | 68 | 66 (C15) | 56.8 |
|  |  |  | high | 55.8 | 63 (θJA 27) | 70 (θJA 35) | 67 | - | 67 | 70 | 67 (C15) | 58.3 |
| Battery 3.1 V, 1.0 A load | closed | 50 °C | nominal | 80.5 | 87 (θJA 52) | 94 (θJA 60) | 91 | - | 91 | 94 | 91 (C15) | 82.1 |
|  |  |  | high | 81.1 | 89 (θJA 52) | 96 (θJA 60) | 92 | - | 93 | 95 | 93 (C15) | 83.6 |
| USB 3 A source, cell 3.7 V, charging, 0.8 A load | open | 25 °C | nominal | 25.0 | 72 (θJA 72) | 43 (θJA 31) | 40 | 47 | 43 | 68 | 53 (C34) | 26.8 |
| USB 3 A source, cell 3.7 V, charging, 0.8 A load | closed | 25 °C | nominal | 59.9 | 122 (θJA 77) | 88 (θJA 32) | 84 | 93 | 88 | 117 | 100 (C34) | 61.7 |
|  |  |  | high | 61.8 | 130 (θJA 82) | 94 (θJA 31) | 90 | 99 | 94 | 125 | 107 (C34) | 64.4 |
| USB 3 A source, cell 3.2 V, charging, 0.8 A load | open | 25 °C | nominal | 25.0 | 79 (θJA 79) | 45 (θJA 32) | 41 | 50 | 44 | 74 | 57 (C34) | 26.8 |
| USB 3 A source, cell 3.2 V, charging, 0.8 A load | closed | 25 °C | nominal | 60.9 | 130 (θJA 84) | 91 (θJA 32) | 87 | 97 | 91 | 124 | 105 (C34) | 62.6 |
|  |  |  | high | 61.5 | 130 (θJA 82) | 93 (θJA 32) | 89 | 98 | 93 | 124 | 106 (C34) | 63.9 |
| USB 3 A source, cell 3.2 V, charging, device off | open | 25 °C | nominal | 25.0 | 51 (θJA 52) | - | - | 36 | - | 49 | 40 (C11) | 26.8 |
| USB 3 A source, cell 3.2 V, charging, device off | closed | 25 °C | nominal | 32.8 | 64 (θJA 53) | - | - | 48 | - | 61 | 52 (C11) | 34.5 |
|  |  |  | high | 33.4 | 63 (θJA 51) | - | - | 49 | - | 61 | 53 (C11) | 36.1 |

All temperatures in °C. Board max is the hottest grid cell (1 mm), not a pad.

## Checks

- PASS: USB 3 A source, cell 3.7 V, charging, 0.8 A load, open bench, 25 °C: full 1.8 A charge current (U4 junction 72 °C, regulation at 130 °C)
- PASS: USB 3 A source, cell 3.2 V, charging, 0.8 A load, open bench, 25 °C: full 1.8 A charge current (U4 junction 79 °C, regulation at 130 °C)
- PASS: USB 3 A source, cell 3.2 V, charging, device off, open bench, 25 °C: full 1.8 A charge current (U4 junction 51 °C, regulation at 130 °C)
- PASS: TPS61088 junction at most 96 °C (Battery 3.1 V, 1.0 A load, 50 °C ambient, high corner, closed case), limit 125 °C
- PASS: TPS22975 junction at most 92 °C (Battery 3.1 V, 1.0 A load, 50 °C ambient, high corner, closed case), limit 125 °C
- PASS: L1 winding at most 99 °C (USB 3 A source, cell 3.7 V, charging, 0.8 A load, 25 °C ambient, high corner, closed case), limit 125 °C
- PASS: L2 winding at most 94 °C (USB 3 A source, cell 3.7 V, charging, 0.8 A load, 25 °C ambient, high corner, closed case), limit 125 °C
- PASS: hottest board cell 124.7 °C (USB 3 A source, cell 3.7 V, charging, 0.8 A load, 25 °C ambient, high corner, closed case); limit 125 °C (FR4 Tg 130 °C and up)
- PASS: X7R bulk capacitors at 25 °C ambient, closed case: hottest C34 at 107 °C (USB 3 A source, cell 3.7 V, charging, 0.8 A load, high corner), rating 125 °C
- PASS: X7R bulk capacitors at 50 °C ambient, closed case: hottest C15 at 93 °C (Battery 3.1 V, 1.0 A load, high corner), rating 125 °C
- PASS: Battery 3.1 V, typical 1.22 W load, closed case, 25 °C ambient, high corner: pack at 33.1 °C; it must stay below the thermostat's lowest opening point 55 °C (60 °C ± 5 K)
- PASS: Battery 3.1 V, 0.8 A load, closed case, 25 °C ambient, high corner: pack at 51.3 °C; it must stay below the thermostat's lowest opening point 55 °C (60 °C ± 5 K)
- **FAIL**: Battery 3.1 V, 1.0 A load, closed case, 25 °C ambient, high corner: pack at 58.3 °C; it must stay below the thermostat's lowest opening point 55 °C (60 °C ± 5 K)
- PASS: battery current at most 1.80 A through J3, JST PH rating 2 A (AWG 24)
- PASS: USB input current at most 2.73 A, MC-107DMS rating 5 A

## Charger thermal regulation

The MAX77757 holds its junction at TREG by reducing the charge current (fixed 130 °C). Below zero charge current the model lets the input current fall so that the battery supplements the system. The table gives the charge current the board sustains in steady state at the TREG of each case. Negative: the battery discharges into the load although USB is present.

| Case | Environment | Corner | TREG | Charge current | Input current | U4 Tj | U4 loss |
|---|---|---|---|---|---|---|---|
| USB 3 A source, cell 3.7 V, charging, 0.8 A load | open bench, no enclosure | nominal | 130 °C | 1.80 A | 2.62 A | 72 °C | 1.50 W |
| USB 3 A source, cell 3.7 V, charging, 0.8 A load | closed 3D-printed case | nominal | 130 °C | 1.80 A | 2.66 A | 122 °C | 1.69 W |
| USB 3 A source, cell 3.7 V, charging, 0.8 A load | closed 3D-printed case | high | 130 °C | 1.78 A | 2.73 A | 130 °C | 1.84 W |
| USB 3 A source, cell 3.2 V, charging, 0.8 A load | open bench, no enclosure | nominal | 130 °C | 1.80 A | 2.49 A | 79 °C | 1.75 W |
| USB 3 A source, cell 3.2 V, charging, 0.8 A load | closed 3D-printed case | nominal | 130 °C | 1.77 A | 2.51 A | 130 °C | 1.90 W |
| USB 3 A source, cell 3.2 V, charging, 0.8 A load | closed 3D-printed case | high | 130 °C | 1.70 A | 2.48 A | 130 °C | 1.85 W |
| USB 3 A source, cell 3.2 V, charging, device off | open bench, no enclosure | nominal | 130 °C | 1.80 A | 1.41 A | 51 °C | 0.87 W |
| USB 3 A source, cell 3.2 V, charging, device off | closed 3D-printed case | nominal | 130 °C | 1.80 A | 1.42 A | 64 °C | 0.89 W |
| USB 3 A source, cell 3.2 V, charging, device off | closed 3D-printed case | high | 130 °C | 1.80 A | 1.44 A | 63 °C | 0.83 W |
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
