mp911de/airgrep/issues/README.md

# Issues

One markdown file per issue, named `NNNN-short-title.md`, numbered in order of creation.
Each file starts with a title, a `Status:` line (open, planned, done, dropped) and a `Created:` date.
Closed issues stay in place with their status updated.

| # | Title | Status |
|---|---|---|
| [0001](0001-battery-disconnect-switch.md) | Battery disconnect switch for the off state | planned, next revision |
| [0002](0002-battery-reverse-polarity-protection.md) | Reverse-polarity protection at J3 | planned |
| [0003](0003-max77972-charger-and-gauge.md) | MAX77972 as charger and fuel gauge | open |
