mp911de/airgrep/(list of files, drawings)

Other design files:
hardware/kicad/carrier2.dsn
hardware/kicad/carrier3.dsn
hardware/kicad/carrier4.dsn
hardware/kicad/carrier5.dsn
hardware/kicad/carrier6.dsn
hardware/kicad/carrier7.dsn
hardware/kicad/carrier8.dsn
hardware/kicad/carrier9.dsn
hardware/kicad/carrier.dsn
hardware/kicad/freerouting.dsn
hardware/kicad/temp-freerouting.dsn
