mp911de/airgrep/hardware/carrier-ti-charger/carrier.kicad_pcb

## KiCad design hardware/carrier-ti-charger/carrier.kicad_pcb (2026-10-19)

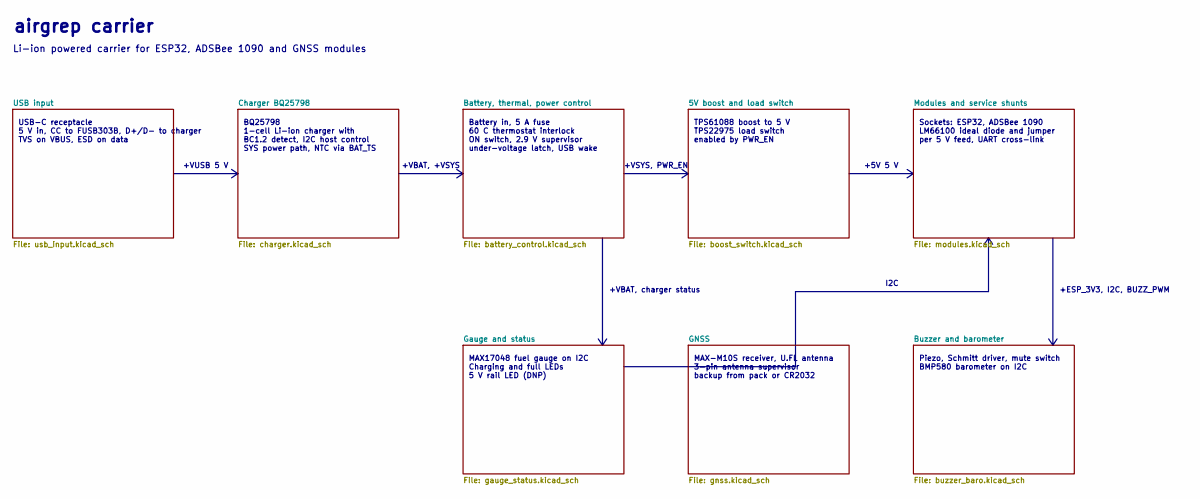
[picture p12: schematic carrier.kicad_sch, airgrep carrier]

Notes on the sheet:
I2C
TPS61088 boost to 5 V TPS22975 load switch enabled by PWR_EN
Piezo, Schmitt driver, mute switch BMP580 barometer on I2C
BQ25798 1-cell Li-ion charger with BC1.2 detect, I2C host control SYS power path, NTC via BAT_TS
airgrep carrier
+VBAT, +VSYS
+ESP_3V3, I2C, BUZZ_PWM
+VBAT, charger status
Sockets: ESP32, ADSBee 1090 LM66100 ideal diode and jumper per 5 V feed, UART cross-link
Battery in, 5 A fuse 60 C thermostat interlock ON switch, 2.9 V supervisor under-voltage latch, USB wake
MAX-M10S receiver, U.FL antenna 3-pin antenna supervisor backup from pack or CR2032
+VUSB 5 V
+5V 5 V
USB-C receptacle 5 V in, CC to FUSB303B, D+/D- to charger TVS on VBUS, ESD on data
MAX17048 fuel gauge on I2C Charging and full LEDs 5 V rail LED (DNP)
+VSYS, PWR_EN
Li-ion powered carrier for ESP32, ADSBee 1090 and GNSS modules

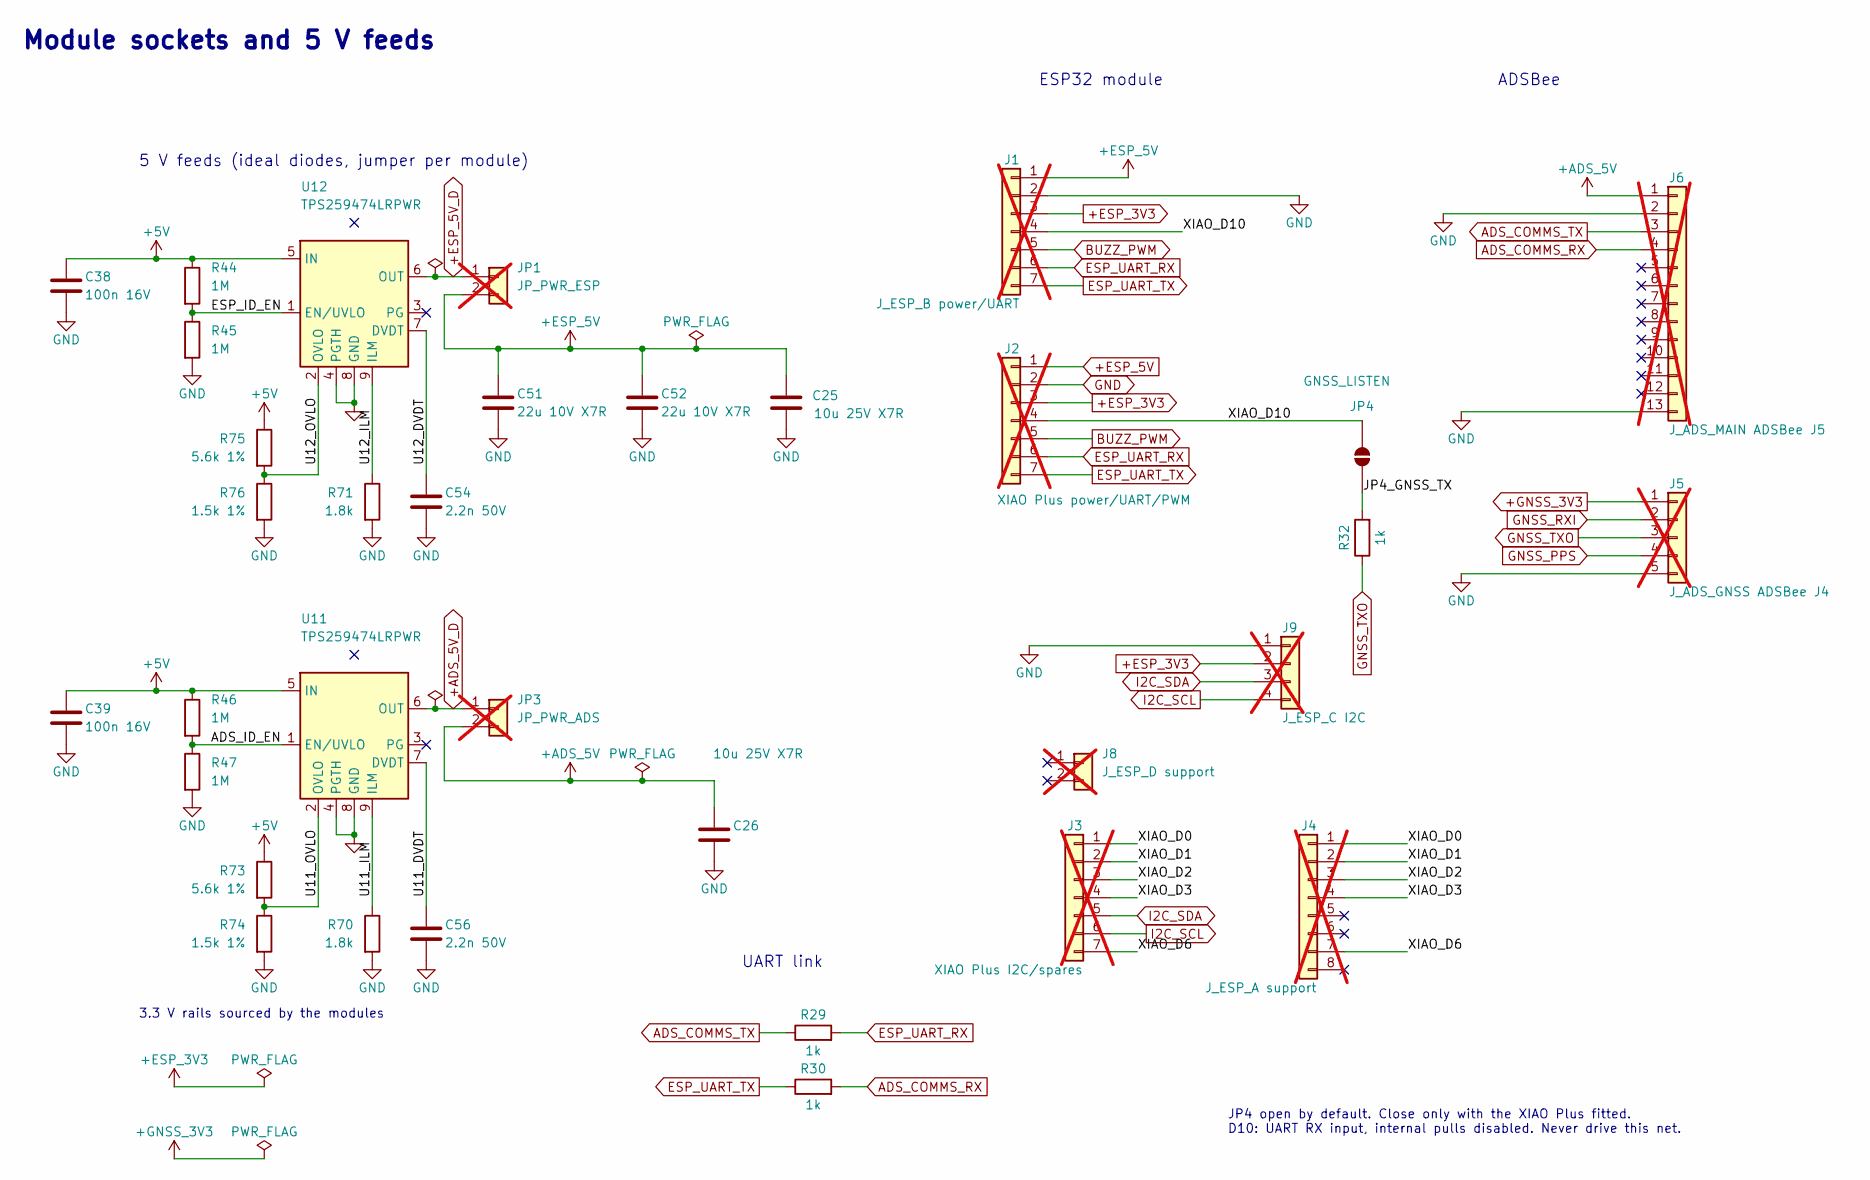
[picture p13: schematic modules.kicad_sch, Modules and service shunts]

Parts:
C25, C26: 10u 25V X7R; C_0805_2012Metric; LCSC C3039694
C38, C39: 100n 16V; C_0402_1005Metric_NoSilk; MPN CL05B104KO5NNNC; LCSC C1525
C51, C52: 22u 10V X7R; C_0805_2012Metric; LCSC C907991
C54, C56: 2.2n 50V; C_0603_1608Metric; MPN 0603B222K500NT; LCSC C1604
J1: J_ESP_B power/UART; PinSocket_1x07_P2.54mm_Vertical; not fitted
J2: XIAO Plus power/UART/PWM; PinHeader_1x07_P2.54mm_Vertical; not fitted
J3: XIAO Plus I2C/spares; PinHeader_1x07_P2.54mm_Vertical; not fitted
J4: J_ESP_A support; PinSocket_1x08_P2.54mm_Vertical; not fitted
J5: J_ADS_GNSS ADSBee J4; PinSocket_1x05_P2.54mm_Vertical; not fitted
J6: J_ADS_MAIN ADSBee J5; PinSocket_1x13_P2.54mm_Vertical; not fitted
J8: J_ESP_D support; PinSocket_1x02_P2.54mm_Vertical; not fitted
J9: J_ESP_C I2C; PinSocket_1x04_P2.54mm_Vertical; not fitted
JP1: JP_PWR_ESP; PinHeader_1x02_P2.54mm_Vertical; not fitted
JP3: JP_PWR_ADS; PinHeader_1x02_P2.54mm_Vertical; not fitted
JP4: GNSS_LISTEN; SolderJumper-2_P1.3mm_Open_RoundedPad1.0x1.5mm
R29, R30, R32: 1k; R_0603_1608Metric; LCSC C21190
R44, R45, R46, R47: 1M; R_0603_1608Metric; LCSC C22935
R70, R71: 1.8k; R_0603_1608Metric; Tolerance 1%; MPN 0603WAF1801T5E; LCSC C4177
R73, R75: 5.6k 1%; R_0603_1608Metric; Tolerance 1%; MPN 0603WAF5601T5E; LCSC C23189
R74, R76: 1.5k 1%; R_0402_1005Metric_NoSilk; Tolerance 1%; MPN 0402WGF1501TCE; LCSC C25867
U11, U12: TPS259474LRPWR; VQFN-10_L2.0-W2.0-P0.45-HR_LM73100; LCSC C2864845

Connections:
+5V: C38.1, C39.1, R44.1, R46.1, R73.1, R75.1, U11.5 (IN), U12.5 (IN); also elsewhere on the board
+ADS_5V: C26.1, J6.1, JP3.2
+ADS_5V_D: JP3.1, U11.6 (OUT)
+ESP_3V3: J1.3, J2.3, J9.2; also elsewhere on the board
+ESP_5V: C25.1, C51.1, C52.1, J1.1, J2.1, JP1.2
+ESP_5V_D: JP1.1, U12.6 (OUT); also elsewhere on the board
+GNSS_3V3: J5.1; also elsewhere on the board
/Modules and service shunts/ADS_ID_EN: R46.2, R47.1, U11.1 (EN/UVLO)
/Modules and service shunts/ESP_ID_EN: R44.2, R45.1, U12.1 (EN/UVLO)
/Modules and service shunts/JP4_GNSS_TX: JP4.1 (A), R32.2
/Modules and service shunts/U11_DVDT: C56.1, U11.7 (DVDT)
/Modules and service shunts/U11_ILM: R70.1, U11.9 (ILM)
/Modules and service shunts/U11_OVLO: R73.2, R74.1, U11.2 (OVLO)
/Modules and service shunts/U12_DVDT: C54.1, U12.7 (DVDT)
/Modules and service shunts/U12_ILM: R71.1, U12.9 (ILM)
/Modules and service shunts/U12_OVLO: R75.2, R76.1, U12.2 (OVLO)
/Modules and service shunts/XIAO_D0: J3.1, J4.1
/Modules and service shunts/XIAO_D1: J3.2, J4.2
/Modules and service shunts/XIAO_D2: J3.3, J4.3
/Modules and service shunts/XIAO_D3: J3.4, J4.4
/Modules and service shunts/XIAO_D6: J3.7, J4.7
/Modules and service shunts/XIAO_D10: J1.4, J2.4, JP4.2 (B)
ADS_COMMS_RX: J6.4, R30.2
ADS_COMMS_TX: J6.3, R29.1
BUZZ_PWM: J1.5, J2.5; also elsewhere on the board
ESP_UART_RX: J1.6, J2.6, R29.2
ESP_UART_TX: J1.7, J2.7, R30.1
GND: C25.2, C26.2, C38.2, C39.2, C51.2, C52.2, C54.2, C56.2, J1.2, J2.2, J5.5, J6.2, J6.13, J9.1, R45.2, R47.2, R70.2, R71.2, R74.2, R76.2, U11.4 (PGTH), U11.8 (GND), U12.4 (PGTH), U12.8 (GND); also elsewhere on the board
GNSS_PPS: J5.4; also elsewhere on the board
GNSS_RXI: J5.2; also elsewhere on the board
GNSS_TXO: J5.3, R32.1; also elsewhere on the board
I2C_SCL: J3.6, J9.4; also elsewhere on the board
I2C_SDA: J3.5, J9.3; also elsewhere on the board

Notes on the sheet:
Module sockets and 5 V feeds
UART link
ADSBee
3.3 V rails sourced by the modules
JP4 open by default. Close only with the XIAO Plus fitted. D10: UART RX input, internal pulls disabled. Never drive this net.
5 V feeds (ideal diodes, jumper per module)
ESP32 module

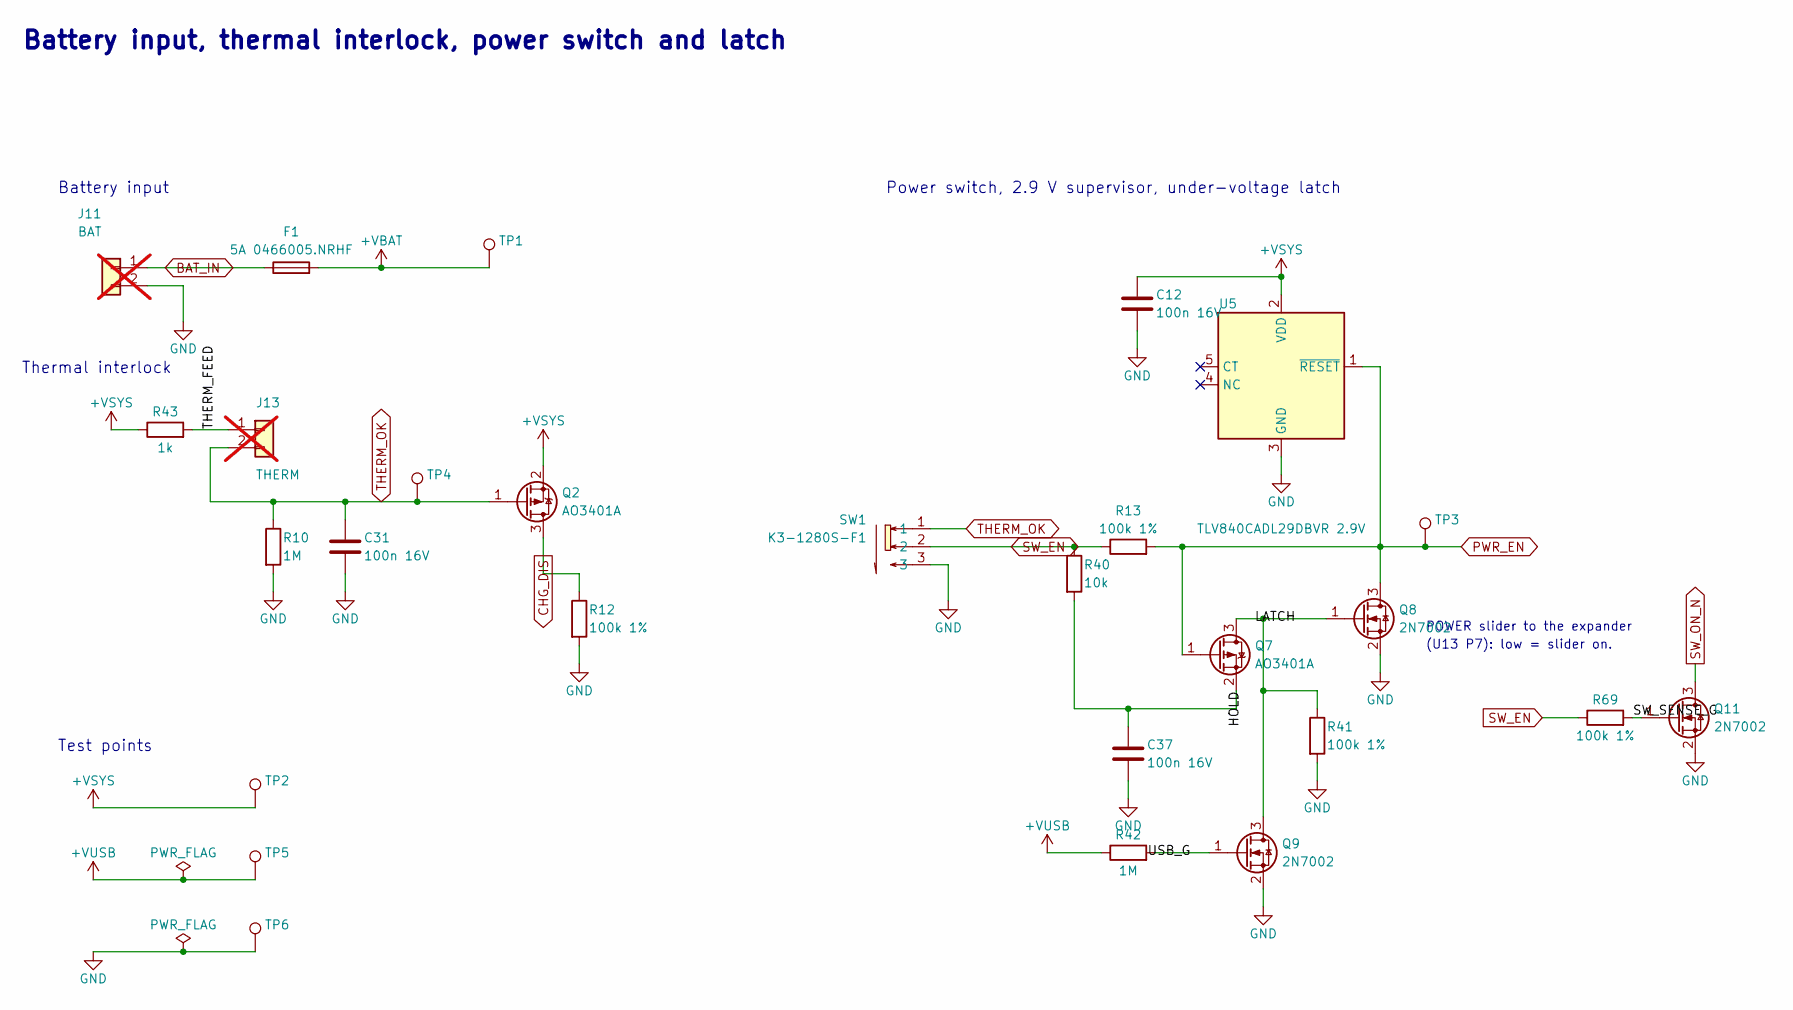
[picture p14: schematic battery_control.kicad_sch, Battery, thermal, power control]

Parts:
C12, C31, C37: 100n 16V; C_0402_1005Metric_NoSilk; MPN CL05B104KO5NNNC; LCSC C1525
F1: 5A 0466005.NRHF; Fuse_1206_3216Metric; LCSC C57525
J11: BAT; JST_PH_B2B-PH-K_1x02_P2.00mm_Vertical_R10; not fitted
J13: THERM; JST_PH_B2B-PH-K_1x02_P2.00mm_Vertical_R10; not fitted
Q2, Q7: AO3401A; SOT-23; LCSC C15127
Q8, Q9, Q11: 2N7002; SOT-23; LCSC C8545
R10, R42: 1M; R_0603_1608Metric; LCSC C22935
R12, R13, R41, R69: 100k 1%; R_0603_1608Metric; LCSC C25803
R40: 10k; R_0603_1608Metric; LCSC C25804
R43: 1k; R_0603_1608Metric; LCSC C21190
SW1: K3-1280S-F1; SW-SMD_K3-1280S-F1; LCSC C92658
TP1: +VBAT; TestPoint_Pad_D1.5mm
TP2: +VSYS; TestPoint_Pad_D1.5mm
TP3: PWR_EN; TestPoint_Pad_D1.5mm
TP4: THERM_OK; TestPoint_Pad_D1.5mm
TP5: +VUSB; TestPoint_Pad_D1.5mm
TP6: GND; TestPoint_Pad_D1.5mm
U5: TLV840CADL29DBVR 2.9V; SOT-23-5_L2.9-W1.6-P0.95-LS2.8-BR; LCSC C3686404

Connections:
+VBAT: F1.2, TP1.1 (1_1); also elsewhere on the board
+VSYS: C12.1, Q2.2 (S), R43.1, TP2.1 (1_1), U5.2 (VDD); also elsewhere on the board
+VUSB: R42.1, TP5.1 (1_1); also elsewhere on the board
/Battery, thermal, power control/HOLD: C37.2, Q7.2 (S), R40.2
/Battery, thermal, power control/LATCH: Q7.3 (D), Q8.1 (G), Q9.3 (D), R41.1
/Battery, thermal, power control/SW_SENSE_G: Q11.1 (G), R69.2
/Battery, thermal, power control/THERM_FEED: J13.1, R43.2
/Battery, thermal, power control/USB_G: Q9.1 (G), R42.2
BAT_IN: F1.1, J11.1
CHG_DIS: Q2.3 (D), R12.1; also elsewhere on the board
GND: C12.2, C31.2, C37.1, J11.2, Q8.2 (S), Q9.2 (S), Q11.2 (S), R10.2, R12.2, R41.2, SW1.3, TP6.1 (1_1), U5.3 (GND); also elsewhere on the board
PWR_EN: Q7.1 (G), Q8.3 (D), R13.2, TP3.1 (1_1), U5.1 (~RESET); also elsewhere on the board
SW_EN: R13.1, R40.1, R69.1, SW1.2; also elsewhere on the board
SW_ON_N: Q11.3 (D); also elsewhere on the board
THERM_OK: C31.1, J13.2, Q2.1 (G), R10.1, SW1.1, TP4.1 (1_1)

Notes on the sheet:
Battery input
Battery input, thermal interlock, power switch and latch
Power switch, 2.9 V supervisor, under-voltage latch
Test points
(U13 P7): low = slider on.
Thermal interlock
POWER slider to the expander

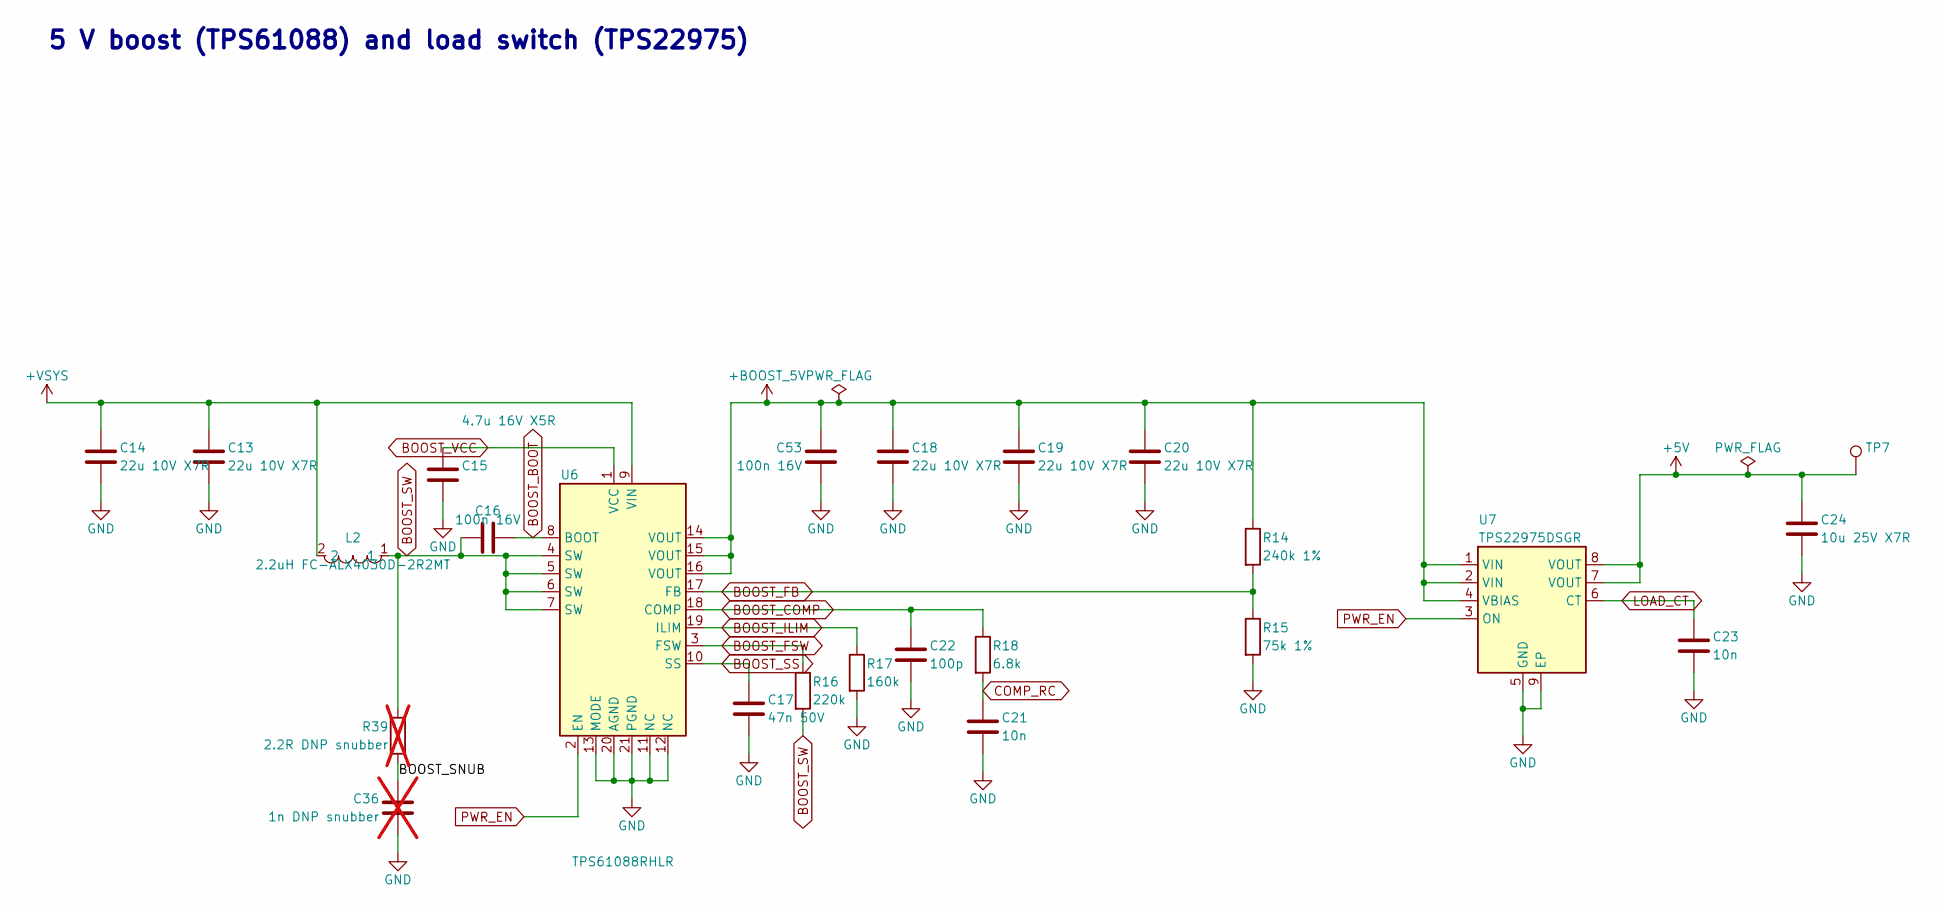
[picture p15: schematic boost_switch.kicad_sch, 5V boost and load switch]

Parts:
C13, C14, C18, C19, C20: 22u 10V X7R; C_0805_2012Metric; LCSC C907991
C15: 4.7u 16V X5R; C_0603_1608Metric; LCSC C19666
C16, C53: 100n 16V; C_0402_1005Metric_NoSilk; MPN CL05B104KO5NNNC; LCSC C1525
C17: 47n 50V; C_0603_1608Metric; LCSC C1622
C21, C23: 10n; C_0603_1608Metric; LCSC C57112
C22: 100p; C_0603_1608Metric; LCSC C14858
C24: 10u 25V X7R; C_0805_2012Metric; LCSC C3039694
C36: 1n DNP snubber; C_0603_1608Metric; not fitted
L2: 2.2uH FC-ALX4030D-2R2MT; IND-SMD_L4.2-W4.2_FC-ALX4030D; LCSC C5370906
R14: 240k 1%; R_0603_1608Metric; LCSC C4197
R15: 75k 1%; R_0603_1608Metric; LCSC C23242
R16: 220k; R_0603_1608Metric; LCSC C22961
R17: 160k; R_0603_1608Metric; LCSC C22813
R18: 6.8k; R_0603_1608Metric; LCSC C23212
R39: 2.2R DNP snubber; R_0603_1608Metric; not fitted
TP7: +5V; TestPoint_Pad_D1.5mm
U6: TPS61088RHLR; VQFN-20_L4.6-W3.6-P0.50-BL; LCSC C87357
U7: TPS22975DSGR; Texas_DSG0008A_WSON-8-1EP_2x2mm_P0.5mm_EP0.9x1.6mm; LCSC C524777

Connections:
+5V: C24.1, TP7.1 (1_1), U7.7 (VOUT), U7.8 (VOUT); also elsewhere on the board
+BOOST_5V: C18.1, C19.1, C20.1, C53.1, R14.1, U6.14 (VOUT), U6.15 (VOUT), U6.16 (VOUT), U7.1 (VIN), U7.2 (VIN), U7.4 (VBIAS)
+VSYS: C13.1, C14.1, L2.2, U6.9 (VIN); also elsewhere on the board
/5V boost and load switch/BOOST_SNUB: C36.1, R39.2
BOOST_BOOT: C16.1, U6.8 (BOOT)
BOOST_COMP: C22.1, R18.1, U6.18 (COMP)
BOOST_FB: R14.2, R15.1, U6.17 (FB)
BOOST_FSW: R16.1, U6.3 (FSW)
BOOST_ILIM: R17.1, U6.19 (ILIM)
BOOST_SS: C17.1, U6.10 (SS)
BOOST_SW: C16.2, L2.1, R16.2, R39.1, U6.4 (SW), U6.5 (SW), U6.6 (SW), U6.7 (SW)
BOOST_VCC: C15.1, U6.1 (VCC)
COMP_RC: C21.1, R18.2
GND: C13.2, C14.2, C15.2, C17.2, C18.2, C19.2, C20.2, C21.2, C22.2, C23.2, C24.2, C36.2, C53.2, R15.2, R17.2, U6.11 (NC), U6.12 (NC), U6.13 (MODE), U6.20 (AGND), U6.21 (PGND), U7.5 (GND), U7.9 (EP); also elsewhere on the board
LOAD_CT: C23.1, U7.6 (CT)
PWR_EN: U6.2 (EN), U7.3 (ON); also elsewhere on the board

Notes on the sheet:
5 V boost (TPS61088) and load switch (TPS22975)

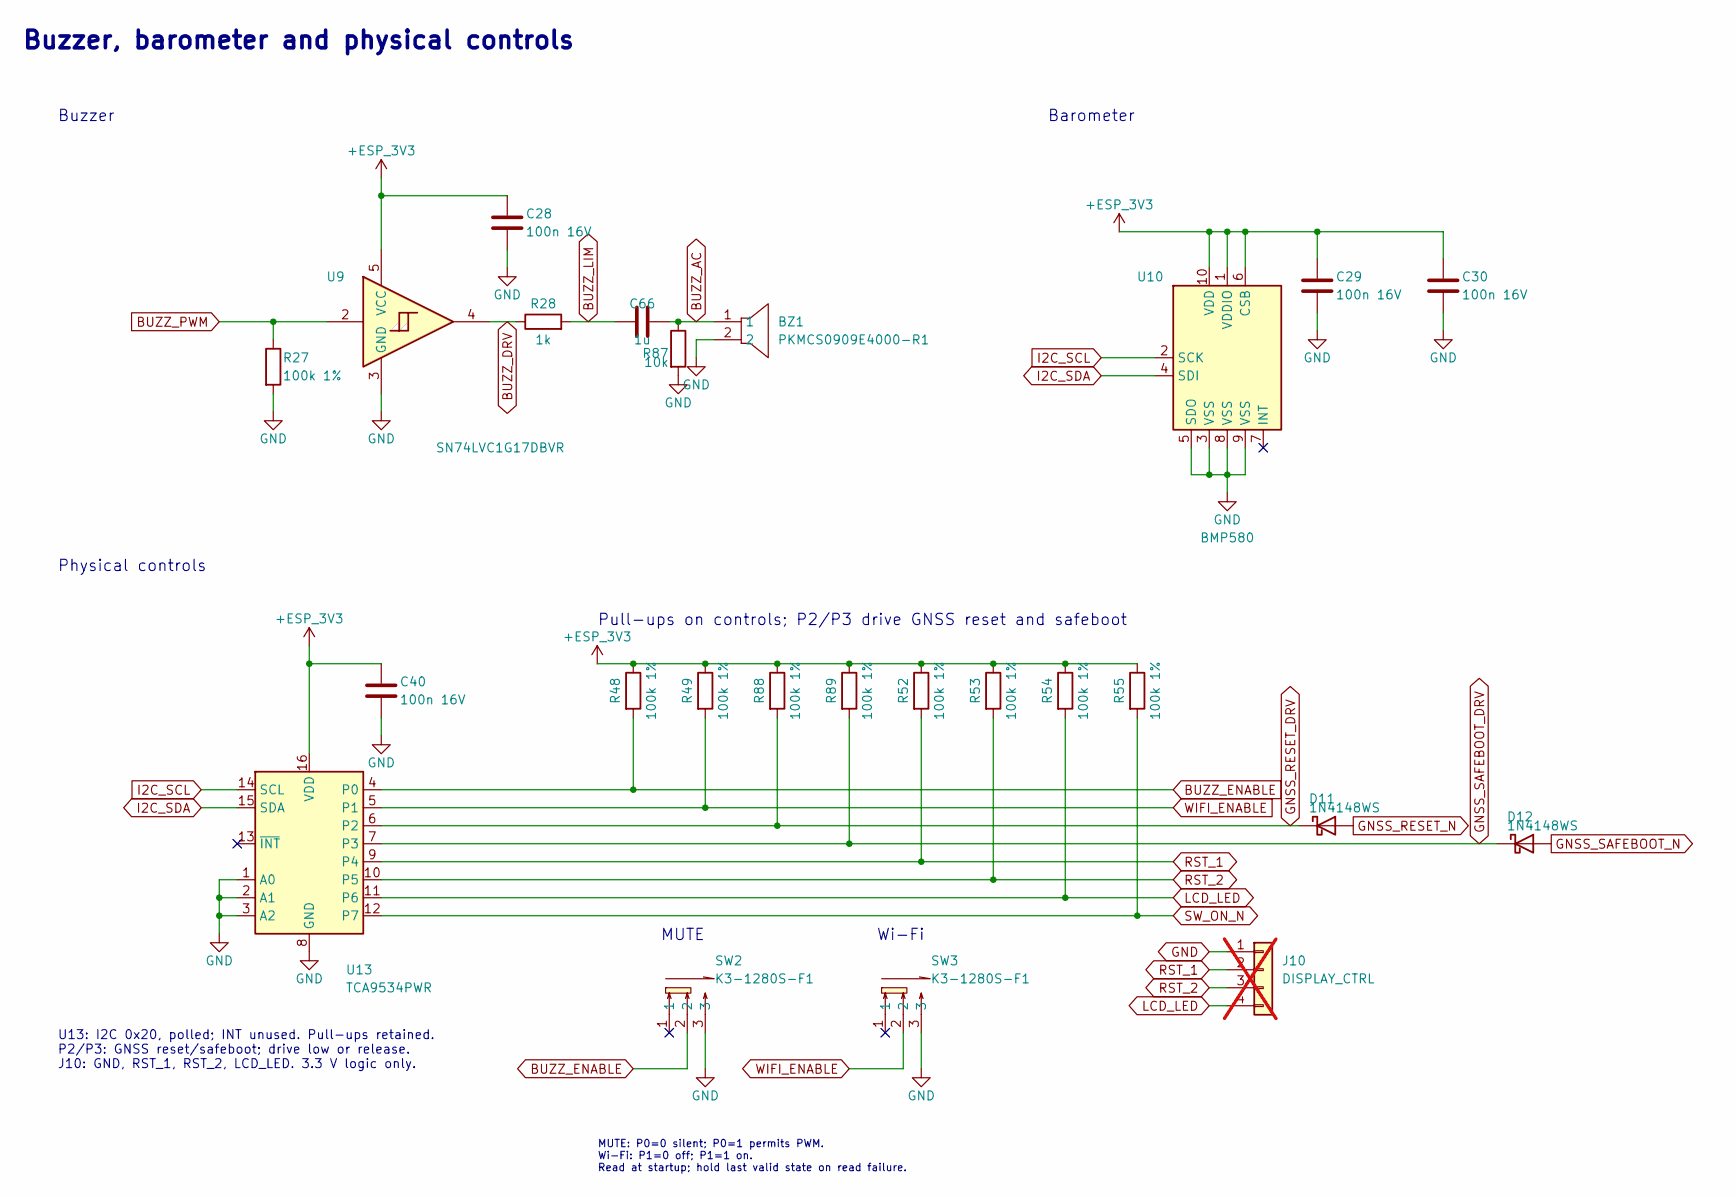
[picture p16: schematic buzzer_baro.kicad_sch, Buzzer and barometer]

Parts:
BZ1: PKMCS0909E4000-R1; BUZ-SMD_L9.0-W9.0_PKMCS0909E4000-R1; LCSC C910763
C28, C29, C30, C40: 100n 16V; C_0402_1005Metric_NoSilk; MPN CL05B104KO5NNNC; LCSC C1525
C66: 1u; C_0603_1608Metric; MPN CL10A105KB8NNNC; LCSC C15849
D11, D12: 1N4148WS; D_SOD-323; MPN 1N4148WS; LCSC C2128
J10: DISPLAY_CTRL; PinHeader_1x04_P2.54mm_Vertical; not fitted
R27, R48, R49, R52, R53, R54, R55, R88, R89: 100k 1%; R_0603_1608Metric; LCSC C25803
R28: 1k; R_0603_1608Metric; LCSC C21190
R87: 10k; R_0402_1005Metric_NoSilk; MPN 0402WGF1002TCE; LCSC C25744
SW2, SW3: K3-1280S-F1; SW-SMD_K3-1280S-F1; LCSC C92658
U9: SN74LVC1G17DBVR; SOT-23-5; LCSC C7836
U10: BMP580; LGA-10_L2.0-W2.0-P0.50-TL_BMP581; MPN BMP580; LCSC C22391138
U13: TCA9534PWR; TSSOP-16_4.4x5mm_P0.65mm; LCSC C783615

Connections:
+ESP_3V3: C28.1, C29.1, C30.1, C40.1, R48.1, R49.1, R52.1, R53.1, R54.1, R55.1, R88.1, R89.1, U9.5 (VCC), U10.1 (VDDIO), U10.6 (CSB), U10.10 (VDD), U13.16 (VDD); also elsewhere on the board
BUZZ_AC: BZ1.1, C66.2, R87.1
BUZZ_DRV: R28.1, U9.4
BUZZ_ENABLE: R48.2, SW2.2, U13.4 (P0)
BUZZ_LIM: C66.1, R28.2
BUZZ_PWM: R27.1, U9.2; also elsewhere on the board
GND: BZ1.2, C28.2, C29.2, C30.2, C40.2, J10.1, R27.2, R87.2, SW2.3, SW3.3, U9.3 (GND), U10.3 (VSS), U10.5 (SDO), U10.8 (VSS), U10.9 (VSS), U13.1 (A0), U13.2 (A1), U13.3 (A2), U13.8 (GND); also elsewhere on the board
GNSS_RESET_DRV: D11.1 (K), R88.2, U13.6 (P2)
GNSS_RESET_N: D11.2 (A); also elsewhere on the board
GNSS_SAFEBOOT_DRV: D12.1 (K), R89.2, U13.7 (P3)
GNSS_SAFEBOOT_N: D12.2 (A); also elsewhere on the board
I2C_SCL: U10.2 (SCK), U13.14 (SCL); also elsewhere on the board
I2C_SDA: U10.4 (SDI), U13.15 (SDA); also elsewhere on the board
LCD_LED: J10.4, R54.2, U13.11 (P6)
RST_1: J10.2, R52.2, U13.9 (P4)
RST_2: J10.3, R53.2, U13.10 (P5)
SW_ON_N: R55.2, U13.12 (P7); also elsewhere on the board
WIFI_ENABLE: R49.2, SW3.2, U13.5 (P1)

Notes on the sheet:
Wi-Fi
Barometer
MUTE: P0=0 silent; P0=1 permits PWM. Wi-Fi: P1=0 off; P1=1 on. Read at startup; hold last valid state on read failure.
Buzzer, barometer and physical controls
Physical controls
U13: I2C 0x20, polled; INT unused. Pull-ups retained. P2/P3: GNSS reset/safeboot; drive low or release. J10: GND, RST_1, RST_2, LCD_LED. 3.3 V logic only.
Pull-ups on controls; P2/P3 drive GNSS reset and safeboot
Buzzer
MUTE

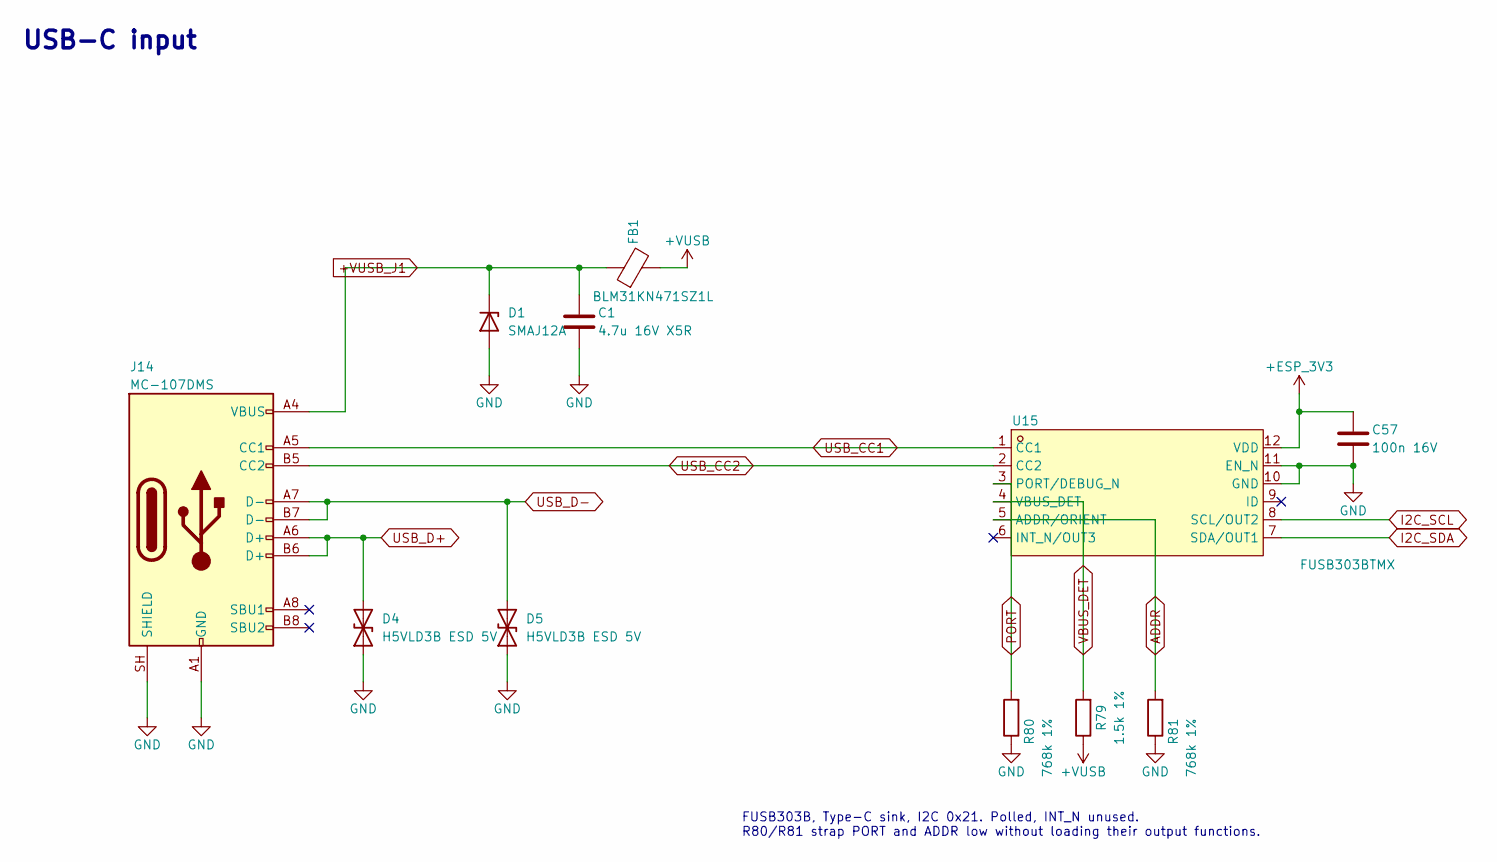
[picture p17: schematic usb_input.kicad_sch, USB input]

Parts:
C1: 4.7u 16V X5R; C_0603_1608Metric; LCSC C19666
C57: 100n 16V; C_0402_1005Metric_NoSilk; MPN CL05B104KO5NNNC; LCSC C1525
D1: SMAJ12A; D_SMA; LCSC C19077531
D4, D5: H5VLD3B ESD 5V; D_SOD-323; MPN H5VLD3B; LCSC C20615805
FB1: BLM31KN471SZ1L; L_1206_3216Metric; LCSC C710518
J14: MC-107DMS; USB_C_Receptacle_Hanbo_MC-107DMS; LCSC C3039295
R79: 1.5k 1%; R_0402_1005Metric_NoSilk; MPN 0402WGF1501TCE; LCSC C25867
R80, R81: 768k 1%; R_0402_1005Metric_NoSilk; MPN FRC0402F7683TS; LCSC C49196905
U15: FUSB303BTMX; X2QFN-12_L1.6-W1.6-P0.40-TL; LCSC C895444

Connections:
+ESP_3V3: C57.1, U15.12 (VDD); also elsewhere on the board
+VUSB: FB1.2, R79.1; also elsewhere on the board
+VUSB_J1: C1.1, D1.1 (K), FB1.1, J14.A4 (VBUS), J14.A9 (VBUS), J14.B4 (VBUS), J14.B9 (VBUS)
ADDR: R81.2, U15.5 (ADDR/ORIENT)
GND: C1.2, C57.2, D1.2 (A), D4.1 (A1), D5.1 (A1), J14.A1 (GND), J14.A12 (GND), J14.B1 (GND), J14.B12 (GND), J14.SH (SHIELD), R80.1, R81.1, U15.10 (GND), U15.11 (EN_N); also elsewhere on the board
I2C_SCL: U15.8 (SCL/OUT2); also elsewhere on the board
I2C_SDA: U15.7 (SDA/OUT1); also elsewhere on the board
PORT: R80.2, U15.3 (PORT/DEBUG_N)
USB_CC1: J14.A5 (CC1), U15.1 (CC1)
USB_CC2: J14.B5 (CC2), U15.2 (CC2)
USB_D+: D4.2 (A2), J14.A6 (D+), J14.B6 (D+); also elsewhere on the board
USB_D-: D5.2 (A2), J14.A7 (D-), J14.B7 (D-); also elsewhere on the board
VBUS_DET: R79.2, U15.4 (VBUS_DET)

Notes on the sheet:
USB-C input
FUSB303B, Type-C sink, I2C 0x21. Polled, INT_N unused. R80/R81 strap PORT and ADDR low without loading their output functions.

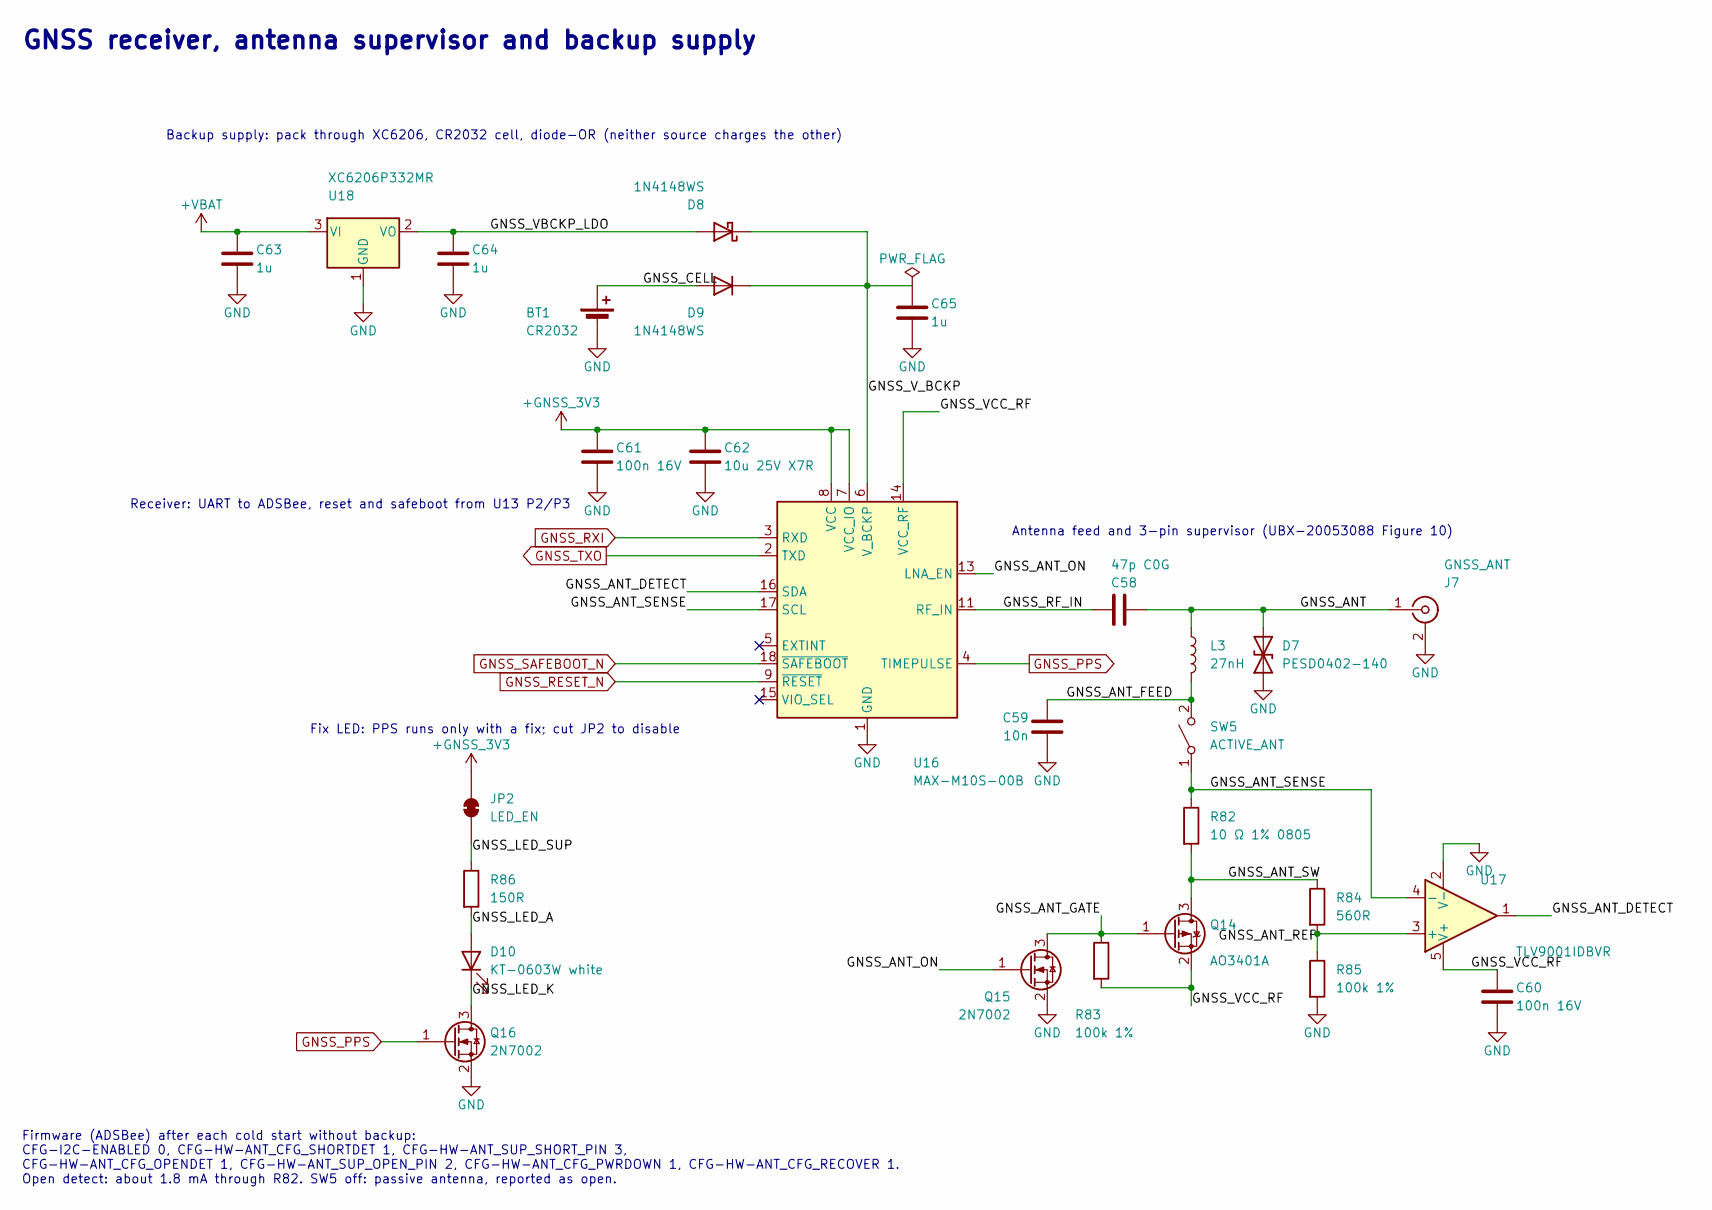
[picture p18: schematic gnss.kicad_sch]

Parts:
BT1: CR2032; BAT-SMD_BS-CR2032-8; MPN BS-CR2032-8; LCSC C7498149
C58: 47p C0G; C_0402_1005Metric_NoSilk; MPN 0402CG470J500NT; LCSC C1567
C59: 10n; C_0603_1608Metric; LCSC C57112
C60, C61: 100n 16V; C_0402_1005Metric_NoSilk; MPN CL05B104KO5NNNC; LCSC C1525
C62: 10u 25V X7R; C_0805_2012Metric; MPN CL21B106KAYQNNE; LCSC C3039694
C63, C64, C65: 1u; C_0603_1608Metric; MPN CL10A105KB8NNNC; LCSC C15849
D7: PESD0402-140; D_0402_1005Metric; MPN PESD0402-140; LCSC C10662
D8, D9: 1N4148WS; D_SOD-323; MPN 1N4148WS; LCSC C2128
D10: KT-0603W white; LED_0603_1608Metric; MPN KT-0603W; LCSC C2290
J7: GNSS_ANT; U.FL_Hirose_U.FL-R-SMT-1_Vertical; MPN U.FL-R-SMT-1(80); LCSC C88374
JP2: LED_EN; SolderJumper-2_P1.3mm_Bridged_RoundedPad1.0x1.5mm
L3: 27nH; L_0402_1005Metric; MPN LQG15HS27NJ02D; LCSC C12669
Q14: AO3401A; SOT-23; MPN AO3401A; LCSC C15127
Q15, Q16: 2N7002; SOT-23; MPN 2N7002; LCSC C8545
R82: 10 Ω 1% 0805; R_0805_2012Metric_NoSilk; LCSC C17415
R83, R85: 100k 1%; R_0603_1608Metric; LCSC C25803
R84: 560R; R_0603_1608Metric; MPN 0603WAF5600T5E; LCSC C23204
R86: 150R; R_0603_1608Metric; LCSC C22808
SW5: ACTIVE_ANT; SW-SMD_SHOUHAN_2.54-1P_TPGT; MPN 2.54-1P TPGT; LCSC C7421519
U16: MAX-M10S-00B; ublox_MAX-M10S; MPN MAX-M10S-00B; LCSC C4153167
U17: TLV9001IDBVR; SOT-23-5; MPN TLV9001IDBVR; LCSC C398363
U18: XC6206P332MR; SOT-23; MPN XC6206P332MR; LCSC C5446

Connections:
+GNSS_3V3: C61.1, C62.1, JP2.2 (B), U16.7 (VCC_IO), U16.8 (VCC); also elsewhere on the board
+VBAT: C63.1, U18.3 (VI); also elsewhere on the board
/GNSS/GNSS_ANT: C58.2, D7.2 (A2), J7.1 (In), L3.1
/GNSS/GNSS_ANT_DETECT: U16.16 (SDA), U17.1
/GNSS/GNSS_ANT_FEED: C59.1, L3.2, SW5.2 (B)
/GNSS/GNSS_ANT_GATE: Q14.1 (G), Q15.3 (D), R83.1
/GNSS/GNSS_ANT_ON: Q15.1 (G), U16.13 (LNA_EN)
/GNSS/GNSS_ANT_REF: R84.2, R85.1, U17.3 (+)
/GNSS/GNSS_ANT_SENSE: R82.1, SW5.1 (A), U16.17 (SCL), U17.4 (-)
/GNSS/GNSS_ANT_SW: Q14.3 (D), R82.2, R84.1
/GNSS/GNSS_CELL: BT1.1 (+), D9.2 (A)
/GNSS/GNSS_LED_A: D10.2 (A), R86.2
/GNSS/GNSS_LED_K: D10.1 (K), Q16.3 (D)
/GNSS/GNSS_LED_SUP: JP2.1 (A), R86.1
/GNSS/GNSS_RF_IN: C58.1, U16.11 (RF_IN)
/GNSS/GNSS_VBCKP_LDO: C64.1, D8.2 (A), U18.2 (VO)
/GNSS/GNSS_VCC_RF: C60.1, Q14.2 (S), R83.2, U16.14 (VCC_RF), U17.5 (V+)
/GNSS/GNSS_V_BCKP: C65.1, D8.1 (K), D9.1 (K), U16.6 (V_BCKP)
GND: BT1.2 (-), C59.2, C60.2, C61.2, C62.2, C63.2, C64.2, C65.2, D7.1 (A1), J7.2 (Ext), Q15.2 (S), Q16.2 (S), R85.2, U16.1 (GND), U16.10 (GND), U16.12 (GND), U17.2 (V-), U18.1 (GND); also elsewhere on the board
GNSS_PPS: Q16.1 (G), U16.4 (TIMEPULSE); also elsewhere on the board
GNSS_RESET_N: U16.9 (~RESET); also elsewhere on the board
GNSS_RXI: U16.3 (RXD); also elsewhere on the board
GNSS_SAFEBOOT_N: U16.18 (~SAFEBOOT); also elsewhere on the board
GNSS_TXO: U16.2 (TXD); also elsewhere on the board

Notes on the sheet:
Antenna feed and 3-pin supervisor (UBX-20053088 Figure 10)
Backup supply: pack through XC6206, CR2032 cell, diode-OR (neither source charges the other)
GNSS receiver, antenna supervisor and backup supply
Fix LED: PPS runs only with a fix; cut JP2 to disable
Firmware (ADSBee) after each cold start without backup: CFG-I2C-ENABLED 0, CFG-HW-ANT_CFG_SHORTDET 1, CFG-HW-ANT_SUP_SHORT_PIN 3, CFG-HW-ANT_CFG_OPENDET 1, CFG-HW-ANT_SUP_OPEN_PIN 2, CFG-HW-ANT_CFG_PWRDOWN 1, CFG-HW-ANT_CFG_RECOVER 1. Open detect: about 1.8 mA through R82. SW5 off: passive antenna,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
Receiver: UART to ADSBee, reset and safeboot from U13 P2/P3
