mp911de/airgrep/hardware/carrier-ti-charger/carrier.kicad_pcb

## KiCad design hardware/carrier-ti-charger/carrier.kicad_pcb (continued)

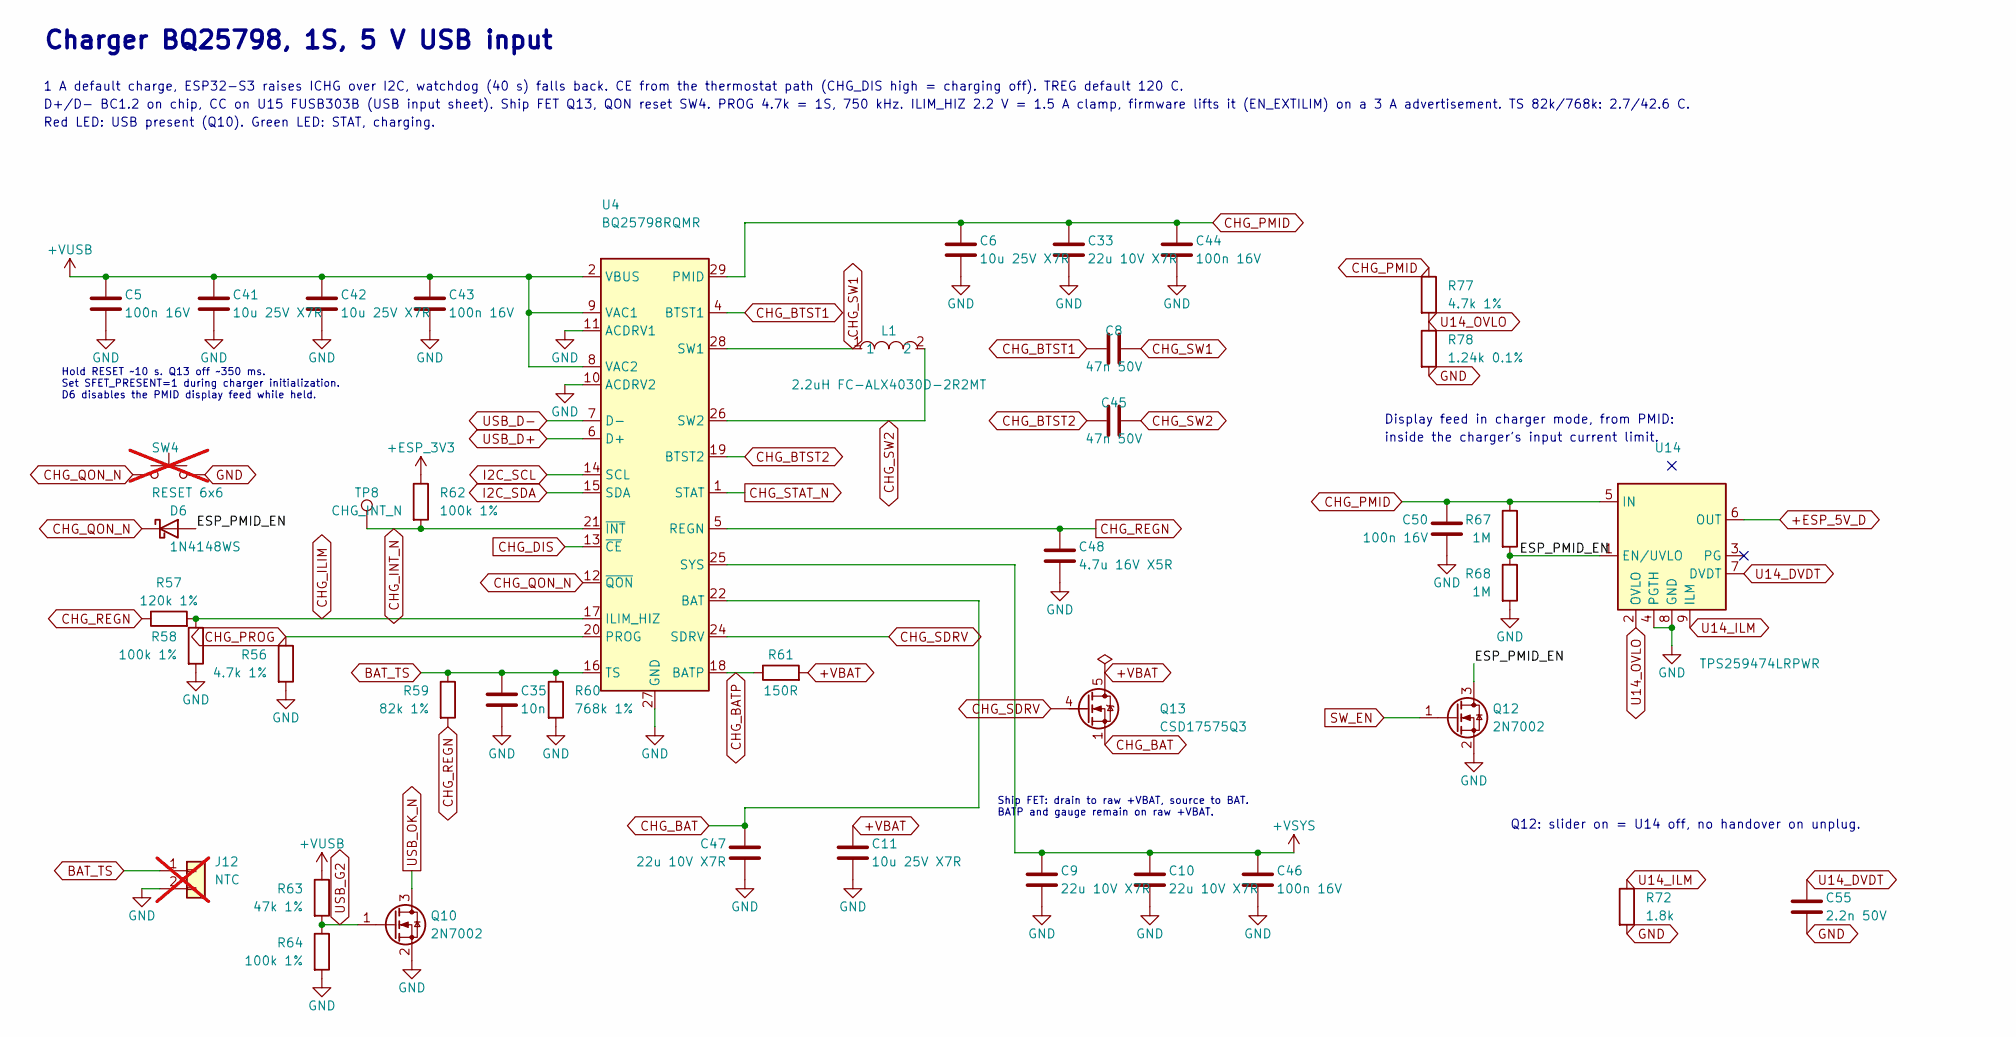
[picture p19: schematic charger.kicad_sch, Charger BQ25798]

Parts:
C5, C43, C44, C46, C50: 100n 16V; C_0402_1005Metric_NoSilk; MPN CL05B104KO5NNNC; LCSC C1525
C6, C11, C41, C42: 10u 25V X7R; C_0805_2012Metric; LCSC C3039694
C8, C45: 47n 50V; C_0603_1608Metric; LCSC C1622
C9, C10, C33, C47: 22u 10V X7R; C_0805_2012Metric; LCSC C907991
C35: 10n; C_0603_1608Metric; LCSC C57112
C48: 4.7u 16V X5R; C_0603_1608Metric; LCSC C19666
C55: 2.2n 50V; C_0603_1608Metric; MPN 0603B222K500NT; LCSC C1604
D6: 1N4148WS; D_SOD-323; MPN 1N4148WS; LCSC C2128
J12: NTC; JST_PH_B2B-PH-K_1x02_P2.00mm_Vertical_R10; not fitted
L1: 2.2uH FC-ALX4030D-2R2MT; IND-SMD_L4.2-W4.2_FC-ALX4030D; LCSC C5370906
Q10, Q12: 2N7002; SOT-23; LCSC C8545
Q13: CSD17575Q3; VSON-8_3.3x3.3mm_CSD17575Q3; LCSC C529277
R56: 4.7k 1%; R_0402_1005Metric_NoSilk; MPN 0402WGF4701TCE; LCSC C25900
R57: 120k 1%; R_0603_1608Metric; LCSC C25808
R58, R62, R64: 100k 1%; R_0603_1608Metric; LCSC C25803
R59: 82k 1%; R_0603_1608Metric; Tolerance 1%; MPN 0603WAF8202T5E; LCSC C23254
R60: 768k 1%; R_0402_1005Metric_NoSilk; MPN FRC0402F7683TS; LCSC C49196905
R61: 150R; R_0603_1608Metric; LCSC C22808
R63: 47k 1%; R_0603_1608Metric; LCSC C25819
R67, R68: 1M; R_0603_1608Metric; LCSC C22935
R72: 1.8k; R_0603_1608Metric; Tolerance 1%; MPN 0603WAF1801T5E; LCSC C4177
R77: 4.7k 1%; R_0402_1005Metric_NoSilk; Tolerance 1%; MPN 0402WGF4701TCE; LCSC C25900
R78: 1.24k 0.1%; R_0402_1005Metric_NoSilk; Tolerance 0.1%; MPN ARG02BTC1241; LCSC C2984409
SW4: RESET 6x6; SW_PUSH_6mm; not fitted
TP8: CHG_INT_N; TestPoint_Pad_D1.5mm
U4: BQ25798RQMR; Texas_RQM0029A_VQFN-29_4x4mm_P0.4mm; LCSC C2876593
U14: TPS259474LRPWR; VQFN-10_L2.0-W2.0-P0.45-HR_LM73100; LCSC C2864845

Connections:
+ESP_3V3: R62.1; also elsewhere on the board
+ESP_5V_D: U14.6 (OUT); also elsewhere on the board
+VBAT: C11.1, Q13.5 (D), R61.2; also elsewhere on the board
+VSYS: C9.1, C10.1, C46.1, U4.25 (SYS); also elsewhere on the board
+VUSB: C5.1, C41.1, C42.1, C43.1, R63.1, U4.2 (VBUS), U4.3 (VBUS), U4.8 (VAC2), U4.9 (VAC1); also elsewhere on the board
/Charger BQ25798/ESP_PMID_EN: D6.2 (A), Q12.3 (D), R67.2, R68.1, U14.1 (EN/UVLO)
BAT_TS: C35.1, J12.1, R59.1, R60.1, U4.16 (TS)
CHG_BAT: C47.1, Q13.1 (S), Q13.2 (S), Q13.3 (S), U4.22 (BAT), U4.23 (BAT)
CHG_BATP: R61.1, U4.18 (BATP)
CHG_BTST1: C8.1, U4.4 (BTST1)
CHG_BTST2: C45.1, U4.19 (BTST2)
CHG_DIS: U4.13 (~CE); also elsewhere on the board
CHG_ILIM: R57.2, R58.1, U4.17 (ILIM_HIZ)
CHG_INT_N: R62.2, TP8.1 (1_1), U4.21 (~INT)
CHG_PMID: C6.1, C33.1, C44.1, C50.1, R67.1, R77.1, U4.29 (PMID), U14.5 (IN)
CHG_PROG: R56.1, U4.20 (PROG)
CHG_QON_N: D6.1 (K), SW4.1, U4.12 (~QON)
CHG_REGN: C48.1, R57.1, R59.2, U4.5 (REGN)
CHG_SDRV: Q13.4 (G), U4.24 (SDRV)
CHG_STAT_N: U4.1 (STAT); also elsewhere on the board
CHG_SW1: C8.2, L1.1, U4.28 (SW1)
CHG_SW2: C45.2, L1.2, U4.26 (SW2)
GND: C5.2, C6.2, C9.2, C10.2, C11.2, C33.2, C35.2, C41.2, C42.2, C43.2, C44.2, C46.2, C47.2, C48.2, C50.2, C55.2, J12.2, Q10.2 (S), Q12.2 (S), R56.2, R58.2, R60.2, R64.2, R68.2, R72.2, R78.2, SW4.2, U4.10 (ACDRV2), U4.11 (ACDRV1), U4.27 (GND), U14.4 (PGTH), U14.8 (GND); also elsewhere on the board
I2C_SCL: U4.14 (SCL); also elsewhere on the board
I2C_SDA: U4.15 (SDA); also elsewhere on the board
SW_EN: Q12.1 (G); also elsewhere on the board
U14_DVDT: C55.1, U14.7 (DVDT)
U14_ILM: R72.1, U14.9 (ILM)
U14_OVLO: R77.2, R78.1, U14.2 (OVLO)
USB_D+: U4.6 (D+); also elsewhere on the board
USB_D-: U4.7 (D-); also elsewhere on the board
USB_G2: Q10.1 (G), R63.2, R64.1
USB_OK_N: Q10.3 (D); also elsewhere on the board

Notes on the sheet:
Hold RESET ~10 s. Q13 off ~350 ms. Set SFET_PRESENT=1 during charger initialization. D6 disables the PMID display feed while held.
Ship FET: drain to raw +VBAT, source to BAT. BATP and gauge remain on raw +VBAT.
Display feed in charger mode, from PMID:
1 A default charge, ESP32-S3 raises ICHG over I2C, watchdog (40 s) falls back. CE from the thermostat path (CHG_DIS high = charging off). TREG default 120 C.
inside the charger's input current limit.
Charger BQ25798, 1S, 5 V USB input
D+/D- BC1.2 on chip, CC on U15 FUSB303B (USB input sheet). Ship FET Q13, QON reset SW4. PROG 4.7k = 1S, 750 kHz. ILIM_HIZ 2.2 V = 1.5 A clamp, firmware lifts it (EN_EXTILIM) on a 3 A advertisement. TS 82k/768k: 2.7/42.6 C.
Q12: slider on = U14 off, no handover on unplug.
Red LED: USB present (Q10). Green LED: STAT, charging.

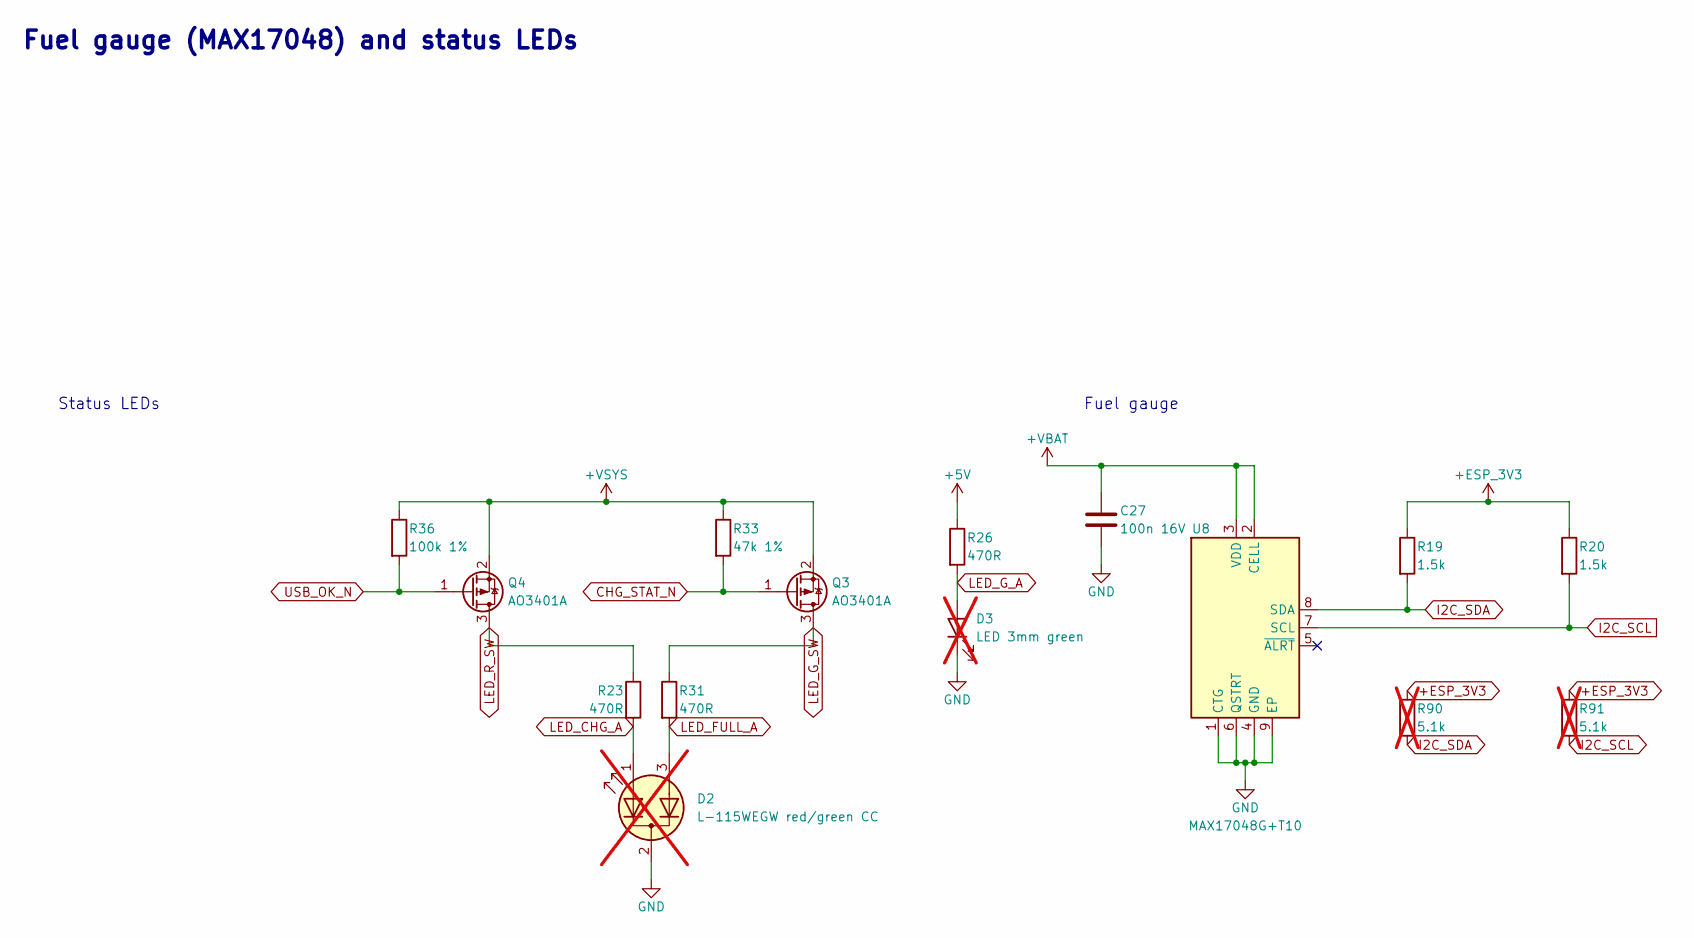
[picture p20: schematic gauge_status.kicad_sch, Gauge and status]

Parts:
C27: 100n 16V; C_0402_1005Metric_NoSilk; MPN CL05B104KO5NNNC; LCSC C1525
D2: L-115WEGW red/green CC; LED_D3.0mm-3; not fitted
D3: LED 3mm green; LED_D3.0mm; not fitted
Q3, Q4: AO3401A; SOT-23; LCSC C15127
R19, R20: 1.5k; R_0603_1608Metric; Tolerance 1%; MPN 0603WAF1501T5E; LCSC C22843
R23, R26, R31: 470R; R_0603_1608Metric; LCSC C23179
R33: 47k 1%; R_0603_1608Metric; LCSC C25819
R36: 100k 1%; R_0603_1608Metric; LCSC C25803
R90, R91: 5.1k; R_0805_2012Metric_Pad1.20x1.40mm_HandSolder; not fitted
U8: MAX17048G+T10; TDFN-8_L2.0-W2.0-P0.50-EP0.8x1.38_T822; LCSC C2682616

Connections:
+5V: R26.1; also elsewhere on the board
+ESP_3V3: R19.1, R20.1, R90.1, R91.1; also elsewhere on the board
+VBAT: C27.1, U8.2 (CELL), U8.3 (VDD); also elsewhere on the board
+VSYS: Q3.2 (S), Q4.2 (S), R33.1, R36.1; also elsewhere on the board
CHG_STAT_N: Q3.1 (G), R33.2; also elsewhere on the board
GND: C27.2, D2.2 (K), D3.1 (K), U8.1 (CTG), U8.4 (GND), U8.6 (QSTRT), U8.9 (EP); also elsewhere on the board
I2C_SCL: R20.2, R91.2, U8.7 (SCL); also elsewhere on the board
I2C_SDA: R19.2, R90.2, U8.8 (SDA); also elsewhere on the board
LED_CHG_A: D2.1 (A1), R23.2
LED_FULL_A: D2.3 (A2), R31.2
LED_G_A: D3.2 (A), R26.2
LED_G_SW: Q3.3 (D), R31.1
LED_R_SW: Q4.3 (D), R23.1
USB_OK_N: Q4.1 (G), R36.2; also elsewhere on the board

Notes on the sheet:
Fuel gauge
Status LEDs
Fuel gauge (MAX17048) and status LEDs

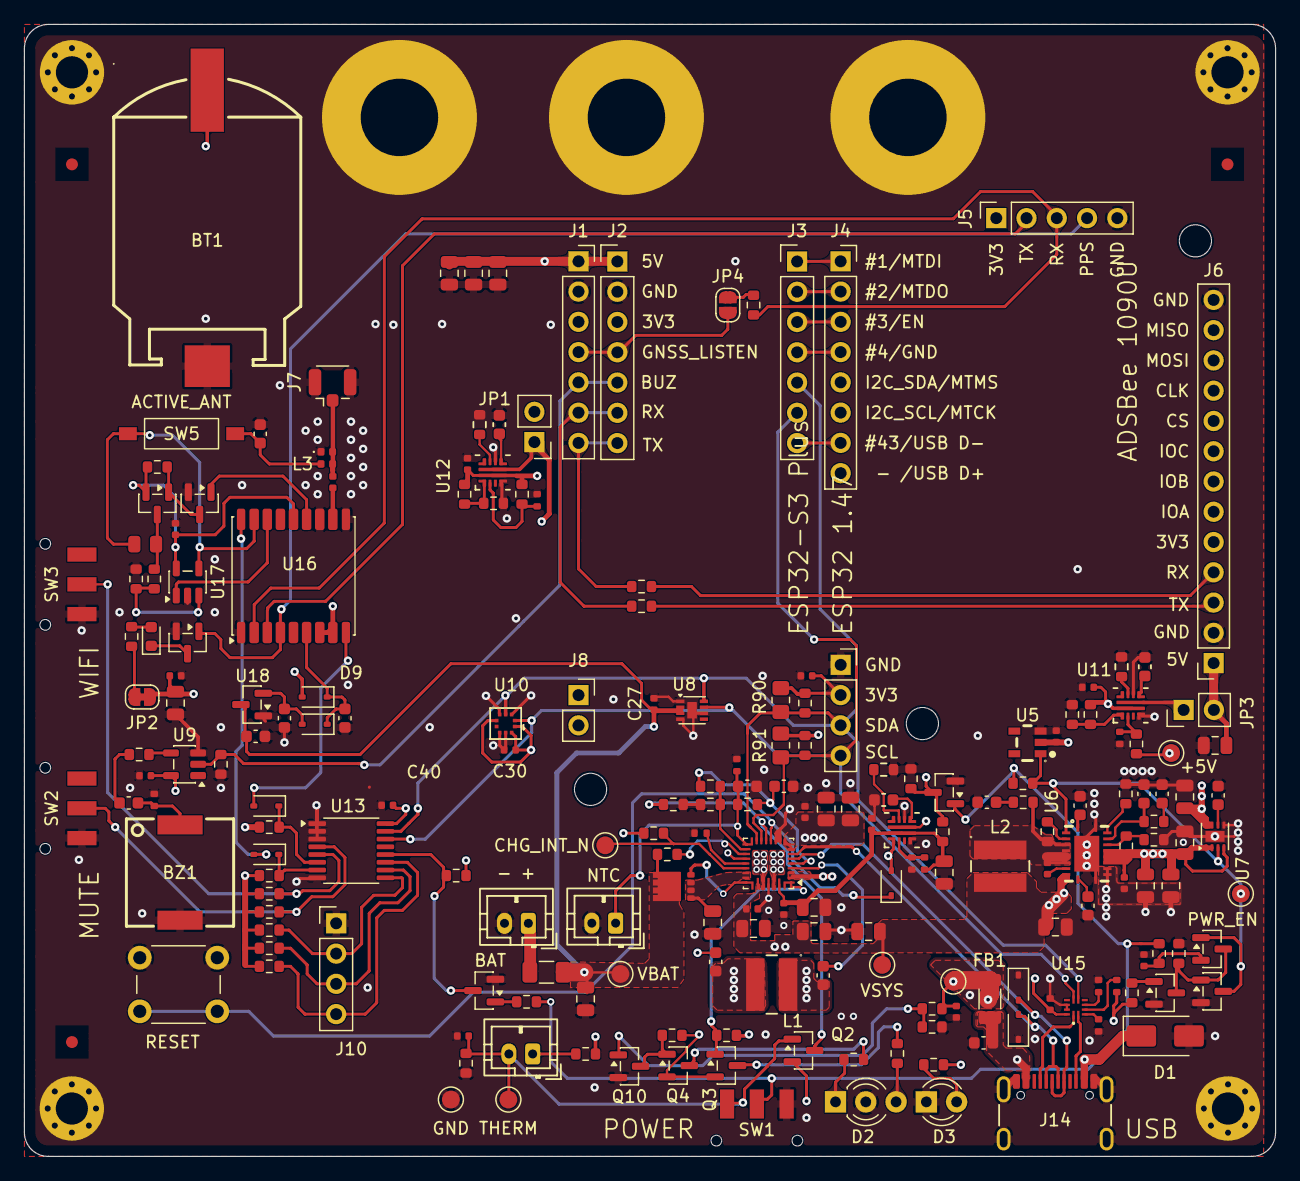
[picture p21: board hardware/carrier-ti-charger/carrier.kicad_pcb from above]

Board: 4 copper layers, 105.0 x 95.0 mm, 219 parts (0 on the bottom side), 121 nets.

Other parts of the board:
FID1, FID2, FID3: Fiducial; Fiducial_1mm_Mask2mm
MH1, MH2, MH3, MH4: MountingHole_2.7mm_M2.5_Pad_Via
MH6ANTGNSS, MH7ADS1090, MH8ADS980: MountingHole_6.5mm_Pad
MH12, MH13, MH14: MountingHole_2.7mm_M2.5

Their connections:
GND: MH1.1, MH2.1, MH3.1, MH4.1, MH6ANTGNSS.1, MH7ADS1090.1, MH8ADS980.1; also elsewhere on the board
