mp911de/airgrep/hardware/carrier-max-charger/carrier.kicad_pcb

## KiCad design hardware/carrier-max-charger/carrier.kicad_pcb (2026-10-11, an earlier design)

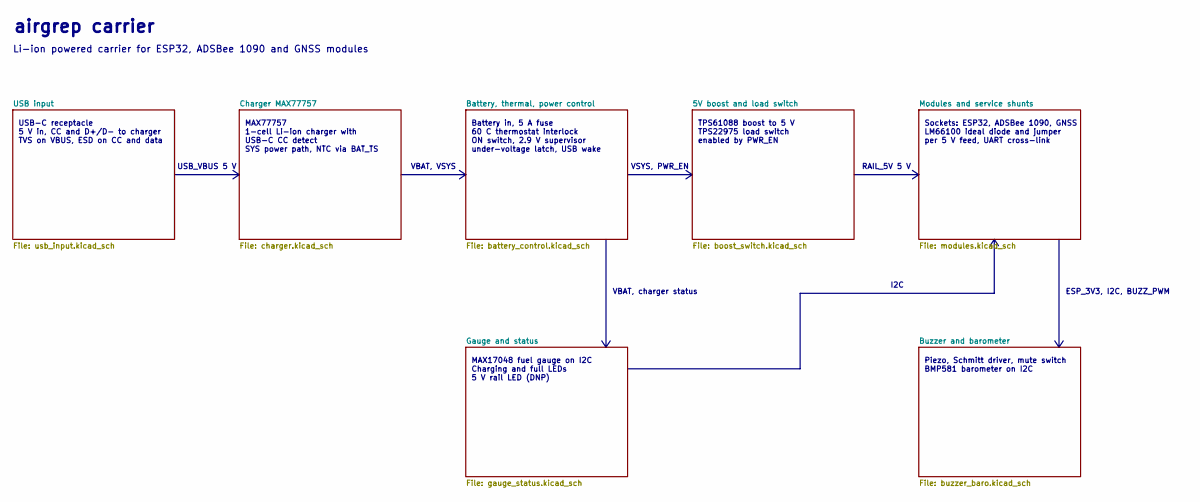
[picture p22: schematic carrier.kicad_sch, airgrep carrier]

Notes on the sheet:
I2C
TPS61088 boost to 5 V TPS22975 load switch enabled by PWR_EN
Piezo, Schmitt driver, mute switch BMP581 barometer on I2C
MAX77757 1-cell Li-ion charger with USB-C CC detect SYS power path, NTC via BAT_TS
airgrep carrier
VBAT, VSYS
ESP_3V3, I2C, BUZZ_PWM
VBAT, charger status
Sockets: ESP32, ADSBee 1090, GNSS LM66100 ideal diode and jumper per 5 V feed, UART cross-link
Battery in, 5 A fuse 60 C thermostat interlock ON switch, 2.9 V supervisor under-voltage latch, USB wake
USB_VBUS 5 V
RAIL_5V 5 V
USB-C receptacle 5 V in, CC and D+/D- to charger TVS on VBUS, ESD on CC and data
MAX17048 fuel gauge on I2C Charging and full LEDs 5 V rail LED (DNP)
VSYS, PWR_EN
Li-ion powered carrier for ESP32, ADSBee 1090 and GNSS modules

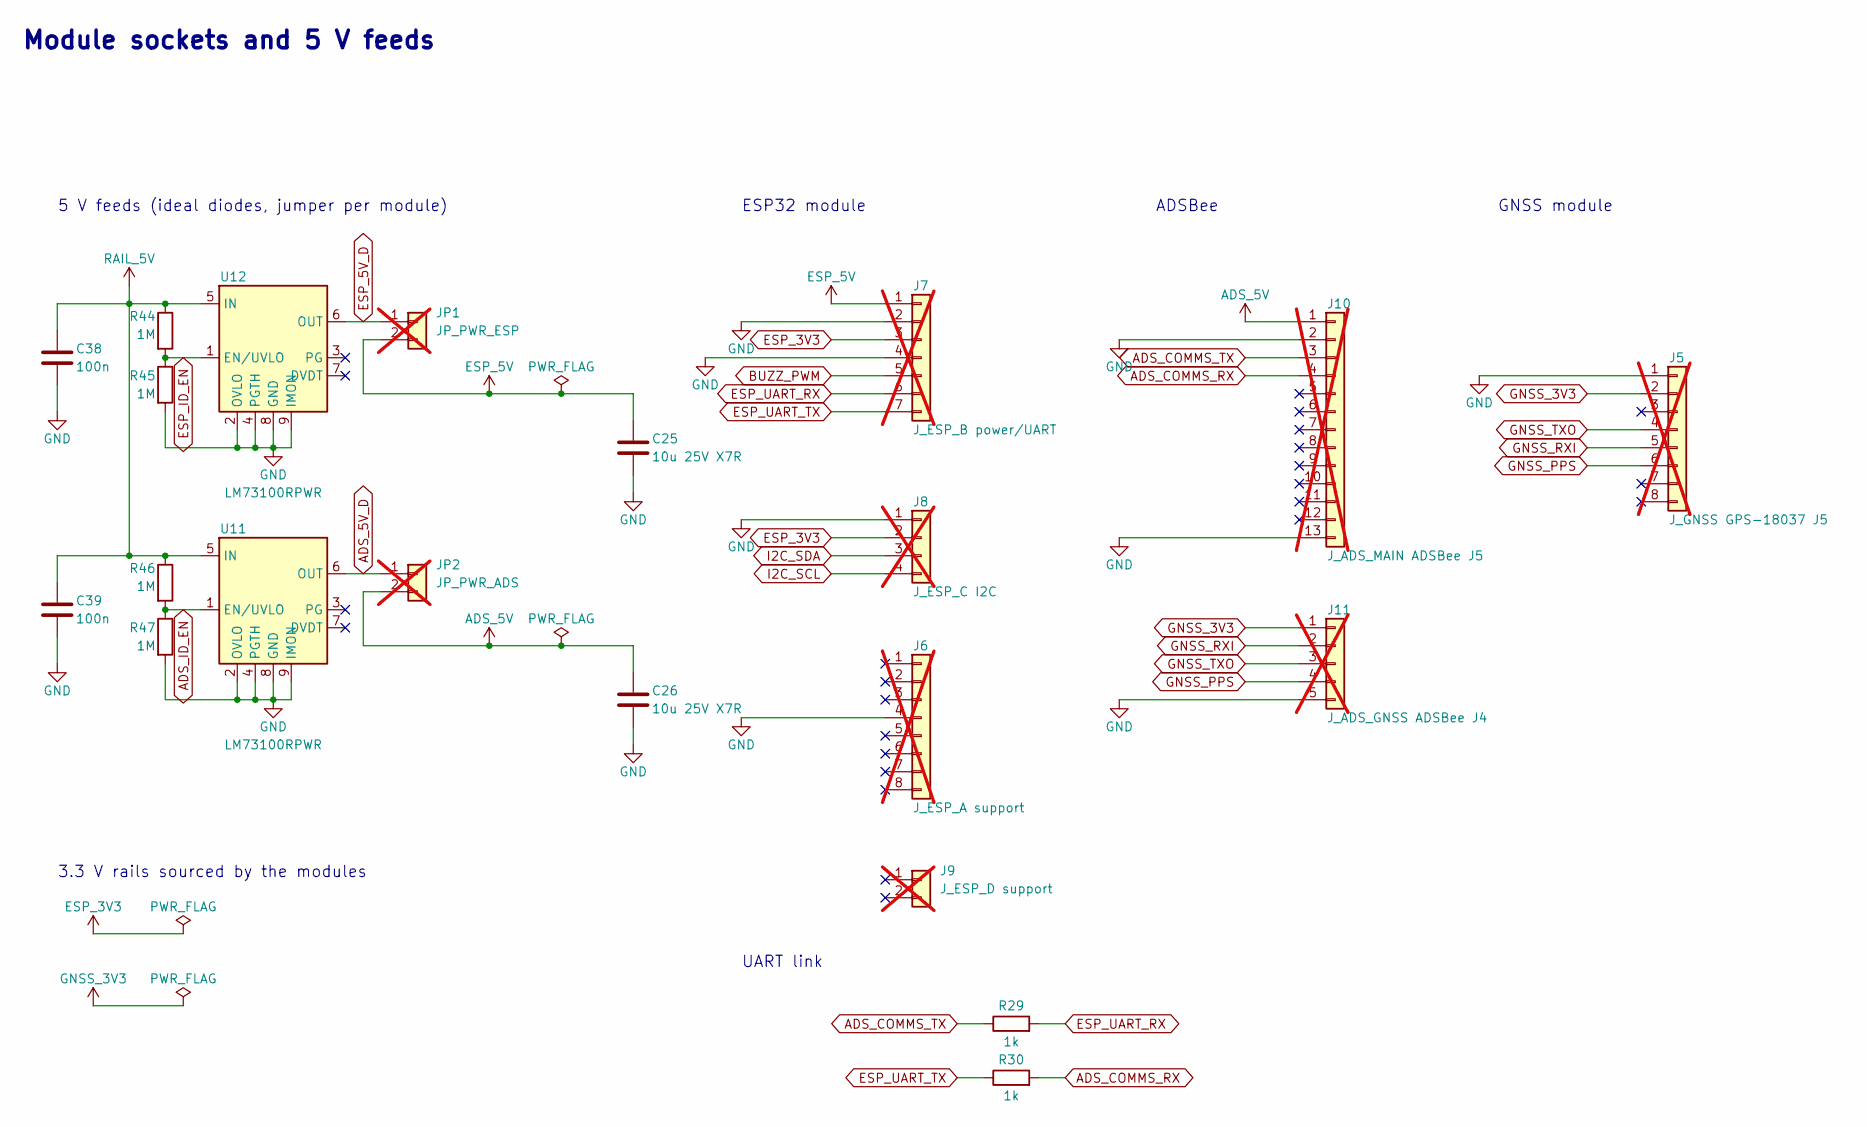
[picture p23: schematic modules.kicad_sch, Modules and service shunts]

Parts:
C25, C26: 10u 25V X7R; C_0805_2012Metric; LCSC C3039694
C38, C39: 100n; C_0603_1608Metric; LCSC C14663
J5: J_GNSS GPS-18037 J5; PinSocket_1x08_P2.54mm_Vertical; not fitted
J6: J_ESP_A support; PinSocket_1x08_P2.54mm_Vertical; not fitted
J7: J_ESP_B power/UART; PinSocket_1x07_P2.54mm_Vertical; not fitted
J8: J_ESP_C I2C; PinSocket_1x04_P2.54mm_Vertical; not fitted
J9: J_ESP_D support; PinSocket_1x02_P2.54mm_Vertical; not fitted
J10: J_ADS_MAIN ADSBee J5; PinSocket_1x13_P2.54mm_Vertical; not fitted
J11: J_ADS_GNSS ADSBee J4; PinSocket_1x05_P2.54mm_Vertical; not fitted
JP1: JP_PWR_ESP; PinHeader_1x02_P2.54mm_Vertical; not fitted
JP2: JP_PWR_ADS; PinHeader_1x02_P2.54mm_Vertical; not fitted
R29, R30: 1k; R_0603_1608Metric; LCSC C21190
R44, R45, R46, R47: 1M; R_0603_1608Metric; LCSC C22935
U11, U12: LM73100RPWR; VQFN-10_L2.0-W2.0-P0.45-HR_LM73100; LCSC C3210761

Connections:
ADS_5V: C26.1, J10.1, JP2.2
ADS_5V_D: JP2.1, U11.6 (OUT)
ADS_COMMS_RX: J10.4, R30.2
ADS_COMMS_TX: J10.3, R29.1
ADS_ID_EN: R46.2, R47.1, U11.1 (EN/UVLO)
BUZZ_PWM: J7.5; also elsewhere on the board
ESP_3V3: J7.3, J8.2; also elsewhere on the board
ESP_5V: C25.1, J7.1, JP1.2
ESP_5V_D: JP1.1, U12.6 (OUT)
ESP_ID_EN: R44.2, R45.1, U12.1 (EN/UVLO)
ESP_UART_RX: J7.6, R29.2
ESP_UART_TX: J7.7, R30.1
GND: C25.2, C26.2, C38.2, C39.2, J5.1, J6.4 (Pin_4_4), J7.2, J7.4, J8.1, J10.2, J10.13, J11.5, R45.2, R47.2, U11.2 (OVLO), U11.4 (PGTH), U11.8 (GND), U11.9 (IMON), U12.2 (OVLO), U12.4 (PGTH), U12.8 (GND), U12.9 (IMON); also elsewhere on the board
GNSS_3V3: J5.2, J11.1
GNSS_PPS: J5.6, J11.4
GNSS_RXI: J5.5, J11.2
GNSS_TXO: J5.4, J11.3
I2C_SCL: J8.4; also elsewhere on the board
I2C_SDA: J8.3; also elsewhere on the board
RAIL_5V: C38.1, C39.1, R44.1, R46.1, U11.5 (IN), U12.5 (IN); also elsewhere on the board

Notes on the sheet:
Module sockets and 5 V feeds
UART link
ADSBee
GNSS module
3.3 V rails sourced by the modules
5 V feeds (ideal diodes, jumper per module)
ESP32 module

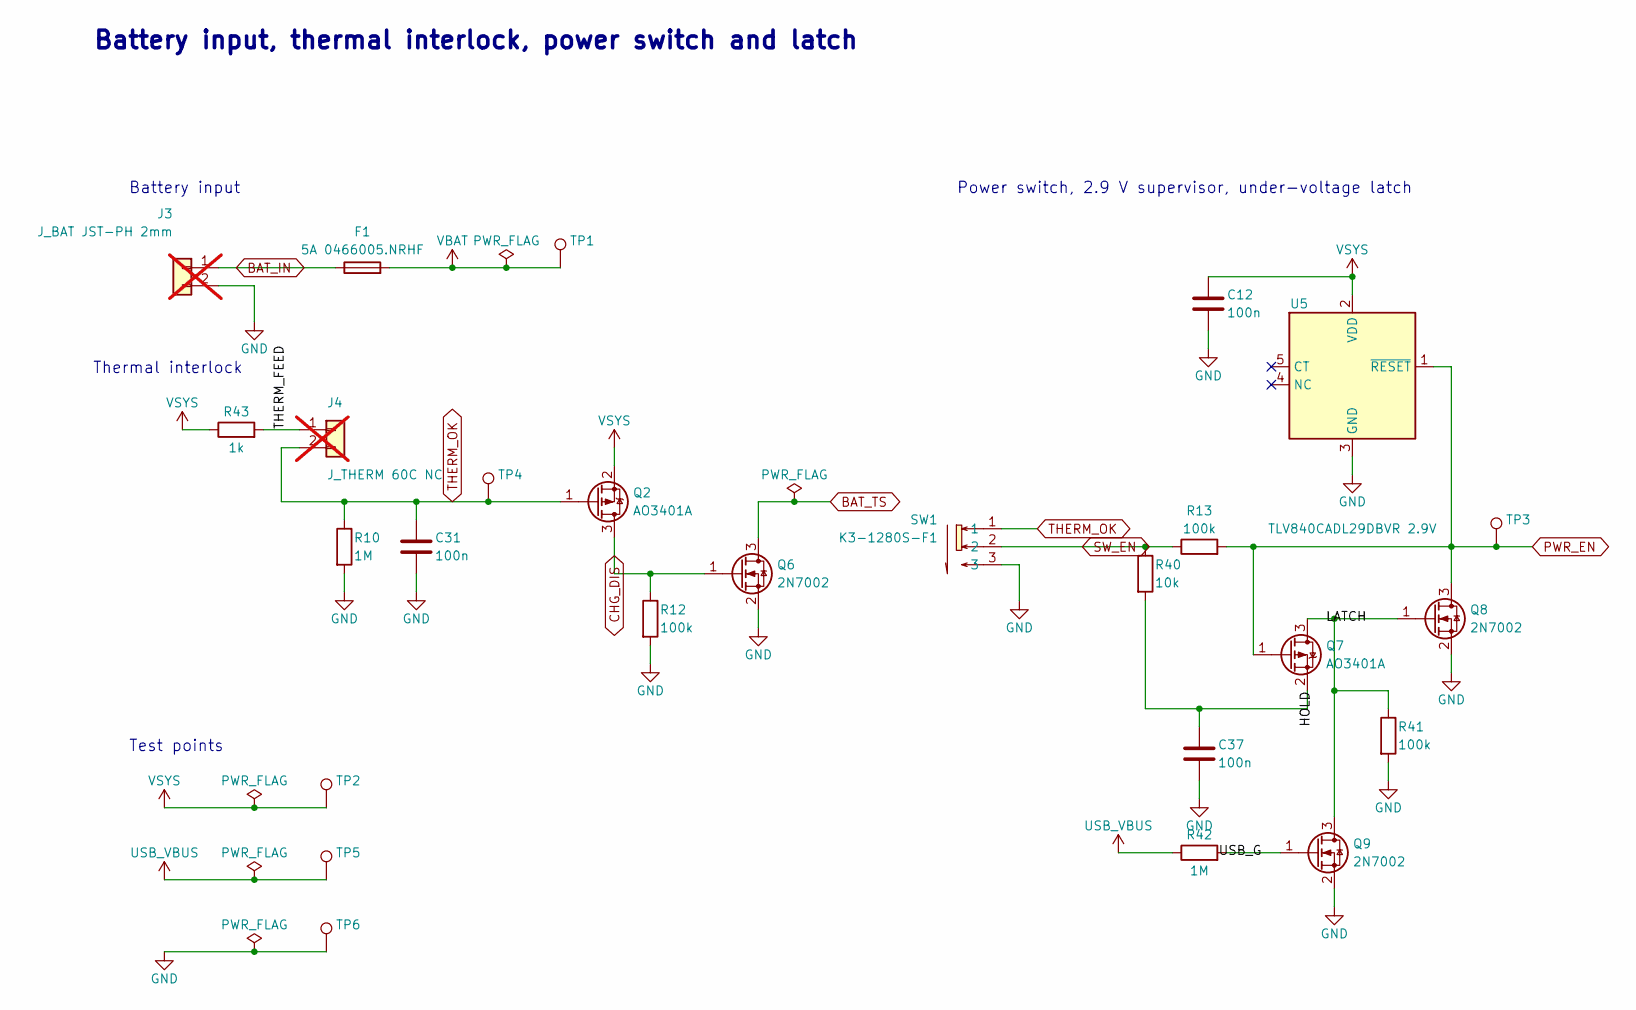
[picture p24: schematic battery_control.kicad_sch, Battery, thermal, power control]

Parts:
C12, C31, C37: 100n; C_0603_1608Metric; LCSC C14663
F1: 5A 0466005.NRHF; Fuse_1206_3216Metric; LCSC C57525
J3: J_BAT JST-PH 2mm; JST_PH_B2B-PH-K_1x02_P2.00mm_Vertical_R10; not fitted
J4: J_THERM 60C NC; JST_PH_B2B-PH-K_1x02_P2.00mm_Vertical_R10; not fitted
Q2, Q7: AO3401A; SOT-23; LCSC C15127
Q6, Q8, Q9: 2N7002; SOT-23; LCSC C8545
R10, R42: 1M; R_0603_1608Metric; LCSC C22935
R12, R13, R41: 100k; R_0603_1608Metric; LCSC C25803
R40: 10k; R_0603_1608Metric; LCSC C25804
R43: 1k; R_0603_1608Metric; LCSC C21190
SW1: K3-1280S-F1; SW-SMD_K3-1280S-F1; LCSC C92658
TP1: VBAT; TestPoint_Pad_D1.5mm
TP2: VSYS; TestPoint_Pad_D1.5mm
TP3: PWR_EN; TestPoint_Pad_D1.5mm
TP4: THERM_OK; TestPoint_Pad_D1.5mm
TP5: USB_VBUS; TestPoint_Pad_D1.5mm
TP6: GND; TestPoint_Pad_D1.5mm
U5: TLV840CADL29DBVR 2.9V; SOT-23-5_L2.9-W1.6-P0.95-LS2.8-BR; LCSC C3686404

Connections:
/Battery, thermal, power control/HOLD: C37.2, Q7.2 (S), R40.2
/Battery, thermal, power control/LATCH: Q7.3 (D), Q8.1 (G), Q9.3 (D), R41.1
/Battery, thermal, power control/THERM_FEED: J4.1, R43.2
/Battery, thermal, power control/USB_G: Q9.1 (G), R42.2
BAT_IN: F1.1, J3.1
BAT_TS: Q6.3 (D); also elsewhere on the board
CHG_DIS: Q2.3 (D), Q6.1 (G), R12.1
GND: C12.2, C31.2, C37.1, J3.2, Q6.2 (S), Q8.2 (S), Q9.2 (S), R10.2, R12.2, R41.2, SW1.3, TP6.1 (1_1), U5.3 (GND); also elsewhere on the board
PWR_EN: Q7.1 (G), Q8.3 (D), R13.2, TP3.1 (1_1), U5.1 (~RESET); also elsewhere on the board
SW_EN: R13.1, R40.1, SW1.2
THERM_OK: C31.1, J4.2, Q2.1 (G), R10.1, SW1.1, TP4.1 (1_1)
USB_VBUS: R42.1, TP5.1 (1_1); also elsewhere on the board
VBAT: F1.2, TP1.1 (1_1); also elsewhere on the board
VSYS: C12.1, Q2.2 (S), R43.1, TP2.1 (1_1), U5.2 (VDD); also elsewhere on the board

Notes on the sheet:
Battery input
Battery input, thermal interlock, power switch and latch
Power switch, 2.9 V supervisor, under-voltage latch
Test points
Thermal interlock

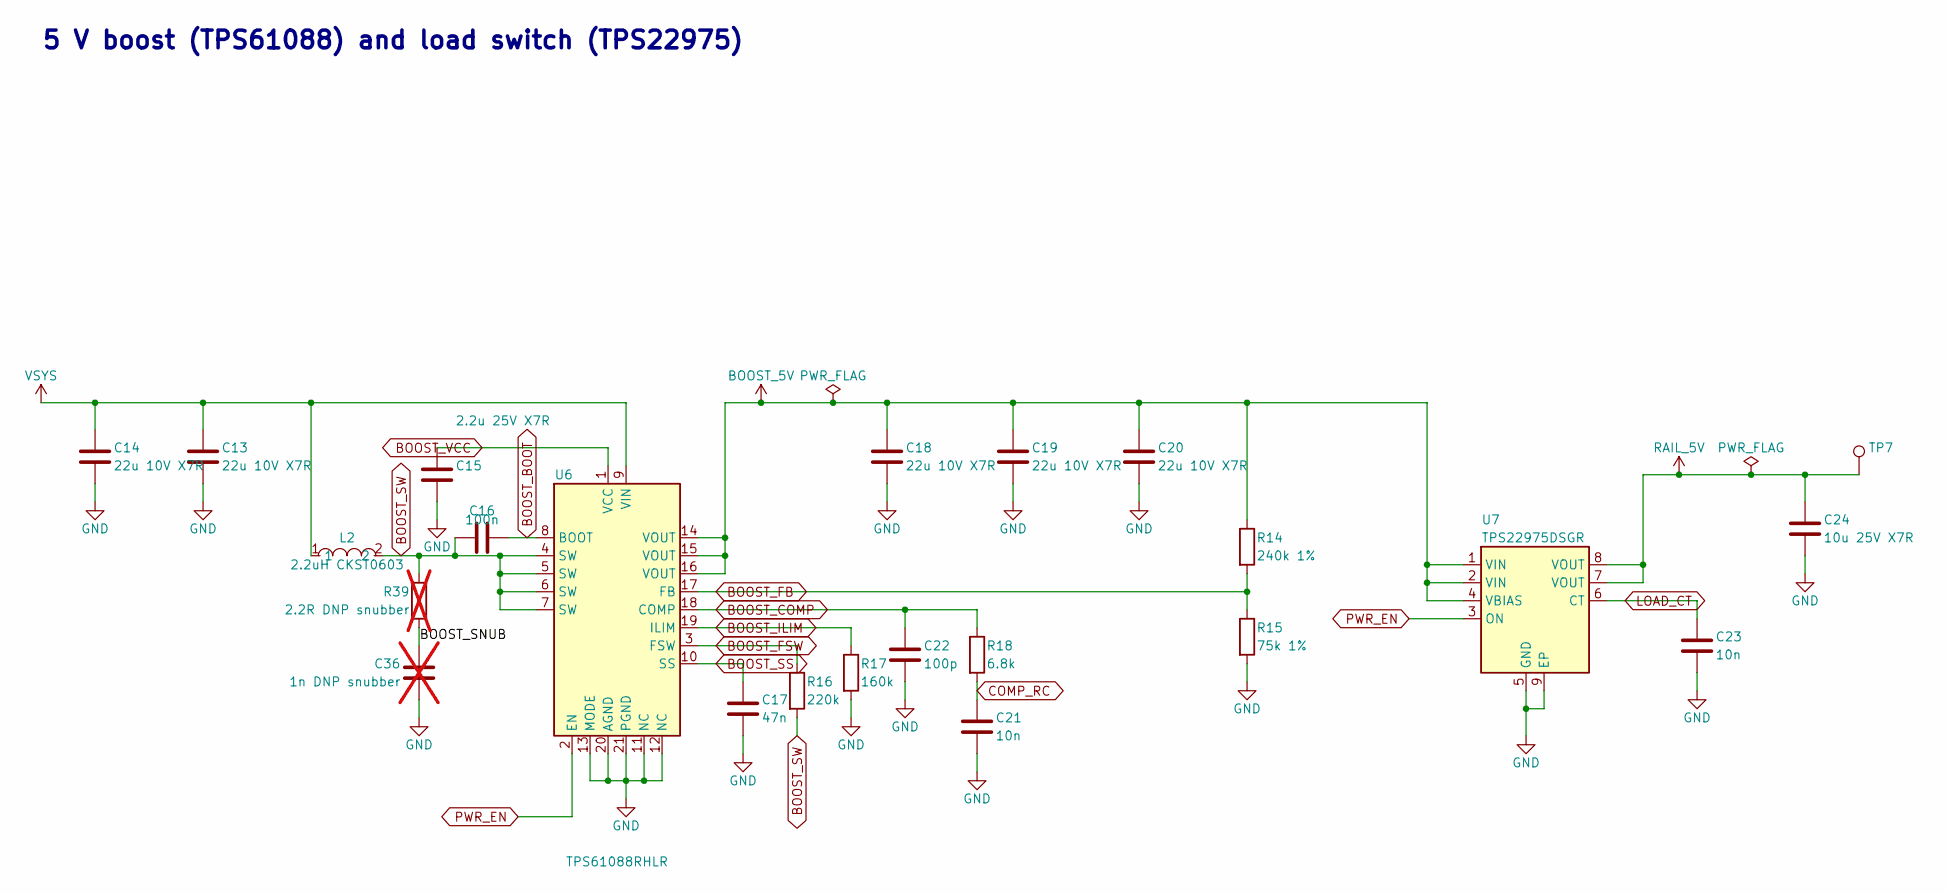
[picture p25: schematic boost_switch.kicad_sch, 5V boost and load switch]

Parts:
C13, C14, C18, C19, C20: 22u 10V X7R; C_0805_2012Metric; LCSC C907991
C15: 2.2u 25V X7R; C_0603_1608Metric; LCSC C415535
C16: 100n; C_0603_1608Metric; LCSC C14663
C17: 47n; C_0603_1608Metric; LCSC C1622
C21, C23: 10n; C_0603_1608Metric; LCSC C57112
C22: 100p; C_0603_1608Metric; LCSC C14858
C24: 10u 25V X7R; C_0805_2012Metric; LCSC C3039694
C36: 1n DNP snubber; C_0603_1608Metric; not fitted
L2: 2.2uH CKST0603; IND-SMD_L7.4-W6.6; LCSC C3002634
R14: 240k 1%; R_0603_1608Metric; LCSC C4197
R15: 75k 1%; R_0603_1608Metric; LCSC C23242
R16: 220k; R_0603_1608Metric; LCSC C22961
R17: 160k; R_0603_1608Metric; LCSC C22813
R18: 6.8k; R_0603_1608Metric; LCSC C23212
R39: 2.2R DNP snubber; R_0603_1608Metric; not fitted
TP7: RAIL_5V; TestPoint_Pad_D1.5mm
U6: TPS61088RHLR; VQFN-20_L4.6-W3.6-P0.50-BL; LCSC C87357
U7: TPS22975DSGR; Texas_DSG0008A_WSON-8-1EP_2x2mm_P0.5mm_EP0.9x1.6mm; LCSC C524777

Connections:
/5V boost and load switch/BOOST_SNUB: C36.1, R39.2
BOOST_5V: C18.1, C19.1, C20.1, R14.1, U6.14 (VOUT), U6.15 (VOUT), U6.16 (VOUT), U7.1 (VIN), U7.2 (VIN), U7.4 (VBIAS)
BOOST_BOOT: C16.1, U6.8 (BOOT)
BOOST_COMP: C22.1, R18.1, U6.18 (COMP)
BOOST_FB: R14.2, R15.1, U6.17 (FB)
BOOST_FSW: R16.1, U6.3 (FSW)
BOOST_ILIM: R17.1, U6.19 (ILIM)
BOOST_SS: C17.1, U6.10 (SS)
BOOST_SW: C16.2, L2.2, R16.2, R39.1, U6.4 (SW), U6.5 (SW), U6.6 (SW), U6.7 (SW)
BOOST_VCC: C15.1, U6.1 (VCC)
COMP_RC: C21.1, R18.2
GND: C13.2, C14.2, C15.2, C17.2, C18.2, C19.2, C20.2, C21.2, C22.2, C23.2, C24.2, C36.2, R15.2, R17.2, U6.11 (NC), U6.12 (NC), U6.13 (MODE), U6.20 (AGND), U6.21 (PGND), U7.5 (GND), U7.9 (EP); also elsewhere on the board
LOAD_CT: C23.1, U7.6 (CT)
PWR_EN: U6.2 (EN), U7.3 (ON); also elsewhere on the board
RAIL_5V: C24.1, TP7.1 (1_1), U7.7 (VOUT), U7.8 (VOUT); also elsewhere on the board
VSYS: C13.1, C14.1, L2.1, U6.9 (VIN); also elsewhere on the board

Notes on the sheet:
5 V boost (TPS61088) and load switch (TPS22975)
