mp911de/airgrep/hardware/carrier-max-charger/carrier.kicad_pcb

## KiCad design hardware/carrier-max-charger/carrier.kicad_pcb (continued)

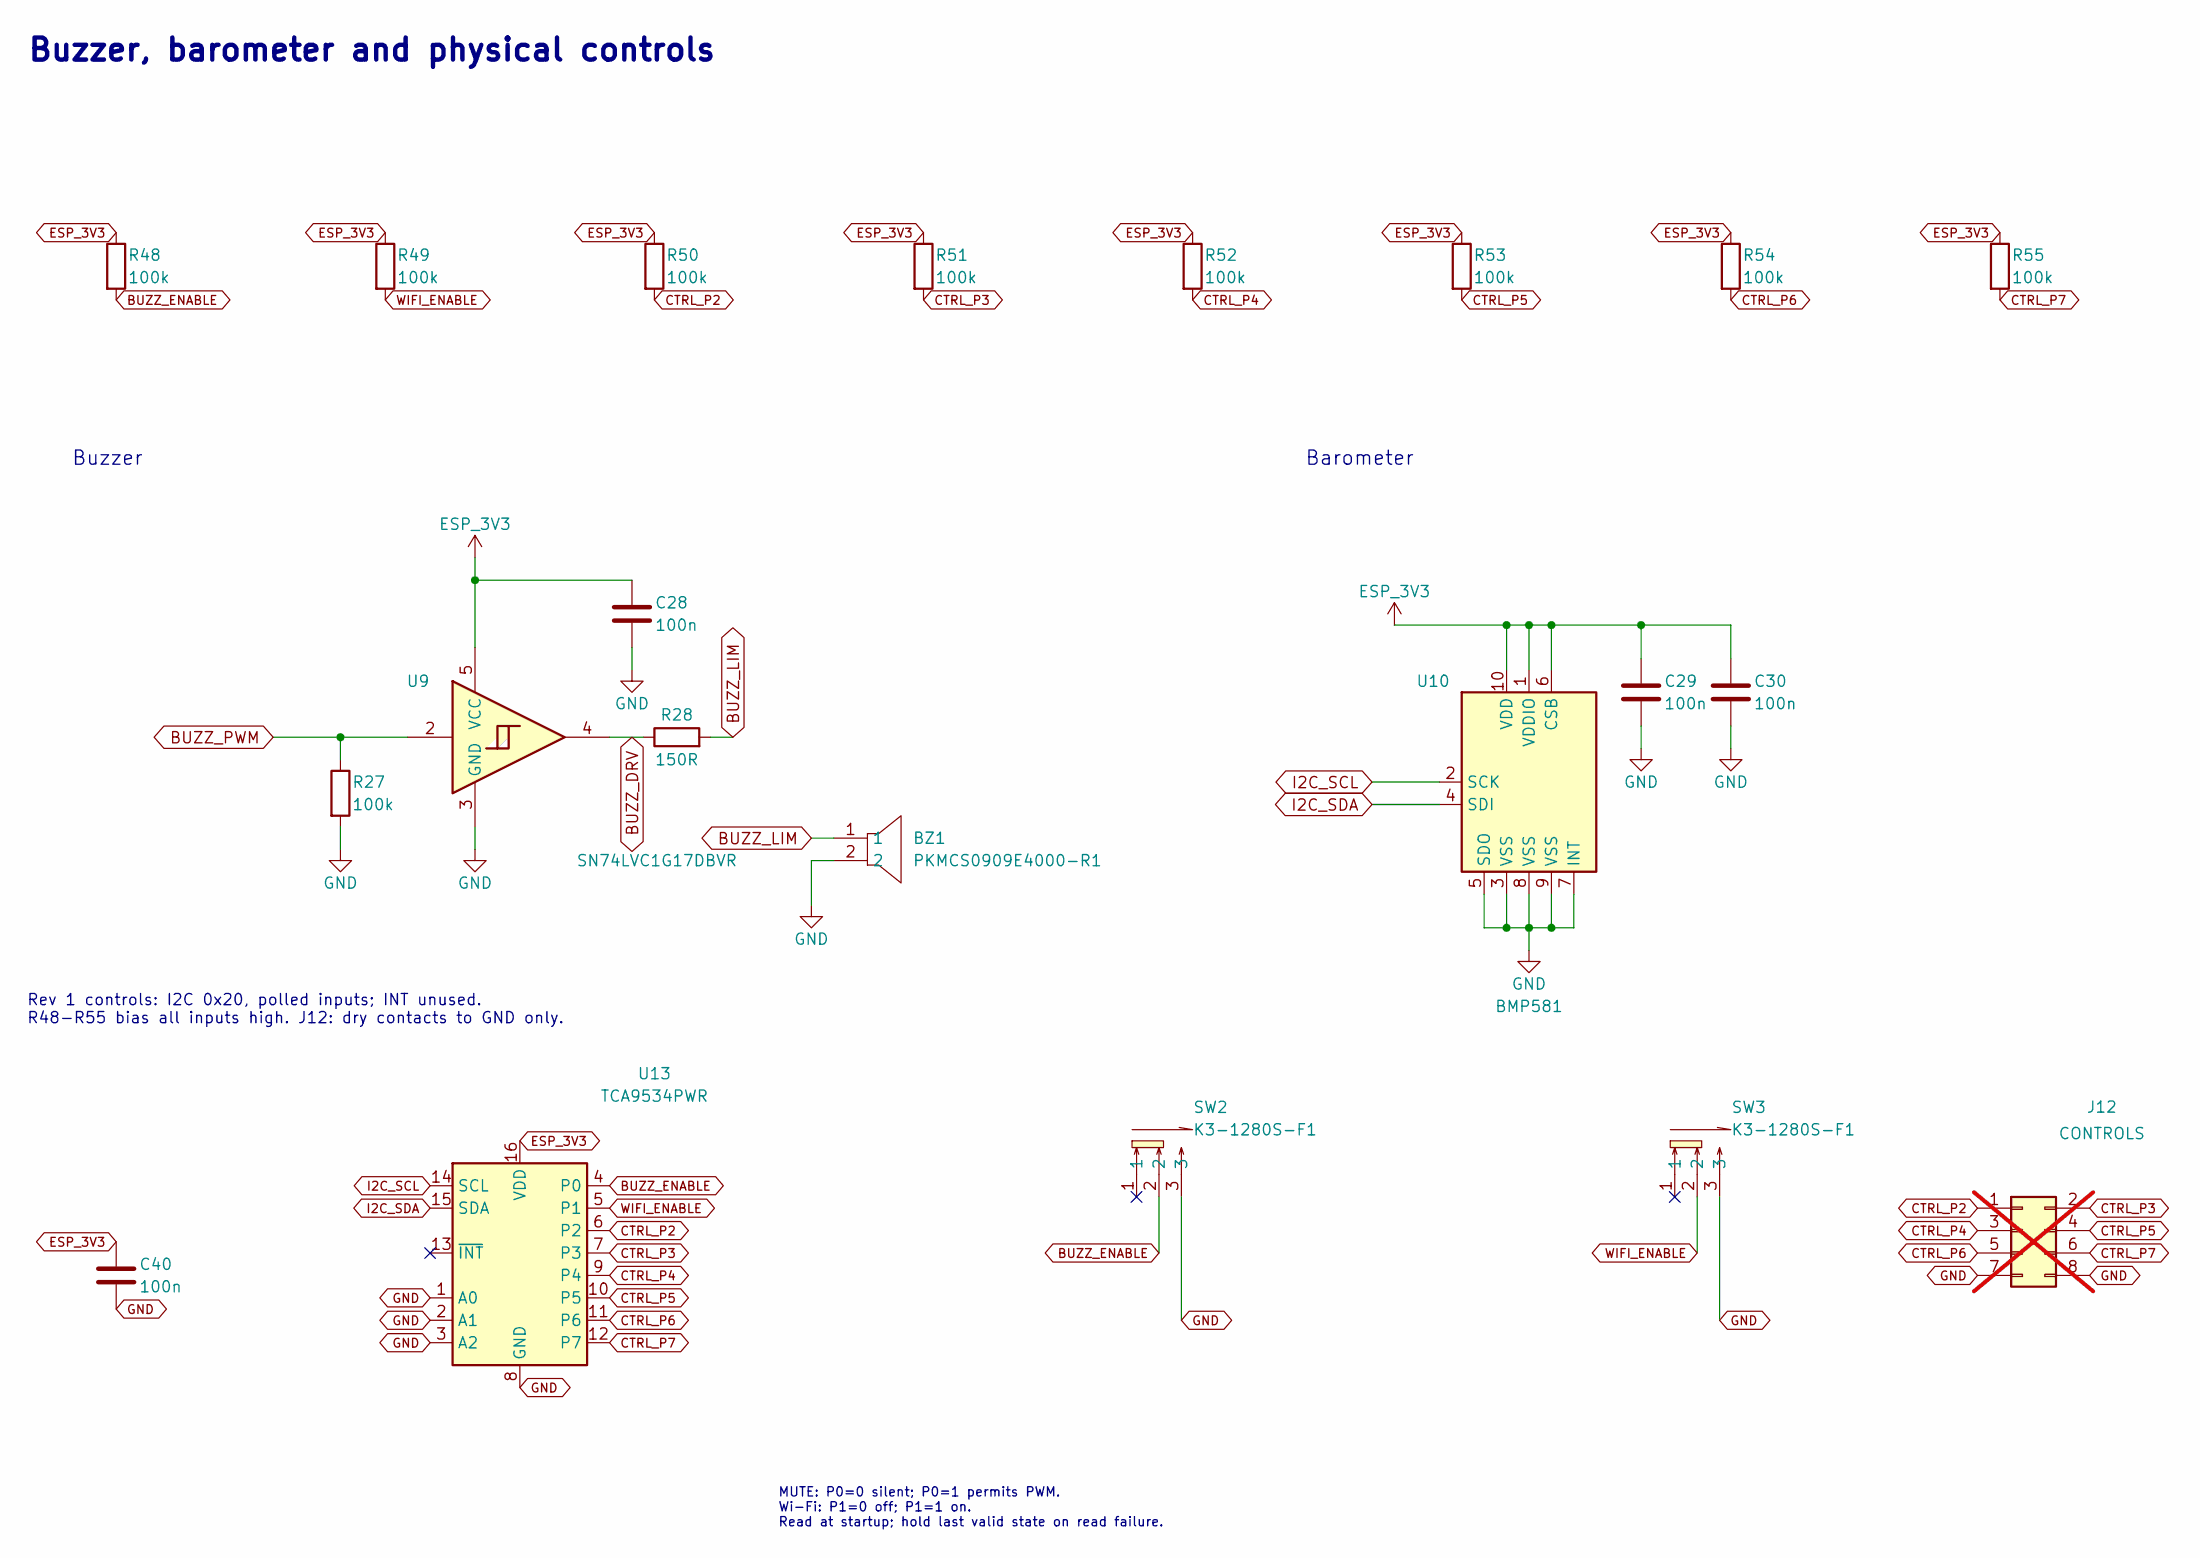
[picture p26: schematic buzzer_baro.kicad_sch, Buzzer and barometer]

Parts:
BZ1: PKMCS0909E4000-R1; BUZ-SMD_L9.0-W9.0_PKMCS0909E4000-R1; LCSC C910763
C28, C29, C30, C40: 100n; C_0603_1608Metric; LCSC C14663
J12: CONTROLS; PinHeader_2x04_P2.54mm_Vertical; not fitted
R27, R48, R49, R50, R51, R52, R53, R54, R55: 100k; R_0603_1608Metric; LCSC C25803
R28: 150R; R_0603_1608Metric; LCSC C22808
SW2, SW3: K3-1280S-F1; SW-SMD_K3-1280S-F1; LCSC C92658
U9: SN74LVC1G17DBVR; SOT-23-5; LCSC C7836
U10: BMP581; LGA-10_L2.0-W2.0-P0.50-TL_BMP581; MPN BMP581; LCSC C5362283
U13: TCA9534PWR; TSSOP-16_4.4x5mm_P0.65mm; LCSC C783615

Connections:
BUZZ_DRV: R28.1, U9.4
BUZZ_ENABLE: R48.2, SW2.2, U13.4 (P0)
BUZZ_LIM: BZ1.1, R28.2
BUZZ_PWM: R27.1, U9.2; also elsewhere on the board
CTRL_P2: J12.1, R50.2, U13.6 (P2)
CTRL_P3: J12.2, R51.2, U13.7 (P3)
CTRL_P4: J12.3, R52.2, U13.9 (P4)
CTRL_P5: J12.4, R53.2, U13.10 (P5)
CTRL_P6: J12.5, R54.2, U13.11 (P6)
CTRL_P7: J12.6, R55.2, U13.12 (P7)
ESP_3V3: C28.1, C29.1, C30.1, C40.1, R48.1, R49.1, R50.1, R51.1, R52.1, R53.1, R54.1, R55.1, U9.5 (VCC), U10.1 (VDDIO), U10.6 (CSB), U10.10 (VDD), U13.16 (VDD); also elsewhere on the board
GND: BZ1.2, C28.2, C29.2, C30.2, C40.2, J12.7, J12.8, R27.2, SW2.3, SW3.3, U9.3 (GND), U10.3 (VSS), U10.5 (SDO), U10.7 (INT), U10.8 (VSS), U10.9 (VSS), U13.1 (A0), U13.2 (A1), U13.3 (A2), U13.8 (GND); also elsewhere on the board
I2C_SCL: U10.2 (SCK), U13.14 (SCL); also elsewhere on the board
I2C_SDA: U10.4 (SDI), U13.15 (SDA); also elsewhere on the board
WIFI_ENABLE: R49.2, SW3.2, U13.5 (P1)

Notes on the sheet:
Barometer
MUTE: P0=0 silent; P0=1 permits PWM. Wi-Fi: P1=0 off; P1=1 on. Read at startup; hold last valid state on read failure.
Buzzer, barometer and physical controls
Buzzer
Rev 1 controls: I2C 0x20, polled inputs; INT unused. R48-R55 bias all inputs high. J12: dry contacts to GND only.

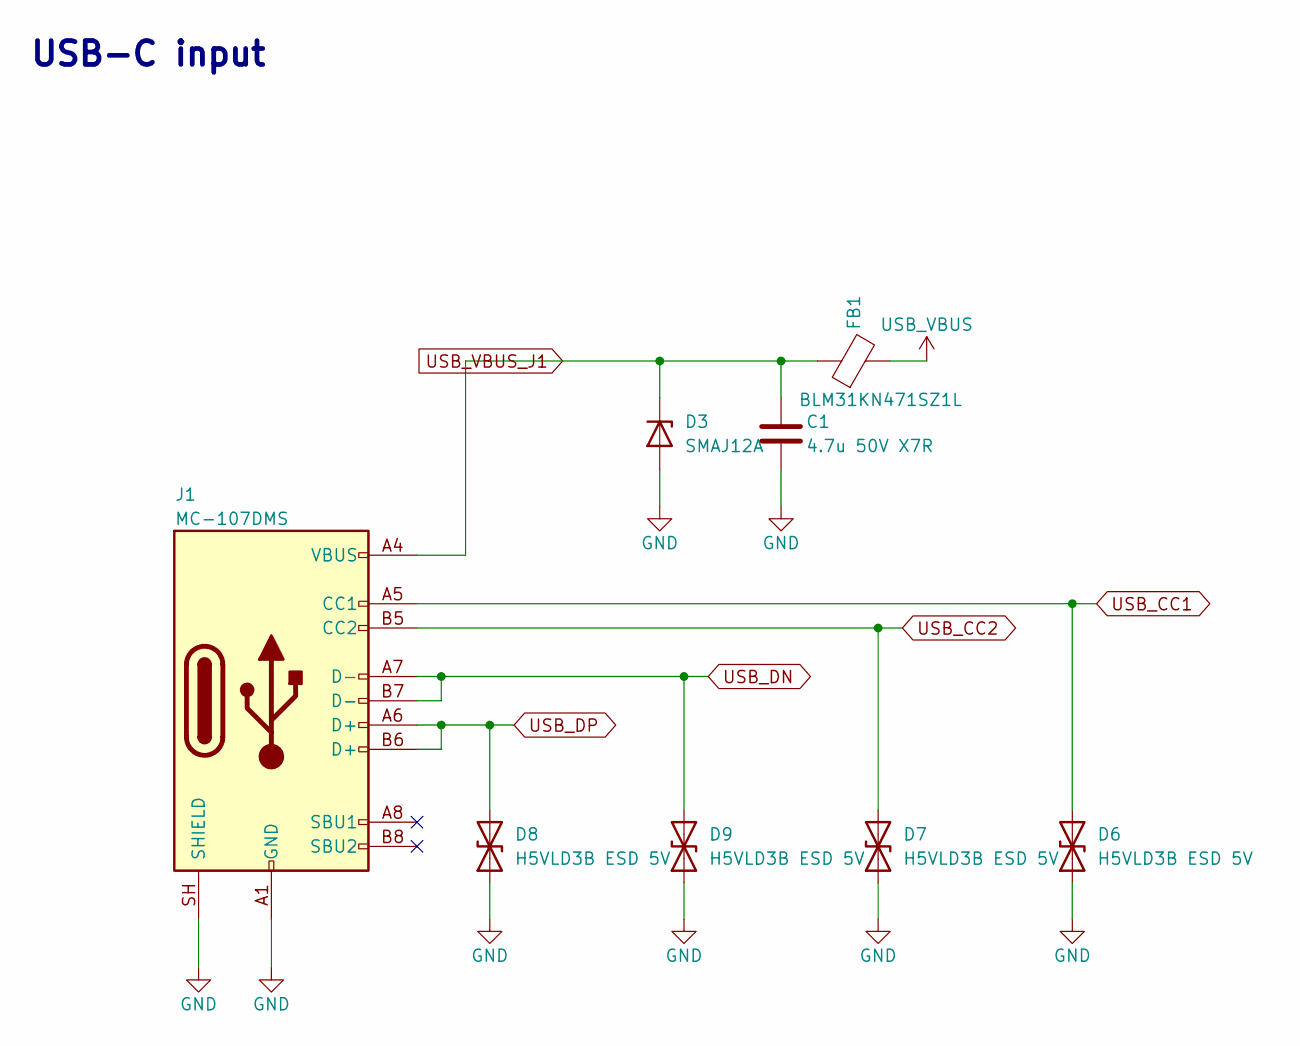
[picture p27: schematic usb_input.kicad_sch, USB input]

Parts:
C1: 4.7u 50V X7R; C_0805_2012Metric; LCSC C437557
D3: SMAJ12A; D_SMA; LCSC C19077531
D6, D7, D8, D9: H5VLD3B ESD 5V; D_SOD-323; MPN H5VLD3B; LCSC C20615805
FB1: BLM31KN471SZ1L; L_1206_3216Metric; LCSC C710518
J1: MC-107DMS; USB_C_Receptacle_Hanbo_MC-107DMS; LCSC C3039295

Connections:
GND: C1.2, D3.2 (A), D6.1 (A1), D7.1 (A1), D8.1 (A1), D9.1 (A1), J1.A1 (GND), J1.A12 (GND), J1.B1 (GND), J1.B12 (GND), J1.SH (SHIELD); also elsewhere on the board
USB_CC1: D6.2 (A2), J1.A5 (CC1); also elsewhere on the board
USB_CC2: D7.2 (A2), J1.B5 (CC2); also elsewhere on the board
USB_DN: D9.2 (A2), J1.A7 (D-), J1.B7 (D-); also elsewhere on the board
USB_DP: D8.2 (A2), J1.A6 (D+), J1.B6 (D+); also elsewhere on the board
USB_VBUS: FB1.2; also elsewhere on the board
USB_VBUS_J1: C1.1, D3.1 (K), FB1.1, J1.A4 (VBUS), J1.A9 (VBUS), J1.B4 (VBUS), J1.B9 (VBUS)

Notes on the sheet:
USB-C input

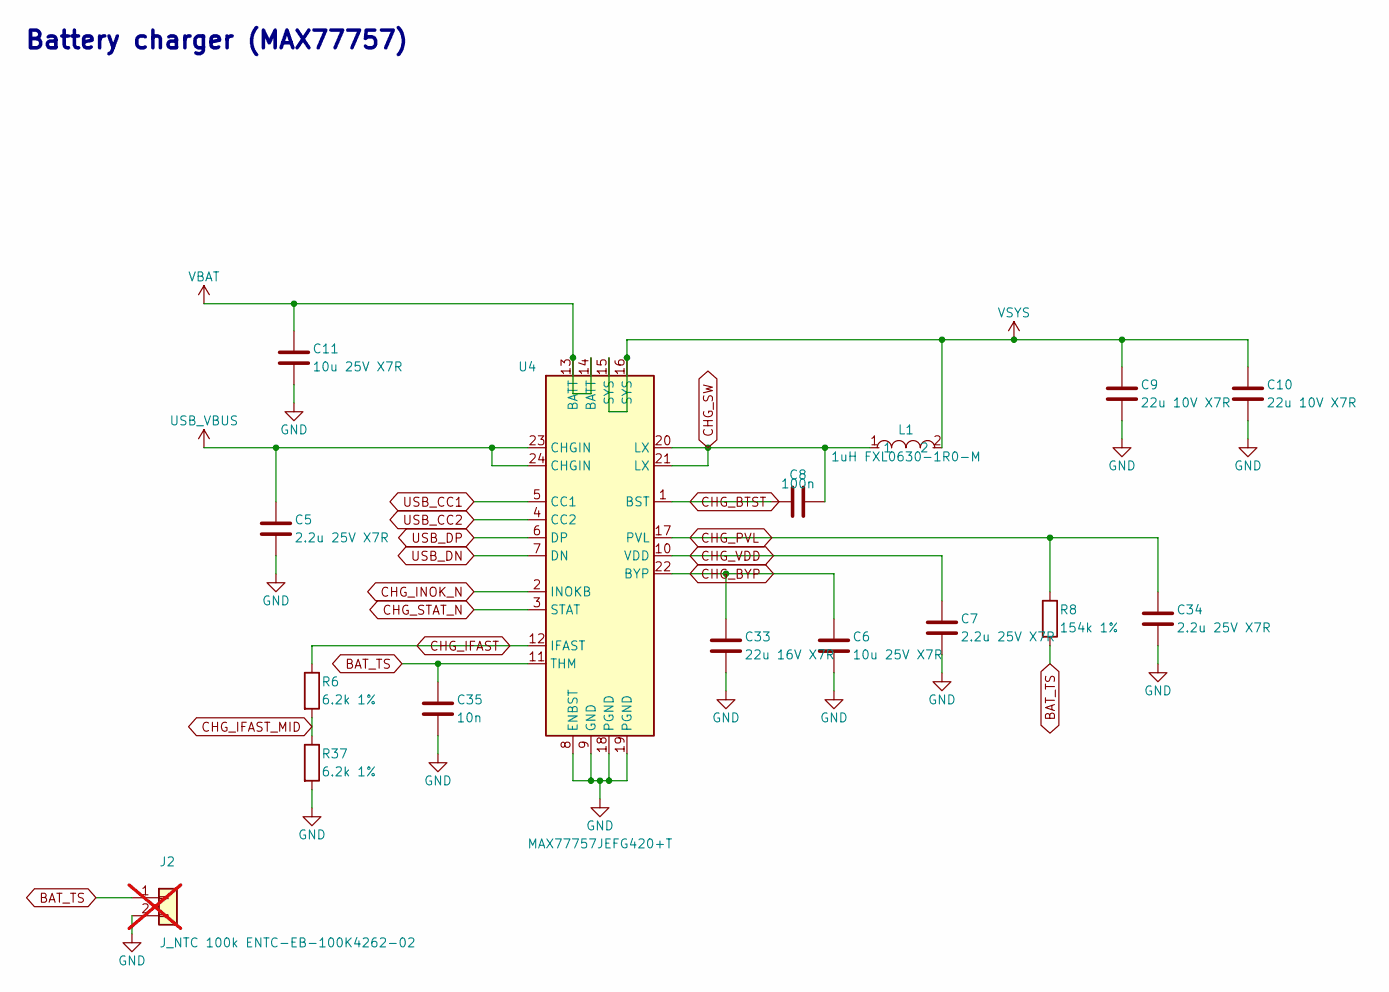
[picture p28: schematic charger.kicad_sch, Charger MAX77757]

Parts:
C5, C7, C34: 2.2u 25V X7R; C_0603_1608Metric; LCSC C415535
C6, C11: 10u 25V X7R; C_0805_2012Metric; LCSC C3039694
C8: 100n; C_0603_1608Metric; LCSC C14663
C9, C10: 22u 10V X7R; C_0805_2012Metric; LCSC C907991
C33: 22u 16V X7R; C_1206_3216Metric; LCSC C385906
C35: 10n; C_0603_1608Metric; LCSC C57112
J2: J_NTC 100k ENTC-EB-100K4262-02; JST_PH_B2B-PH-K_1x02_P2.00mm_Vertical_R10; not fitted
L1: 1uH FXL0630-1R0-M; IND-SMD_L7.0-W6.6_FXL0630; LCSC C167216
R6, R37: 6.2k 1%; R_0603_1608Metric; LCSC C4260
R8: 154k 1%; R_0603_1608Metric; LCSC C22881
U4: MAX77757JEFG420+T; FC2QFN-24_L3.0-W3.0-P0.40_MAX77757; LCSC C7454852

Connections:
BAT_TS: C35.1, J2.1, R8.2, U4.11 (THM); also elsewhere on the board
CHG_BTST: C8.1, U4.1 (BST)
CHG_BYP: C6.1, C33.1, U4.22 (BYP)
CHG_IFAST: R6.1, U4.12 (IFAST)
CHG_IFAST_MID: R6.2, R37.1
CHG_INOK_N: U4.2 (INOKB); also elsewhere on the board
CHG_PVL: C34.1, R8.1, U4.17 (PVL)
CHG_STAT_N: U4.3 (STAT); also elsewhere on the board
CHG_SW: C8.2, L1.1, U4.20 (LX), U4.21 (LX)
CHG_VDD: C7.1, U4.10 (VDD)
GND: C5.2, C6.2, C7.2, C9.2, C10.2, C11.2, C33.2, C34.2, C35.2, J2.2, R37.2, U4.8 (ENBST), U4.9 (GND), U4.18 (PGND), U4.19 (PGND); also elsewhere on the board
USB_CC1: U4.5 (CC1); also elsewhere on the board
USB_CC2: U4.4 (CC2); also elsewhere on the board
USB_DN: U4.7 (DN); also elsewhere on the board
USB_DP: U4.6 (DP); also elsewhere on the board
USB_VBUS: C5.1, U4.23 (CHGIN), U4.24 (CHGIN); also elsewhere on the board
VBAT: C11.1, U4.13 (BATT), U4.14 (BATT); also elsewhere on the board
VSYS: C9.1, C10.1, L1.2, U4.15 (SYS), U4.16 (SYS); also elsewhere on the board

Notes on the sheet:
Battery charger (MAX77757)

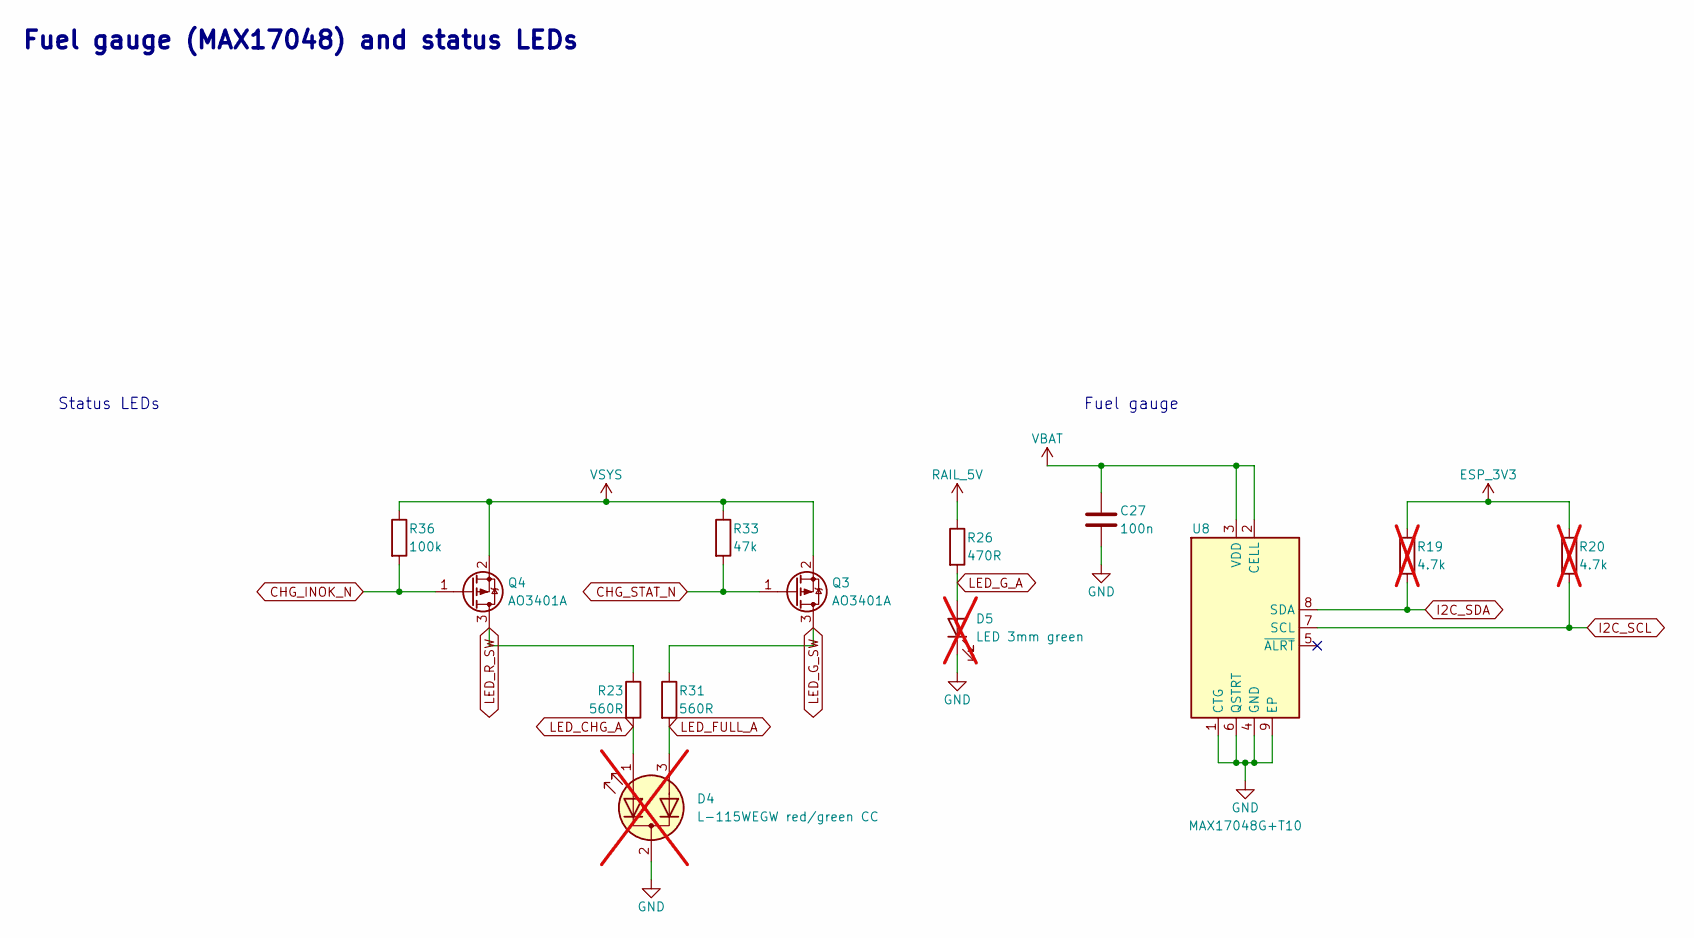
[picture p29: schematic gauge_status.kicad_sch, Gauge and status]

Parts:
C27: 100n; C_0603_1608Metric; LCSC C14663
D4: L-115WEGW red/green CC; LED_D3.0mm-3; not fitted
D5: LED 3mm green; LED_D3.0mm; not fitted
Q3, Q4: AO3401A; SOT-23; LCSC C15127
R19, R20: 4.7k; R_0603_1608Metric; not fitted
R23, R31: 560R; R_0603_1608Metric; LCSC C23204
R26: 470R; R_0603_1608Metric; LCSC C23179
R33: 47k; R_0603_1608Metric; LCSC C25819
R36: 100k; R_0603_1608Metric; LCSC C25803
U8: MAX17048G+T10; TDFN-8_L2.0-W2.0-P0.50-EP0.8x1.38_T822; LCSC C2682616

Connections:
CHG_INOK_N: Q4.1 (G), R36.2; also elsewhere on the board
CHG_STAT_N: Q3.1 (G), R33.2; also elsewhere on the board
ESP_3V3: R19.1, R20.1; also elsewhere on the board
GND: C27.2, D4.2 (K), D5.1 (K), U8.1 (CTG), U8.4 (GND), U8.6 (QSTRT), U8.9 (EP); also elsewhere on the board
I2C_SCL: R20.2, U8.7 (SCL); also elsewhere on the board
I2C_SDA: R19.2, U8.8 (SDA); also elsewhere on the board
LED_CHG_A: D4.1 (A1), R23.2
LED_FULL_A: D4.3 (A2), R31.2
LED_G_A: D5.2 (A), R26.2
LED_G_SW: Q3.3 (D), R31.1
LED_R_SW: Q4.3 (D), R23.1
RAIL_5V: R26.1; also elsewhere on the board
VBAT: C27.1, U8.2 (CELL), U8.3 (VDD); also elsewhere on the board
VSYS: Q3.2 (S), Q4.2 (S), R33.1, R36.1; also elsewhere on the board

Notes on the sheet:
Fuel gauge
Status LEDs
Fuel gauge (MAX17048) and status LEDs

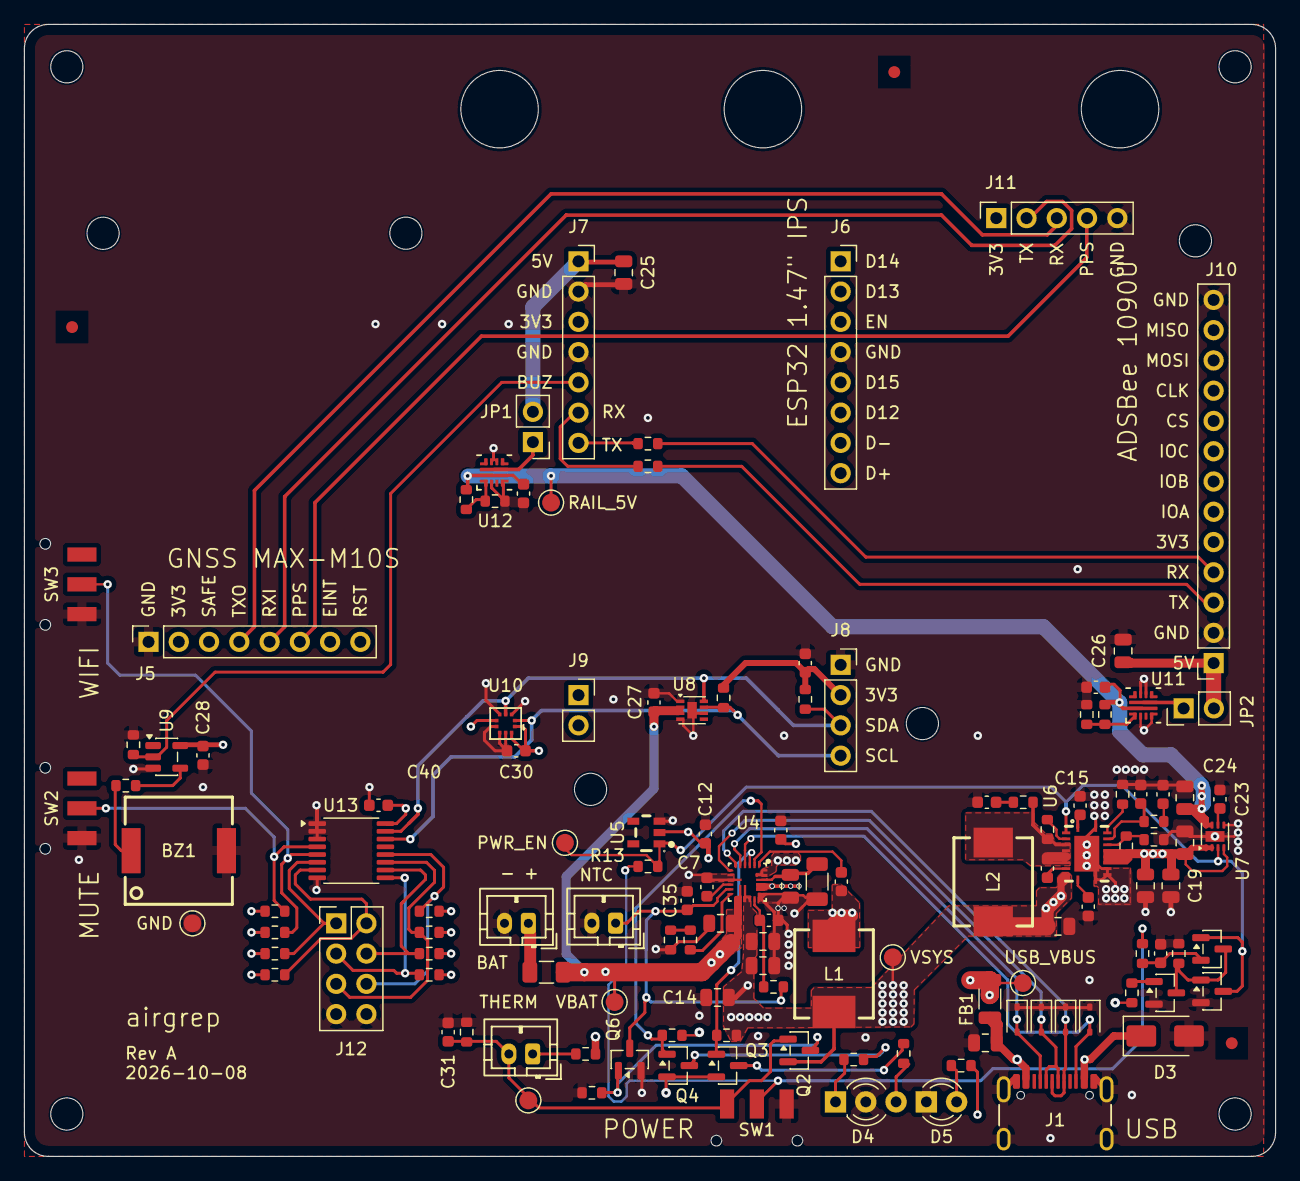
[picture p30: board hardware/carrier-max-charger/carrier.kicad_pcb from above]

Board: 4 copper layers, 105.0 x 95.0 mm, 143 parts (0 on the bottom side), 74 nets.

Other parts of the board:
FID1, FID2, FID3: Fiducial; Fiducial_1mm_Mask2mm
MH1, MH2, MH3, MH4, MH10, MH11, MH12, MH13, MH14: MountingHole_2.7mm_M2.5
MH6, MH7, MH8: MountingHole_6.5mm
