mp911de/airgrep/sources/display/1.47 Inch Touch Display Powered by XIAO ESP32-S3 Plus.kicad_pcb

## KiCad design sources/display/1.47 Inch Touch Display Powered by XIAO ESP32-S3 Plus.kicad_pcb (2026-09-25)

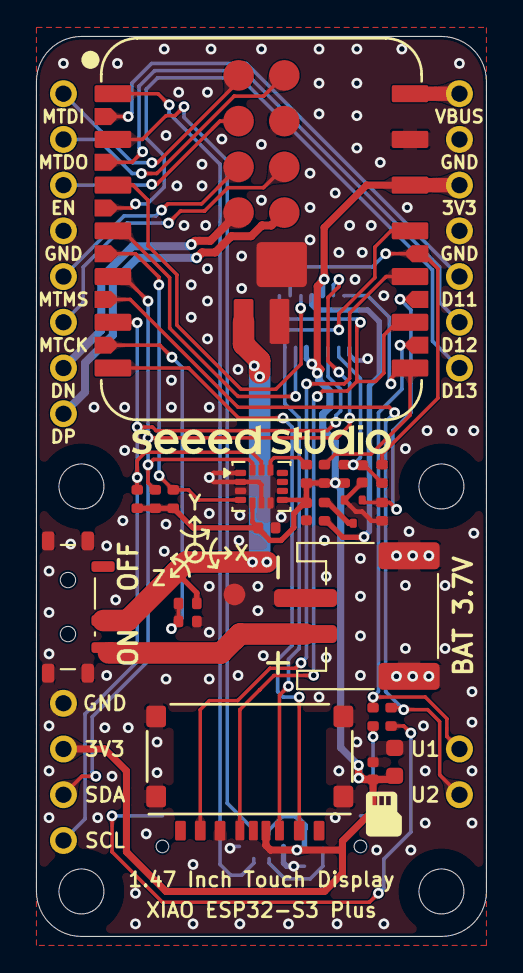
[picture p31: board 1.47 Inch Touch Display Powered by XIAO ESP32-S3 Plus.kicad_pcb from above]

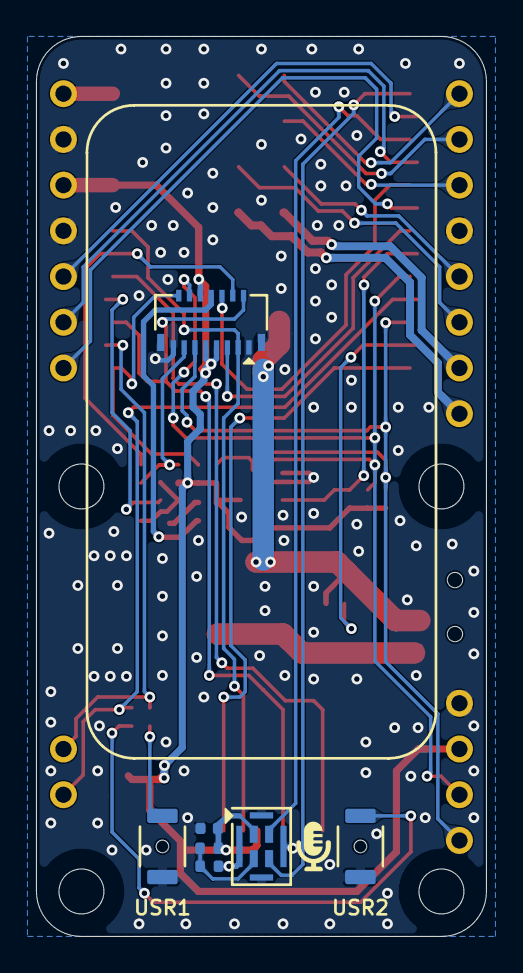
[picture p32: board 1.47 Inch Touch Display Powered by XIAO ESP32-S3 Plus.kicad_pcb from below]

Board: 2 copper layers, 25.0 x 50.0 mm, 58 parts (7 on the bottom side), 39 nets.

Parts:
C1: DNP/100nF; C0402
C2, C4, C5, C6: 100nF; C0402
C3: 10uF; C0603
H1, H2, H3, H4: M2.5; MountingHole_M2.5
J1: BAT CONN; WAFER-PH2.0-2P_SMD_Horizontal
J2: AFE07-S15FMA-HF; AFE07-S15FMA-HF_Pin1Right
J3: TF-123-ARP9HXX; TF-123-ARP9H15
MIC1: ZTS6131
Q1: CJ1012; SOT-523
R1: 10.5R; R0402
R2, R14: 1M; R0402
R3, R4: 5.1K; R0402
R5, R8: 1K; R0402
R6, R12, R13: 10K; R0402
R7: DNP/10K; R0402
R9, R11: 0R; R0402
R10: DNP; R0402
R15: 499K; R0402
SW1: MSK12C02; MSK12C02-HB
SW2, SW3: TS-1080S; TS-1080S-AC015XX
TP1, TP2: TestPoint_Pad_D1.2mm
TP3, TP4, TP5, TP6, TP7, TP8, TP9, TP10, TP11, TP12, TP13, TP14, TP15, TP16, TP17, TP18, TP19, TP20, TP21, TP22, TP23: TestPoint_THTPad_D1.5mm_Drill0.9mm
U1: XIAO-ESP32-S3-Plus-SMD
U2: LSM6DS3; LGA-14_3x2.5mm_P0.5mm

Connections:
3V3: C2.1, C3.1, C4.1, C5.1, C6.1, J2.7 (LCD_VDD), J2.9 (LEDA), J2.10 (TP_VDD), J3.4 (VDD), MIC1.1 (VDD), R3.1, R4.1, R6.1, R7.1, R10.1, R12.1, R13.1, TP14.1 (1_1), TP17.1 (1_1), U1.12 (3V3_OUT), U2.5 (VDDIO), U2.8 (VDD)
/03 Main/BTN_USR1: R5.2, TP22.1 (1_1), U1.21 (D19)
/03 Main/BTN_USR2: R8.2, TP23.1 (1_1), U1.19 (D15)
/03 Main/CTP_IMU_SCL: J2.11 (TP_SCL), R3.2, TP16.1 (1_1), U1.6 (D5), U2.13 (SCL)
/03 Main/CTP_IMU_SDA: J2.12 (TP_SDA), R4.2, TP15.1 (1_1), U1.5 (D4), U2.14 (SDA)
/03 Main/CTP_INT: J2.14 (TP_INT), R6.2, U1.8 (D7)
/03 Main/CTP_RST: C1.1, J2.13 (TP_RST), R7.2, R9.2
/03 Main/D11_I2S_SD: TP19.1 (1_1), U1.15 (D11)
/03 Main/D12_I2S_SCK: TP20.1 (1_1), U1.16 (D12)
/03 Main/D13_I2S_WS: TP21.1 (1_1), U1.17 (D13)
/03 Main/EN: TP5.1 (1_1), U1.26 (EN)
/03 Main/IMU_CS: R13.2, U2.12 (CS)
/03 Main/IMU_INT: R12.2, U1.18 (D14), U2.4 (INT1)
/03 Main/LCD_BL_PWM: Q1.1 (G), R2.1, U1.22 (D18)
/03 Main/LCD_CS: J2.6 (LCD_CS), U1.3 (D2)
/03 Main/LCD_DC: J2.5 (LCD_DC), U1.4 (D3)
/03 Main/LCD_RST: J2.4 (LCD_RST), R9.1, U1.23 (D17)
/03 Main/LCD_SD_MOSI: J2.3 (LCD_MOSI), J3.3 (CMD), U1.11 (D10)
/03 Main/LCD_SD_SCK: J2.2 (LCD_SCK), J3.5 (CLK), U1.9 (D8)
/03 Main/LEDK: J2.8 (LEDK), R1.1
/03 Main/MTCK: TP8.1 (1_1), U1.29 (D12/MTCK)
/03 Main/MTDI: TP3.1 (1_1), U1.24 (D14/MTDI)
/03 Main/MTDO: TP4.1 (1_1), U1.25 (D13/MTDO)
/03 Main/MTMS: TP7.1 (1_1), U1.28 (D15/MTMS)
/03 Main/PDM_CLK: MIC1.3 (CLOCK), U1.1 (D0)
/03 Main/PDM_DATA: MIC1.4 (DATA), U1.2 (D1)
/03 Main/SD_CS: J3.2 (DAT3/CD), U1.7 (D6)
/03 Main/SD_MISO: J3.7 (DAT0), U1.10 (D9)
/03 Main/USB_DN: TP9.1 (1_1), U1.30 (USB_DN)
/03 Main/USB_DP: TP10.1 (1_1), U1.31 (USB_DP)
/03 Main/VBAT_ADC: R14.2, R15.2, U1.20 (D16)
GND: C1.2, C2.2, C3.2, C4.2, C5.2, C6.2, J1.2, J1.MP1, J1.MP2, J2.1 (GND), J2.15 (GND), J2.MP1, J2.MP2, J3.6 (VSS), J3.S1, J3.S2, J3.S3, J3.S4, MIC1.5 (GND), MIC1.6 (GND), MIC1.7 (GND), MIC1.8 (GND), Q1.2 (S), R2.2, R11.2, R15.1, SW1.S1, SW1.S2, SW1.S3, SW1.S4, SW2.1, SW3.1, TP2.1 (1_1), TP6.1 (1_1), TP12.1 (1_1), TP13.1 (1_1), TP18.1 (1_1), U1.13 (GND), U1.27 (GND), U1.33 (GND), U1.34 (PAD), U2.1 (SDO/SA0), U2.2 (SDX), U2.3 (SCX), U2.6 (GND), U2.7 (GND)
unnamed: MIC1.2 (SEL), R10.2, R11.1
unnamed: Q1.3 (D), R1.2
unnamed: R5.1, SW2.2
unnamed: R8.1, SW3.2
VBAT: R14.1, SW1.2 (B), U1.32 (VBAT)
VBAT_EXT: J1.1, SW1.3 (C), TP1.1 (1_1)
VBUS: TP11.1 (1_1), U1.14 (VBUS)
