mp911de/airgrep/firmware/components/airgrep/adsbee/adsbee_link.cpp

#include "adsbee_link.hpp"
#include <cstdlib>
#include <cstring>
#include <new>
#include <atomic>

#include "adsbee_protocol.hpp"
#include "wifi/wifi_ap.hpp"
#include "board.h"
#include "driver/gpio.h"
#include "driver/uart.h"
#include "esp_log.h"
#include "esp_timer.h"
#include "i2c_expander/tca9534.hpp"
#include "freertos/semphr.h"
#include "freertos/task.h"

namespace adsbee {
	portMUX_TYPE State::mutex_ = portMUX_INITIALIZER_UNLOCKED;

	State& State::storage() {
		static State state;
		return state;
	}

	State State::copy() {
		State result;
		update([&](State& state) { result = state; });
		return result;
	}

	namespace {
		constexpr const char* tag = "adsbee";
		constexpr uart_port_t uart = UART_NUM_1;
		constexpr uart_config_t uart_config = {
			.baud_rate = ADSBEE_UART_BAUD, .data_bits = UART_DATA_8_BITS,
			.parity = UART_PARITY_EVEN,
			.stop_bits = UART_STOP_BITS_1, .flow_ctrl = UART_HW_FLOWCTRL_DISABLE,
			.rx_flow_ctrl_thresh = 0, .rx_glitch_filt_thresh = 0,
			.source_clk = UART_SCLK_DEFAULT, .flags = {},
		};
		constexpr gpio_num_t tx = static_cast<gpio_num_t>(BOARD_PIN_UART_TX);

		struct Subscriber {
			Predicate predicate;
			Handler handler;
			void* context;
		} subscribers[4];

		size_t subscriber_count;

		struct GnssSubscriber {
			GnssHandler handler;
			void* context;
		} gnss_subscribers[4];

		size_t gnss_subscriber_count;
		decoder_t decoder;
		QueueHandle_t events;
		bool started, tx_attached;
		loop::Handle init_step;
		unsigned init_sent;
		Link liveness;
		loop::Handle periodic;
		void update_tx();

		constexpr size_t kCommandCapacity = 256;

		struct Request {
			uint32_t window_ms = 0;
			loop::SuccessListener success;
			loop::ErrorListener failure;
			loop::Handle handle, finish;
			uint32_t uart_errors = 0;
			char command[];
		};

		// Request state belongs to the loop task. Only uart_errors is shared with the link task.
		Request* pending;
		Reply reply;
		std::atomic<uint32_t> uart_errors;

		char device_info_text[2048];
		StaticSemaphore_t device_info_storage;
		SemaphoreHandle_t device_info_lock = xSemaphoreCreateMutexStatic(
			&device_info_storage);

		void record_error(esp_err_t error) {
			int64_t now = esp_timer_get_time();
			State::update([&](State& state) {
				state.last_error = error;
				state.error_us = now;
			});
		}

		esp_err_t detach() {
			const gpio_config_t config = {
				.pin_bit_mask = 1ULL << tx, .mode = GPIO_MODE_INPUT,
				.pull_up_en = GPIO_PULLUP_DISABLE, .pull_down_en = GPIO_PULLDOWN_DISABLE,
				.intr_type = GPIO_INTR_DISABLE,
			};
			esp_err_t result = gpio_config(&config);
			tx_attached = false;
			loop::cancel(init_step);
			init_step = {};
			State::update([](State& state) {
				state.tx_attached = state.initialized = false;
			});
			if (pending) {
				record_error(ESP_ERR_INVALID_STATE);
				loop::fail(pending->handle, loop::Outcome::error);
			}
			if (result != ESP_OK) record_error(result);
			return result;
		}

		void release(Request* request) {
			request->~Request();
			::operator delete(request);
		}

		void after_request_cleanup(Request* request, bool replied) {
			if (pending == request) pending = nullptr;
			loop::cancel(request->finish);
			if (replied && std::strcmp(request->command, ADSBEE_DEVICE_INFO_COMMAND) ==
				0) {
				xSemaphoreTake(device_info_lock, portMAX_DELAY);
				std::memcpy(device_info_text, reply.text, reply.length + 1);
				xSemaphoreGive(device_info_lock);
			}
			release(request);
		}

		void finish_request(loop::Handle handle) {
			Request* request = pending;
			if (!request || request->handle.slot != handle.slot ||
				request->handle.generation != handle.generation)
				return;
			esp_err_t error = ESP_OK;
			if (request->uart_errors != uart_errors.load())
				error =
					ESP_ERR_INVALID_RESPONSE;
			else if (!reply.length) error = ESP_ERR_TIMEOUT;
			if (error != ESP_OK) {
				record_error(error);
				loop::fail(handle, error == ESP_ERR_TIMEOUT
										? loop::Outcome::timeout
										: loop::Outcome::error);
				return;
			}
			loop::complete(handle, loop::Value{.p = &reply});
		}

		void receive(const Message& message) {
			if (message.kind == DECODER_CSBEE) {
				liveness.poll(esp_timer_get_time());
				liveness.received(message.received_us);
				update_tx();
				Gnss gnss;
				if (decode_gnss(message.text, message.len, gnss)) {
					State::update([&](State& state) {
						state.gnss = gnss;
						state.gnss_us = message.received_us;
					});
					for (size_t i = 0; i < gnss_subscriber_count; i++)
						gnss_subscribers[i].handler(gnss, message.received_us,
													gnss_subscribers[i].context);
				}
			}
			if (message.kind == DECODER_AT_REPLY)
				ESP_LOGD(tag, "reply %s", message.text);
			if (message.kind == DECODER_AT_REPLY && pending &&
				!reply.append(message.text, message.len)) {
				record_error(ESP_ERR_INVALID_SIZE);
				loop::fail(pending->handle, loop::Outcome::error);
			}
			for (size_t i = 0; i < subscriber_count; i++)
				if (subscribers[i].predicate(message))
					subscribers[i].handler(
						message, subscribers[i].context);
		}

		void on_message(const char* text, size_t length, decoder_kind_t kind, void*) {
			bool valid = kind != DECODER_CSBEE || valid_csbee(text, length);
			int64_t now = esp_timer_get_time();
			State::update([&](State& state) {
				if (kind == DECODER_CSBEE) {
					++state.telemetry_lines;
					if (!valid) ++state.crc_failures;
					else state.updated_us = now;
				}
				if (kind == DECODER_AT_REPLY) state.reply_us = now;
			});
			if (!valid) return;
			auto message = static_cast<Message*>(std::malloc(
				sizeof(Message) + length + 1));
			if (!message) {
				record_error(ESP_ERR_NO_MEM);
				return;
			}
			message->kind = kind;
			message->len = length;
			message->received_us = now;
			std::memcpy(message->text, text, length + 1);
			auto submit = loop::hsubmit({
											"adsbee rx",
											[message](loop::Handle, loop::Value&) {
												receive(*message);
												std::free(message);
												return loop::Result::done;
											},
											1000
										}, {}, [message](loop::Outcome) {
											std::free(message);
										});
			if (!submit) {
				std::free(message);
				record_error(ESP_ERR_NO_MEM);
			}
		}

		void link_task(void*) {
			char bytes[128];
			uart_event_t event;
			for (;;) {
				if (xQueueReceive(events, &event, portMAX_DELAY) != pdTRUE) continue;
				if (event.type == UART_DATA) {
					for (size_t left = event.size; left;) {
						int count = uart_read_bytes(uart, bytes,
													left < sizeof bytes
														? left
														: sizeof bytes, 0);
						if (count <= 0) break;
						adsbee_decoder_feed(&decoder, bytes, count);
						left -= count;
					}
				}
				else if (event.type == UART_PARITY_ERR || event.type == UART_FRAME_ERR ||
					event.type == UART_FIFO_OVF || event.type == UART_BUFFER_FULL) {
					++uart_errors;
					State::update([&](State& state) {
						if (event.type == UART_PARITY_ERR) ++state.parity_errors;
						else if (event.type == UART_FRAME_ERR) ++state.framing_errors;
						else ++state.overruns;
					});
					record_error(ESP_FAIL);
					uart_flush_input(uart);
					xQueueReset(events);
					adsbee_decoder_error(&decoder);
				}
			}
		}

		esp_err_t write_line(const char* text) {
			if (uart_write_bytes(uart, text, std::strlen(text)) < 0 || uart_write_bytes(
				uart, "\n", 1) < 0)
				return ESP_FAIL;
			return ESP_OK;
		}

		loop::Handle submit_request(const char* command, uint32_t window_ms,
									loop::SuccessListener success,
									loop::ErrorListener failure);

		// Device initialization after TX attach: ADSBEE_INIT_REPEATS copies of the init command,
		// ADSBEE_INIT_REPEAT_MS apart, then one AT+DEVICE_INFO? whose reply fills the device info.
		// Requests wait until the init writes are through.
		loop::Result init(loop::Handle, loop::Value&) {
			init_step = {};
			if (!tx_attached) return loop::Result::done;
			esp_err_t result = write_line(ADSBEE_INIT_COMMAND);
			if (result != ESP_OK) {
				record_error(result);
				return loop::Result::done;
			}
			if (++init_sent < ADSBEE_INIT_REPEATS) {
				init_step = loop::schedule(ADSBEE_INIT_REPEAT_MS, {"adsbee init", init});
				if (!init_step.valid()) record_error(ESP_ERR_NO_MEM);
				return loop::Result::done;
			}
			State::update([](State& state) { state.initialized = true; });
			submit_request(ADSBEE_DEVICE_INFO_COMMAND, ADSBEE_REPLY_WINDOW_MS, {}, {});
			wifi::attached();
			return loop::Result::done;
		}

		void update_tx() {
			int64_t now = esp_timer_get_time();
			liveness.poll(now);
			bool alive = liveness.permits_tx(now);
			State::update([&](State& state) { state.known = alive; });
			if (!started || !alive) {
				if (tx_attached) {
					detach();
				}
				return;
			}
			if (tx_attached) {
				return;
			}
			// Never reattach while a cancelled command is still shifting out.
			esp_err_t result = uart_wait_tx_done(uart, 0);
			if (result == ESP_OK)
				result = uart_set_pin(uart, tx, UART_PIN_NO_CHANGE,
									UART_PIN_NO_CHANGE, UART_PIN_NO_CHANGE);
			if (result != ESP_OK) {
				record_error(result);
				detach();
				return;
			}
			tx_attached = true;
			State::update([](State& state) { state.tx_attached = true; });
			init_sent = 0;
			if (!loop::hsubmit("adsbee init", init)) record_error(ESP_ERR_NO_MEM);
		}

		// Runs on the loop: claims the single request slot, opens the response
		// window and writes the command. Returns pending until the window closes.
		loop::Result send(Request* request, loop::Handle handle) {
			update_tx();
			if (!started || !tx_attached || !State::copy().initialized) {
				record_error(ESP_ERR_INVALID_STATE);
				return loop::Result::error;
			}
			if (pending) {
				record_error(ESP_ERR_INVALID_STATE);
				return loop::Result::error;
			}
			request->handle = handle;
			request->uart_errors = uart_errors.load();
			request->finish = loop::schedule(request->window_ms, {
												"adsbee response window",
												[handle](loop::Handle, loop::Value&) {
													finish_request(handle);
													return loop::Result::done;
												}
											});
			if (!request->finish.valid()) {
				record_error(ESP_ERR_NO_MEM);
				return loop::Result::error;
			}
			pending = request;
			reply.length = 0;
			reply.text[0] = 0;
			esp_err_t written = write_line(request->command);
			if (written != ESP_OK) {
				record_error(written);
				return loop::Result::error;
			}
			return loop::Result::pending;
		}

		loop::Handle submit_request(const char* command, uint32_t window_ms,
									loop::SuccessListener success,
									loop::ErrorListener failure) {
			if (!acceptable_command(command, kCommandCapacity) || !window_ms) {
				record_error(ESP_ERR_INVALID_ARG);
				return {};
			}
			void* storage = ::operator new(sizeof(Request) + std::strlen(command) + 1,
											std::nothrow);
			if (!storage) return {};
			auto* request = new(storage) Request;
			std::strcpy(request->command, command);
			request->window_ms = window_ms;
			request->success = success;
			request->failure = failure;
			loop::Handle handle = loop::submit(
				{
					"adsbee at", [request](loop::Handle action, loop::Value&) {
						return send(request, action);
					}
				},
				[request](loop::Value value) {
					loop::SuccessListener on_reply = request->success;
					after_request_cleanup(request, true);
					if (on_reply) on_reply(value);
				},
				[request](loop::Outcome outcome) {
					loop::ErrorListener on_error = request->failure;
					after_request_cleanup(request, false);
					if (outcome == loop::Outcome::timeout) record_error(ESP_ERR_TIMEOUT);
					if (on_error) on_error(outcome);
				});
			if (!handle.valid()) release(request);
			return handle;
		}

		void power_sample(const expander::State& state, uint8_t, void*) {
			liveness.update_power({state.input.power, state.updated_us, state.error_us},
								esp_timer_get_time());
			update_tx();
		}
	}

	bool subscribe(Predicate predicate, Handler handler, void* context) {
		if (!predicate || !handler || subscriber_count == 4) {
			return false;
		}
		subscribers[subscriber_count++] = {predicate, handler, context};
		return true;
	}

	bool subscribe_gnss(GnssHandler handler, void* context) {
		if (!handler || gnss_subscriber_count == 4) {
			return false;
		}
		gnss_subscribers[gnss_subscriber_count++] = {handler, context};
		return true;
	}

	loop::Handle poll_handle() { return periodic; }

	esp_err_t uart_init() {
		esp_err_t result = uart_driver_install(uart, ADSBEE_UART_RX_BUFFER,
												ADSBEE_UART_TX_BUFFER,
												ADSBEE_UART_QUEUE, &events, 0);
		if (result == ESP_OK) {
			result = uart_param_config(uart, &uart_config);
		}
		if (result == ESP_OK)
			result = uart_set_pin(uart, UART_PIN_NO_CHANGE, BOARD_PIN_UART_RX,
								UART_PIN_NO_CHANGE, UART_PIN_NO_CHANGE);
		if (result != ESP_OK) {
			uart_driver_delete(uart);
			events = nullptr;
		}
		return result;
	}

	esp_err_t start() {
		if (!events) {
			return ESP_ERR_INVALID_STATE;
		}
		if (!expander::subscribe(power_sample)) {
			return ESP_ERR_NO_MEM;
		}
		esp_err_t result = detach();
		if (result != ESP_OK) {
			return result;
		}
		adsbee_decoder_init(&decoder, on_message, nullptr);
		periodic = loop::schedule_periodic(ADSBEE_POLL_MS, {
												"adsbee liveness",
												[](loop::Handle, loop::Value&) {
													update_tx();
													return loop::Result::done;
												}
											});
		if (!periodic.valid()) {
			result = ESP_ERR_NO_MEM;
		}
		if (result == ESP_OK && xTaskCreate(link_task, "adsbee", 4096, nullptr, 10,
											nullptr) != pdPASS) {
			result = ESP_ERR_NO_MEM;
		}
		if (result != ESP_OK) {
			loop::cancel(periodic);
			periodic = {};
			record_error(result);
			return result;
		}
		started = true;
		return ESP_OK;
	}

	loop::Handle request(const char* command, loop::SuccessListener success,
						loop::ErrorListener failure, uint32_t timeout_ms) {
		return submit_request(command, timeout_ms, success, failure);
	}

	bool busy() { return pending != nullptr; }

	size_t device_info(char* out, size_t capacity) {
		xSemaphoreTake(device_info_lock, portMAX_DELAY);
		size_t length = std::strlen(device_info_text);
		if (length >= capacity) {
			length = capacity - 1;
		}
		std::memcpy(out, device_info_text, length);
		out[length] = 0;
		xSemaphoreGive(device_info_lock);
		return length;
	}
}
