mp911de/airgrep/firmware/components/airgrep/i2c_expander/tca9534_i2c.hpp

#pragma once

#include <cstdint>

namespace expander {
	struct Input {
		bool high[8];
		bool mute, wifi, power;
	};

	Input decode_input(uint8_t raw);

	struct Output {
		bool high[8];
	};

	Output decode_output(uint8_t raw);

	struct Polarity {
		bool inverted[8];
	};

	Polarity decode_polarity(uint8_t raw);

	struct Configuration {
		bool input[8];
	};

	Configuration decode_configuration(uint8_t raw);
}
