mp911de/airgrep/firmware/main/commands/argtable.hpp

#pragma once

// argtable3.h declares functions named like their structs, which -Wshadow reports in C++.
#pragma GCC diagnostic push
#pragma GCC diagnostic ignored "-Wshadow"
#include "argtable3/argtable3.h"
#pragma GCC diagnostic pop
