mp911de/airgrep/(commit log)

2026-10-11 Revise charger
2026-10-11 Add TI charger variant.
2026-10-11 TI charger
2026-10-13 Align I2C resistors for 100kHZ ops.
2026-10-13 Switch parts (BMP580, TPS259474L) due to stock shortage.
    Also, add overvoltage (OVLO) protection.
2026-10-14 Add reset FET switch.
2026-10-14 Update resistors for stock availability.
2026-10-14 Add USB current detection.
2026-10-15 Switch to faster FUSB303B USB controller.
2026-10-15 Refine resistors.
2026-10-16 Switch to Max M10 on-board chip instead of module.
2026-10-17 Consolidate bom.
2026-10-19 Consolidate BOM, add GNSS listen to ESP.
2026-11-08 Refine fusb303 and UART initialization.
    Also, override linenoise probe to avoid the 500ms probe for now.
2026-11-08 Track traffic targets.
    Also, expose a traffic command. Traffic is being held in PSRam.
